IArchi/Maslow_4/CAD/Anchors/AnchorDesignsReadme.md

Add notes for the anchor cad files loaded in this file.
