IArchi/Maslow_4/docs/index.md

---
layout: default
title: Home
---

# Maslow 4 Documentation

Welcome to the official documentation for Maslow 4 CNC machine. This site contains assembly instructions, user guides, reference materials, and interactive tools.

## Quick Start

- [Quick Start Guide](QuickStart.md) - Get your Maslow up and running quickly after assembly

## Assembly Guides

Step-by-step instructions for building your Maslow 4:

- [Assembly Background](assembly-background-4-1/) - Overview of the assembly process
- [Assembling the Arms](assembling-the-arms-4-1/) - Build the arm assemblies
- [Assembling the Router](assembling-the-router-4-1/) - Set up the router mount
- [Assembling the Sled](assembling-the-sled-4-1/) - Build the sled platform
- [Putting It All Together](putting-it-all-together-4-1/) - Final assembly steps

## User Guide

- [User Guide](user-guide/) - Complete guide to using your Maslow 4

## Reference Materials

- [Maslow CNC Wisdom Manual](MaslowCNC_Wisdom_Manual.md) - Comprehensive manual with tips and best practices
- [Bit Library](BitLibrary.md) - Information about router bits and tooling
- [Frame Library](FrameLibrary.md) - Frame designs and specifications
- [Materials Library](MaterialsLibrary.md) - Material cutting recommendations
- [Router and Spindle Library](RouterAndSpindleLibrary.md) - Router and spindle options
- [Software Guide](software-guide/) - CAM and CAD software options for use with Maslow
- [Software Library](SoftwareLibrary.md) - Software tools and resources

## Interactive Tools

- [Calibration Simulator](calibration-simulation/) - Interactive calibration simulation tool
  - [Quick Start Guide](calibration-simulation/QUICKSTART.md)
  - [Full Documentation](calibration-simulation/README.md)
- [Calibration Data Parser](calibration-simulation/data-parser.html) - Analyze real calibration data with the machine's exact solver, and visualize which measurements are causing errors
  - [Data Parser Documentation](calibration-simulation/DATA-PARSER.md)
- [Manual Anchor Locator](manual-anchor-locator/) - Compute anchor coordinates and estimate measurement error from four side lengths and two diagonals
- [Layout Simulator](layout-simulator/) - Try an anchor spacing and see how much of the area inside it Maslow can cut well
  - [Layout Simulator Documentation](layout-simulator/README.md)

## Contributing

- [How To Edit This Wiki](HowToEditThisWiki.md) - Guide for contributing to the documentation

## External Resources

- [Maslow CNC Website](https://www.maslowcnc.com/) - Official website
- [GitHub Repository](https://github.com/MaslowCNC/Maslow_4) - Source code and issues
- [Community Forums](https://forums.maslowcnc.com/) - Get help and share projects
- [FluidNC Wiki](http://wiki.fluidnc.com/) - Firmware documentation

---

*This documentation is open source and contributions are welcome. See [How To Edit This Wiki](HowToEditThisWiki.md) for details.*
