IArchi/Maslow_4/docs/IMPLEMENTATION_SUMMARY.md

# GitHub Pages Implementation Summary

## What Was Implemented

This implementation creates a complete GitHub Pages website from the `docs/` folder that includes:

### 1. Automated Deployment Pipeline
- **GitHub Actions Workflow** (`.github/workflows/deploy-docs.yml`)
  - Automatically deploys on push to `Maslow-Main` branch
  - Can be manually triggered from Actions tab
  - Uses official GitHub Pages actions for reliability
  - Builds with Jekyll for beautiful rendering

### 2. Documentation Website
- **Landing Page** (`docs/index.md`)
  - Clean, organized navigation
  - Sections for assembly guides, user guide, reference materials
  - Links to interactive tools
  - External resource links

### 3. All Markdown Files Rendered
Every markdown file in the docs folder will be rendered as a web page:
- BitLibrary.md
- FrameLibrary.md
- MaterialsLibrary.md
- RouterAndSpindleLibrary.md
- SoftwareLibrary.md
- MaslowCNC_Wisdom_Manual.md
- HowToEditThisWiki.md
- All README.md files in subdirectories

### 4. Interactive Calibration Simulator
The existing calibration-simulation with its HTML/JS files will work perfectly:
- `docs/calibration-simulation/index.html` - Main simulator interface
- All JavaScript files (machine-simulator.js, computation-simulator.js, etc.)
- Enhanced documentation with prominent links to run the simulator

### 5. Images and Assets
All images remain in their original locations and will be accessible:
- Assembly guide images (assembling-the-arms-4-1/images/, etc.)
- User guide screenshots (user-guide/images/)
- All other image assets

## Site Structure

When deployed, the site will have this structure:

```
https://maslowcnc.github.io/Maslow_4/
├── (Landing page with organized navigation)
│
├── Assembly Guides
│   ├── assembly-background-4-1/
│   ├── assembling-the-arms-4-1/
│   ├── assembling-the-router-4-1/
│   ├── assembling-the-sled-4-1/
│   └── putting-it-all-together-4-1/
│
├── User Guide
│   └── user-guide/
│
├── Reference Materials
│   ├── BitLibrary.md
│   ├── FrameLibrary.md
│   ├── MaterialsLibrary.md
│   ├── RouterAndSpindleLibrary.md
│   ├── SoftwareLibrary.md
│   └── MaslowCNC_Wisdom_Manual.md
│
├── Interactive Tools
│   └── calibration-simulation/
│       ├── index.html (Interactive Simulator)
│       ├── README.md
│       └── QUICKSTART.md
│
└── Contributing
    └── HowToEditThisWiki.md
```

## Visual Design

The site uses the **Cayman theme**, which provides:
- Clean, professional appearance
- Responsive design (works on mobile, tablet, desktop)
- Easy-to-read typography
- GitHub-style markdown rendering
- Syntax highlighting for code blocks
- Automatic table of contents generation

## How It Works

### Automatic Deployment
1. Developer pushes changes to `Maslow-Main` branch
2. GitHub Actions detects changes in `docs/` folder
3. Workflow runs Jekyll build process
4. Site is automatically deployed to GitHub Pages
5. Changes appear live within 1-2 minutes

### Manual Deployment
1. Go to repository Actions tab
2. Select "Deploy Documentation to GitHub Pages"
3. Click "Run workflow"
4. Choose `Maslow-Main` branch
5. Site deploys in 1-2 minutes

## Configuration Files

### Jekyll Configuration (`docs/_config.yml`)
- Sets site title and description
- Configures Cayman theme
- Enables helpful plugins:
  - `jekyll-relative-links` - Makes relative links work correctly
  - `jekyll-optional-front-matter` - Markdown files don't need YAML front matter
  - `jekyll-readme-index` - README.md files become index pages
  - `jekyll-titles-from-headings` - Page titles extracted from # headings
  - `jekyll-github-metadata` - GitHub repo metadata available

### GitHub Actions Workflow
- Triggers on:
  - Push to `Maslow-Main` with changes in `docs/**`
  - Manual trigger from Actions tab
- Permissions:
  - Read repository contents
  - Write to GitHub Pages
  - Issue ID tokens for secure deployment
- Two jobs:
  1. **Build**: Checks out code, builds Jekyll site, uploads artifact
  2. **Deploy**: Deploys artifact to GitHub Pages environment

## Setup Required

The repository owner needs to:

1. **Enable GitHub Pages**
   - Go to repository Settings
   - Click "Pages" in sidebar
   - Under "Build and deployment"
   - Set Source to "GitHub Actions"
   - Click Save

2. **First Deployment**
   - Either push a change to `docs/` on `Maslow-Main`
   - Or manually trigger workflow from Actions tab

3. **Access the Site**
   - Site will be live at: https://maslowcnc.github.io/Maslow_4/
   - Usually takes 1-2 minutes for first deployment

## Benefits

1. **Professional Documentation**: Clean, organized, easy to navigate
2. **No Maintenance**: Automatic deployment on every change
3. **Interactive Content**: Simulator works directly in browser
4. **Mobile-Friendly**: Responsive design works on all devices
5. **Search Friendly**: Proper SEO with metadata
6. **Version Control**: Documentation versioned with code
7. **Free Hosting**: GitHub Pages is free for public repositories

## Future Enhancements

Possible future improvements:
- Search functionality (can add with Algolia or lunr.js)
- Multi-version documentation (branches for different versions)
- Dark mode toggle
- Custom domain (e.g., docs.maslowcnc.com)
- Download PDF options
- Changelog/release notes page
- Video tutorials embedded
- Interactive troubleshooting guides

## Support

For help with the documentation site:
- Setup Guide: See `docs/GITHUB_PAGES_SETUP.md`
- GitHub Issues: https://github.com/MaslowCNC/Maslow_4/issues
- Forums: https://forums.maslowcnc.com/
