IArchi/Maslow_4/CAD/Frames/FramesReadme.md

Write notes about frame designs in this file here.
