IArchi/Maslow_4/CAD/Maslow3DPrintVariations/Maslow3DPrintVariationsReadme.md

Write notes about the 3D printable maslow variation parts here.
