IArchi/Maslow_4/docs/MaterialsLibrary.md

# Materials Library

Maslow was designed to cut 4x8 ft Sheets of flat material and up to 2 to 3 inches or 60mm deep.  It's flexible design means that we can cut a lot more stuff in interesting ways. This is a library to record tips and cutting setings for both standard materials and non standard materials. Please add tips or materials from your experience. 

# Material LIBRARY 
## To add a Material start a new entry with a title started by three ### hash symbols then add pictures, materials and description and links.  Still working on what is a useful format here, use your judgment. If we use the heading system built into markdown it will automatically create a table of contents in the top right corner of the reading pane. 

For each material add your experience with it. Cutting, engraving, .. What settings and speeds worked and what didn't

### Example Material entry heading text

PICTURE
- Material
- Links:
- Cuting bits include feed rates and plunge rates and anything else useful. 
- Add to the list if you have cut with different bits or settings. 
- Details:
- Notes:
- More Pictures:
- Credits:

## PLYWOODS

## ORIENTED STRAND BOARDS

## PARTICLE BOARDS

## PLASTICS

## REAL WOOD

## FOAMS AND INSULATION

## OTHER STUFF
