IArchi/Maslow_4/CAD/Maslow3DPrintVariations/RandomDave/Clamps/TurtleClamps/Variants/TurtleClamp1_1-Base-HexReinforcedClamp.stl

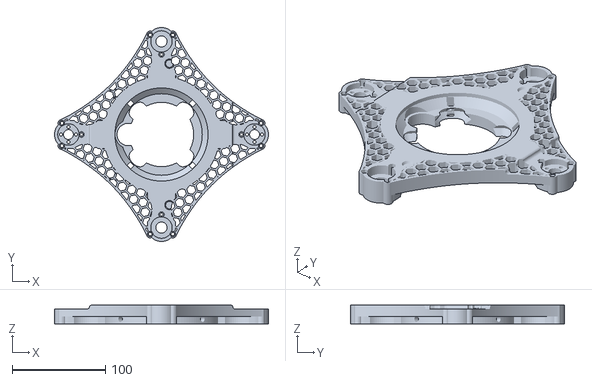
[picture p39: CAD file, 2026-01-29]
CAD/Maslow3DPrintVariations/RandomDave/Clamps/TurtleClamps/Variants/TurtleClamp1_1-Base-HexReinforcedClamp.stl
230.0 x 230.0 x 20.0
