IArchi/Maslow_4/CAD/Maslow3DPrintVariations/RandomDave/MaslowVariants/MonolithMaslowBuild/MonolithMaslow-2040CrossbraceBracket-1_0.stl

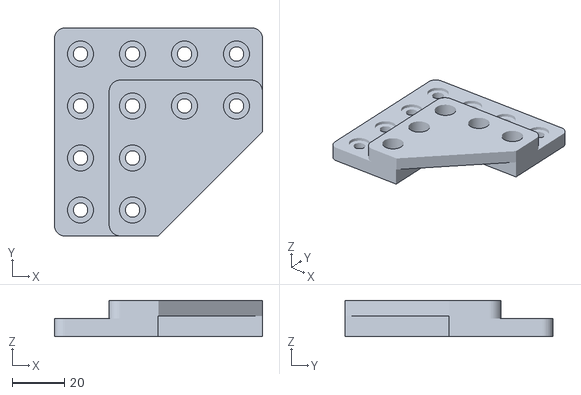
[picture p40: CAD file, 2026-02-16]
CAD/Maslow3DPrintVariations/RandomDave/MaslowVariants/MonolithMaslowBuild/MonolithMaslow-2040CrossbraceBracket-1_0.stl
80.0 x 80.0 x 14.0
