IArchi/Maslow_4/CAD/Maslow3DPrintVariations/RandomDave/MaslowVariants/MonolithMaslowBuild/MonolithMaslow-TowerBracket-Right-1_0.stl

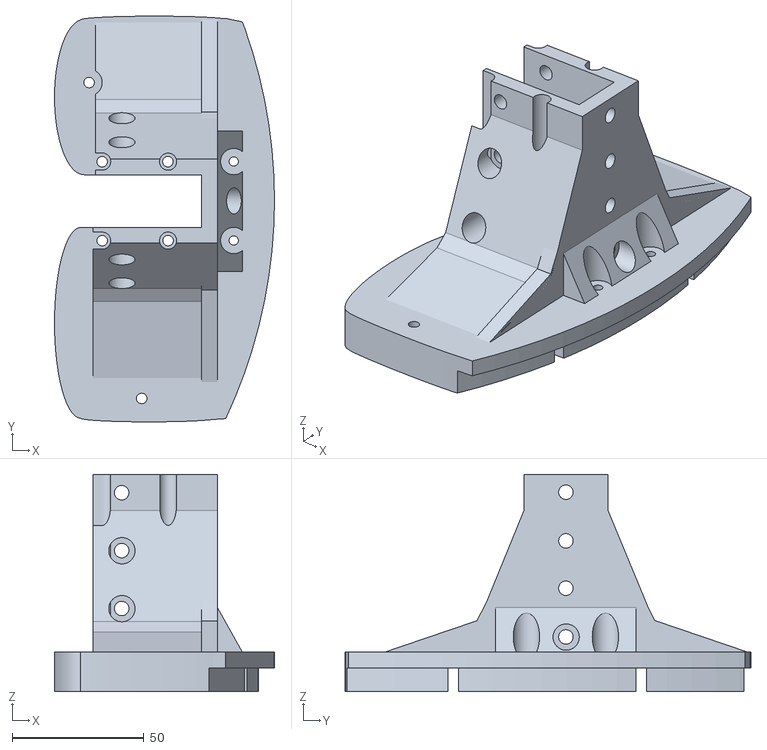
[picture p42: CAD file, 2026-02-16]
CAD/Maslow3DPrintVariations/RandomDave/MaslowVariants/MonolithMaslowBuild/MonolithMaslow-TowerBracket-Right-1_0.stl
83.6 x 154.2 x 82.5
