IArchi/Maslow_4/CAD/Maslow3DPrintVariations/RandomDave/MaslowVariants/MonolithMaslowBuild/MonolithMaslow-RodHolder-ProfileClamp-1_0.stl

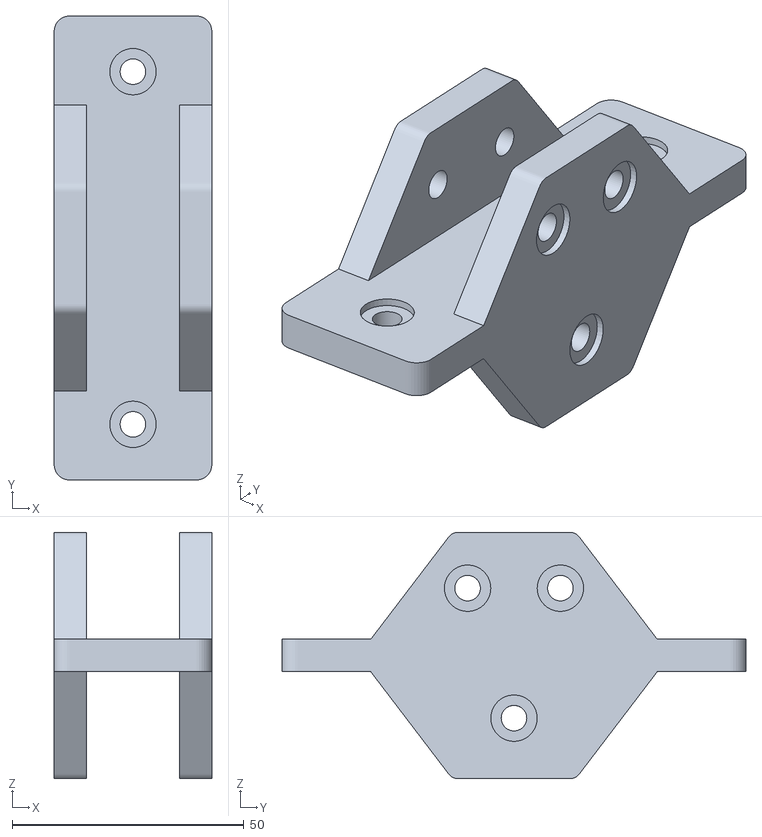
[picture p44: CAD file, 2026-02-16]
CAD/Maslow3DPrintVariations/RandomDave/MaslowVariants/MonolithMaslowBuild/MonolithMaslow-RodHolder-ProfileClamp-1_0.stl
34.0 x 100.0 x 53.0
