IArchi/Maslow_4/CAD/Maslow3DPrintVariations/RandomDave/MaslowVariants/MonolithMaslowBuild/MonolithMaslow-RodHolder-RodClamp10.10mm-1_0.stl

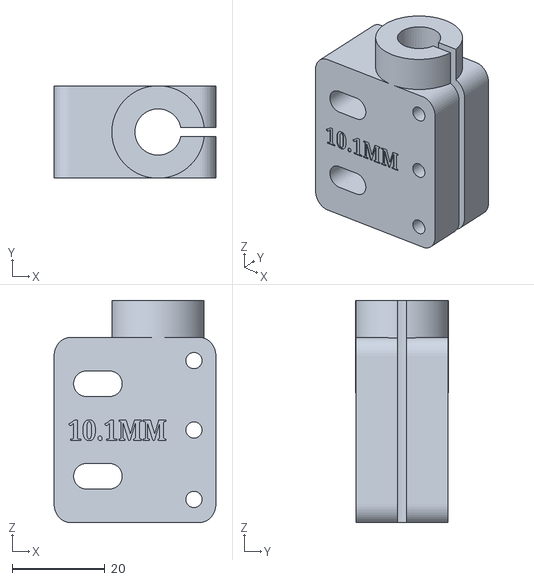
[picture p46: CAD file, 2026-02-16]
CAD/Maslow3DPrintVariations/RandomDave/MaslowVariants/MonolithMaslowBuild/MonolithMaslow-RodHolder-RodClamp10.10mm-1_0.stl
35.0 x 20.0 x 48.0
