IArchi/Maslow_4/CAD/Maslow3DPrintVariations/RandomDave/MaslowVariants/MonolithMaslowBuild/TurtleClamp1_1-ClampInserts.stl

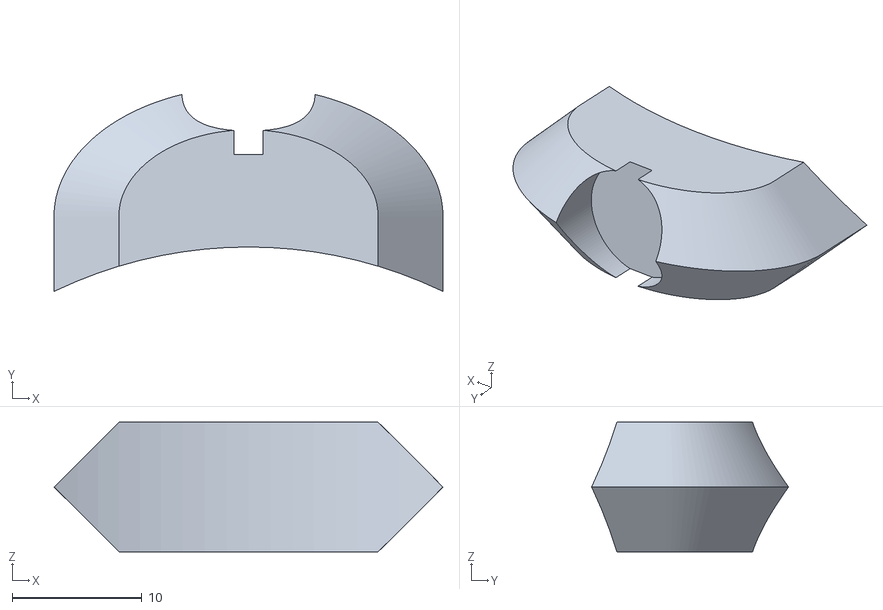
[picture p47: CAD file, 2026-01-12]
CAD/Maslow3DPrintVariations/RandomDave/MaslowVariants/MonolithMaslowBuild/TurtleClamp1_1-ClampInserts.stl
30.0 x 15.2 x 10.0
