IArchi/Maslow_4/(list of files, cad)

Other CAD files:
CAD/Maslow3DPrintVariations/RandomDave/MaslowVariants/MonolithMaslowBuild/MonolithMaslow-TowerBracket-Left-1_0.stl
CAD/Maslow3DPrintVariations/RandomDave/MaslowVariants/MonolithMaslowBuild/MonolithMaslow-RodHolder-RodClamp10.50mm-1_0.stl
CAD/Maslow3DPrintVariations/RandomDave/MaslowVariants/MonolithMaslowBuild/MonolithMaslow-RodHolder-RodClamp10.25mm-1_0.stl
CAD/Maslow3DPrintVariations/RandomDave/MaslowVariants/MonolithMaslowBuild/TurtleClamp1_1-StandardClamp.stl
