IArchi/Maslow_4/docs/assembling-the-arms-4-1/README.md

# Assembling The Arms

A video walkthrough of this process is available here: [Maslow 4.1 Arms Assembly Video](https://www.youtube.com/watch?v=9soKe6nXHms)

Maslow4 has a few parts that need to be glued so we will start there so that the glue can begin drying. In all of the cases where we use glue, the glue is not structural, it is just meant to hold parts in place that might move due to vibration. Use just a small amount of glue.

Assembling the arms is the most complex and difficult part of the Maslow4 build process so we're going to jump right in and start there.

Find any of these steps confusing or get stuck? Don't forget, you aren't alone! Maslow is a community driven open source project. Ask in the [forums](https://forums.maslowcnc.com/) and we'll figure it out together!

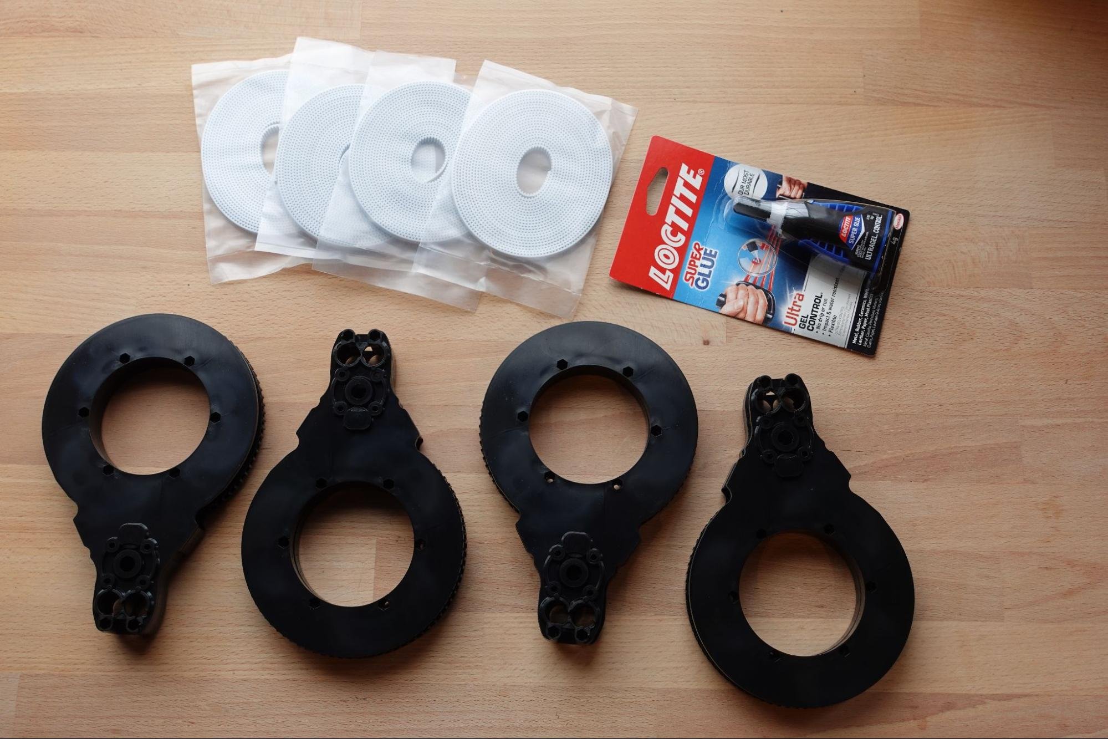
[picture p48: docs/assembling-the-arms-4-1/images/arms-01.jpg]
Gathering the belts, arms, and super glue


First we will gather the four belts, the four arms, and the super glue which we will need for this step. The top and bottom halves of the arms are identical.

> **Note:** Due to issues shipping glue (a liquid) by air we have started gluing the glued parts at the factory. If your kit has these parts already glued you can skip ahead.

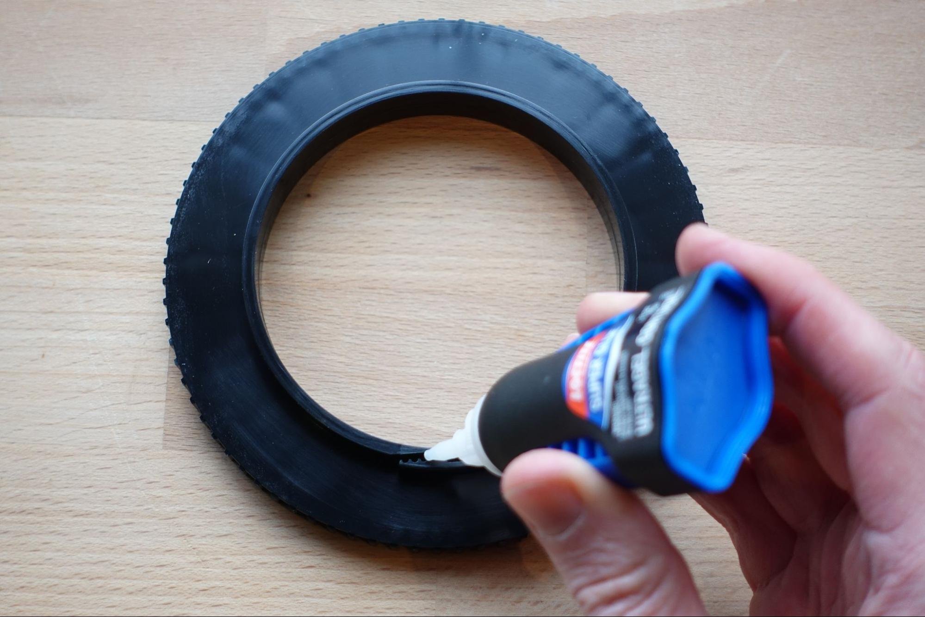
[picture p49: docs/assembling-the-arms-4-1/images/arms-02.jpg]
Placing a drop of super glue in the spool slot


Removing the spool from each arm, place a small drop of super glue in the slot where the belt will attach like this. A couple notes on this section. The super glue is opened by twisting the top. One end of each belt might fit into the spool more easily than the other so it's worth checking both ends before starting with the glue.

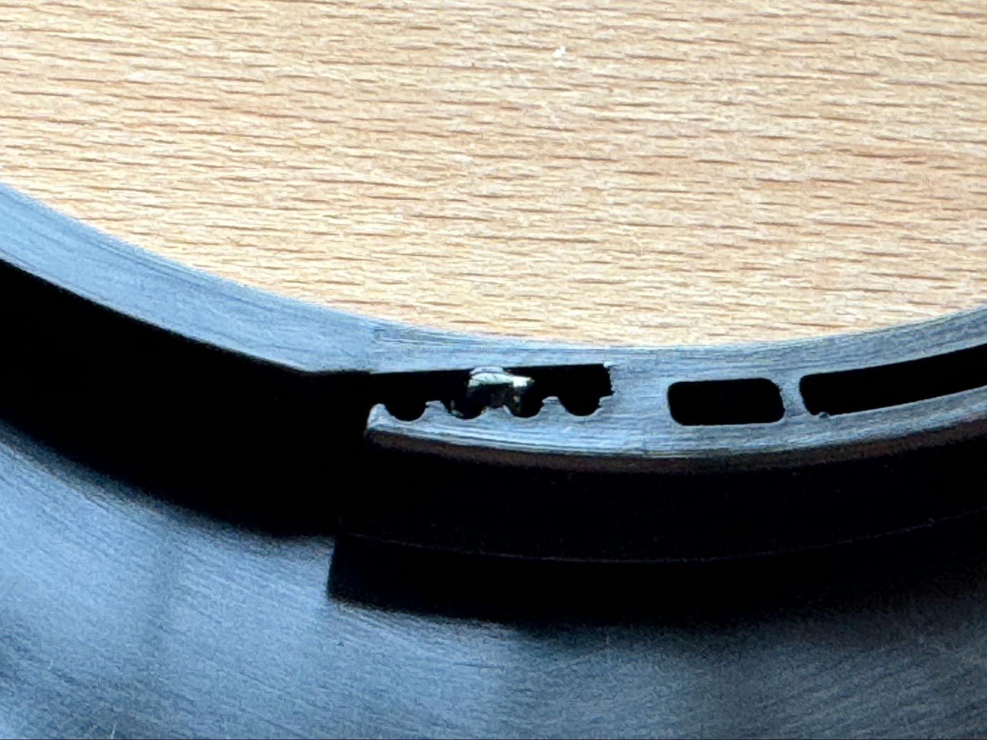
[picture p50: docs/assembling-the-arms-4-1/images/arms-03.jpg]
A small drop of glue is enough


You do not need to use much glue. A very small drop is fine.

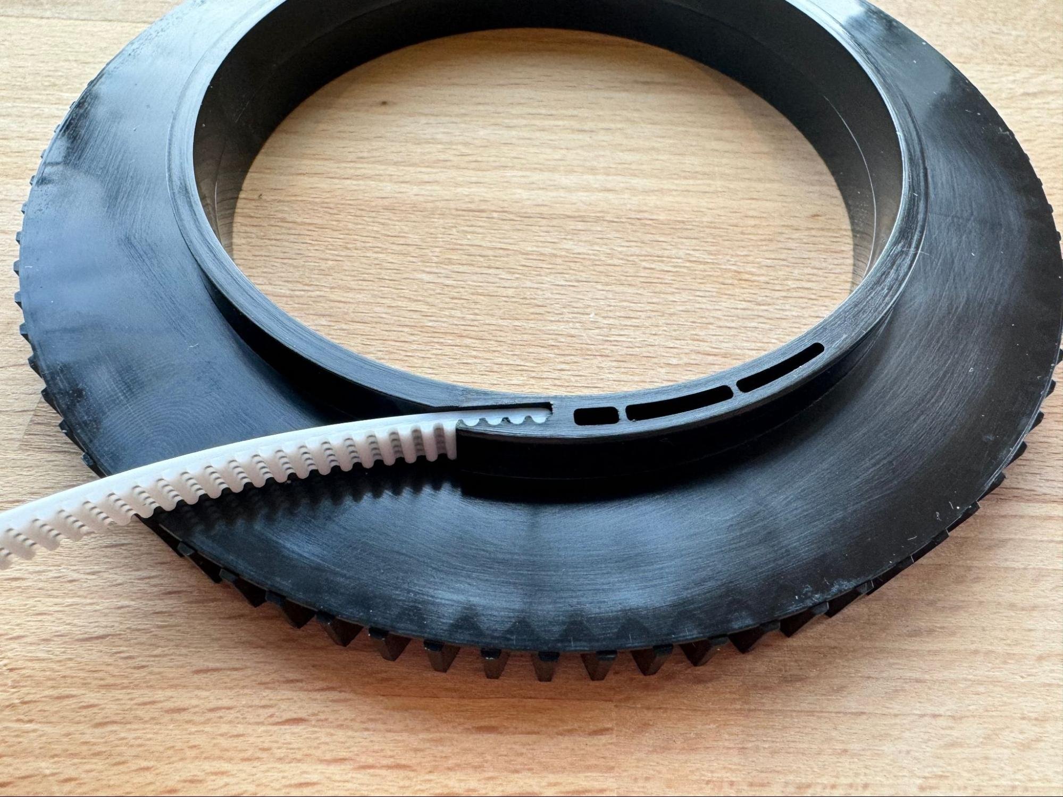
[picture p51: docs/assembling-the-arms-4-1/images/arms-04.jpg]
Pressing the belt fully into the slot


Then press the belt fully into the slot. It should not stick above the top of the slot.

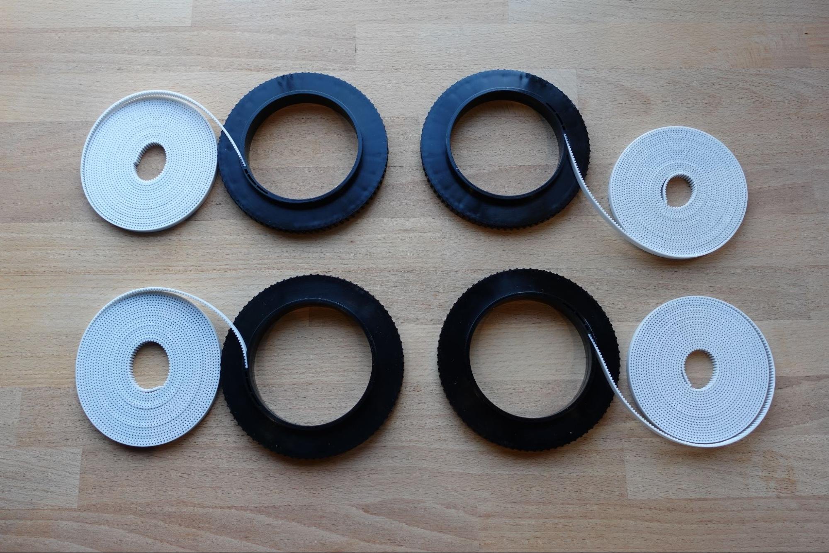
[picture p52: docs/assembling-the-arms-4-1/images/arms-05.jpg]
Repeat for all four spools


Repeat this step for all four spools.

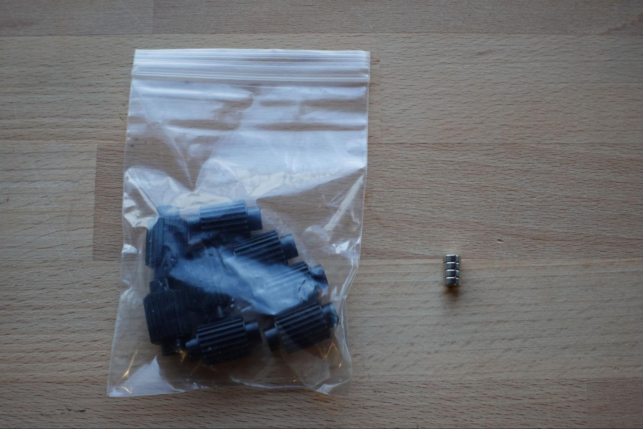
[picture p53: docs/assembling-the-arms-4-1/images/arms-06.jpg]
Gathering the rollers and magnets


Next we will glue the encoder magnets into the rollers. For this step we will need to gather the eight rollers and the four magnets. The four magnets will be stuck to the gears or to the Torx screwdriver.

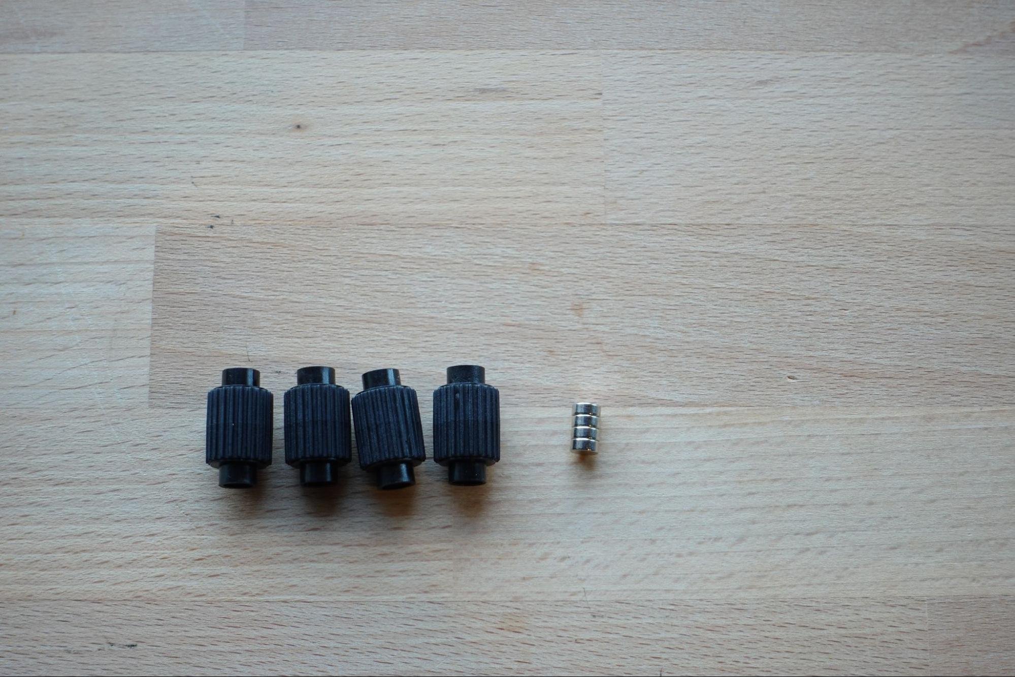
[picture p54: docs/assembling-the-arms-4-1/images/arms-07.jpg]
We only need four rollers for this step


We will just need four of them for this step:

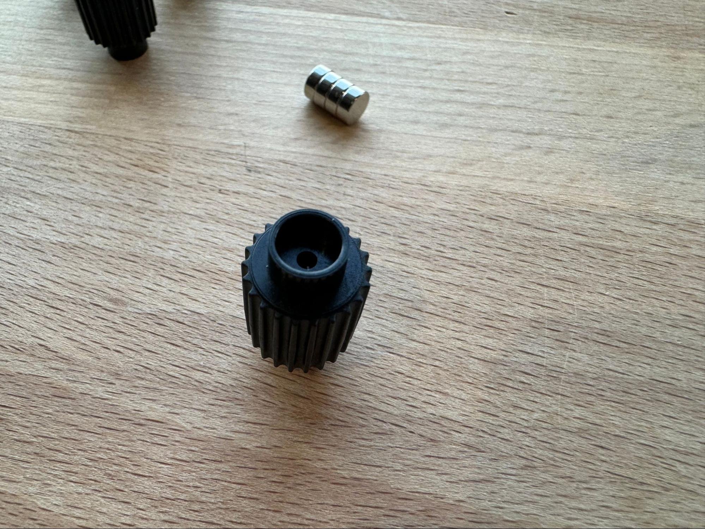
[picture p55: docs/assembling-the-arms-4-1/images/arms-08.jpg]
The roller end with the shallow recess


Note that each roller has two ends. One end has a shallow recess to hold the magnet. That is the side we want to use.

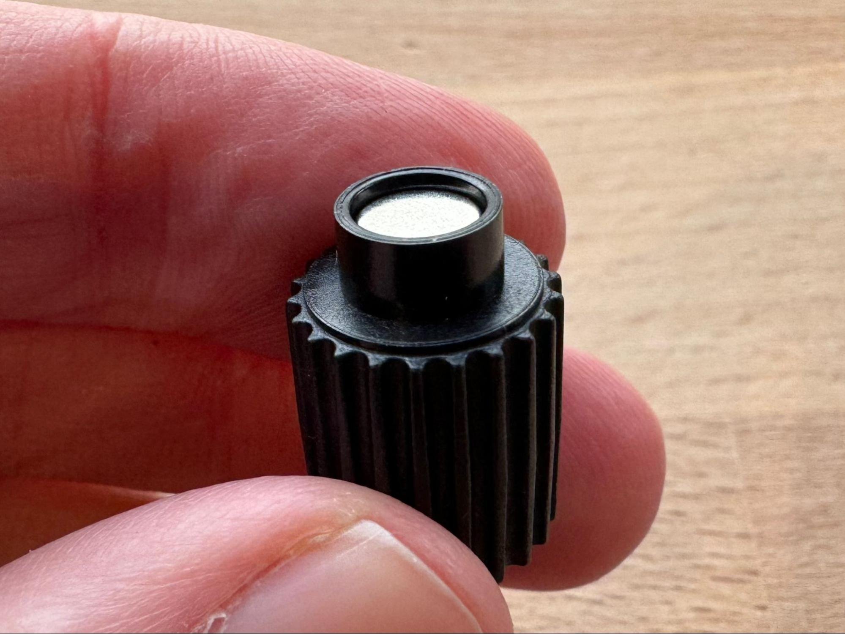
[picture p56: docs/assembling-the-arms-4-1/images/arms-09.jpg]
Gluing a magnet into each roller


Again using a drop of glue place a magnet in the end of each of the four rollers. Note that the magnet will be slightly recessed below the top of the roller.

Be careful, the magnets will try to stick to things while the glue is drying.

The magnet is symmetrical so it can be placed in either orientation.

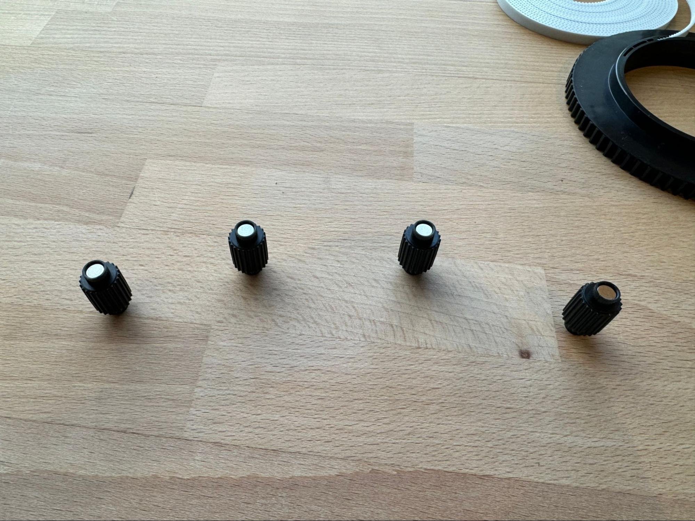
[picture p57: docs/assembling-the-arms-4-1/images/arms-10.jpg]
Setting the rollers aside to dry


Now set those aside to dry. Be careful not to put them too close together while drying because the magnets will attract and stick together. You have to place them further apart than you might expect.

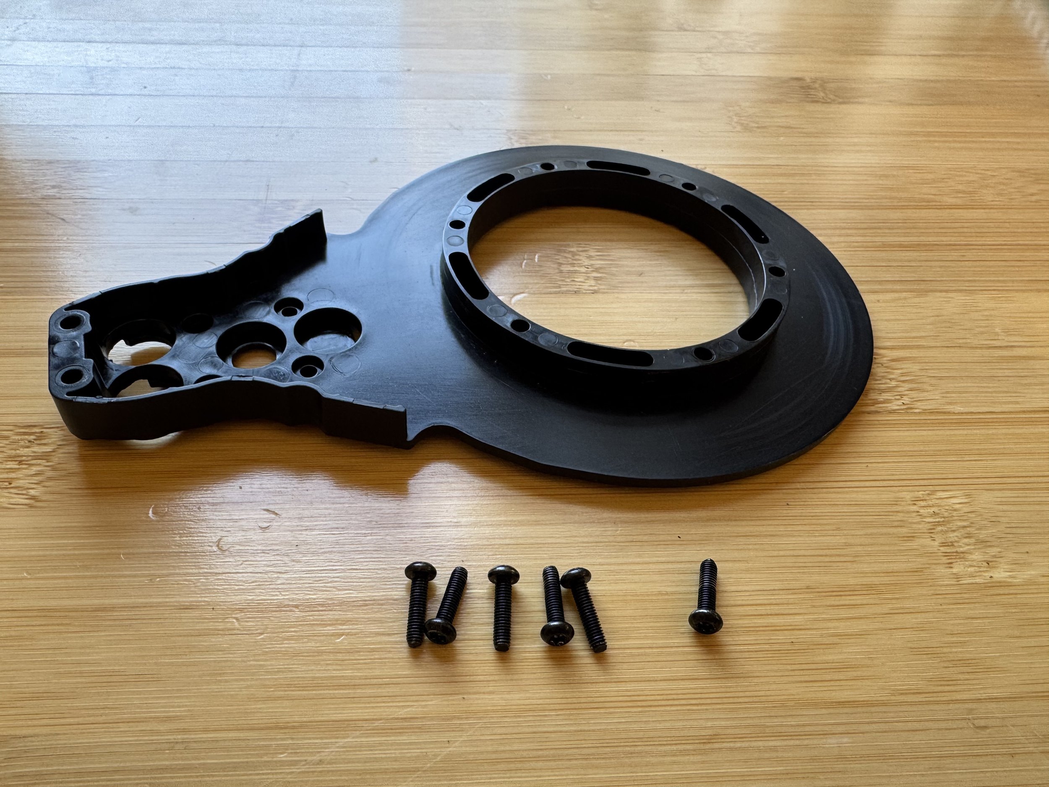
[picture p58: docs/assembling-the-arms-4-1/images/arms-11.jpg]
Installing six bolts into one arm half


Next, we want to install six bolts into one arm half. Be sure to use the bolts without the blue thread locker applied for this step.

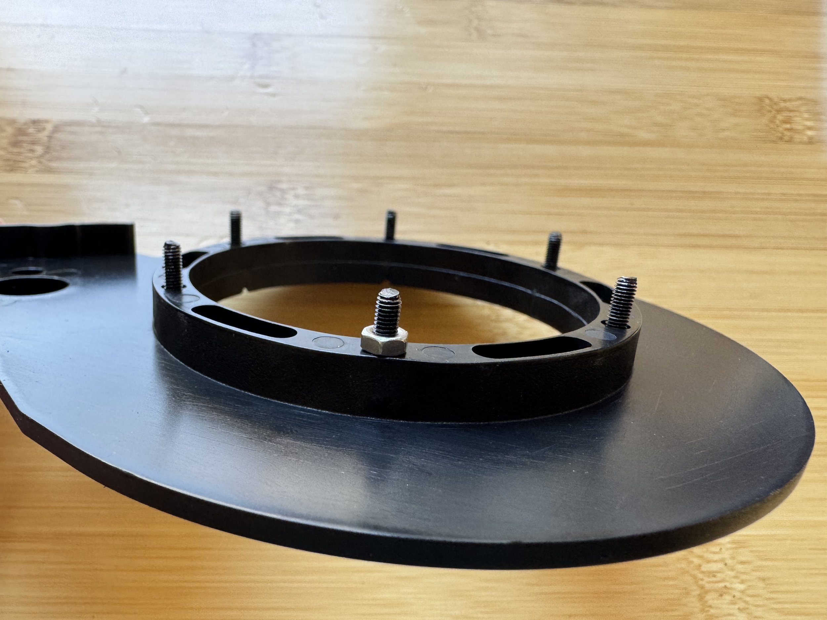
[picture p59: docs/assembling-the-arms-4-1/images/arms-12.jpg]
Using a non-lock nut to pull the bolts into place


The bolts will fit into the arm half like this. Use a non-lock nut to help pull them into place.

Remove the nut once each bolt is in place.

A small socket or nut driver can help here to prevent the nut from spinning.

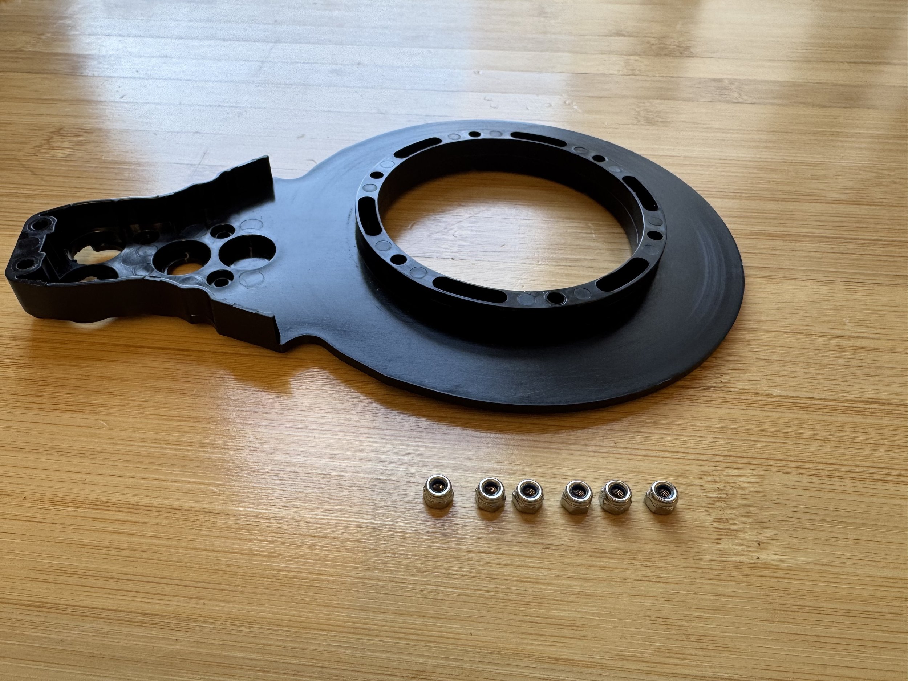
[picture p60: docs/assembling-the-arms-4-1/images/arms-13.jpg]
Installing six locking nuts in a new arm half


Next, install six locking nuts in a new arm half.

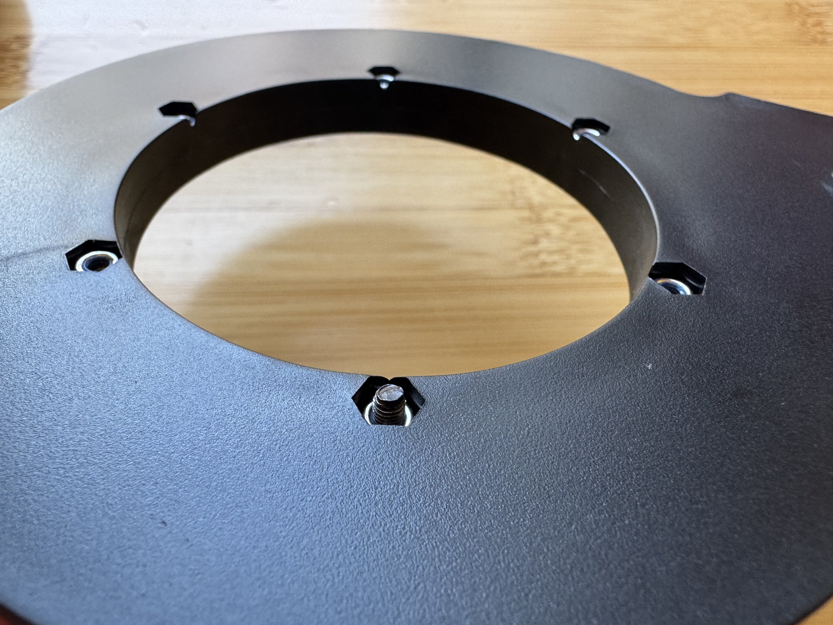
[picture p61: docs/assembling-the-arms-4-1/images/arms-14.jpg]
Pulling the nuts into place with a bolt


The process to install the nuts is the reverse of the bolts. Place a nut in each opening and then use a bolt from the other side to pull the nut into place.

Remove the bolt once each nut is in place.

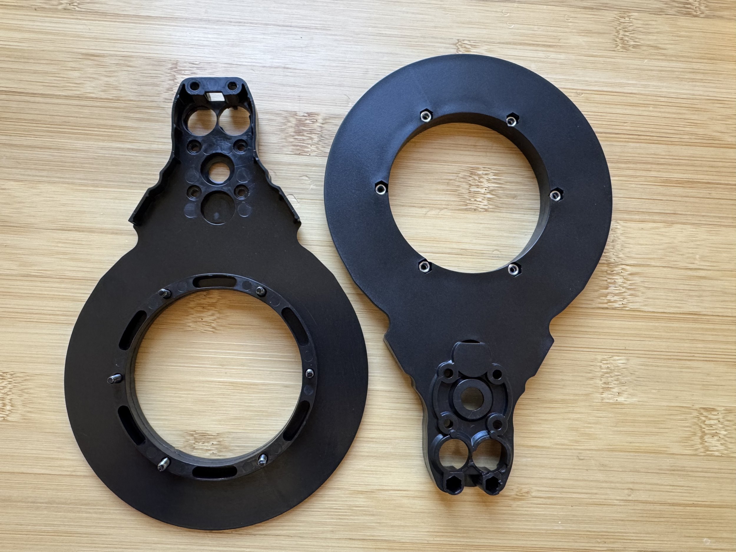
[picture p62: docs/assembling-the-arms-4-1/images/arms-15.jpg]
One half has only nuts, the other only bolts


When we are done with both halves one half should have only nuts and the other half should have only bolts.

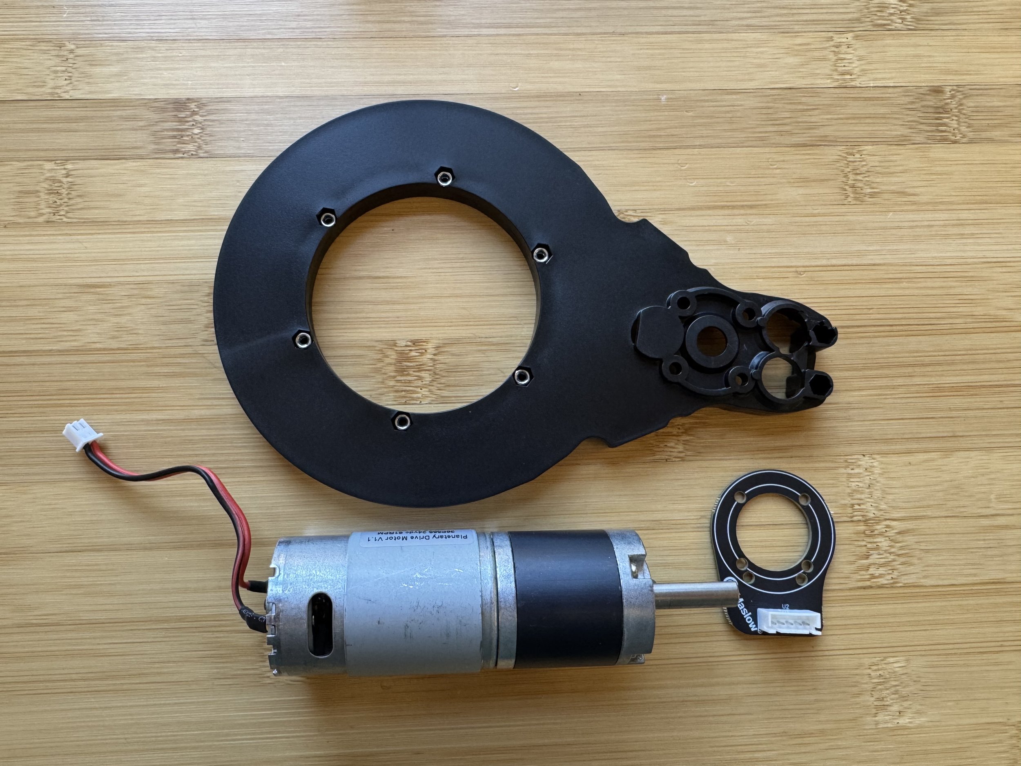
[picture p63: docs/assembling-the-arms-4-1/images/arms-16.jpg]
Collecting an arm half, motor, and encoder board


Next, we can start working on assembling the rest of the arm. To do that we're going to need to collect an arm half, a DC drive motor, and an encoder board.

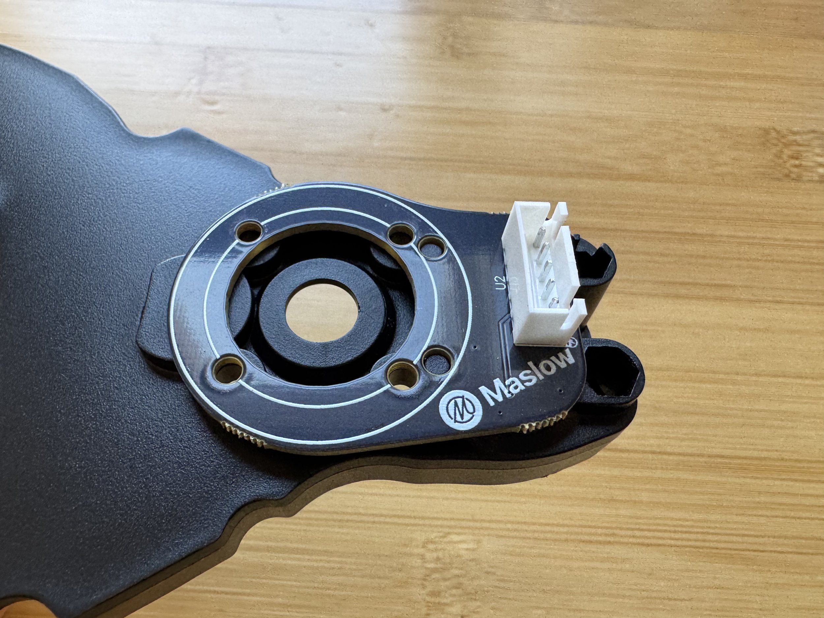
[picture p64: docs/assembling-the-arms-4-1/images/arms-17.jpg]
Placing the encoder board over the guide pegs


Next place the encoder board over them. There are two guide pegs which will hold it in just the right place.

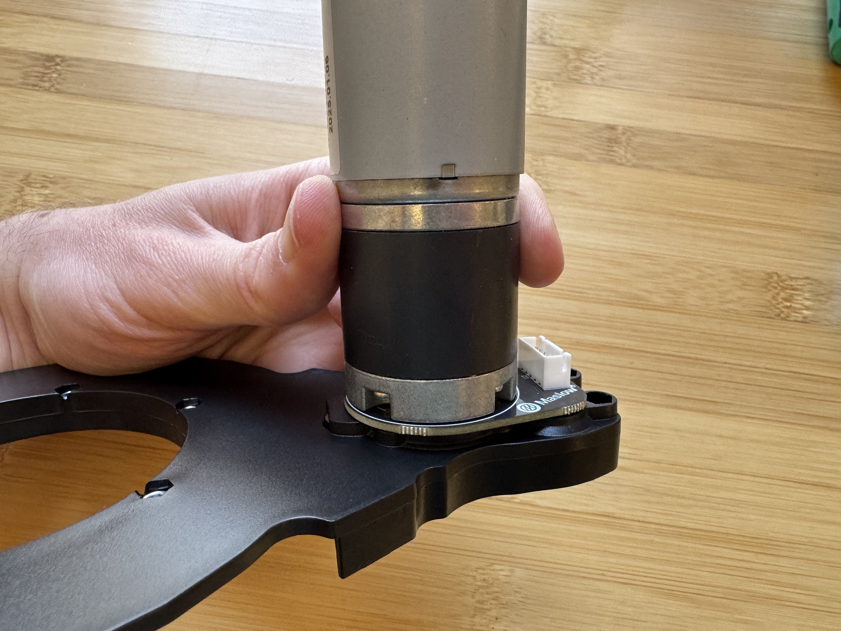
[picture p65: docs/assembling-the-arms-4-1/images/arms-18.jpg]
Placing the motor over the encoder board


Then place the motor over that. The orientation of the motor does not matter.

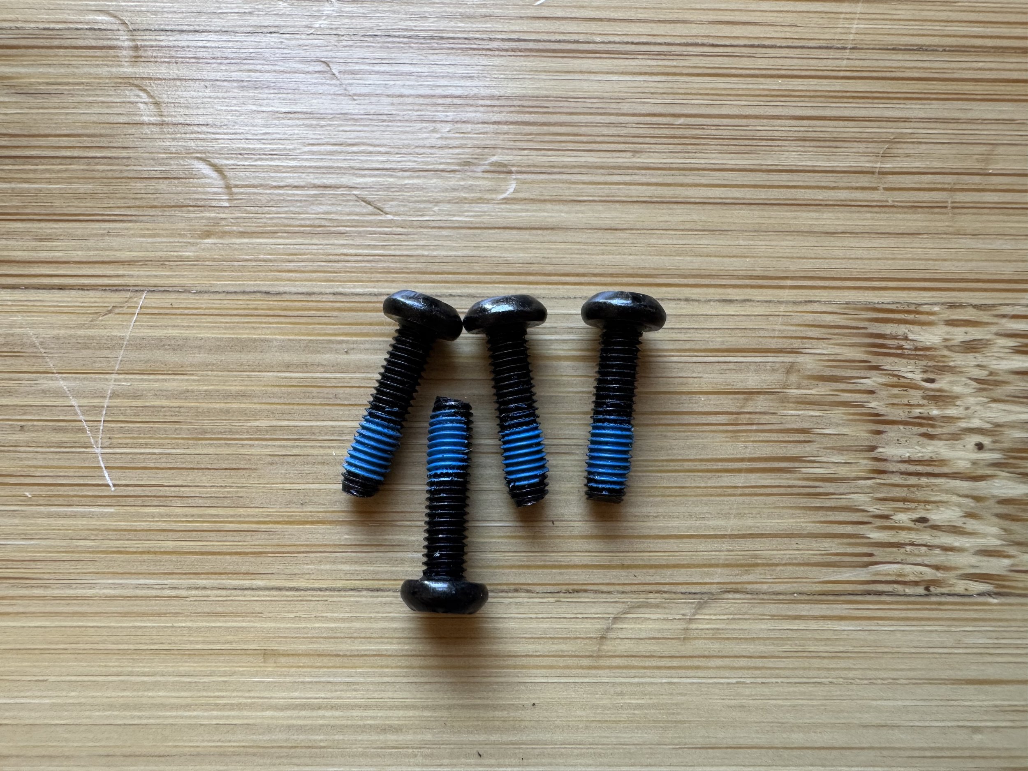
[picture p66: docs/assembling-the-arms-4-1/images/arms-19.jpg]
Bolts with blue thread locker for the motor


The bolts which connect the motor to the arm can wiggle themselves loose over time so we've included bolts with blue removable thread locker applied to them in your kit.

Collect four of these bolts.

The bolts with blue thread locker will only be used to attach the motors.

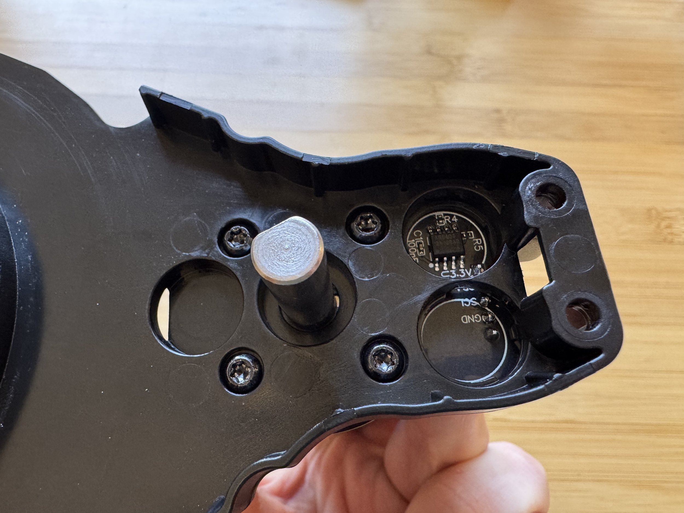
[picture p67: docs/assembling-the-arms-4-1/images/arms-20.jpg]
Bolting the drive motor into place


And then bolt the drive motor into place.

> **Community Note:** There is some play in how these bolts attach the motor and having the motor further forward (to the right in the picture) is better than further back. If you find that the gears are too tight in later steps you can loosen them up by moving the motor forwards.

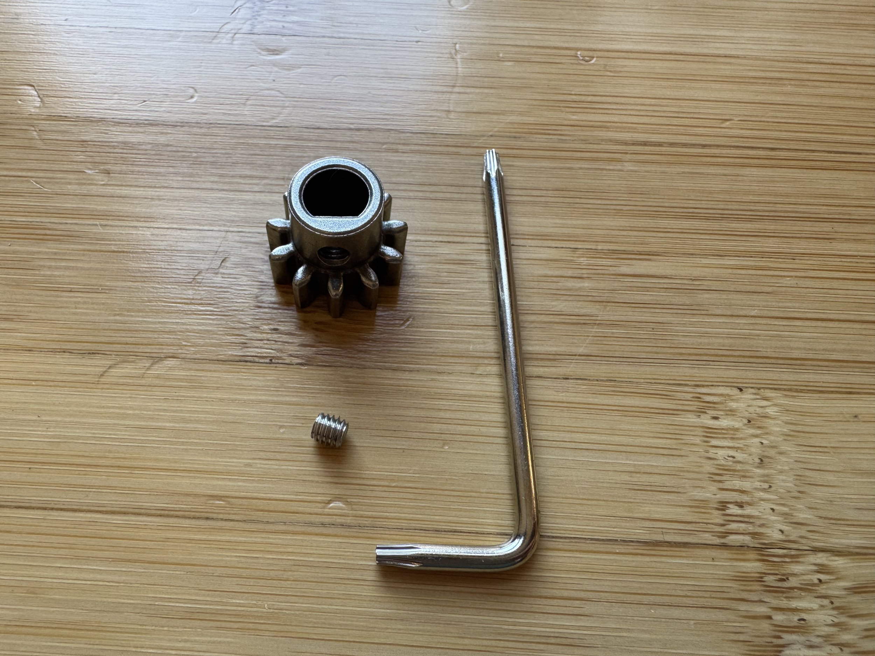
[picture p68: docs/assembling-the-arms-4-1/images/arms-21.jpg]
Collecting the drive gear, set screw, and T8 torx wrench


Next we need to collect our drive gear (which has a D shaped opening in the center), a set screw, and the T8 torx wrench:

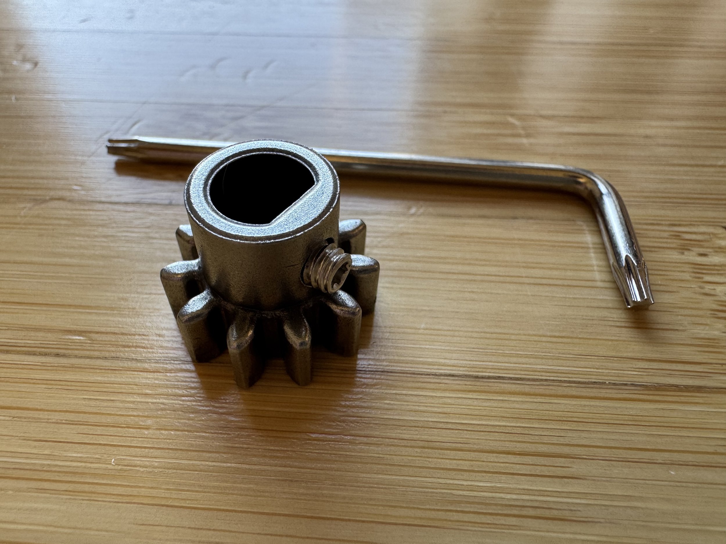
[picture p69: docs/assembling-the-arms-4-1/images/arms-22.jpg]
Threading the set screw into the drive gear


Thread the set screw part way into the drive gear:

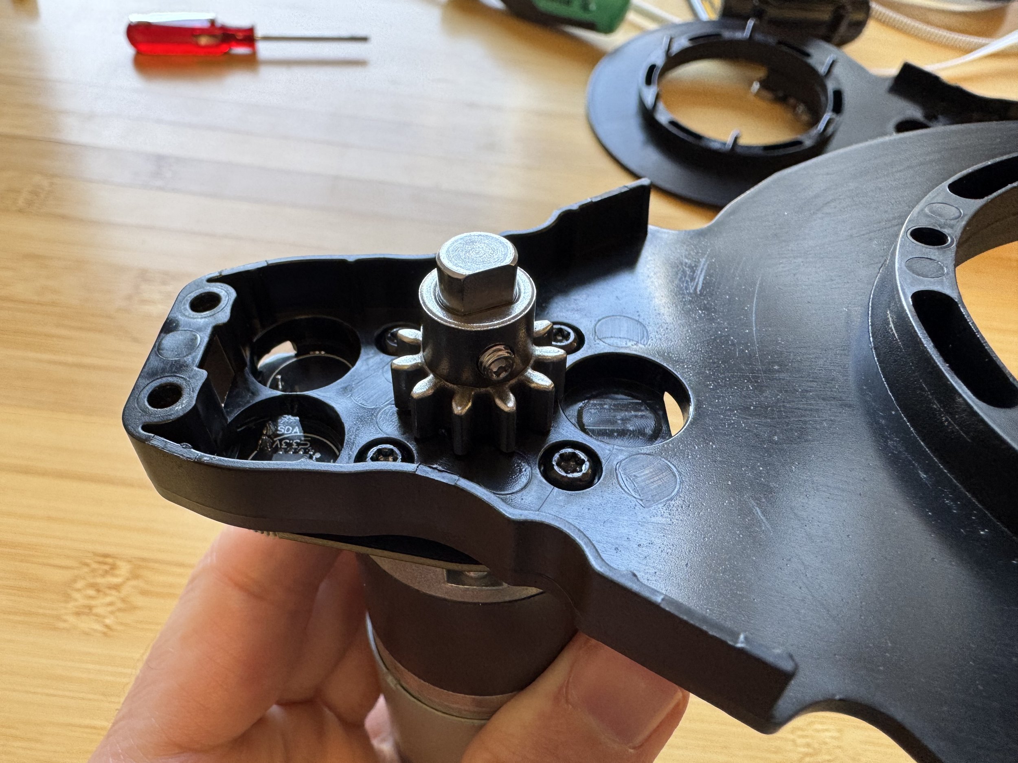
[picture p70: docs/assembling-the-arms-4-1/images/arms-23.jpg]
Attaching the drive gear to the motor shaft


Then attach it to the motor shaft. The gear should be almost but not quite touching the plastic or lifted up about the width of an index card or three pieces of paper. Tighten the set screw to lock it in place.

Note that there is no bearing under the drive gear.

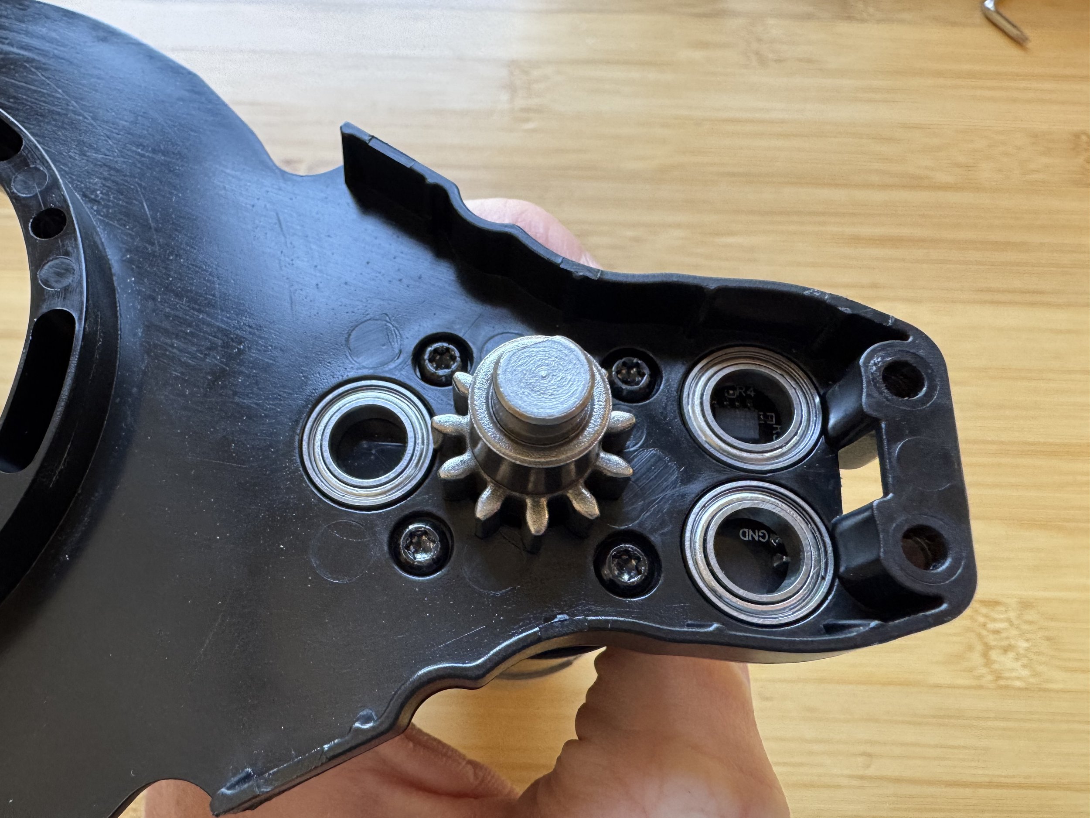
[picture p71: docs/assembling-the-arms-4-1/images/arms-24.jpg]
Pressing three bearings into the arm plastic


Next press three bearings into the three openings in the arm plastic as shown here.

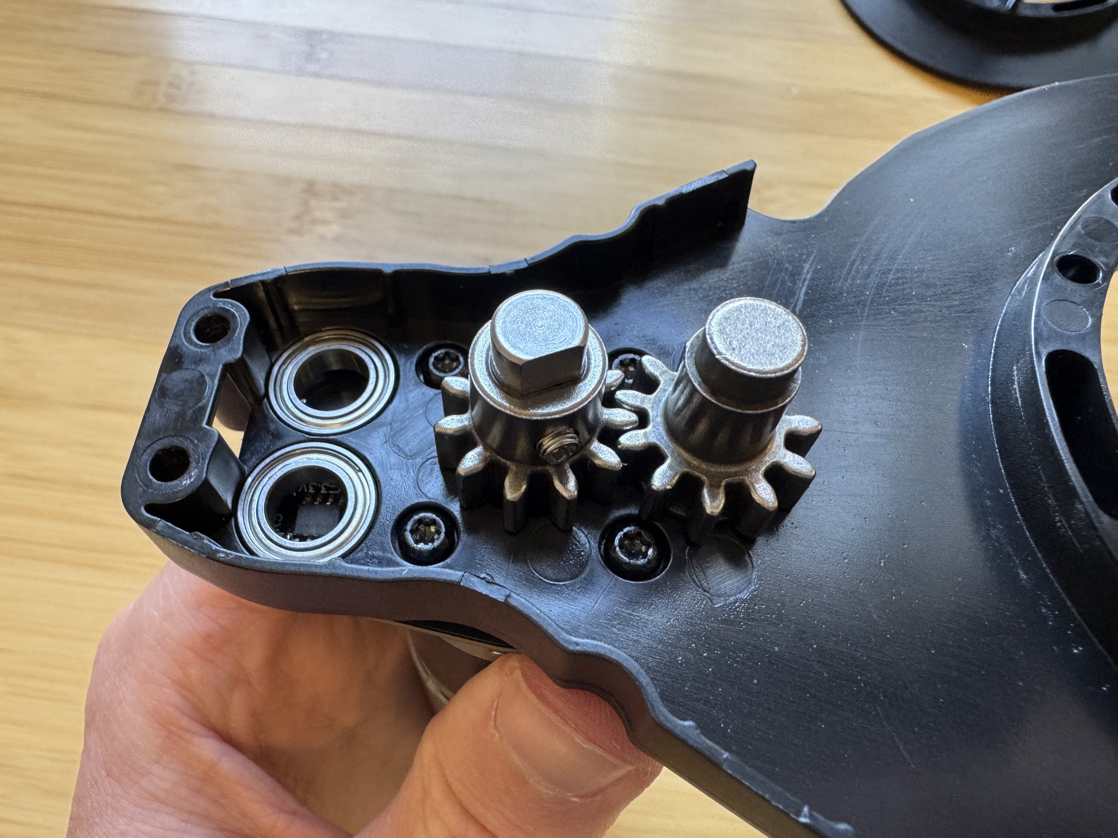
[picture p72: docs/assembling-the-arms-4-1/images/arms-25.jpg]
Inserting the idler gear


Insert the idler gear (the gear with the shaft built in) into the bearing next to the drive gear.

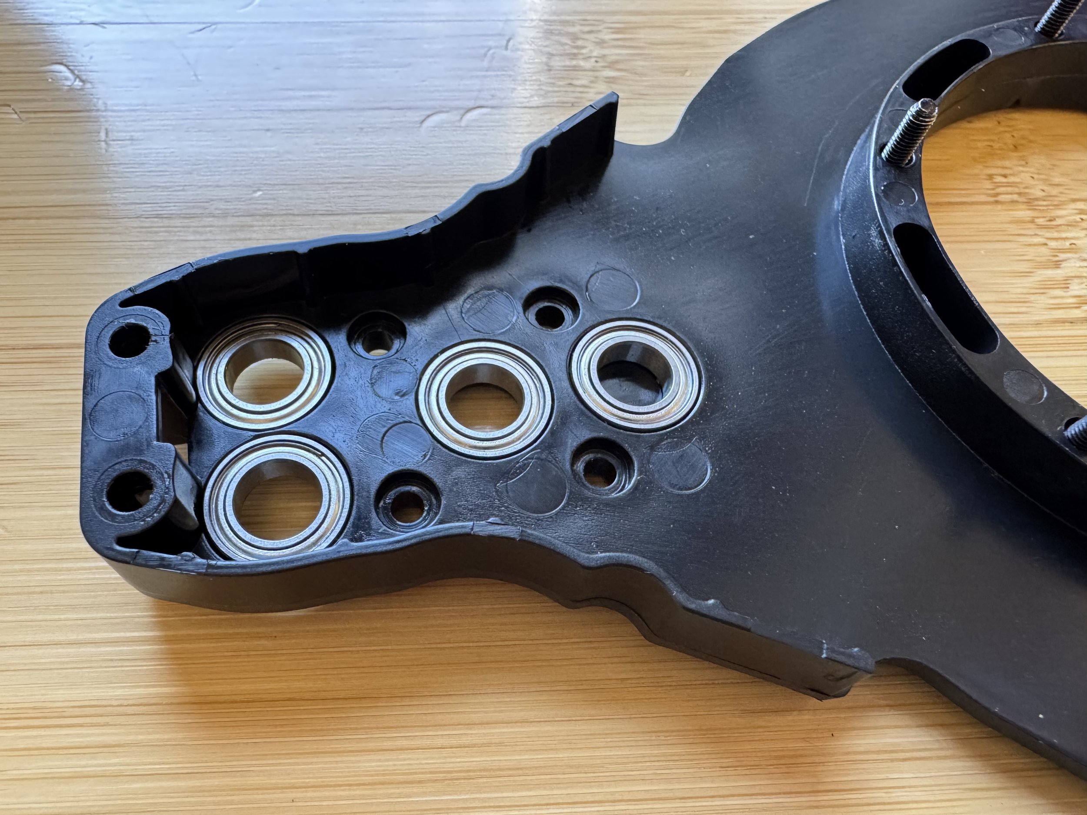
[picture p73: docs/assembling-the-arms-4-1/images/arms-26.jpg]
Pressing four bearings into the other half


Next set the half of the arm with the gears aside and we will work on the other half. First we will need to press four bearings into place like this.

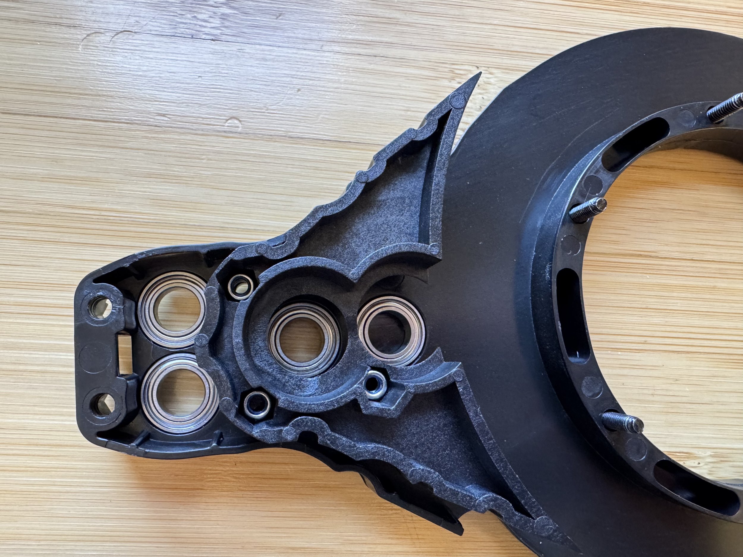
[picture p74: docs/assembling-the-arms-4-1/images/arms-27.jpg]
Inserting three nuts into the belt guard


Next we will attach the belt guard. Insert three nuts into the holes in the top of the belt guard with the open end of the nuts down.

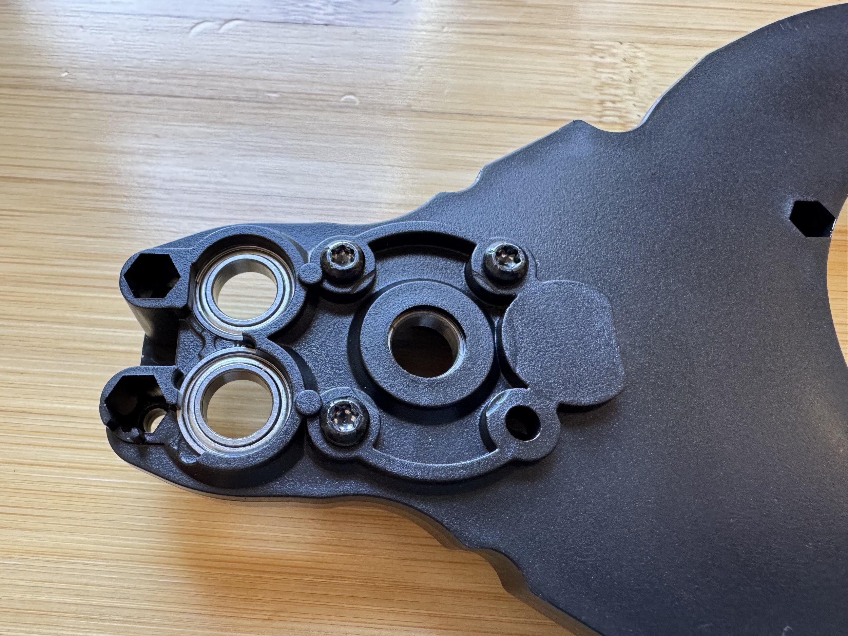
[picture p75: docs/assembling-the-arms-4-1/images/arms-28.jpg]
Adding three bolts to hold the belt guard


Then add three bolts from the other side to hold it in place. Note that the bolts are too short to fully engage the locknuts here.

If you have issues with your belt guard rubbing against your drive gear, loosening these three bolts slightly will allow you to adjust its position.

Next we need to wait for the glue to finish drying on our other parts before we can proceed. Feel free to repeat the steps up to this point for all four arms. If you feel like continuing to work on other parts of the machine while the glue is drying you can start on the Assembling the Sled section.

This next part where everything comes together sort of happens all at once and can be a little tricky. Don't feel frustrated if it takes a couple of tries to get it right. With practice it can be pretty smooth, but the only way to get the hang of it is to try.

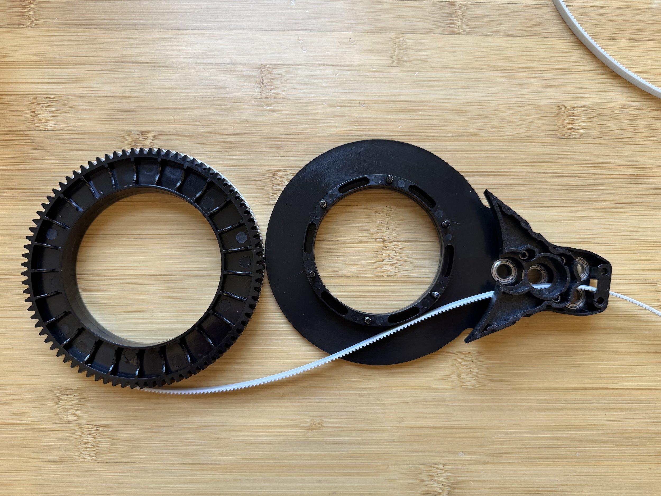
[picture p76: docs/assembling-the-arms-4-1/images/arms-29.jpg]
Feeding the belt through the belt guard


Feed the free end of the belt from the spool (belt side down, gear side up) through the belt guard.

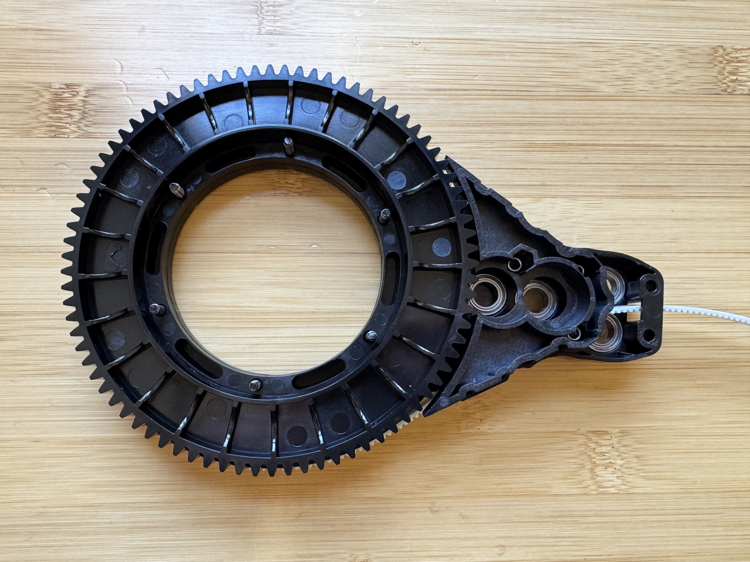
[picture p77: docs/assembling-the-arms-4-1/images/arms-30.jpg]
Placing the spool onto the arm


Place the spool onto the arm.

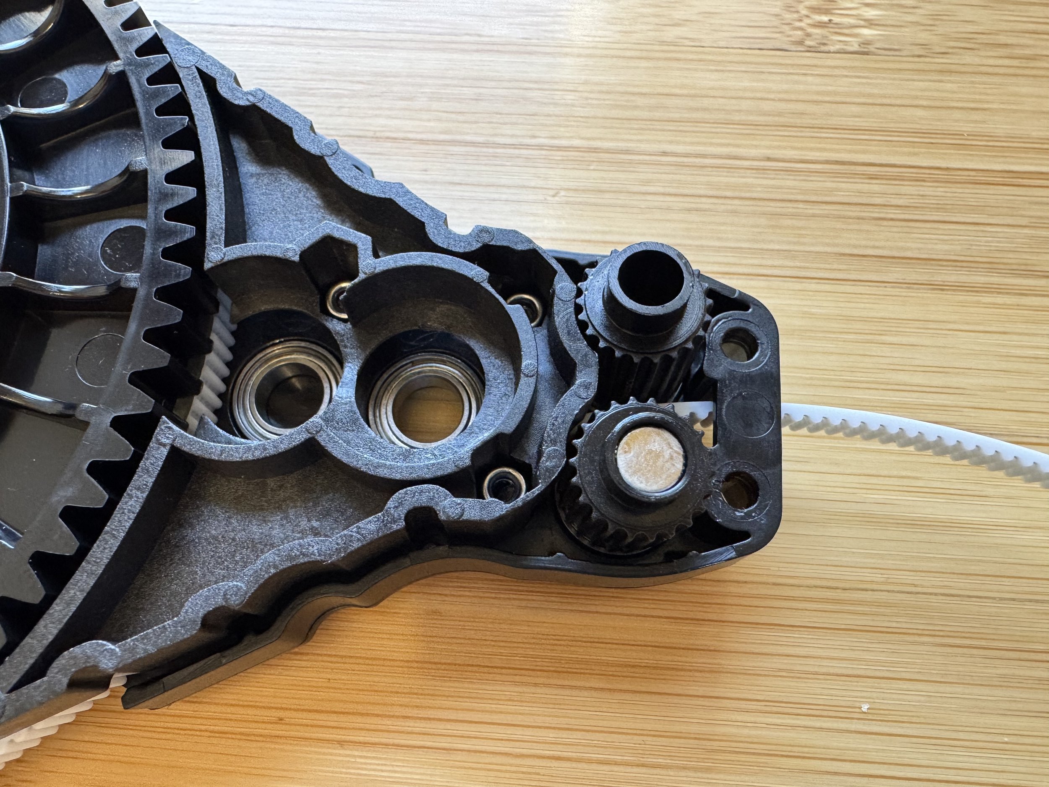
[picture p78: docs/assembling-the-arms-4-1/images/arms-31.jpg]
Inserting the two rollers


Insert the two rollers.

Note that one roller has a magnet and the other does not. The placement of the magnet is very important. It must line up with the sensor (in green on the right) on the other half of the arm when the two halves come together.

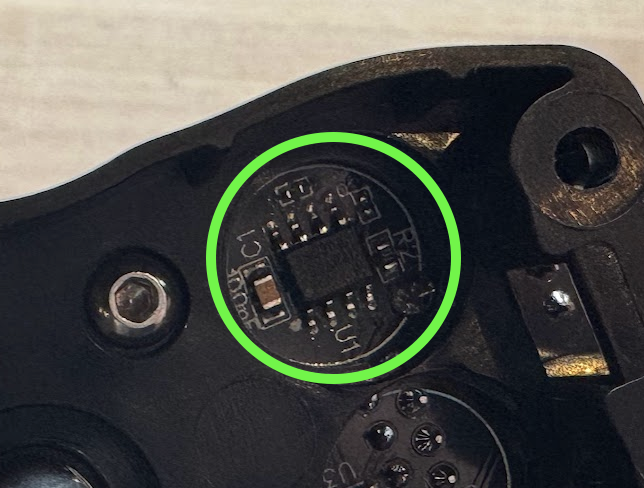
[picture p79: docs/assembling-the-arms-4-1/images/arms-32.png]
Magnet and sensor alignment


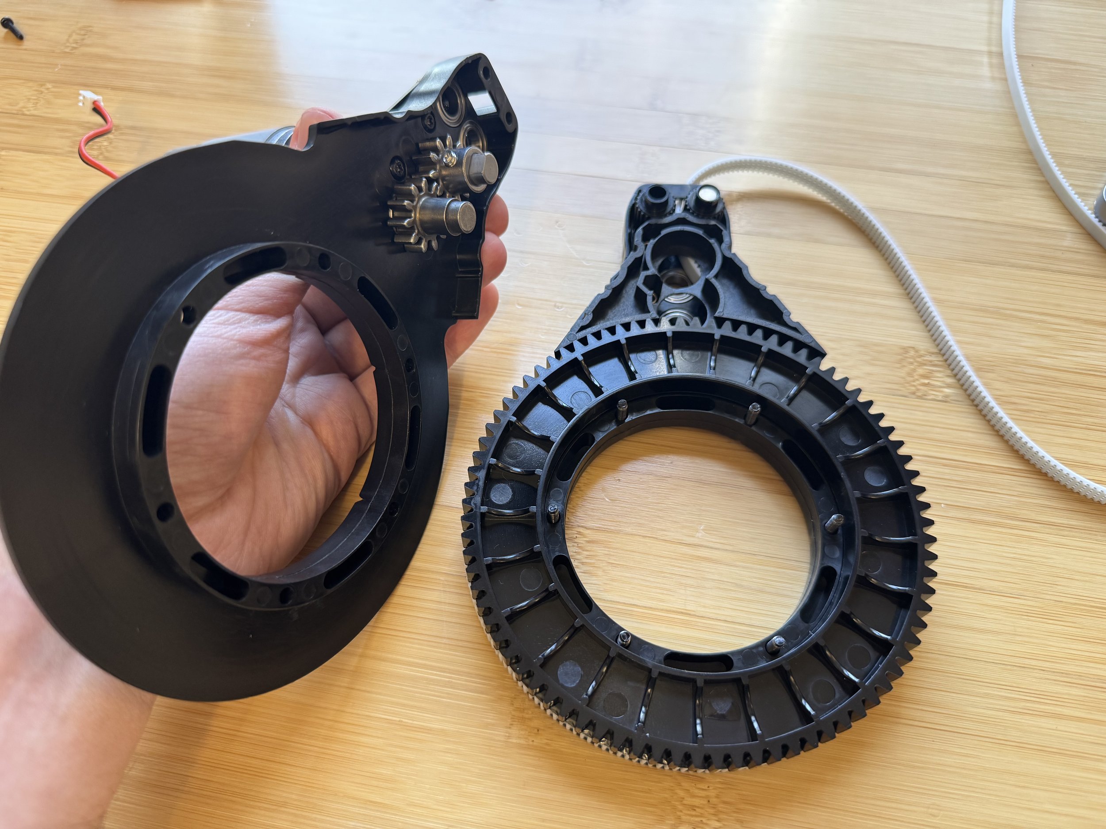
[picture p80: docs/assembling-the-arms-4-1/images/arms-33.jpg]
Lining up the two arm halves


Line up the two arm halves and then press the two halves together. This is much easier said than done and this is the trickiest step of the build process.

Generally I start from the back of the arm (the side that doesn't have the belt coming out of it) and work my way forward.

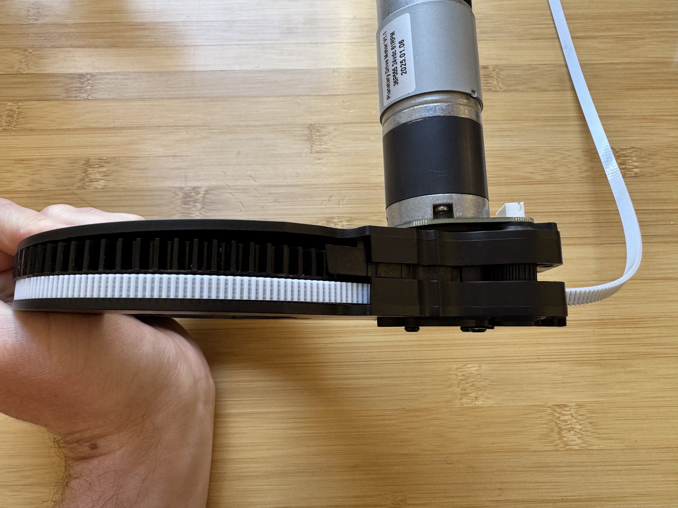
[picture p81: docs/assembling-the-arms-4-1/images/arms-34.jpg]
The three alignment points


There are three things which will need to go into place. First the idler shaft needs to align with the hole on the opposite side. Then the drive shaft needs to align with the opening in the bearing on the bottom, then the rollers will need to line up with bearings on the other half.

I find that by checking each one of these locations in turn and getting them lined up the two halves will come together. It can be helpful to use the allen wrench to jostle the rollers around to make them line up.

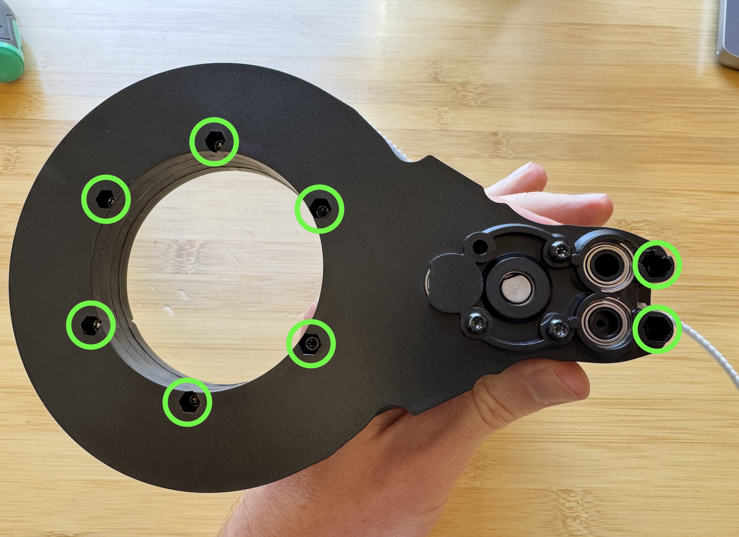
[picture p82: docs/assembling-the-arms-4-1/images/arms-35.png]
Joining the two halves with eight bolts


Then we join the two halves together with eight bolts.

Six of the bolts are the bolts we placed early on in the assembly process. The remaining two bolts are close to the front.

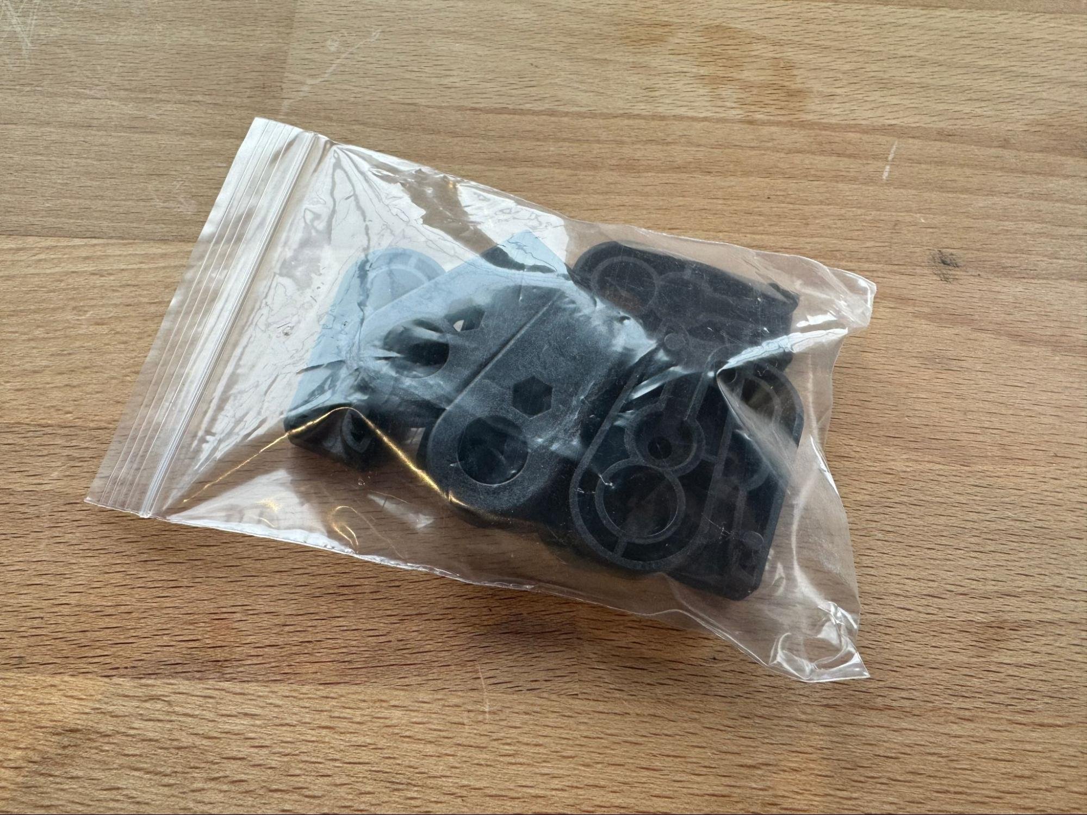
[picture p83: docs/assembling-the-arms-4-1/images/arms-36.jpg]
Gathering the eight belt end parts


Finally we need to attach the belt end to the end of our arms. Gather the eight belt end parts:

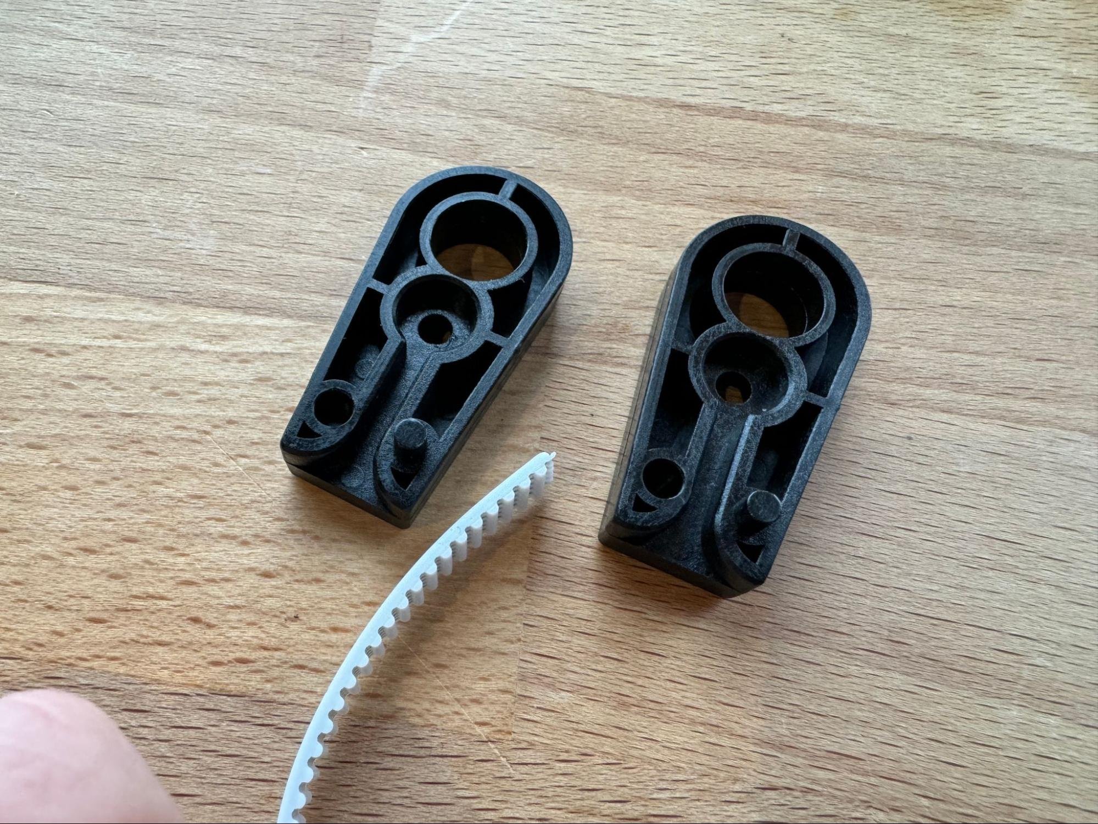
[picture p84: docs/assembling-the-arms-4-1/images/arms-37.jpg]
Taking two belt ends and the end of a belt


Then take two of the belt ends and the end of one of the belts extending from our arms:

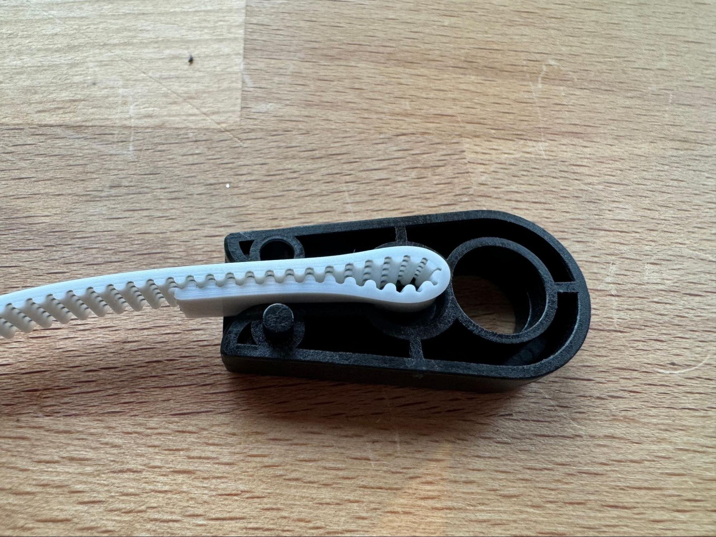
[picture p85: docs/assembling-the-arms-4-1/images/arms-38.jpg]
Folding the belt into the belt end slot


Fold the belt over and press it into the slot in the belt end so that the end protrudes only slightly. This can be tricky to do because the fit is tight (it needs to be tight to handle the force). I find that starting with the loop in the belt at the open end of the slot and pushing it forward works well. You can use the torx wrench to lever it into place. Watching the video at the top of this page can help.

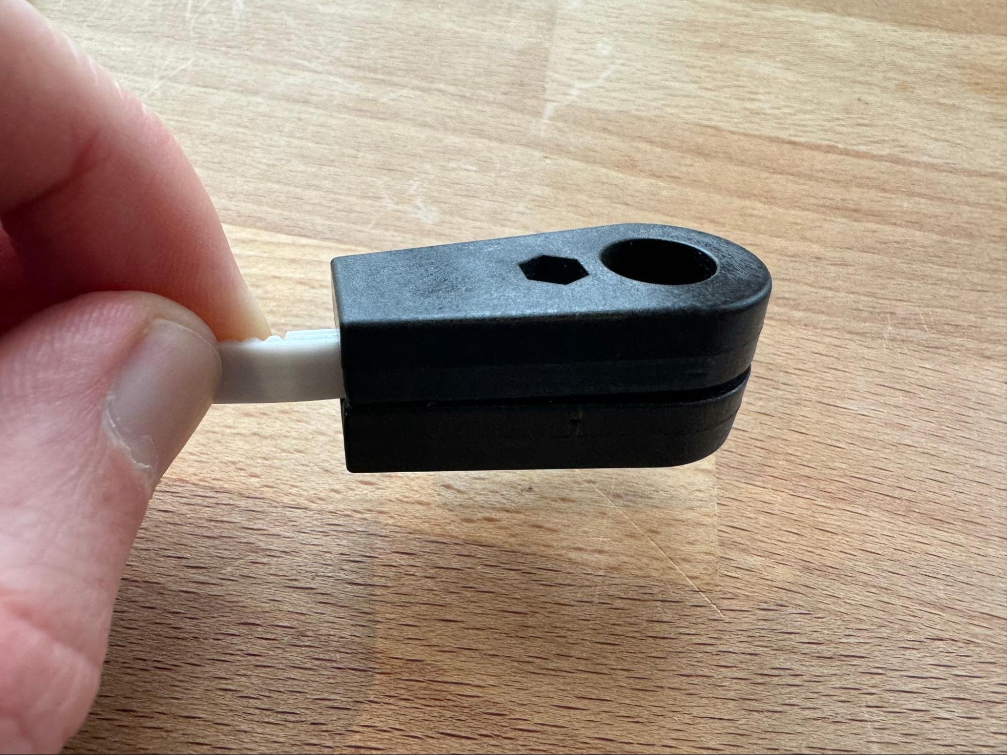
[picture p86: docs/assembling-the-arms-4-1/images/arms-39.jpg]
Pressing on the other half of the belt end


Then press on the other half of the belt end.

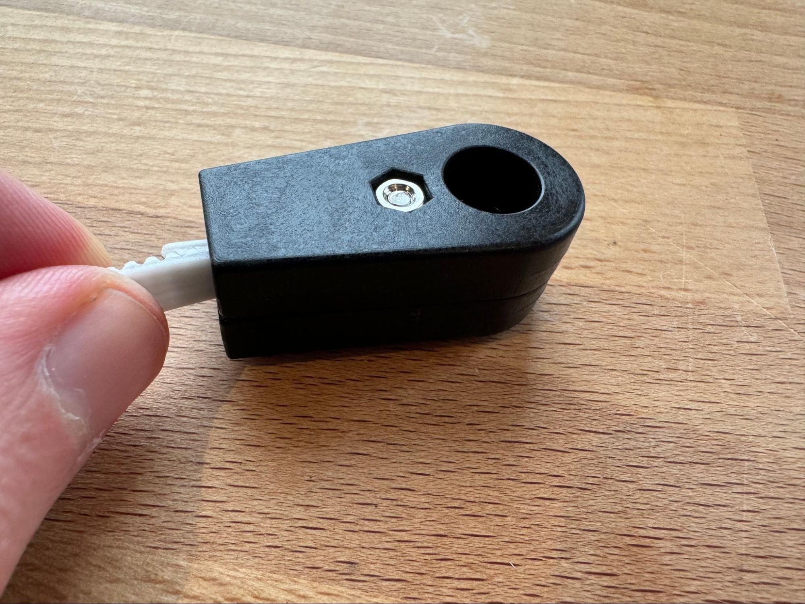
[picture p87: docs/assembling-the-arms-4-1/images/arms-40.jpg]
Securing with a bolt and non-lock nut


And secure it with a bolt and non-lock nut.

## Congratulations! You are done with the most difficult and longest part of the assembly process!

Next lets [assemble the sled](../assembling-the-sled-4-1/README.md).

## Resources

- [Maslow 4.1 Arms Assembly Video](https://www.youtube.com/watch?v=9soKe6nXHms)
- [Maslow CNC Forums](https://forums.maslowcnc.com/)
