IArchi/Maslow_4/docs/assembling-the-router-4-1/README.md

# Assembling The Router

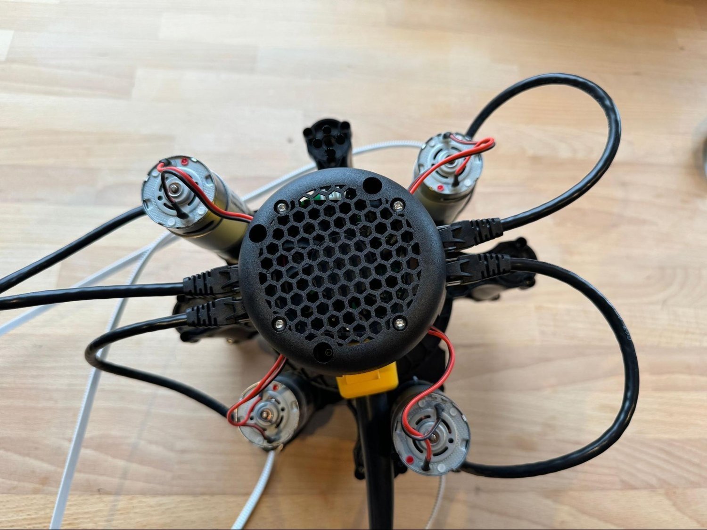
[picture p88: docs/assembling-the-router-4-1/images/router-01.jpg]
The assembled Maslow4 router


The Dewalt 611 router is the heart of Maslow4. In this step we're going to attach everything to the router.

A video walkthrough of this process is available here: [Maslow 4.1 Router Assembly Video](https://www.youtube.com/watch?v=SX6Un_KJFtk)

Find any of these steps confusing or get stuck? Don't forget, you aren't alone! Maslow is a community driven open source project. Ask in the [forums](https://forums.maslowcnc.com/) and we'll figure it out together!

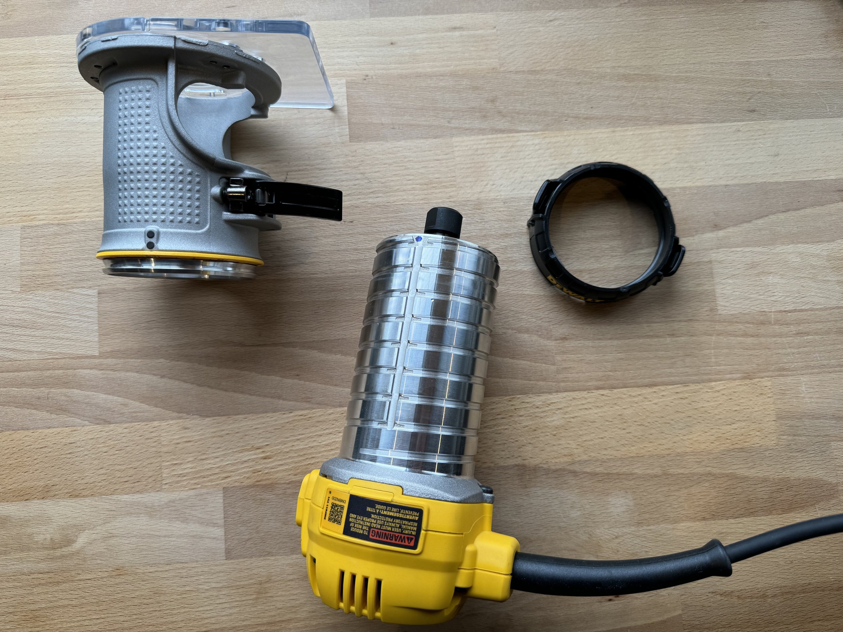
[picture p89: docs/assembling-the-router-4-1/images/router-02.jpg]
Removing the router body from the base


Remove the router body from the router base. Set the base aside, we won't need it.

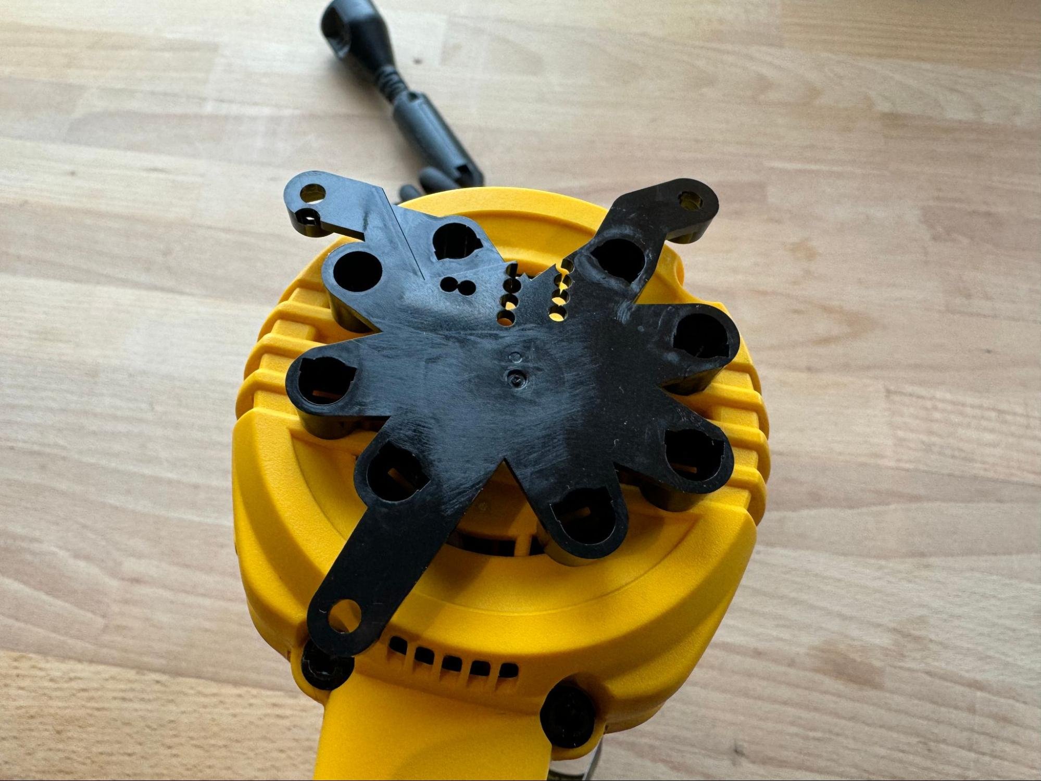
[picture p90: docs/assembling-the-router-4-1/images/router-03.jpg]
Attaching the PCB mounting plate


Attach the PCB mounting plate to the top of the router. The orientation of this part is important so be sure that it's not rotated 180 degrees. The power cord is down in this photo. Use a firm slap or a tap on the table to press it in place.

> **Note:** This part has been reported to fit not quite right on the 240 volt version of the router. See a potential modification to this part [here](https://forums.maslowcnc.com/t/which-router-to-order-for-240-volt-countries/19550/31?u=bar).

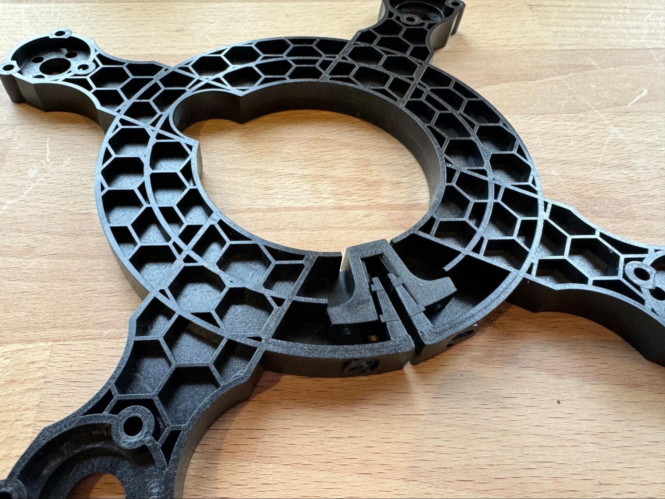
[picture p91: docs/assembling-the-router-4-1/images/router-04.jpg]
The first router clamp


Next find the first router clamp. Note that this is actually two parts together.

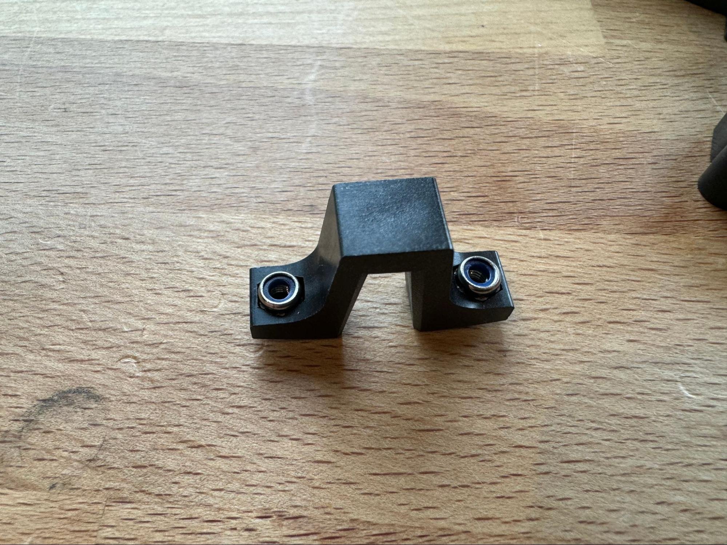
[picture p92: docs/assembling-the-router-4-1/images/router-05.jpg]
Separating the wedge and inserting lock nuts


Separate the clamping wedge and insert two lock nuts..

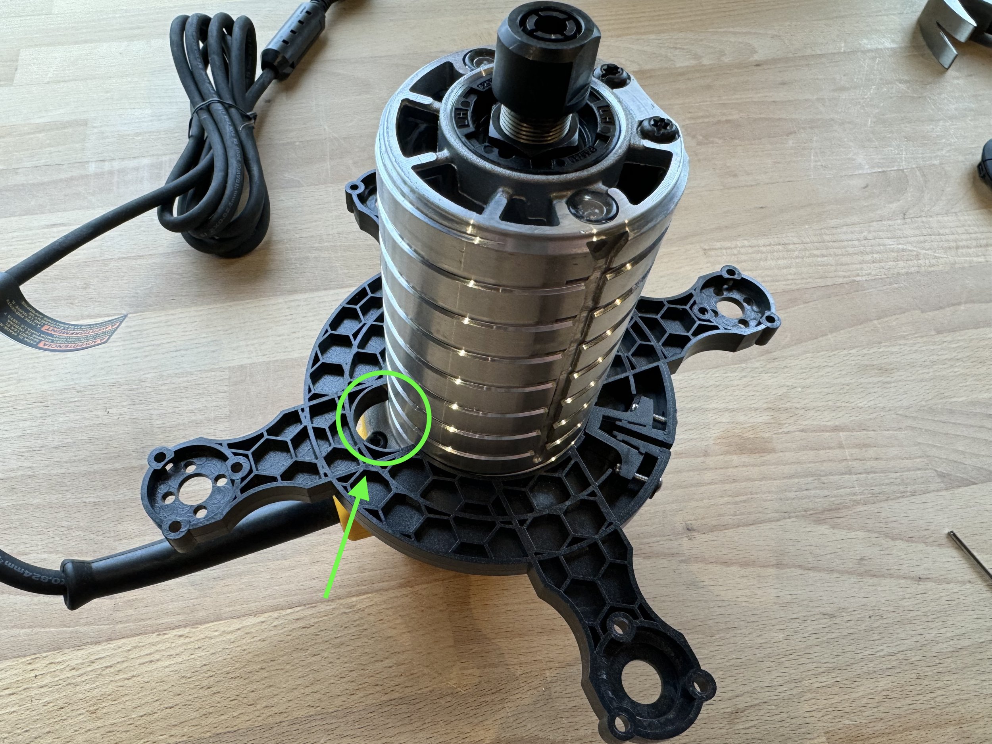
[picture p93: docs/assembling-the-router-4-1/images/router-06.jpg]
Sliding the clamp down the router


Put the wedge back on the clamp and add two bolts so that they just barely start to engage the threads on the bolt. Then slide the clamp down the router. Note that the notch in the clamp should be towards the power cord.

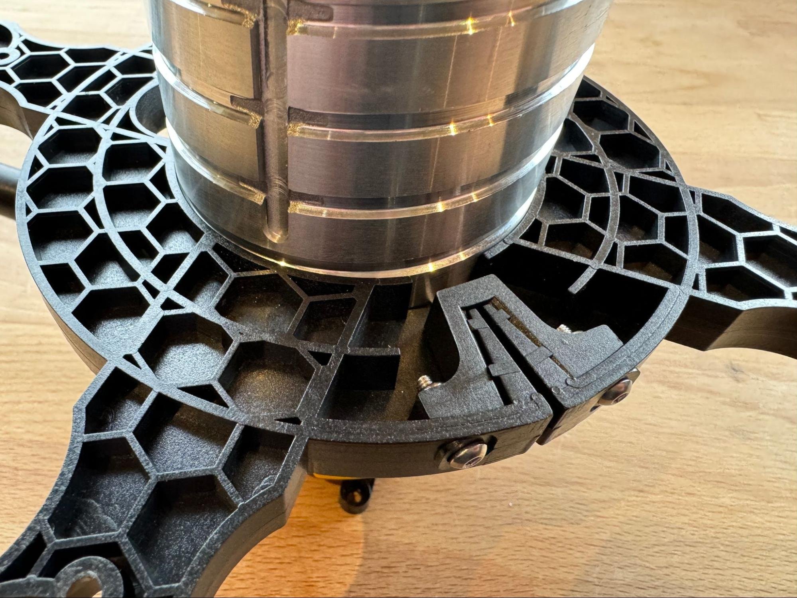
[picture p94: docs/assembling-the-router-4-1/images/router-07.jpg]


Next, tighten the two bolts to lock the clamp in place.

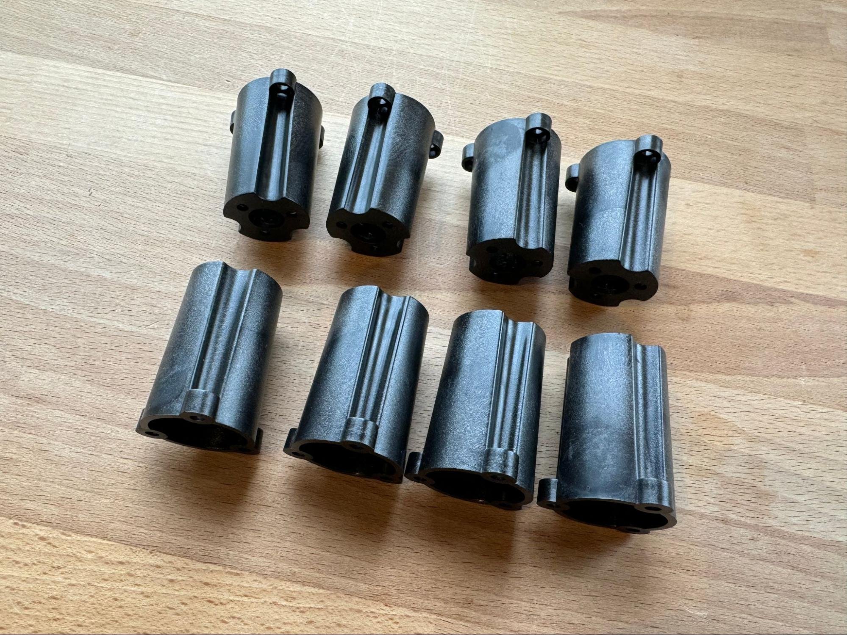
[picture p95: docs/assembling-the-router-4-1/images/router-08.jpg]
The eight upright pieces


Next, collect the eight pieces which make up the Maslow4 uprights.

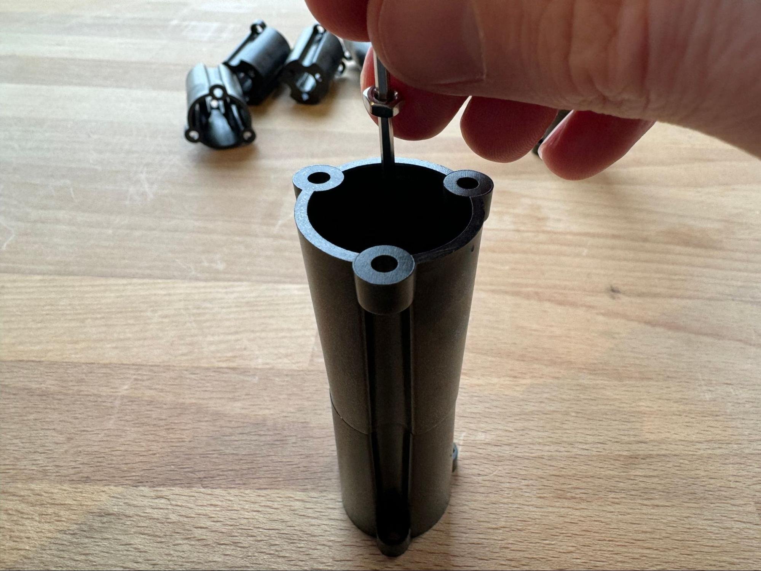
[picture p96: docs/assembling-the-router-4-1/images/router-09.jpg]
Guiding nuts into the upright recesses


Stack two on top of each-other and then use the Allen wrench to guide a nuts into place in the three recesses at the bottom. I used the regular nuts instead of the lock nuts here because I find it easier.

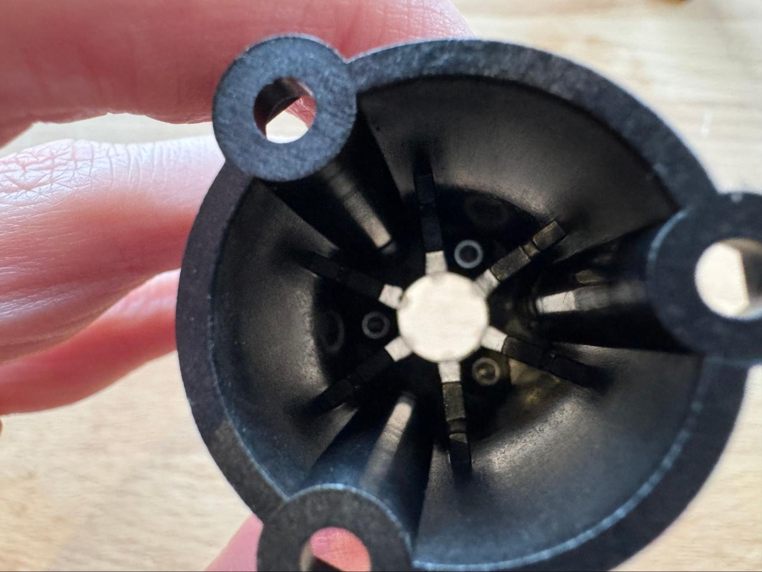
[picture p97: docs/assembling-the-router-4-1/images/router-10.jpg]
Adding a bolt from the other side


Then add a bolt from the other side. I like to thread the bolts in from the bottom while letting gravity hold the nuts in place.

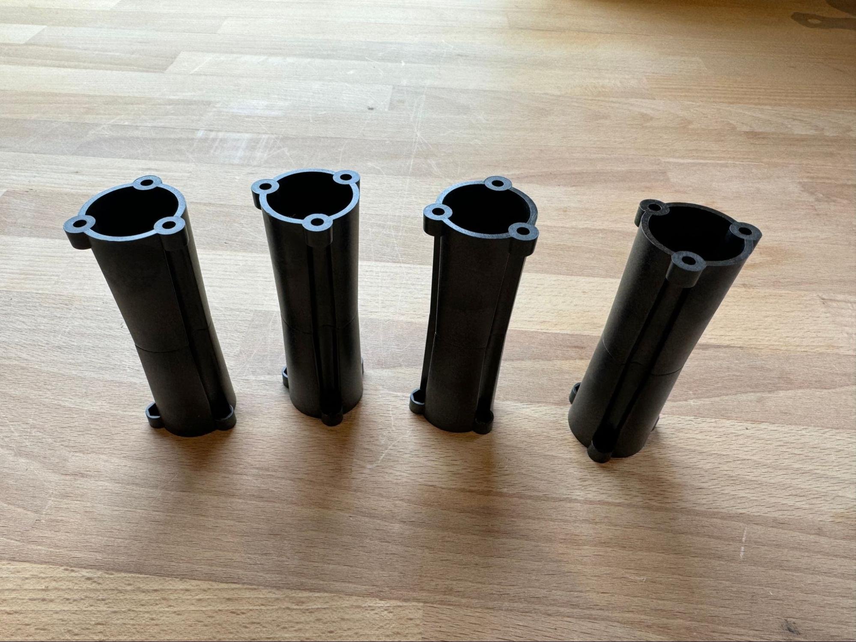
[picture p98: docs/assembling-the-router-4-1/images/router-11.jpg]
Repeat for all four uprights


Repeat this step for all four uprights.

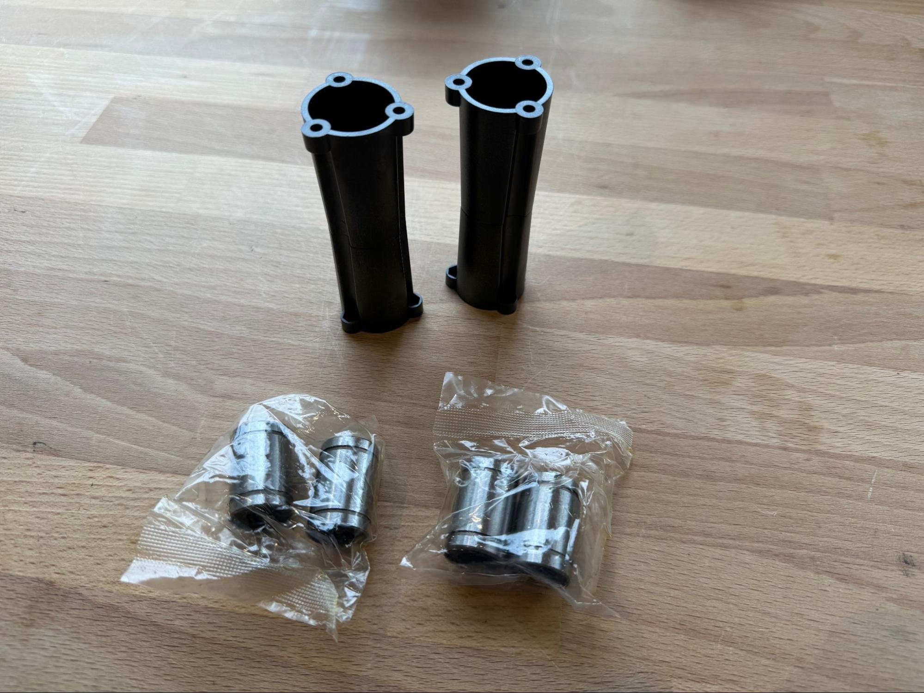
[picture p99: docs/assembling-the-router-4-1/images/router-12.jpg]
The linear bearings and two uprights


Next collect the linear bearings and two of the uprights.

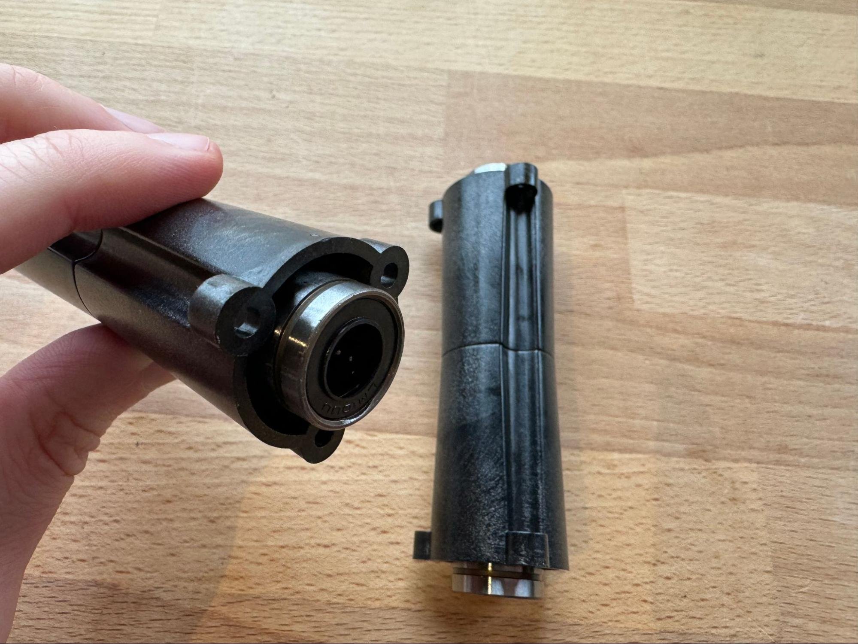
[picture p100: docs/assembling-the-router-4-1/images/router-13.jpg]
Pressing a linear bearing into each end


Press a linear bearing into each end of those two uprights.

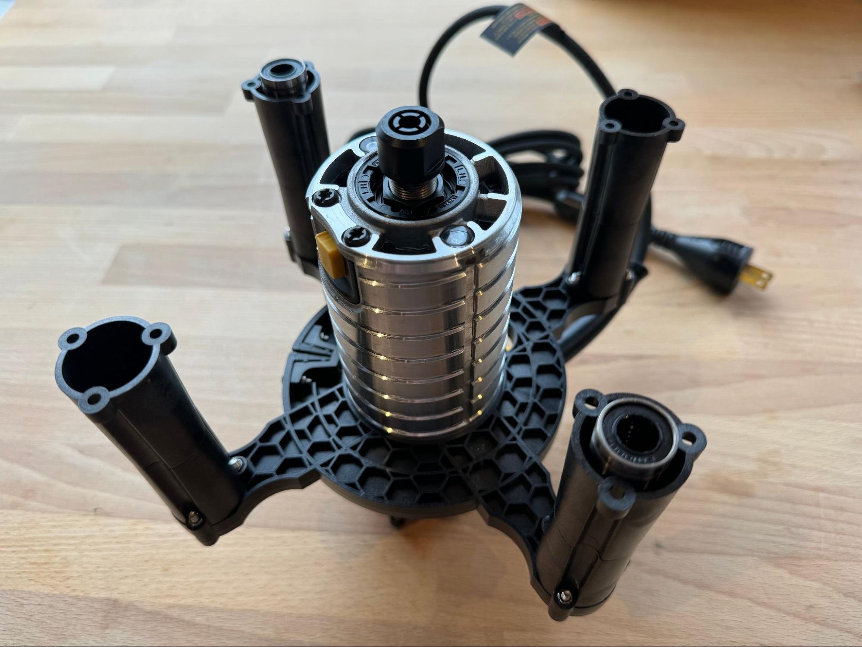
[picture p101: docs/assembling-the-router-4-1/images/router-14.jpg]
Bolting the uprights to the clamp


Next, we will bolt the uprights to the clamp. The uprights with the linear bearings will fit into recesses on two of the arms (shown on the right).

Note that the two uprights with the linear bearings go to the left and right of the power cord, while the two without linear bearings go close to the power cord and across from it.

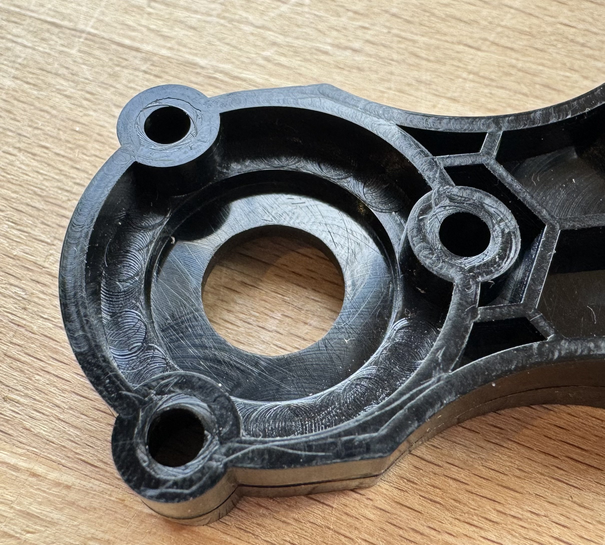
[picture p102: docs/assembling-the-router-4-1/images/router-15.jpg]
Upright orientation


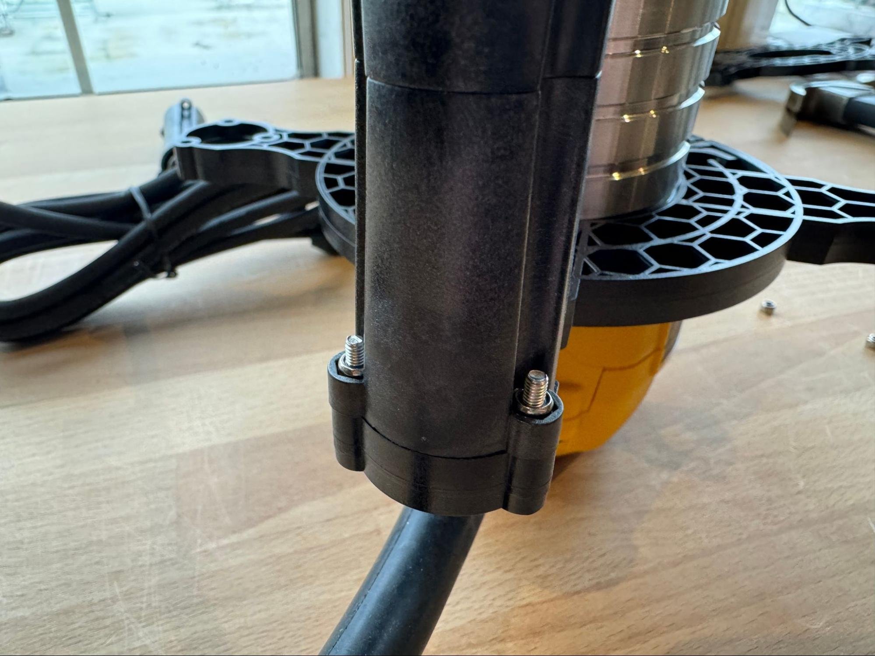
[picture p103: docs/assembling-the-router-4-1/images/router-16.jpg]
Each upright held with three bolts


Each upright is held in place with three bolts.

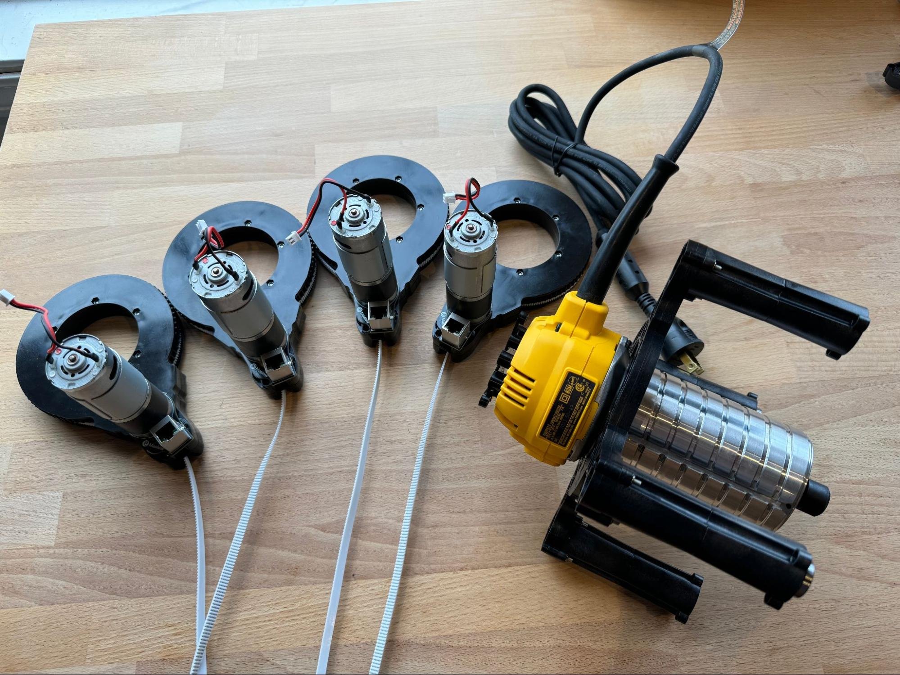
[picture p104: docs/assembling-the-router-4-1/images/router-17.jpg]
Gathering the four arms


Gather the four arms that we built previously.

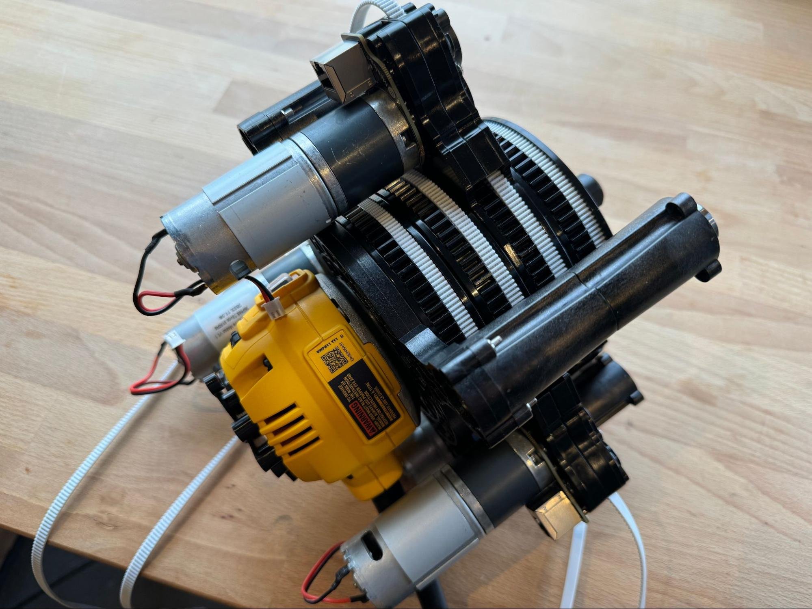
[picture p105: docs/assembling-the-router-4-1/images/router-18.jpg]
Sliding the arms onto the router


And slide them onto the router. Note that the order that they go on is important. See the illustration below for the correct order.

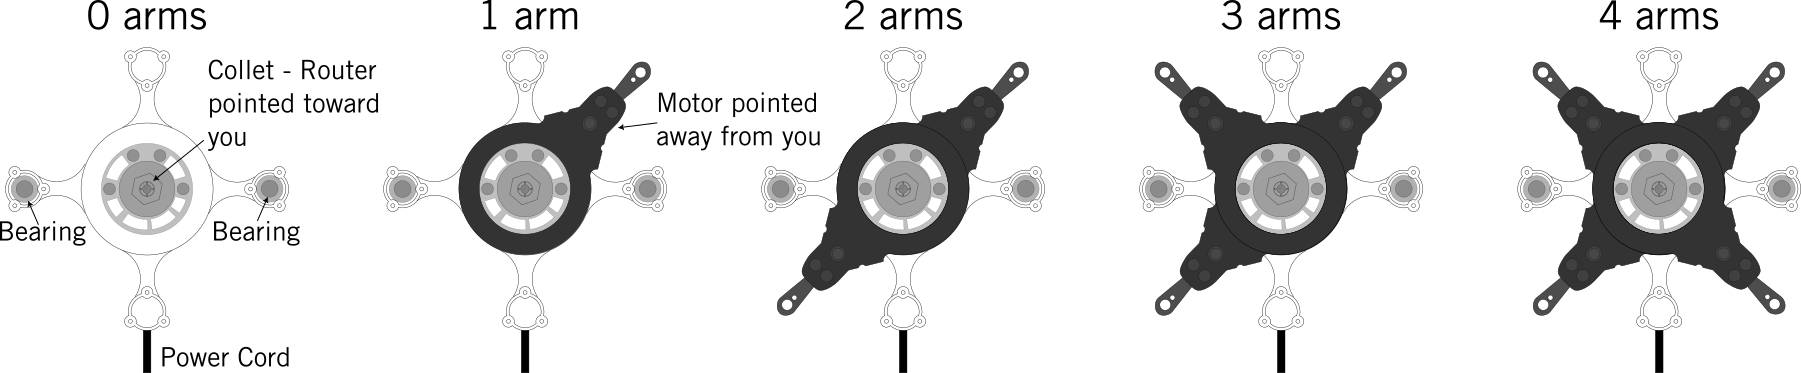
[picture p106: docs/assembling-the-router-4-1/images/router-19.png]
Correct arm assembly order


Credit to jwolter for creating this helpful image

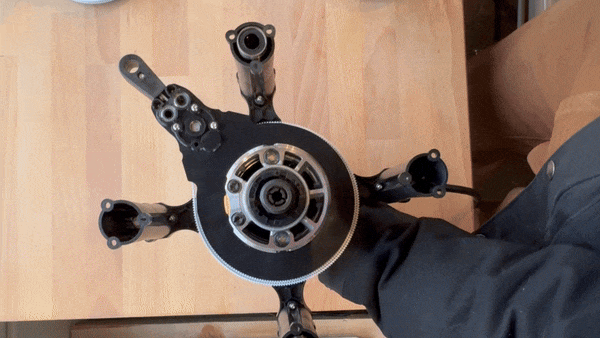
[picture p107: docs/assembling-the-router-4-1/images/router-20.gif]
Assembly process animation


Here is a gif showing the assembly process. Note that the power cord is to the right in this clip.

And here is a video: [Arm Installation Video](https://www.youtube.com/watch?v=J3MzsTrPA-Q)

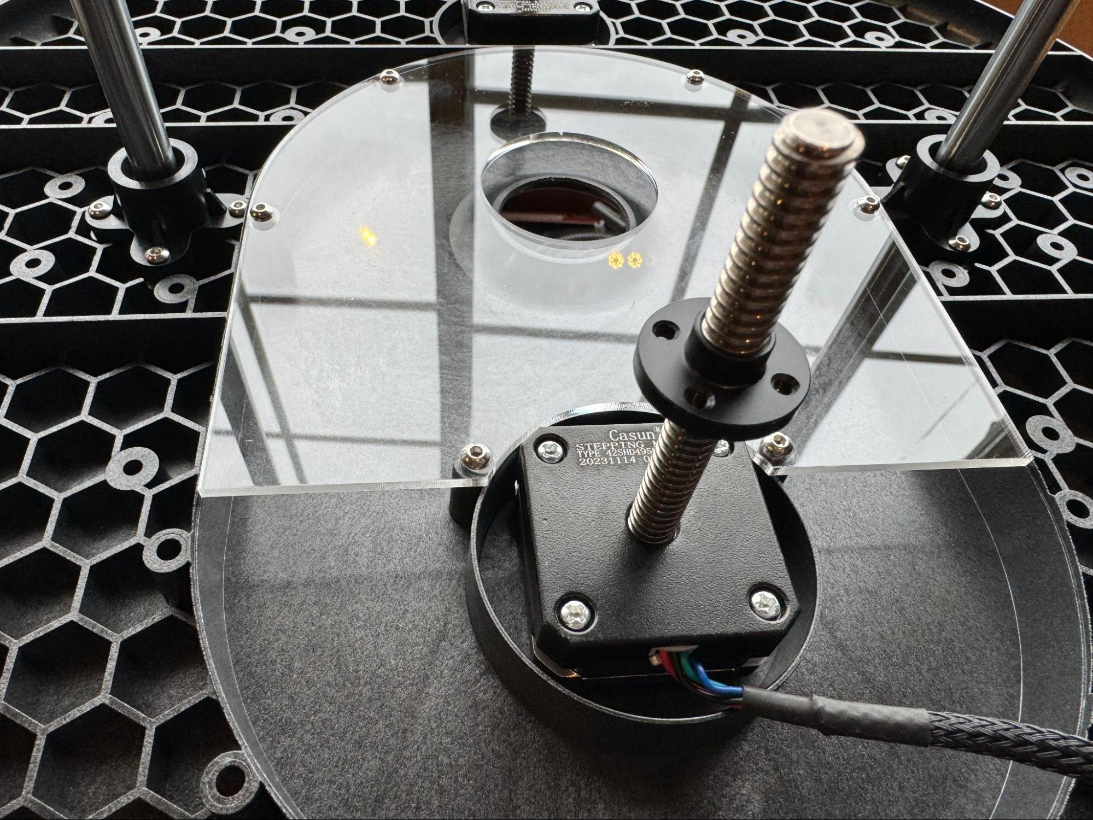
[picture p108: docs/assembling-the-router-4-1/images/router-21.jpg]
Removing the leadscrew nuts


Next remove the two leadscrew nuts from the z-axis stepper motors attached to the sled.

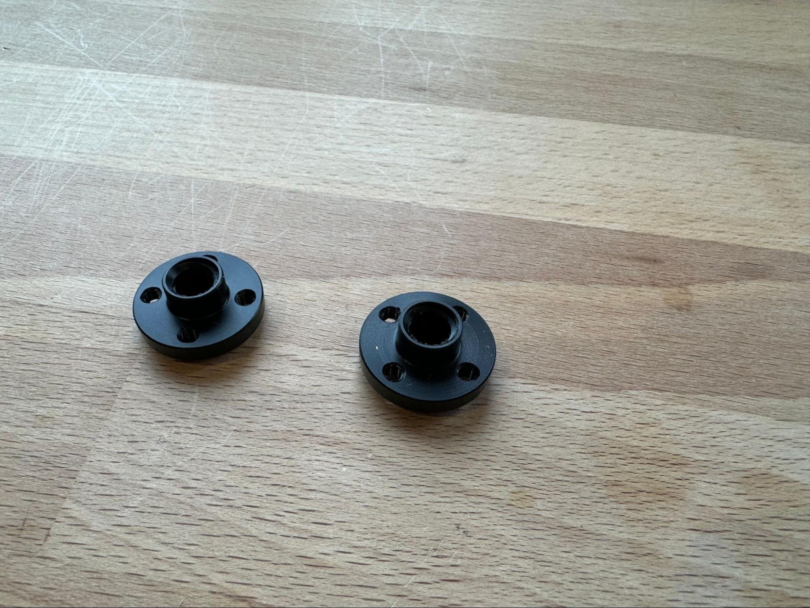
[picture p109: docs/assembling-the-router-4-1/images/router-22.jpg]
The leadscrew nuts


They will look like this.

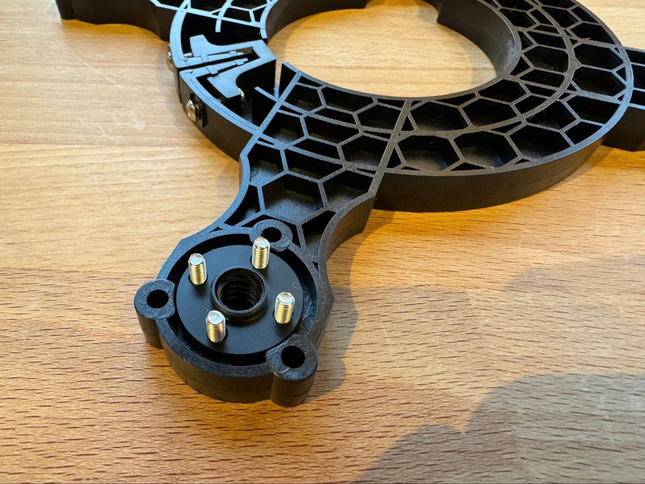
[picture p110: docs/assembling-the-router-4-1/images/router-23.jpg]
Bolting the leadscrew nuts into the second clamp


The two lead screw nuts will bolt into the second router clamp like this. The nut has a longer side and a shorter side. The direction is not critical, but I put the longer side down as shown in the picture.

Repeat the process of adding nuts and bolts to the clamping wedge on the lower clamp the same as on the upper router clamp.

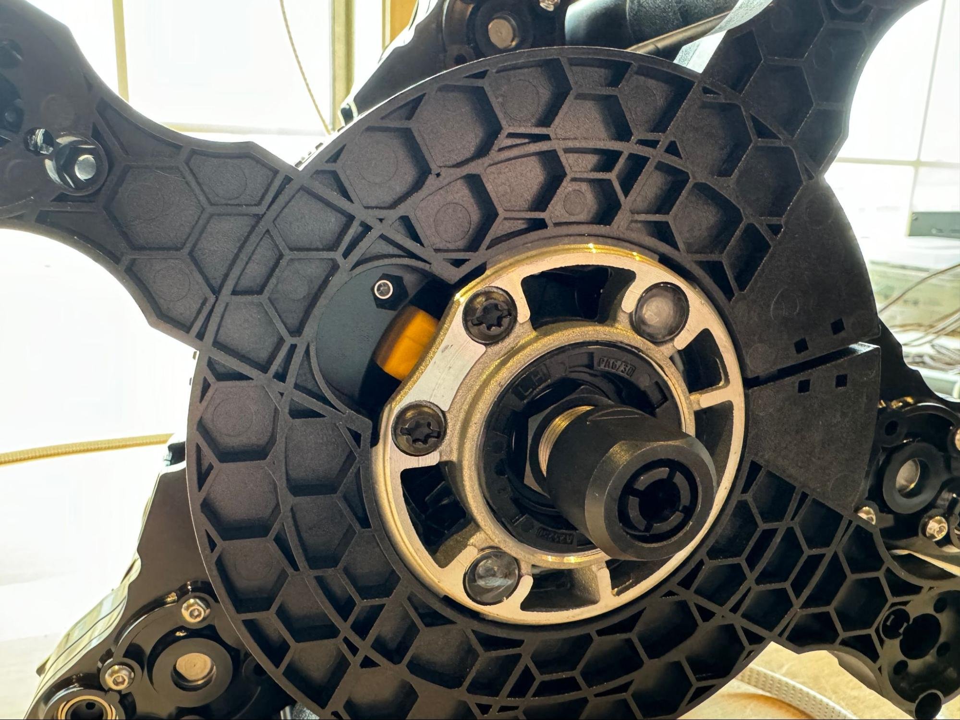
[picture p111: docs/assembling-the-router-4-1/images/router-24.jpg]
Flipping the router clamp into place


Flip the router clamp into place on the router so that the notch in the clamp aligns with the yellow button on the router.

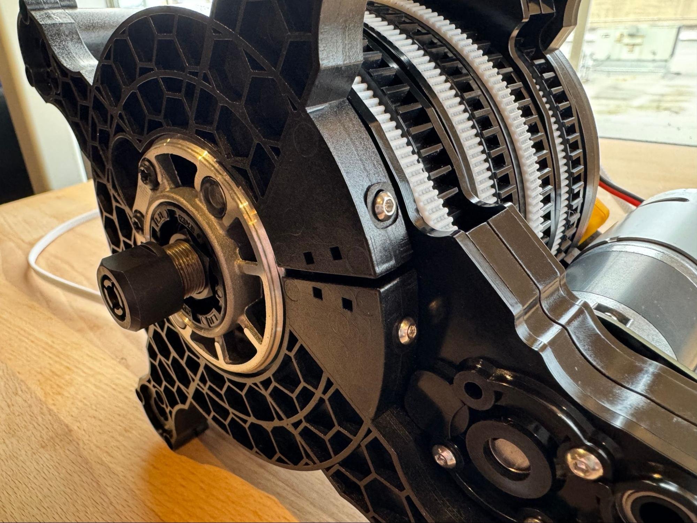
[picture p112: docs/assembling-the-router-4-1/images/router-25.jpg]


Tighten the bolts to lock the clamp in place

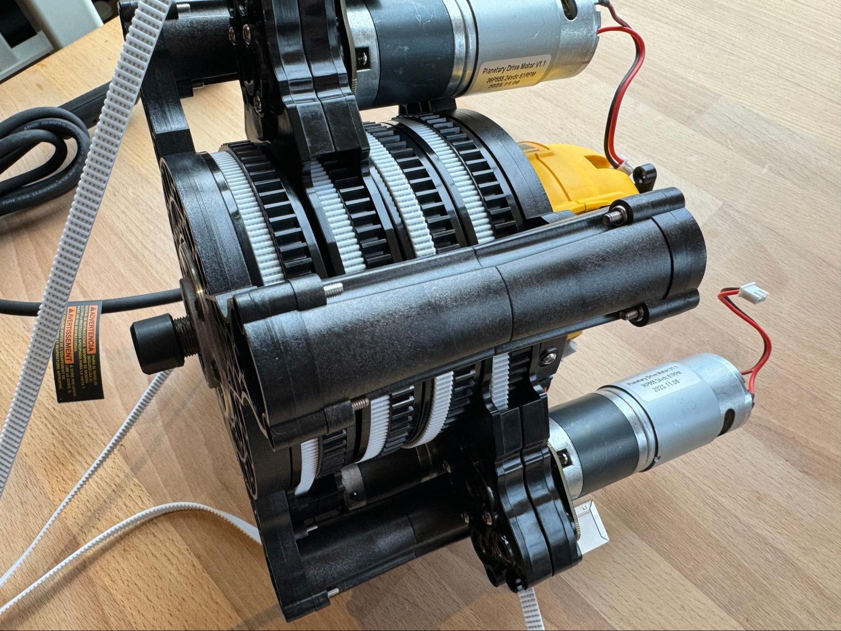
[picture p113: docs/assembling-the-router-4-1/images/router-26.jpg]
Bolting the clamp to the uprights


Then bolt it to the uprights like before.

> **Note:** We recommend not using lock nuts in this step. If you need to take the machine apart you will remove this clamp and the lock nuts can be difficult to remove.

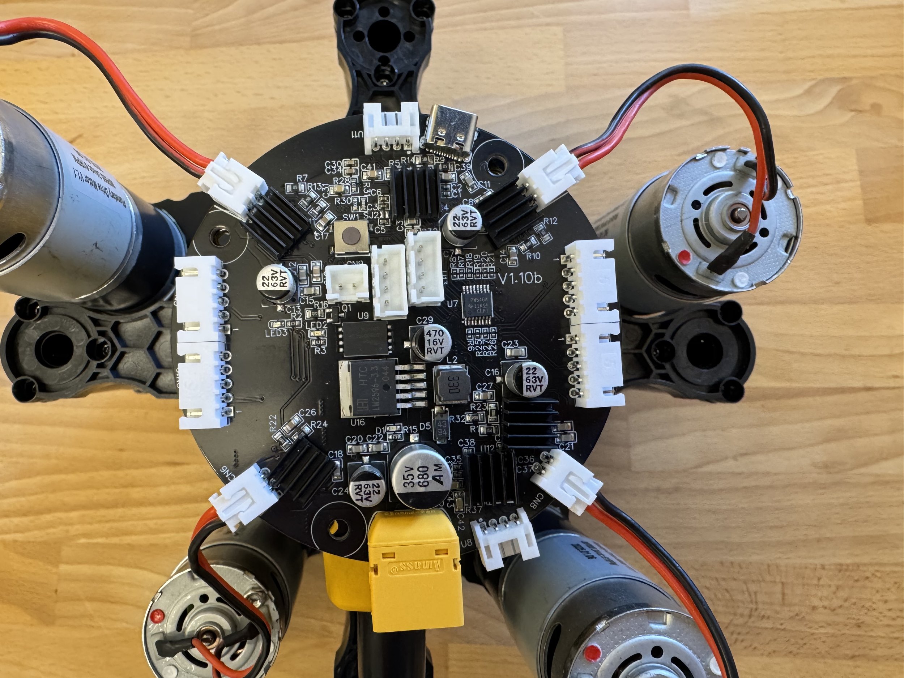
[picture p114: docs/assembling-the-router-4-1/images/router-27.jpg]
Placing the main controller board


Place the main controller board on top of the router and plug in the four motors.

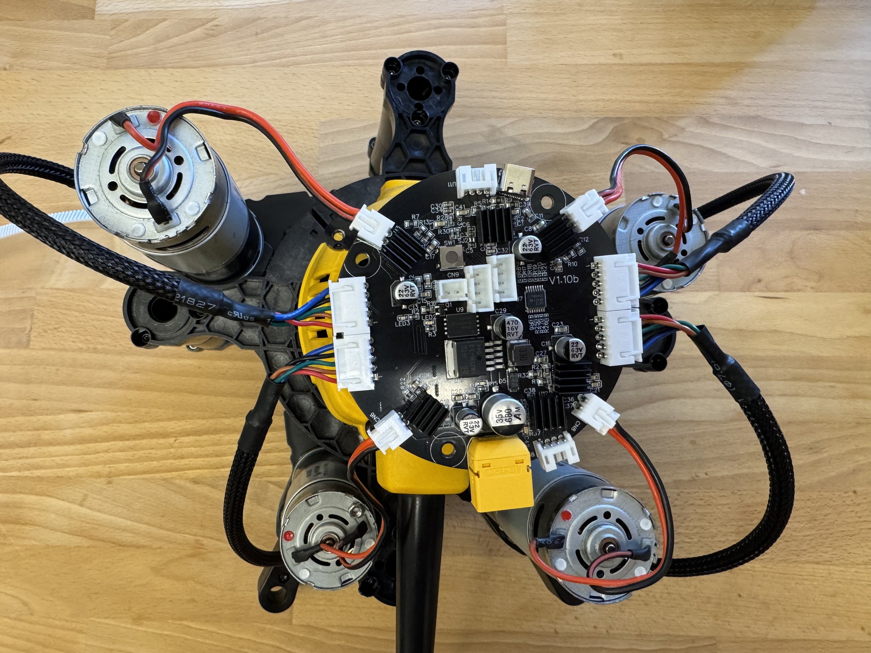
[picture p115: docs/assembling-the-router-4-1/images/router-28.jpg]
Connecting the encoder cables


Use the four JST-XH cables to connect the encoders to the controller board.

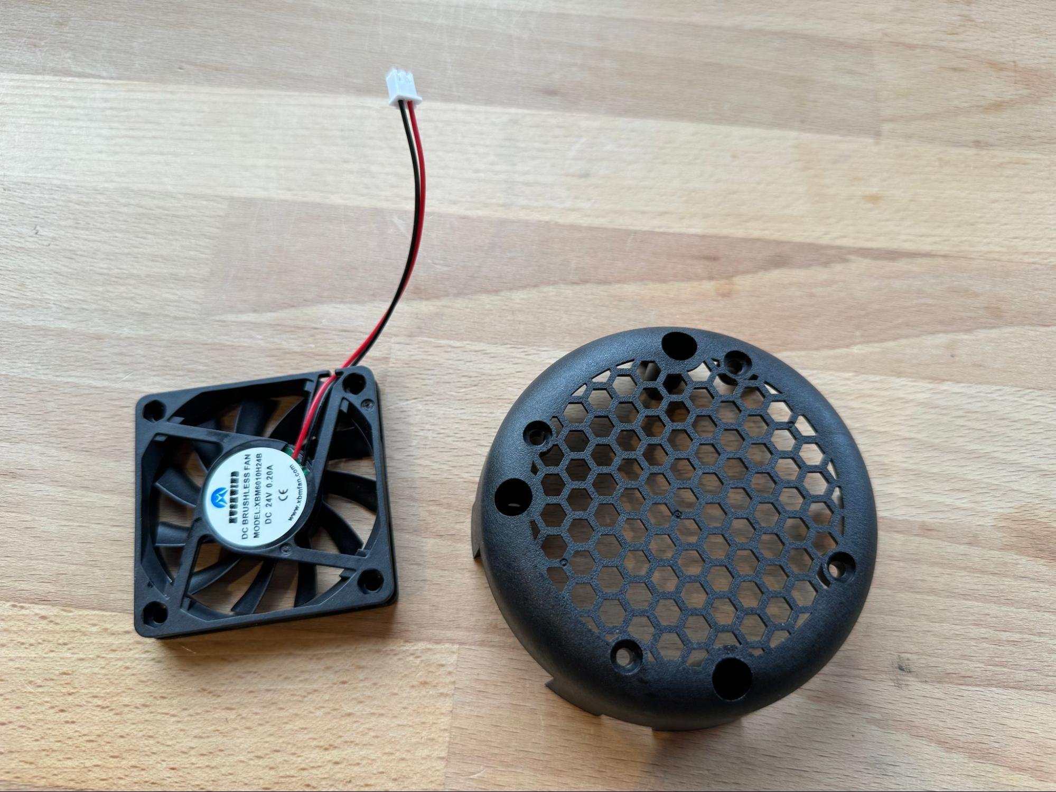
[picture p116: docs/assembling-the-router-4-1/images/router-29.jpg]
The cooling fan and PCB cover


Next collect the cooling fan and the PCB cover

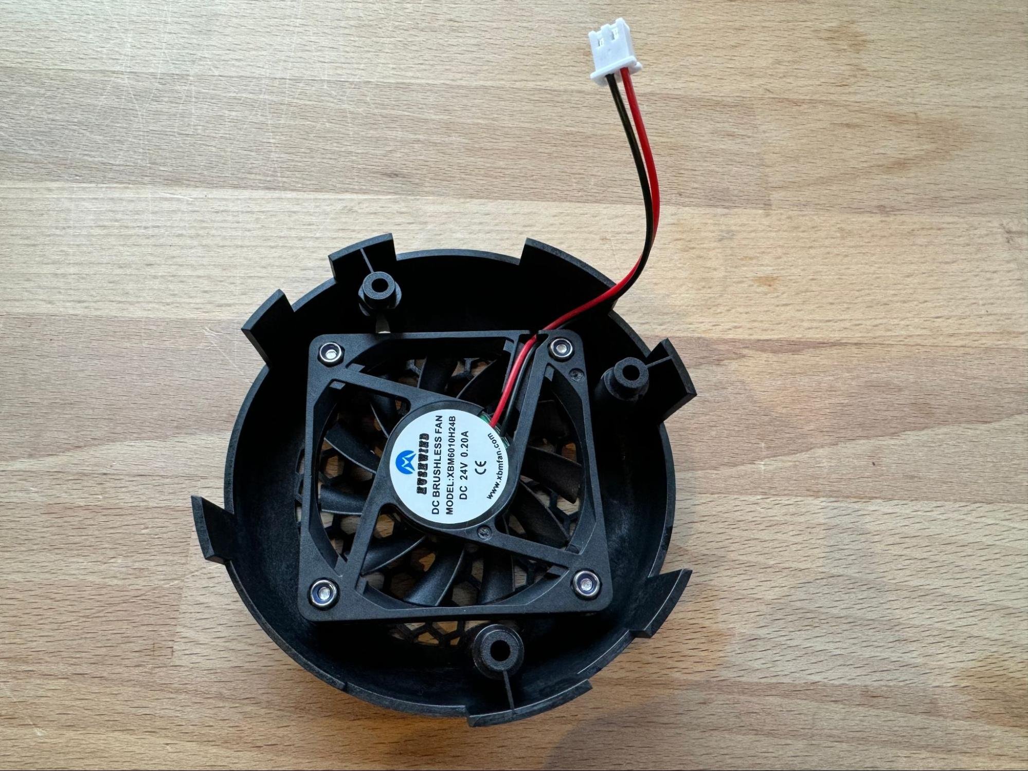
[picture p117: docs/assembling-the-router-4-1/images/router-30.jpg]
Bolting the cooling fan into the cover


Bolt the cooling fan into the controller cover using four bolts.

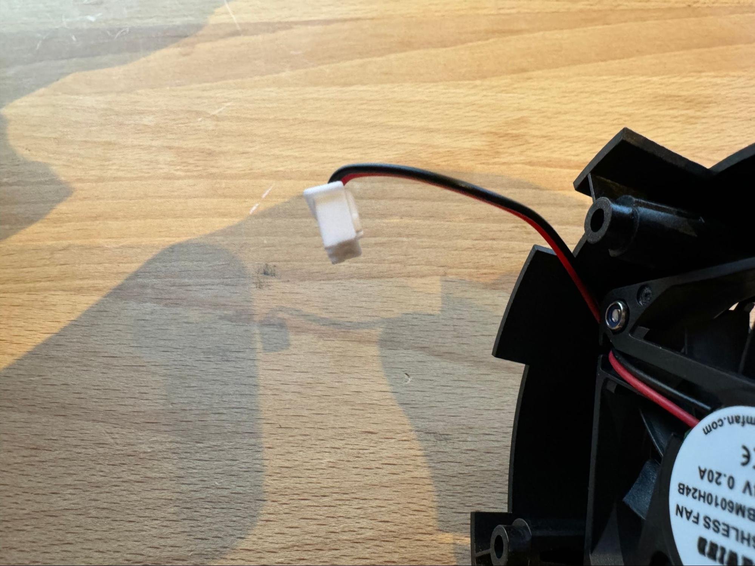
[picture p118: docs/assembling-the-router-4-1/images/router-31.jpg]
Bending the fan wire


Add a slight bend to the fan wire close to the connector. This will help keep the wire directed so that it won't go into the fan blades once everything is assembled.

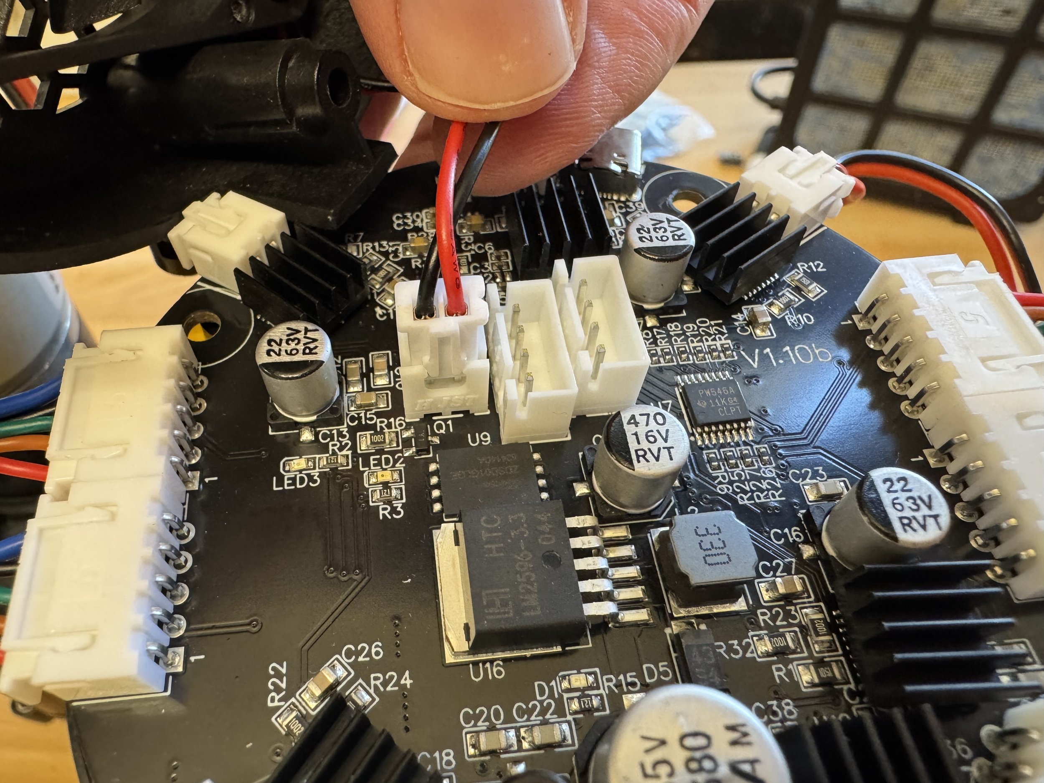
[picture p119: docs/assembling-the-router-4-1/images/router-32.jpg]
Plugging in the cooling fan


Plug the cooling fan into the controller board.

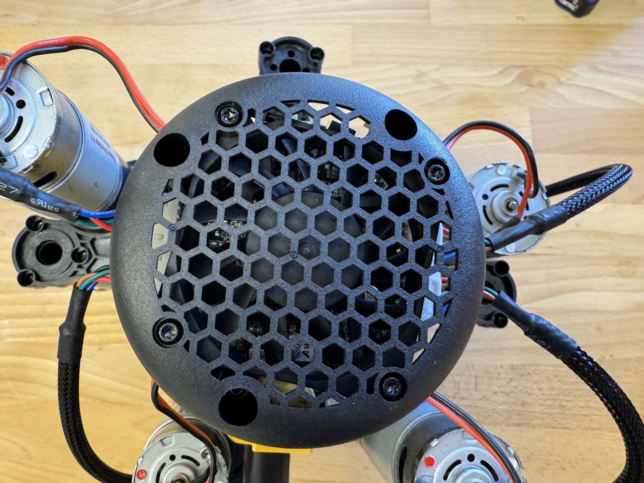
[picture p120: docs/assembling-the-router-4-1/images/router-33.jpg]
Bolting the PCB cover, board, and router together


Finally bolt the PCB cover, the controller board and the router together using three bolts and three nuts placed underneath.

## Congratulations! The heart of your machine is complete.

Next let's [put it all together](../putting-it-all-together-4-1/README.md).
