IArchi/Maslow_4/docs/MaslowCNC_Wisdom_Manual.md

## Quicklinks:
Website where you can buy a kit and current assembly instrucitons: 
[https://www.maslowcnc.com/](url)

Assembly instructions in wiki:
[https://github.com/MaslowCNC/Maslow_4/tree/Maslow-Main/docs/assembling-the-arms-4-1](url) 

Repository and wiki:
[https://github.com/MaslowCNC/Maslow_4/wiki](url)

Forums:
[https://forums.maslowcnc.com/](url)

This is a rough draft. For more info got to [www.maslow.cnc](url)
Maslowrender

LogoWithR

# INTRO
# Maslow-CNC-wisdom-manual for machines version 4 and 4.1 Current through 2025
Rough draft space for writing down instructions and useful tips for getting started on Maslow CNC currently for machine 4 and 4.1 This is intended as a comprehensive guide. A quick start manual could be made by linking to relevant sections.  If you are editing here is a guide to markdown typing commands https://www.markdownguide.org/cheat-sheet/ The general plan is that the topics are ordered by when you would need them in the process of getting started. To make sure we stayed consistent and throrough there will be parts that are duplicated from the build and setup instructions elsewhere in the manual.  It seems important to keep the basic build instructions and getting started info together and then have the sections later that expand and collect wisdom and specifics.    



# What is it? 
Maslow is a DIY 3 axis (x,y,z) computer numberical control (CNC) robot that controls a router to cut wood, plastic or other flat material.  It has been designed to work well on a 4x8 foot sheet of material or smaller and it is able to sculpt and cut vertically about 30 cm or 2.5 inches deep.  Maslow is designed around a small sled that carries the router and is anchored to an external frame by long belts that it uses to pull itself around.  This means that the core robot is very portable. It does require a stiff frame or anchors external to the robot.  It rides on top of the work being cut so it works well on cutting and sculpting shallow shapes but not giant bathtub sized hollows. Maslow is focused on accessiblility. 

Maslow's control software is a local website hosted inside the machine that you can access through USBC cable, Wifi direct to the machine, or through your local wifi network. It can be used with a phone or a computer. It recieves standard Gcode machine instruction files (.nc)  You will need cnc design software that can generate Gcode. There are many free or fancy options. 

The control software is built on top of FluidNC an open source cnc control software for ESP32 computers. Maslow4's pcb is an esp32 computer. The FluidNC project wiki is here: 
http://wiki.fluidnc.com/
Github:https://github.com/bdring/FluidNC
Donate to FluidNC:


 It is different from a gantry designed CNC router which are designed around a table that fits the material inside and then the robot moves forward and back on rails. It is much much less expensive than a gantry machine. It is in general less accurate than a good gantry machine. Gantry machines can also be 4 or 5 axis machines in which they can rotate the material in order to cut it at different angles. 

Maslow is a project developed by Barbour Smith and a community of vollunteers and forum members as an open source project that is still under development.  It is portable, exciting, inexpensive and perhaps frustrating and still requires some troubleshooting and figuring out to get started.  Barbour has been working on iterations of this for more than a decade and many people have been successful at making many exciting projects including saunas, tables, signs, and a 30 foot catamaran! (link to project gallery) but it is not at the moment a perfect plug and play tool.  **If making your own portable blade weilding robot in an enthusiastic online community sounds fun, then you are probably in the right place.** 



## How does Maslow4 work?

Maslow4 uses four independently controlled steel reinforced belts to control its position while cutting. Each belt is controlled by a DC servo motor. The belt spools up around a central drum and passes between a pair of toothed rollers as it extends out. The roller which engages the belt’s teeth contains a high precision magnetic encoder which precisely measures the length of the belt allowing us to control the belt’s length to within 1/100th of a mm. Each spool has enough space to fully retract the belt for storage, and enough belt to cover a greater than 4’x'8’ work area when extended.

Each of Maslow’s 4 independent servo axes is driven by a powerful 24 volt motor coupled to a durable planetary gearbox which gives it the power that it needs to operate in either a vertical or horizontal orientation at speeds up to 2,500mm/min. Each servo axis has current feedback allowing the controller to detect when the belts are taut which is used during the automatic homing and calibration process.

The depth of the cut is controlled by two stepper motors with lead-screws which raise and lower the router as it moves. Maslow4 has 50mm or 1.9 inches of z-axis travel.

Maslow4 attaches to any flat rigid surface from horizontal surfaces like floors up to nearly vertical surfaces. It needs at least 15-20 degrees of angle off vertical to work correctly.

## How do I control Maslow4?

You can connect to Maslow4 from any Mac, Windows, Linux, i-OS, or Android device via WiFi, USB C, or Bluetooth. To connect via WiFi just connect to the “Maslow” WiFi network that the device creates when powered up and open any web browser (Firefox, Chrome, Safari, Edge…etc). You do not need to install any software. No internet connection is required, but if you have WiFi in your shop you can connect Maslow4 directly to your shop WiFi to control it from any computer on your shop network. Maslow4 uses industry standard g-code files so you can use it with any CAD/CAM software that you prefer (SolidWorks, OnShape, Fusion360, Autocad, FreeCAD, Ilustrator…etc). Maslow4 has enough internal memory to store hundreds of files, so if your computer goes to sleep, you close the window, or for some reason the connection is lost, Maslow4 will not be interrupted. 

If you live in a country with electrical outlets different from the ones in the US, you will need to find a cord which looks like this. The included power supply will work with 110-240 volts.
Maslow4 Technical spec:

Speed: 2,500mm/min (100ipm) x/y, 300mm/min (11ipm) z

Precision: +-0.5mm (1/64in)*

Work Area: 1.2x2.4 meters (4x8 feet) x/y, 65mm (2.6 inches) z** 

File type: GRBL standard G-code (.gcode, .nc) files

*Note that for Maslow type machines there are really two forms of precision that we care about. The first is repeatability…ie if run the same file twice how closely will the machine follow its past motions. The second is accuracy…because Maslow relies on a precision understanding of its anchor point’s positions if it is calibrated badly shapes can come out distorted. The automatic calibration process exists to address that issue. With both of these taken into account, we expect shapes cut with Maslow4 to be within +-.5mm of how they were drawn on the computer.

**Note that this is sort of an arbitrary statement. Maslow4 works within the bounds of its anchor points, and depending on the positioning of the anchor points a lot of different work areas are possible. For example 5’x5’ is also possible if you want a bigger square work area, or if Maslow4 is connected to the corners of a work bench then a smaller work area is possible. Generally the limiting factors are that the machine needs to be at least 1 foot from the anchor points to cut, and it can’t go so far from any anchor point that it runs out of belt.

### Maslow4 electrical requirements:

Electrical: 120-240 volts, 50-60Hz, <1 Amp*

*See note above for international plug compatibility
### Maslow4 space requirements:

Maslow4 can attach to any flat rigid surface so there isn’t a defined amount of space that it needs. When packed up for storage Maslow4 is 350mm (14in) across and 280mm (11in) tall. If you connect Maslow4 to an existing shop floor or work bench it won’t take up any additional space. If you would like to build the frame shown in the video, that frame is 12' feet, by 2’ by 7’ tall.

# History (I don't know a lot here) 
 In ???? (Barbour Smith and ?people?) designed the first Maslow as a wall mounted CNC routing robot that hung from two chains and pulled itself back and forth across a space. The robot at that point was designed around an ?arduino? microcontroller and was an open source design. Barbour set up the forums and github groups and sold ??? machines. 

 It is still possible to make a Maslow Version 1, 2, or 3 and many people have been happy with them as useful tools. Makermade was a company that sold version ?2? under the open source license that is not affiliated directly with Maslow's developers. 

 The current version Maslow 4 was prototyped as 3D printed parts with standard hardware. It has four machine belts instead of two chains. The parts are not interchangable with earlier versions. It uses a custom printed circuit board PCB built around an ESP microcontroller. The board also incorporates motor controllers. 

 It is still possible to 3D print your own parts and replacement parts. It is still possible to design and program your own generic ESP microcontroller and use off the shelf motor controlers.  In ?2023? Barbour and ?? ran a succcesful Kickstarter campaign with which they used the proceeds to design and have injection molds made for injection molded parts and better compact custom PCBs. Injection molded parts are much stronger than most 3d printed parts.  This is what you are buying when you buy a Maslow kit. The custom PCB, the custom wires, the motors and custom made hardware, nuts and bolts,  and the injection molded plastics with fiberglass inclusions. 4.1 was the result of a second kickstarter campaign that upgraded the PCB, the nuts and bolts and other metal hardware as well as a better spool design. 

# Community members who have made significant contributions:
bar founder and primary developer

dlang ?Programming?

Ian_ab?Programming? 

# How to get involved

Maslow is a truly open source project. The forums are active with helpers and anybody can add to the discussions there or add to the project here in the github repo.  You can't mess things up here as final commits have to be checked. The creative community needs to share fun projects, fun adapatations of the robot and support frames, hacks and troubleshooting tips, programming fixes, and documentation.

/Firmware is edited and developed by volunteers, you can try too, the Github Maslow AI can be asked to change the programming. 

Three D Printing files and parts lists will soon be in the repo for downloading and editing or adapting

/docs holds documentation and instructions.  If you have a good idea to make things more clear or help other people understand the machine you could add something there

To edit a file here navigate to the file you want to edit, click on the little pencil in the top corner and it will open an editing window as a branch of the main repo. The pages are written in markdown language a kind of simple word processor. Markdown instructions are in a link at the bottom of the editing window.  Once you have edited the document you can commit changes and then make a pull request asking for it to be written back to the main branch.  

# Future of the project

Currently the focus is on making the Maslow4 run quickly and easily mostly through firmware development. Community members are playing with different 3d printed adaptations of the main parts as well as both larger and smaller frames. The goal would be to keep developing the software now and then have an updated hardware kit in several years. A sister project to Maslow is Abundance, which is working towards being an open source web browser based parametric cad system that could feed directly to Maslow.[ https://abundance.maslowcnc.com/](url) (written 2025) 

---
# MANUAL

# TABLE OF CONTENTS (you can alway jump to a section by clicking the OUTLINE button in the top right corner of the reading pane three dots and three lines) 
1. Things you will need to get started
2. Optional but good things to have
3. Safety and hazards
4. Forums and github
5. Build instructions
6. Tips for building 4, 4.1
7. Flowchart of user actions 
8. Details of optional upgrades
9. Routers lists and library
10. Router bits lists and library
11. CNC, CAD and CAM software lists and library
12. Material to cut lists and library
13. Frames and frame library
14. Connecting to the machine
15. Updating the Firmware
16. The Control panel and software
17. Other things you can control in the software.
18. Ancohors and calibration
19. Moving the robot around by jogging
20. G-code
21. Feed rates library
22. Test Cut designs and grids
23. Making a 2D design as a vector drawing .svg
24. Changing a 2D design into G-code .nc for cutting
25. Uploading G-code .nc to the machine
26. Fixing the work to the wasteboard
27. Inserting a cutting bit
28. Inserting a drawing pencil or pen (no idea how to do this)
29. Drawing with the machine
30. Preflight check
31. Cutting a 2D design
32. Designing a layered 2D design with mulitple depths
33. Preparing a layered 2D design as G-code
34. Cutting a layered 2D design with multiple depths
35. Switching cutting heads between operations
36. Designing a 3D sculpted surface design
37. Preparing a 3D sculpted surface design as g-code
38. Cutting a 3D sculpted surface design
39. Designing a 3D piece of furniture from multiple 2D panels
40. Abundance software
41. Paramaterized design for 3D
42. G-code for furniture
43. Cutting furniture.
44. 3D design as stacked layers
45. Cutting 3D as stacked layers
46. G-code for stacked layers of 3D designs
47. Other design methods
48. Including bushings and hardware in designs
49. Design library (perhaps one for parts of designs and one for full projects? )
50. Accuracy and precision
51. TROUBLESHOOTINg
52. Fun stuff

---

# Things you will need to get started
1.  **Maslow 4 or 4.1 kit** (link to store) Sometimes people also sell used ones on the forum.  As an open source project you could also print plastic and buy parts yourself. 
2.  **Router** The kit is built around the cylinder of the Dewalt dwp611 (or Dewalt D26200 in 240 volt) with its base removed.  It provides both the cutting power and the structural framework of the robot. It is possible to use other routers or spindles but you would need a shell to build it out to the dimensions of the dwp611.
3.  **Frame or anchors on a floor** to attach the belts to. A basic frame is roughly the size of a car parking spot or a bit bigger. Frames can be horizontal or up to 15 degrees from vertical so that the robot's weight pulls into the material. The current limit is anything less than 5 meters by 5 meters. It needs to be stable and not twist or warp  or lift when the Maslow pulls on the belts.  The frame also needs a replaceable waste board of material to support the projects as they are cut.  (link to frame design library)
4. **Cnc router bits** at minimum a 1/4 in Upcut spiral https://forums.maslowcnc.com/t/must-have-router-bits-for-maslow/19574/4
5. **CNC editing program**  There are many free or paid options.  Online there is Krabzcam, A free download is FreeCAD (check this), Any professional CAD/CAM software should work.  2D designs can be made in any vector drawing program such as Inkscape or Adobe Illustrator and then saved as an .svg.  3D designs can be made in Blender or a CAD program. The design then needs to be translated into instructions for the robot as a .nc G-code file.  Krabzcam or the other cad software can do this.  Cutting files are based on the type of material, the rpm of the router, the type and depth of cut needed, and the shape and size of the cnc router bit. Abundance is a parameterized CAD/CAM program in development that is part of the Maslow experiment that runs with a Github account. 
6. **Flat material** to cut. The machine was desgined for 4x8 foot sheets of plywood. It can work bigger or smaller. People have had success with plywood, oriented strand board OSB, particle board, plastics, and styrofoam, from 1mm to 30 mm thick (check)
7. **Wifi network or USBC cord.**  The machine is designed to connect to a local or home wifi network that you then also connect a computer or phone to open a local web page that controls the robot. It can be directly controlled with a USBC cord, or directly connected to your computer as its own wifi source. Updates are done by downloading the file to your computer from the Github repository and then uploaded to the Maslow locally.
8. **Torx 20?  Screwdriver**  One is generally included in the kit but more is good.

---

# Optional but good things to have
Many of these are available in the not shop on the Maslow website. 
1. 3D printed **button pushing insert** to make it much much easier to insert and remove router bits
2. **Dust control** vacuum system. Starting with a 3D printed nozzle adapter for the machine and then a hose (antistatic is good) and dust collection vacuum system.
3. **More CNC router bits** 1/8 in straight flute, Pointed engraving tip, rounded hollowing bit, things that make sense for your projects.
4. **Collet adapter** for 1/8 in shaft router bits
5. **Cord**, wire, and vacuum hose **control system** so that the connections don't pull on the machine too much.
6. **A way to hold the material in place while cutting**. Rug no slip fabric or double sided tape or brass screws or wood chocks or a vacuum system or....   Depends a lot on your material and setup. Don't use steel screws anywhere near your cutting area or the blades will colide with them.
7. **Metric meausring tape**
8. **Emergency Stop Button**  Extension cord with a clearly marked button for turning off power to the router and robot. 
9. **Handle** for moving the machine (?Best practice?
10. **Router Speed Controller** Extension cord that varies the voltage to the router. Check power rating and suitablility for your router. The Dewalt already has a speed control dial at the top of the router. 

---

# Forums and GitHub
  Maslow is an open source project mainly guided by a few dedicated people but as an open source project it is also a community of enthusiasts who help each other, build new funcitons and could even fork the project to go in a new direction or a paralell development. 

  **When you make a Maslow you are not alone**, the **forums** are the places to look for wisdom, ask questions and ask for help, get and share project ideas propose and develop new functionality and celebrate successes. As a community it is imporant to be polite, to be gentle with criticism and mostly just help if you can. 

You can read forums without an account but to comment or ask questions you will need an account. 

Click on the M logo on the top left to get to the overall list of topics. It is good to search first for a thread to add to in case your question or comment is already under discussion.  If you don't see something relevant then you can make a new topic.  Try to tag the topic with categories to help others find it and understand what you are discussing. 

    (link to forum) 
    (list of main topics) 

Click on your circle and name in the top right to see what activity has been connected with you and your discussions.  You can have a public topic, like and boost converstions with hearts, and send private messages with the mail funciton.  As you become more involved the automatic forum robot will send you messages giving you more priveleges, helpful training, and badges for forum actions as you figure them out. 

 **Github** is the technical knowledge repository where Maslow is stored and new versions and functions are developed. It is also where as a new user you will download the firmware files.  It is also where Abundance, Maslow's sister project of paramaterized CAD/CAM is being deveoped.  You can download the firmware files and manual there without an account but to participate or use Abundance you will need to create a github account. Github was designed for computer programming projects but can hold other things. Github has a resident AI called copilot primarily designed for computer coding which can help you to make contributions. 
    (links and instructions to find Maslow's stuff in Github) 

# Safety and hazards
Power tools are inherently powerful and can be dangerous.  This is an open source project created and maintained by amatuer enthusiasts with designs that have not been tested or evaluated for safety. Follow any instructions here at your own risk and using your own judgement.  The authors of this project make no claims about the saftey or suitability of the designs, ideas, or instructions. Any safety advice is provided in good faith. Use and modify the information in this project at your own risk. 

Below is a list of common sense hazards for you to consider

## Hazards may include:
- **Electrical shock or fire** if used in a damp or wet area or if electrical insulation or protective covering is damaged or removed. Always check your wires, connections and PCB cover for damage. Make sure airflow to the machine is not blocked or restricted. Different routers and spindles will require different airflow. Do not leave the machine unattended while it is in use. Have a plan to cut power to the machine in an emergency. 
- **Dust inhalation and dust fire**. Routers create dust and heat as blades cut through material.  Evaluate the material you are cutting and take dust mitigation measures including working in the open air, using dust vacuum systems, dust masks and appropriate respirators.
- **Friction fire hazard.** Blades create heat through friction, this can cause material being cut or other nearby items to ignite, smoke, or smolder. This is especialy dangerous when a power tool gets stuck in one place or bound up in the material being cut. While the machine is running do not leave it unattended and test and evaluate the material being cut and the feed rate, moving speed, and rotational speed for suitablility for each job. Materials may produce fumes while being cut. 
- **Laceration, burns, pinching, and crushing**. Never touch the blade of a router without saftey measures. Router bits are very sharp and will be hot after use. The motors and belts can entangle hair or loose clothing and fingers or other body parts could be pinched or torn while the machine is moving. Care has been taken in the design to minimize these risks.  Keep clear of the the machine while motors are engaged. Make sure both the router and the control board are unplugged and off before changing bits or touching the machine.
- **Eye, skin, or equipment damage from backlash or flying debris**.  Spinning power tool blades can throw pieces of themselves or cut material at great speed. Robotic motors put belts and parts under strain which can result in breakage and pieces being thrown with speed. Wear eye protection at all times when the machine is running and only use the machine in a controlled environment where bystanders are protected from flying debris. Do not leave the machine unattended.
- **Hearing Damage**. Routers and robots can easily exceed safe noise thresholds while running. Wear appropriate hearing proection while the machine is in use.

## Overall saftey meaures
- Regularly check your machine  for evidence of wear or damage.
- Only use in a safe and controlled space. 
- Do not leave the machine running unattended.
- Use personal protective equipment including masks, respirators, gloves, hearing protection,  and eye protection. 
- Do not touch the machine while it is moving or turned on.
- Have a fire suppression plan and equipment.
- Consider how you will cut power to the machine in an emergency.
- Check for loose parts, tools, keys, and if the blades are in an appropriate place before providing power to the machine. 
- Train yourself and anyone who will come in contact with the machine on your saftely plan. 

CNC routers are nice in that they may be operated at a greater distance than a handheld router.  Many of the vibration, inhalation, and flying debris dangers are less with a robotic controler.  CNC machines are dangerous when people leave them unattended and beacause there are more motors, more electrical connections, and more moving parts. 

  ---
    
# Building instructions for 4, 4.1
Find any of these steps confusing or get stuck? Don’t forget, you aren’t alone! Maslow is a community driven open source project. Ask in the [forums](https://forums.maslowcnc.com/) and we’ll figure it out together!

The Maslow4 interface is still evolving rapidly and will continue to change. This guide will be updated regularly, but you still might notice some small differences between the guide and what you see. 

Maslow4 is an open source project. Pull requests to change or improve the firmware are very very very much welcome and appreciated. If you don’t feel comfortable editing the software yourself you can still make a hugely meaningful contribution by telling us how it could be better in the [forums](https://forums.maslowcnc.com/). Sometimes the hardest part of making something better is figuring out what to change. If you can find a way to make the software simpler to use and better share it!

**This section is a Quick Start Software Guide followed by the build instrucitons**

## Quick start Software guide
This is to get you set up for the first time, there is more detailed information on each of these topics elsewhere in the manual. 

 ## This part of the guide will contain the following sections: 
 
1. How to connect to your Maslow4
2. How to update your firmware
3. How to connect Maslow4 to your home WiFi network (optional)
4. How to run the calibration process
5. How to move the machine around
6. How to define the machine's home position
7. How to run a g-code file
    
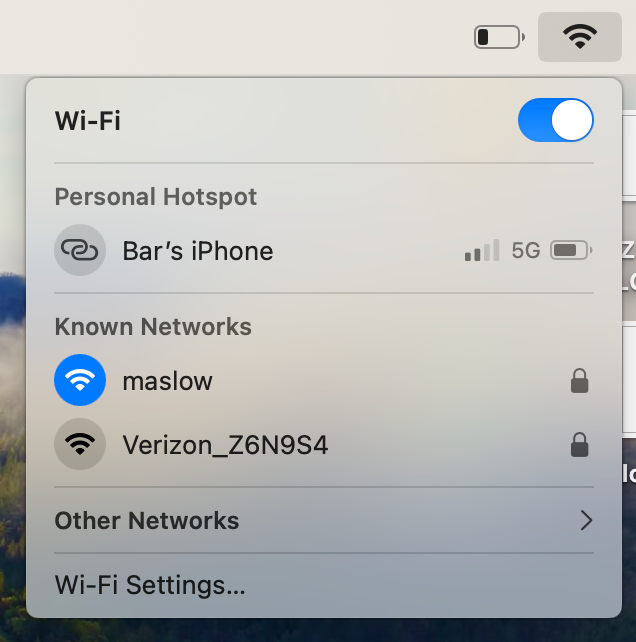
[picture p150: assets/MaslowCNC_Wisdom_Manual-assets/image_bc8b8ef8.png]


## How to connect to your Maslow4

Maslow4 is controlled using a built-in interface accessible from your web browser. You can connect to Maslow4 from any Windows, Mac, or Linux computer or iOS or Android tablet or phone. You do not need to install any software. 

Maslow4 will create a wifi network called **“maslow”** which you can connect to. The default password for this network will be **“12345678”**.

Connecting to the network will automatically open the user interface on most devices. If it does not you can type **192.168.0.1** into your web browser to open the interface. You may need to look up the exact numerical address for your machine in your home router admin settings.  

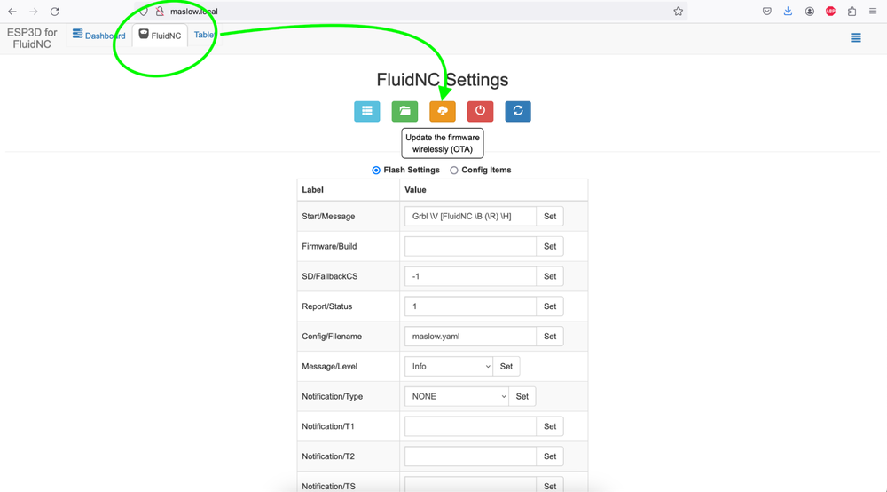
[picture p151: assets/MaslowCNC_Wisdom_Manual-assets/image_54a3429f.png]


## How to update your firmware:

Maslow4’s firmware is improving regularly.

Luckily updating the Maslow4 firmware is easy. 

To update Maslow4’s firmware click on the FluidNC tab at the top of the screen, then click on the Update the Firmware button, and select your new firmware file.

You can always find the latest firmware version at 

https://github.com/BarbourSmith/FluidNC/releases

There will be 3 files that you need to download, firmware.bin, index.html.gz, and maslow.yaml. When you download the files, make sure your computer does not change their name. You must change the name back if this happens.

Note: When you first connect to Maslow it will create a popup to control the machine. On some devices you cannot upload files from within that popup (the window won’t open). The solution is to connect to Maslow from a regular browser window.

**Note that to update from a firmware version before 1.0 to a version after 1.0 you will need to use a USB cable. There is a video walkthrough for that process here.** https://youtu.be/od7DpdLel6A?si=xv1Zp3AIZFgRoeZ_

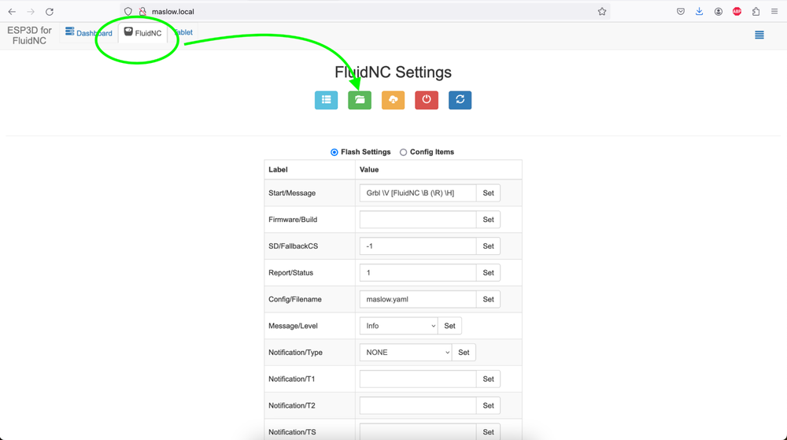
[picture p152: assets/MaslowCNC_Wisdom_Manual-assets/image_62cc4555.png]


There are two other files which you will need to update periodically. These can be found by clicking on the FluidNC tab and then clicking on the files button.

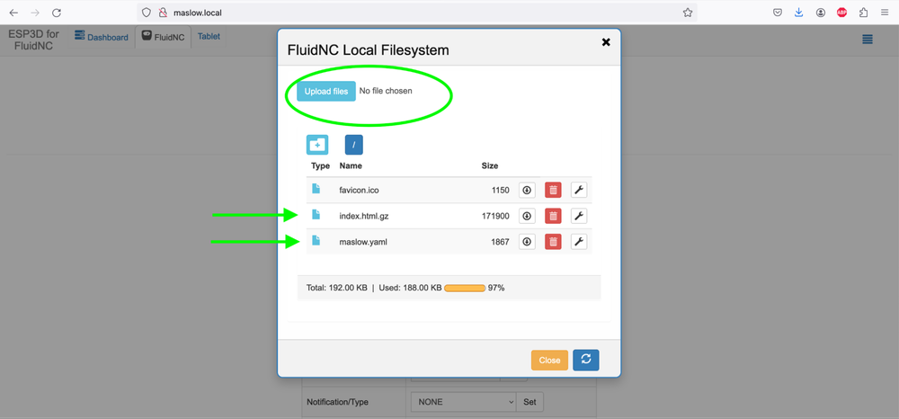
[picture p153: assets/MaslowCNC_Wisdom_Manual-assets/image_19b16055.png]


This will show you your system files.

To upload a new file click the **Upload files** button at the top of the screen. If a file with the same name already exists it will be replaced.

**index.html.gz** controls how the machine interface looks. If you wanted for example a dark mode, replacing this file would give the interface a new look. I expect that there will be a number of community created UI options created quite quickly.

**maslow.yaml** contains the configuration settings for your machine. Your calibration values are stored here. You may not need to update the yaml each time you update the index and the firmware.

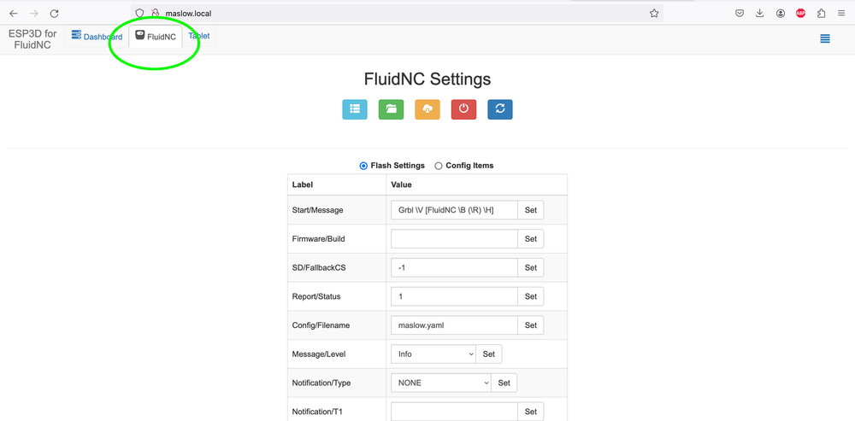
[picture p154: assets/MaslowCNC_Wisdom_Manual-assets/image_c3eca3b6.png]


## How to connect Maslow4 to your home WiFi network

If you have an internet connection in your work space, it might be nice to connect Maslow4 to your existing WiFi network so your computer can stay connected to the internet and Maslow at the same time.

To connect your Maslow4 to the internet click on the **FluidNC** tab

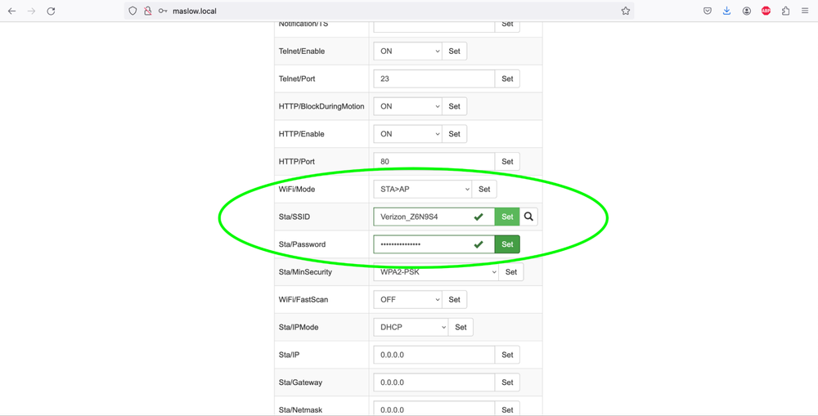
[picture p155: assets/MaslowCNC_Wisdom_Manual-assets/image_0707784f.png]


Then scroll down to enter your WiFi network name in the **Sta/SSID** field and your network password in the **Sta/Password field**, then press set next to each field. You will need to restart your machine for the changes to take effect. 

When your Maslow4 turns on it will attempt to connect to your WiFi network. If it is not able to find your network it will create a wifi network called “maslow” for you to connect to.

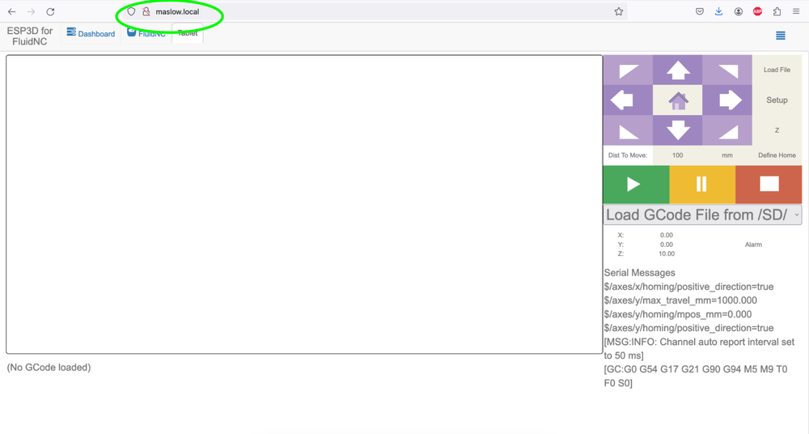
[picture p156: assets/MaslowCNC_Wisdom_Manual-assets/image_0e4c67d3.png]


Once Maslow4 is connected to your wifi network you will need to find its address to connect to it. We were concerned about this working reliably on everyone’s networks so we have created three ways to do this so there is redundancy. 

The easiest way to connect to your Maslow4 on most modern wifi routers is to copy and enter the address **maslow.local** in your internet browser. 

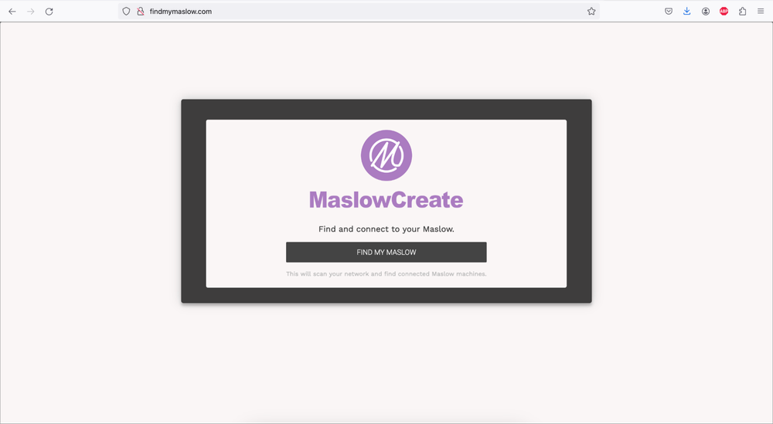
[picture p157: assets/MaslowCNC_Wisdom_Manual-assets/image_504a3129.png]


If that doesn't work, you can use the website findmymaslow.com to find the IP address of your machine. Unfortunately due to some (frankly prudent) security updates to Chrome this will only work in Firefox.

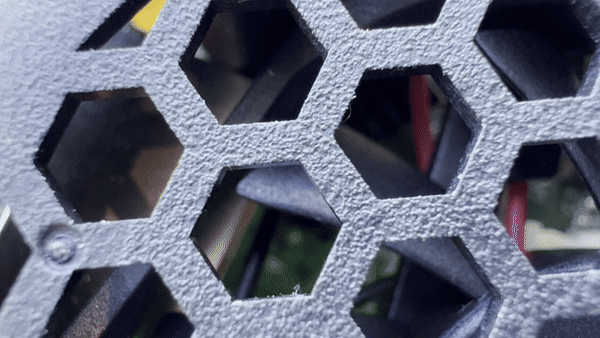
[picture p158: assets/MaslowCNC_Wisdom_Manual-assets/image_e963c899.png]


Finally if all else fails, the blue LED on your Maslow4 will blink out the IP address so with a pen and paper you can count the flashes and write the number down. It’s not plan A, but it’s low tech and reliable. 

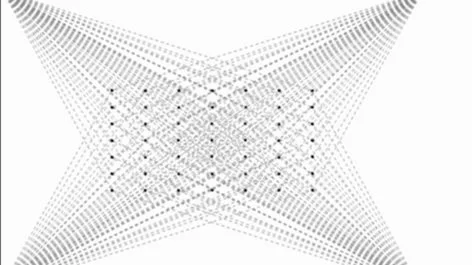
[picture p159: assets/MaslowCNC_Wisdom_Manual-assets/image_086357d4.png]


## How to run calibration:

You only need to run the calibration process once when setting up a new frame. 

Before beginning the calibration process we recommend starting with the machine off and turning it on. This will ensure that we all start from the same place.

<iframe width="533" height="300" src="https://www.youtube.com/embed/mQwz0omOKJc" title="Maslow Calibration Walkthrough 1.05" frameborder="0" allow="accelerometer; autoplay; clipboard-write; encrypted-media; gyroscope; picture-in-picture; web-share" referrerpolicy="strict-origin-when-cross-origin" allowfullscreen></iframe>

These instructions can be somewhat confusing to follow so we made a video walk through of the current calibration process which you can also follow.

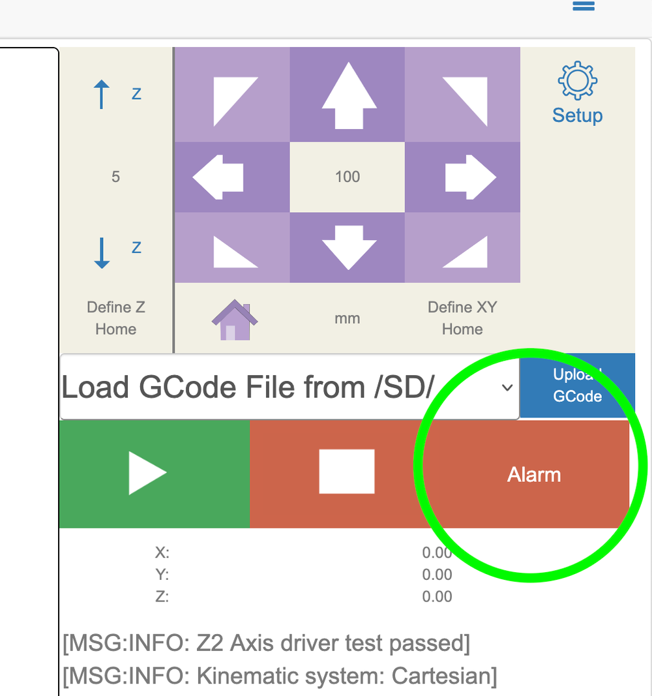
[picture p160: assets/MaslowCNC_Wisdom_Manual-assets/image_df7e3813.png]


First click on Alarm to unlock your machine

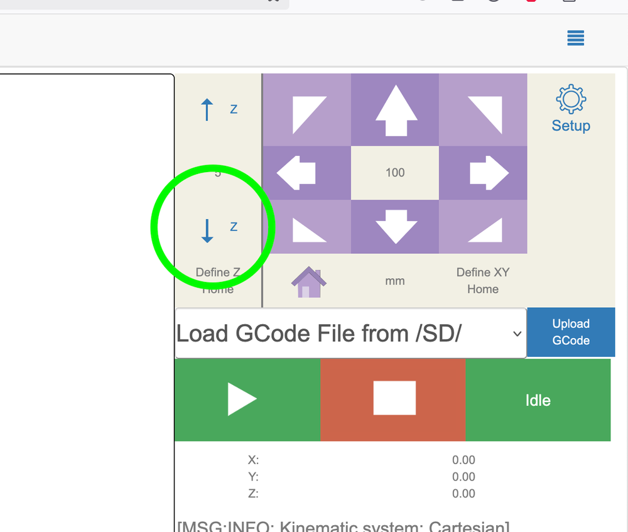
[picture p161: assets/MaslowCNC_Wisdom_Manual-assets/image_0235efce.png]


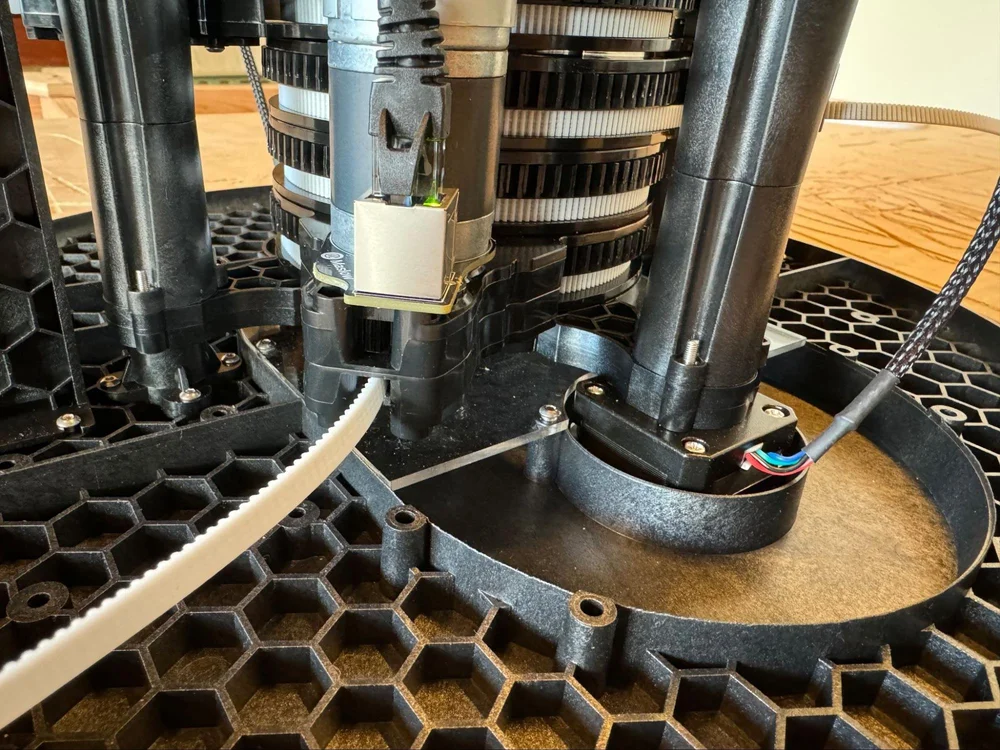
[picture p162: assets/MaslowCNC_Wisdom_Manual-assets/image_3a47a416.png]


Next, using the z-axis controls lower your z-axis all the way down until you hear it stop. Note that you want to remove any router bit before doing this.

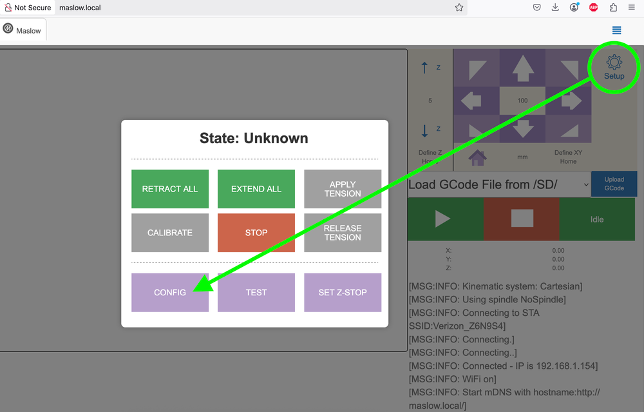
[picture p163: assets/MaslowCNC_Wisdom_Manual-assets/image_0d56b548.png]


Click Setup and then config

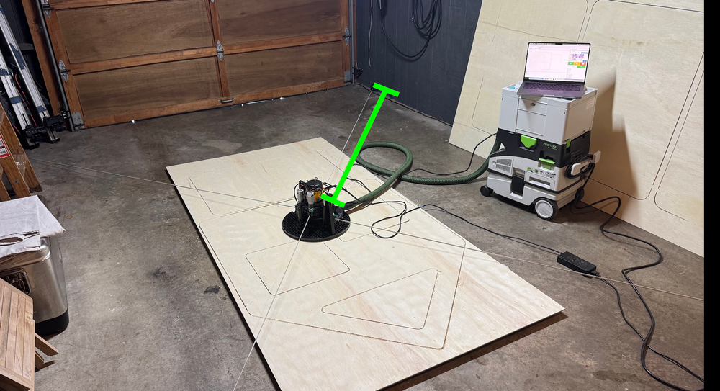
[picture p164: assets/MaslowCNC_Wisdom_Manual-assets/image_73fb48a5.png]


Make a rough measurement or guess at how far it is from your anchor points to the center of your frame in millimeters.

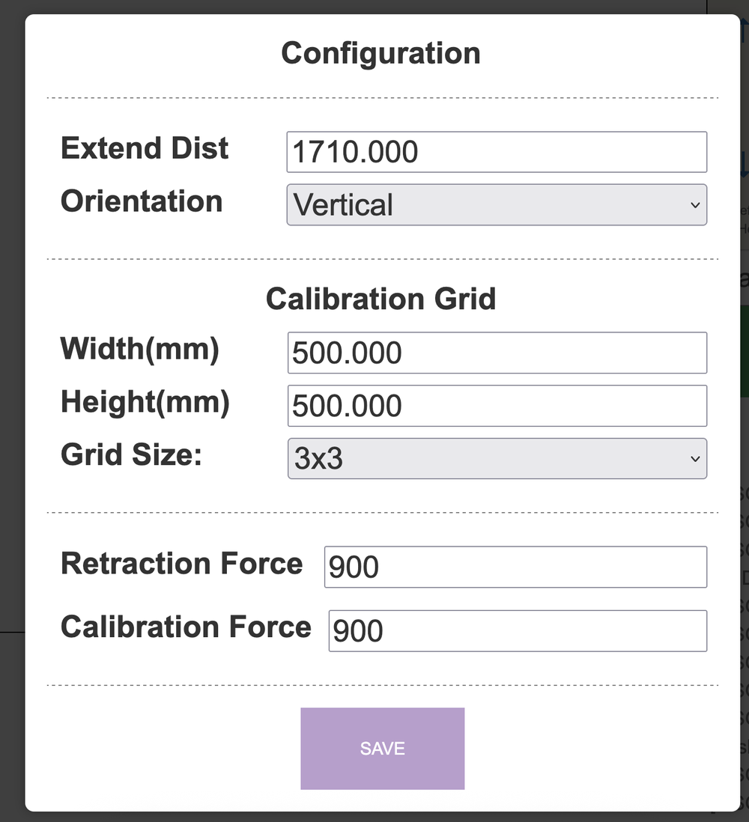
[picture p165: assets/MaslowCNC_Wisdom_Manual-assets/image_29610fc9.png]


Enter the distance you came up with into the “Extend Dist” field

Here you can also select your other calibration settings.

**Orientation**: Horizontal orientation is flat on the floor, vertical orientation is upright against the wall

**Calibration Grid Width / Height**: These parameters set the size of the calibration grid. The sled will move to these points during the calibration process so they should fit entirely inside the area that the sled can safely move within. Smaller grids are faster and easier, but larger is potentially more precise.

**Grid Size**: This is how many measurement points the machine will use to compute the calibration. More is slower but also potentially more accurate. 

**Retraction Force**: This is how hard the machine will pull when retracting the belts for storage and when taking each measurement during calibration. Increase this number if you are having trouble getting all of your belts to retract reliably or if calibration measurements are inconsistent. This indirectly sets the tension in the machine's belts while cutting. It seems like lower values might lead to more precise results, but it can't be so low that the process doesn't take accurate measurements or that the belts fail to retract fully. Turning it up too high can be hard on the machine.

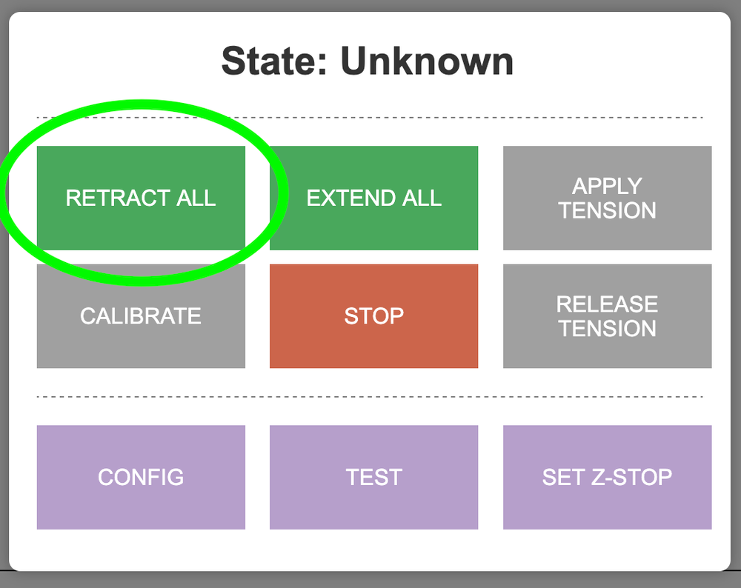
[picture p166: assets/MaslowCNC_Wisdom_Manual-assets/image_1a664a68.png]


Next click on Setup and then on Retract All. 

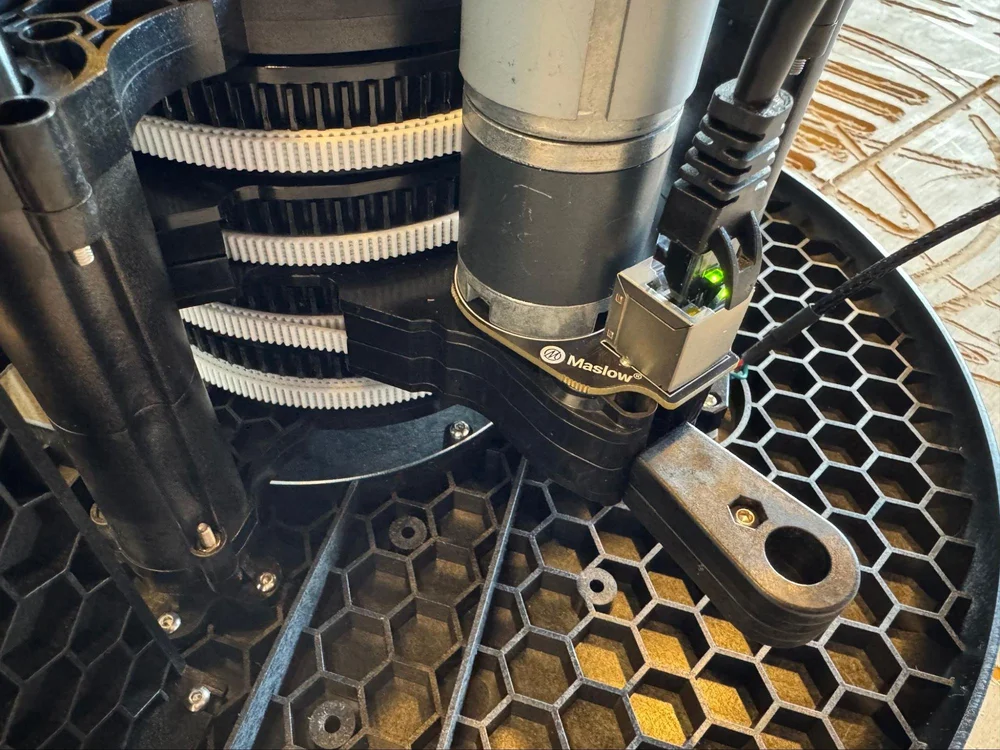
[picture p167: assets/MaslowCNC_Wisdom_Manual-assets/image_6f73e5e9.png]


This will fully retract all four belts.

Note that if some of your belts don’t fully retract you can retract and extend them a few times to help loosen them up, or you can increase the amount of power used during retraction in the configuration settings.

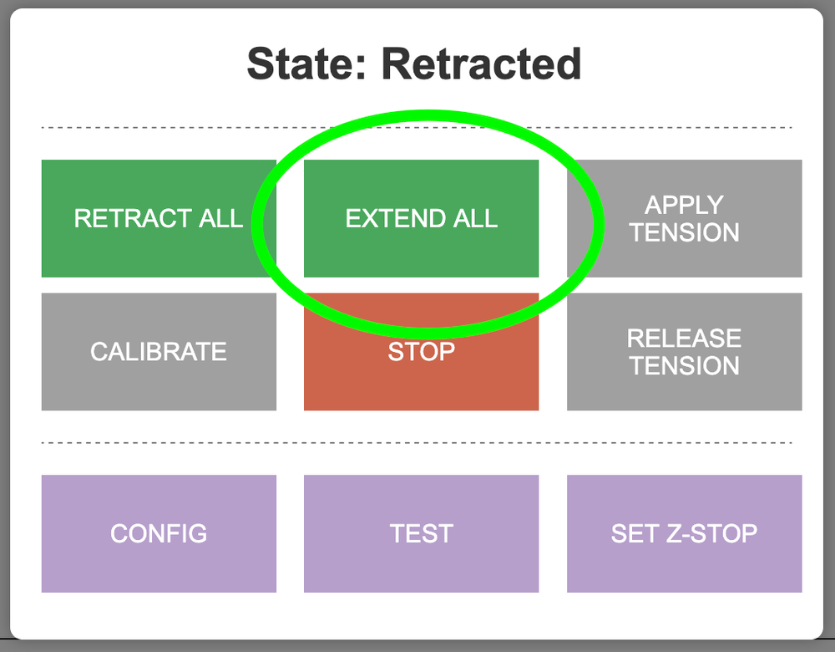
[picture p168: assets/MaslowCNC_Wisdom_Manual-assets/image_6b4a295f.png]


Next press **Extend All** to begin extending the belts. You will hear the cooling fan turn on.

You want to keep extending all four belts until they stop. The machine will stop extending more belt once they have reached the target length.

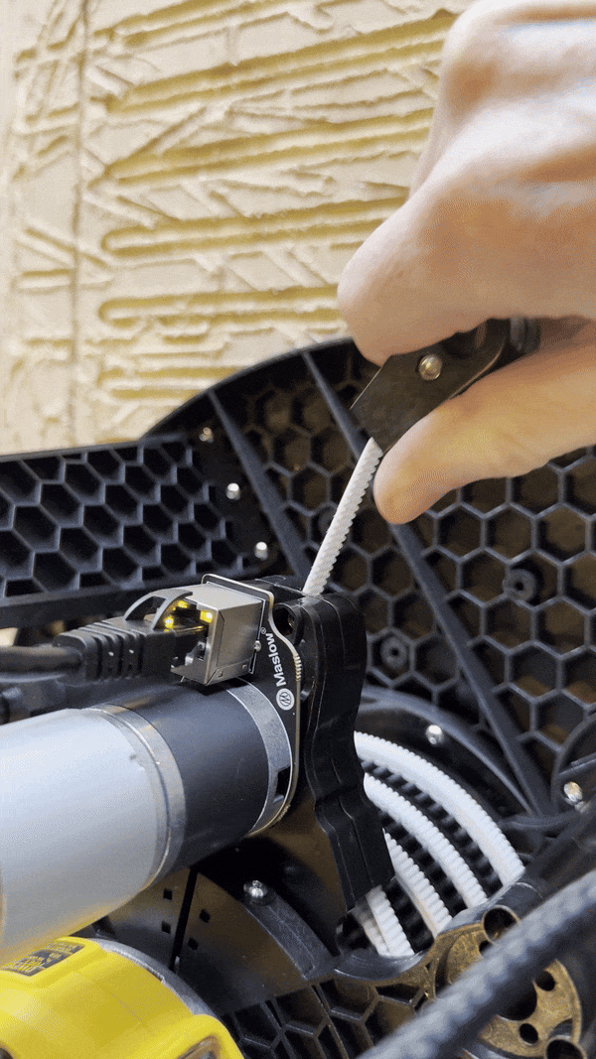
[picture p169: assets/MaslowCNC_Wisdom_Manual-assets/image_3c156185.png]


To extend the belts you will need to pull them out. A rocking motion will help get them started extending. You might need to be a little aggressive. After they will extend out to the correct length as long as you pull with a gentle but constant force. 

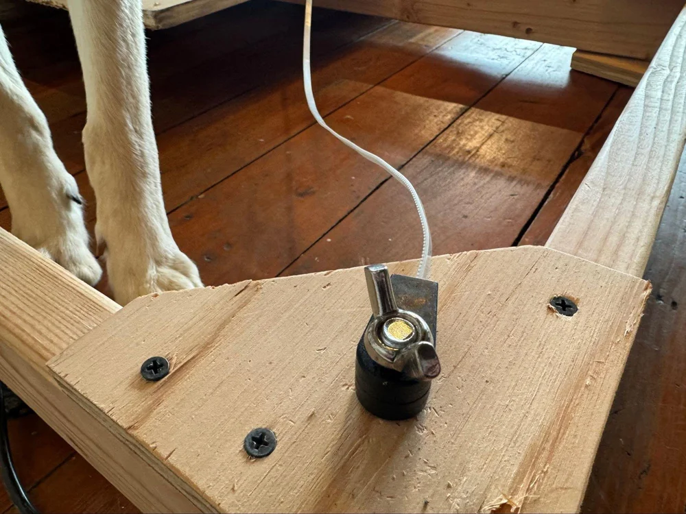
[picture p170: assets/MaslowCNC_Wisdom_Manual-assets/image_2a5be063.png]


Attach all four belts to the frame. This might look different depending on your frame design.

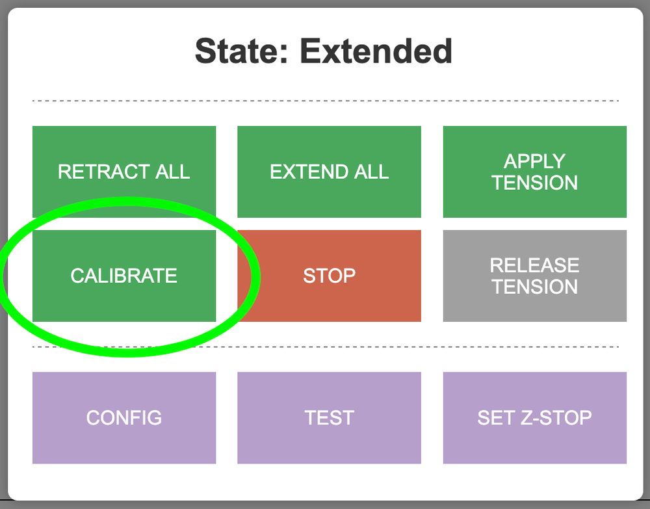
[picture p171: assets/MaslowCNC_Wisdom_Manual-assets/image_099e4067.png]


Press the calibrate button to begin the calibration process. The machine will move to each point in your grid taking a measurement at each one.

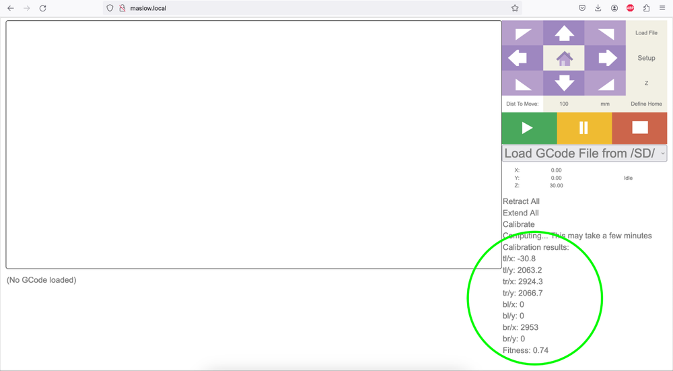
[picture p172: assets/MaslowCNC_Wisdom_Manual-assets/image_12d294f4.png]


Multiple times during this process the machine will stop and recompute it’s anchor points. Be sure to keep your computer awake and connected during this process. The walk-through video above can give you a more clear understanding of what the machine is doing at each step.

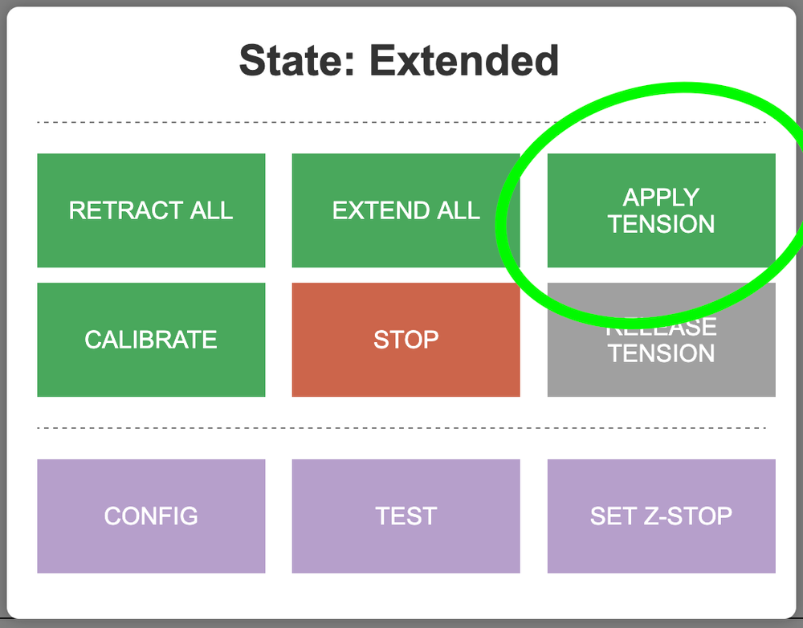
[picture p173: assets/MaslowCNC_Wisdom_Manual-assets/image_6f7deeb4.png]


That’s it, you are finished with the calibration process. From now on you do not need to do it again unless you change your frame’s dimensions. From now on if you disconnect your Maslow from the frame and want to re-attach it you can press **Retract All -> Extend All**, extend the belts and use the **Apply Tension** button to take up the extra slack.

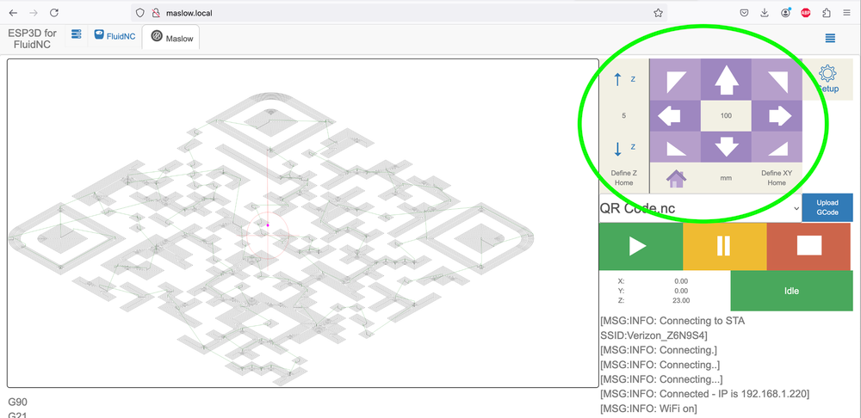
[picture p174: assets/MaslowCNC_Wisdom_Manual-assets/image_7e66623f.png]


## How to move the machine around

You can move your Maslow around using the arrow buttons on the right side of the screen.

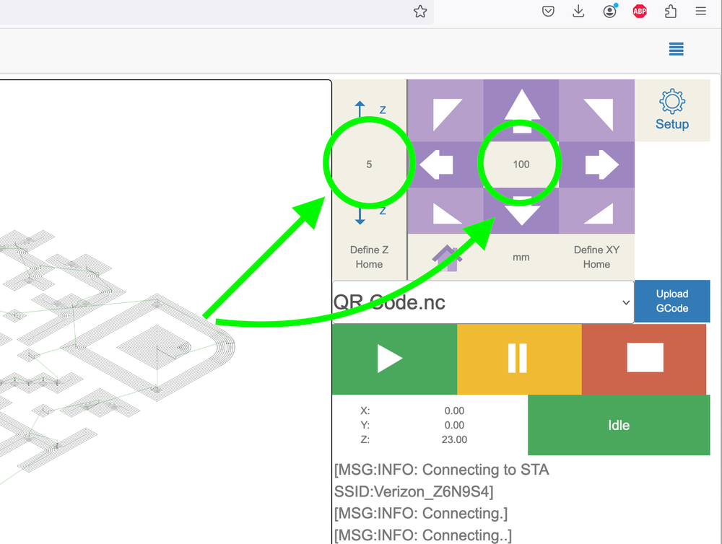
[picture p175: assets/MaslowCNC_Wisdom_Manual-assets/image_f30cbb3b.png]


The distance that it will move can be set by clicking on a distance number.

There are separate distances for XY movements and for Z axis movements.

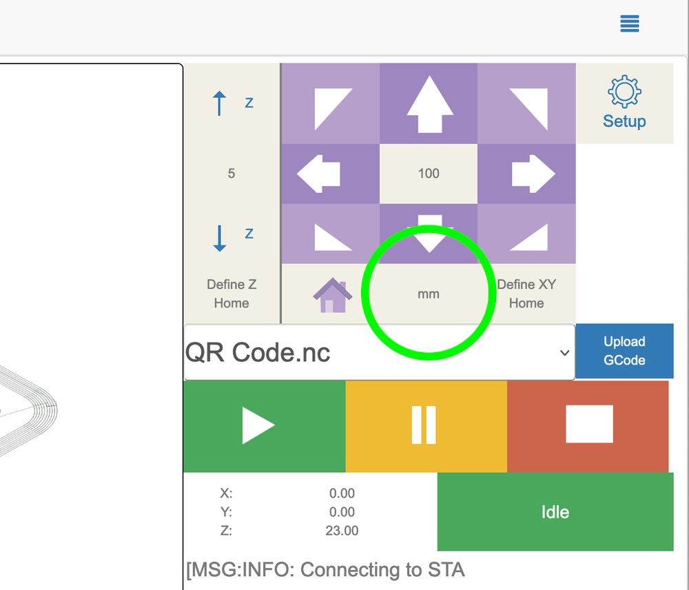
[picture p176: assets/MaslowCNC_Wisdom_Manual-assets/image_c3a41655.png]


You can switch between mm and inches by clicking on the units.

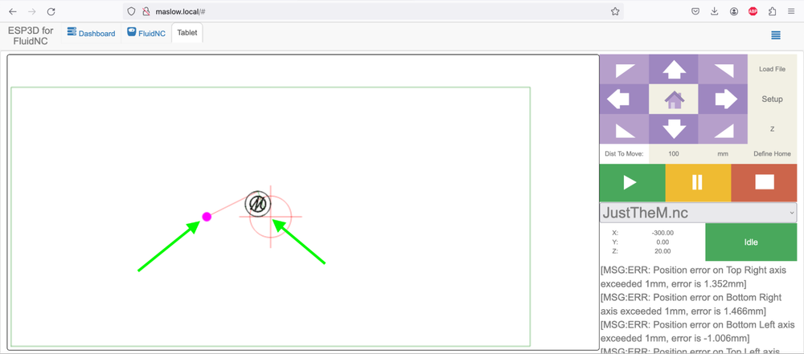
[picture p177: assets/MaslowCNC_Wisdom_Manual-assets/image_b708d8dc.png]


## How to define the machine’s home position

When you create a gcode file it will have a “home” position. Here you can see the home position shown with a cross in a circle. In this case when we created our gcode file we set it up so our shape would be cut above and to the left of the home position. The current position of the machine is shown with a purple dot.

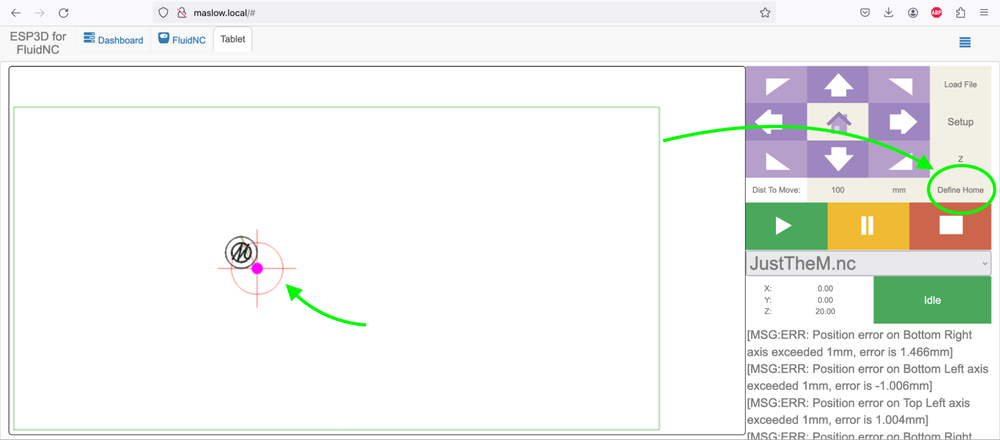
[picture p178: assets/MaslowCNC_Wisdom_Manual-assets/image_5f463bd4.png]


If we want to move where the file will be cut on the sheet of plywood we can press the “**Define Home**” button which will move the file’s home position to the machine’s current position letting us move the shape we want to cut anywhere on the sheet.

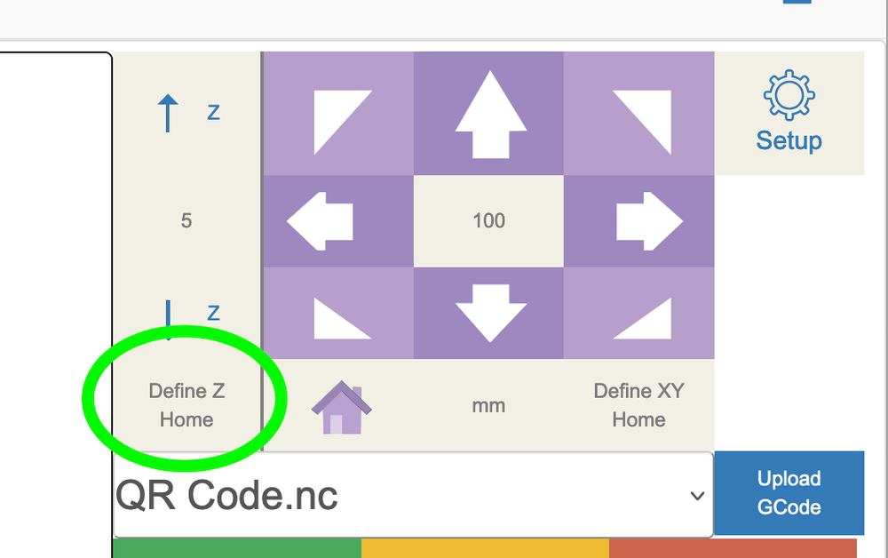
[picture p179: assets/MaslowCNC_Wisdom_Manual-assets/image_f1cf57bf.png]


Similarly we can set where the home position is for the z-axis. This will set where the router will start cutting which is typically on the top surface of the plywood. To set the home position for the z-axis click move the z-axis up or down with the **Up** and **Down** buttons. Then press **Define Home** to set the z-axis home position.

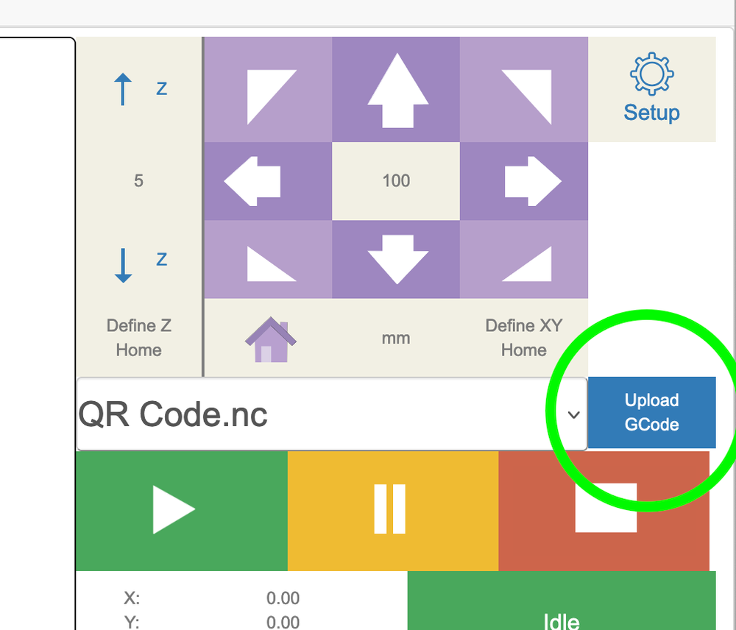
[picture p180: assets/MaslowCNC_Wisdom_Manual-assets/image_d0058dc9.png]


## How to run a gcode file

Load your gcode file onto the machine by pressing the **Load File** button

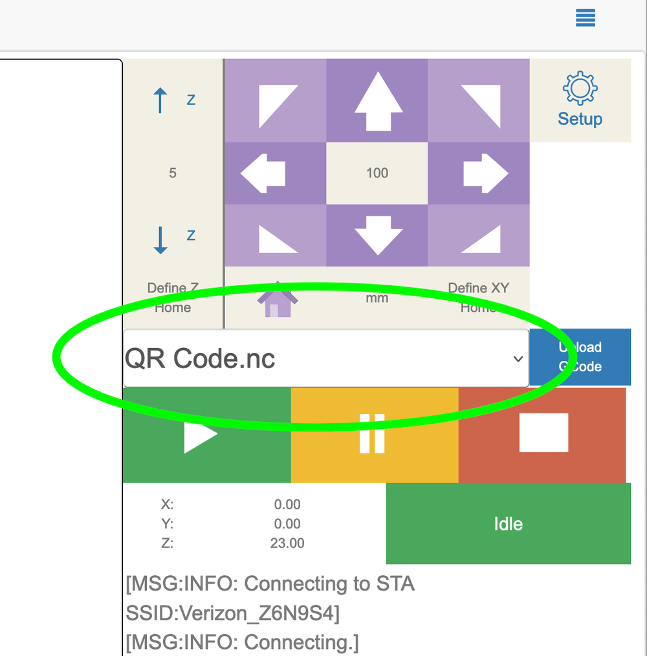
[picture p181: assets/MaslowCNC_Wisdom_Manual-assets/image_ba4e14ad.png]


Select your file from the drop down

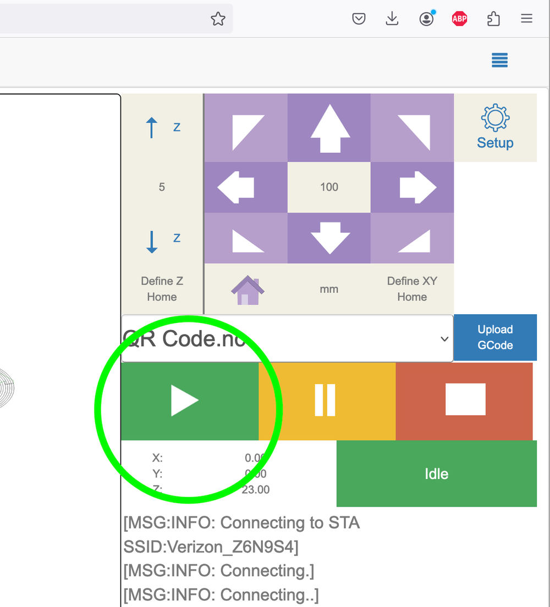
[picture p182: assets/MaslowCNC_Wisdom_Manual-assets/image_d58d5134.png]


Run the file by pressing the green play button.

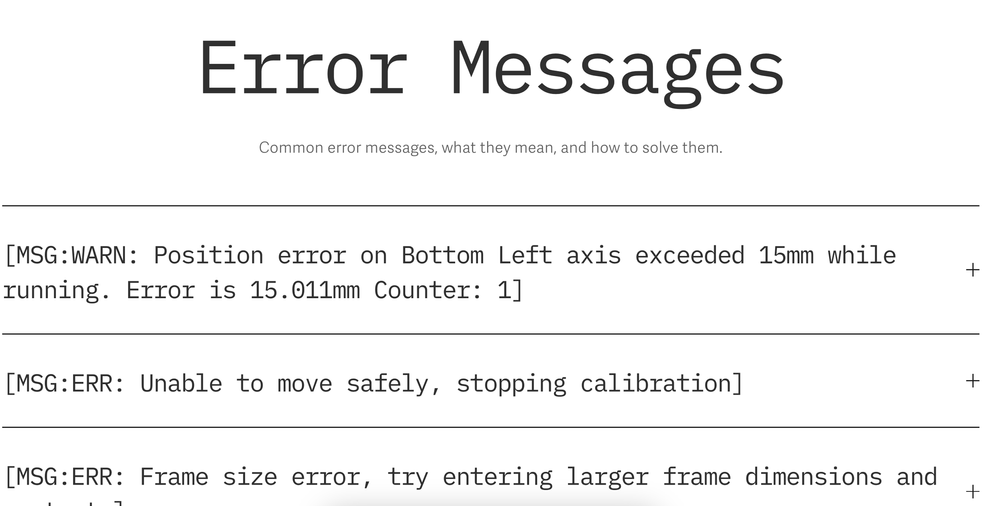
[picture p183: assets/MaslowCNC_Wisdom_Manual-assets/image_29649372.png]


## Troubleshooting

Any time you build a robot, there’s going to be some debugging involved. If you get any error messages you can find a full list of what they mean and what to do about them here.
https://www.maslowcnc.com/error-messages

We are also available to help in the forums!
https://forums.maslowcnc.com/

# End of the fast start software guide. 

---

# Maslow 4 parts then Maslow 4.1 parts

## What’s in the Maslow4 Kit?!

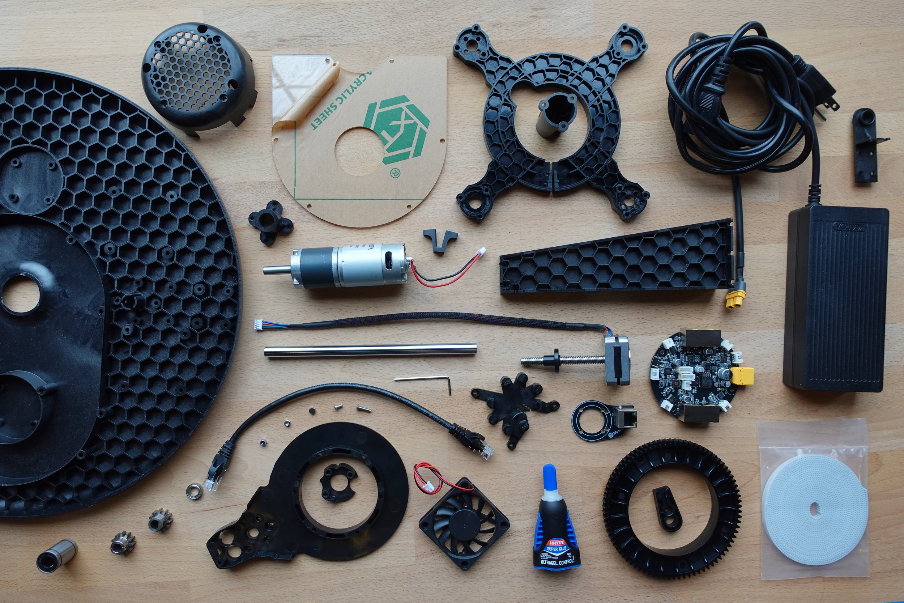
[picture p184: assets/MaslowCNC_Wisdom_Manual-assets/image_0522ec66.png]


Click links below to Download Printable pages. Thanks to our backer Craig for making these files.

https://www.maslowcnc.com/s/Whats-in-the-Kit_-Page-1.pdf
https://www.maslowcnc.com/s/Whats-in-the-Kit_-Page-2.pdf
https://www.maslowcnc.com/s/Whats-in-the-Kit_-Page-3.pdf
https://www.maslowcnc.com/s/Whats-in-the-Kit_-Page-4.pdf
https://www.maslowcnc.com/s/Whats-in-the-Kit_-Page-5.pdf

Five Axis Control Board. Quantity 1. Properties: Four servo axis, one stepper axis (dual drive), four ethernet encoder ports, two AUX ports, one fan control port. Wifi, bluetooth, USB C.
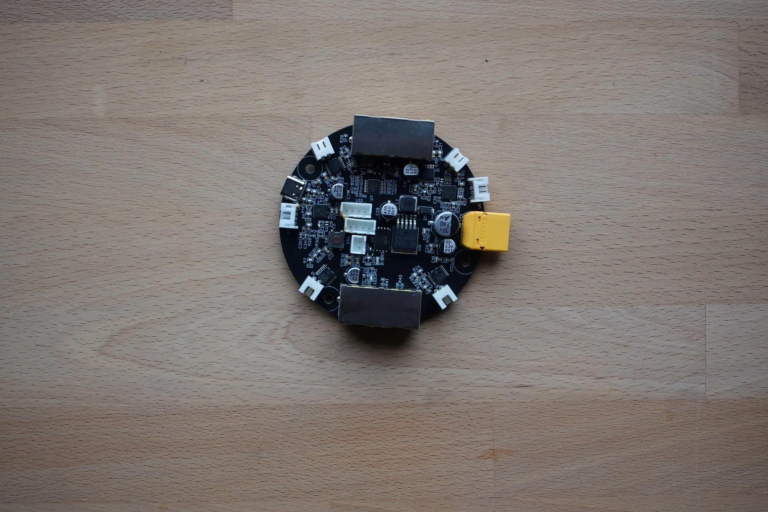
[picture p185: assets/MaslowCNC_Wisdom_Manual-assets/DSC00166_002.webp]


Magnetic Encoder Board. Quantity 4 Properties: AS5600 magnetic encoder with ethernet interface.
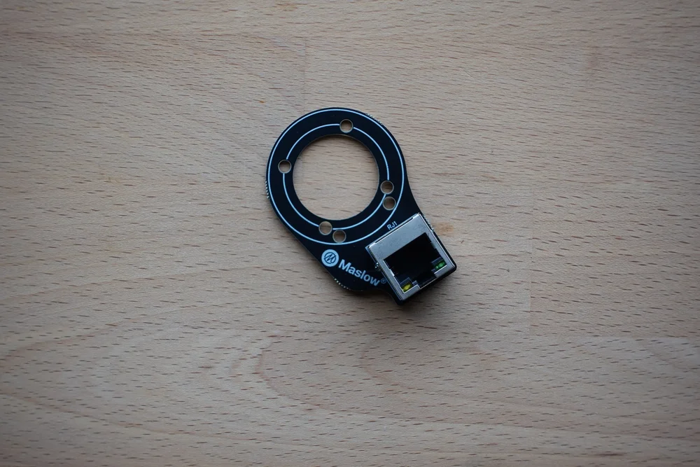
[picture p186: assets/MaslowCNC_Wisdom_Manual-assets/DSC00168.webp]


Cooling Fan. Quantity 1. Properties: 60mm, brushless.
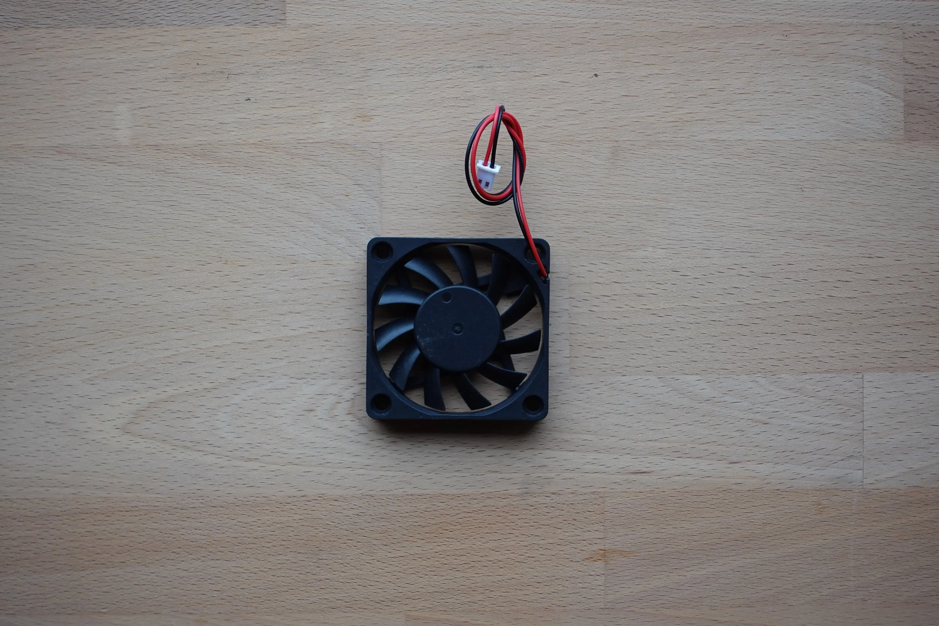
[picture p187: assets/MaslowCNC_Wisdom_Manual-assets/DSC00157_008.webp]


Power Supply. Quantity 1. Properties: UL listed, 120-240 volts, 
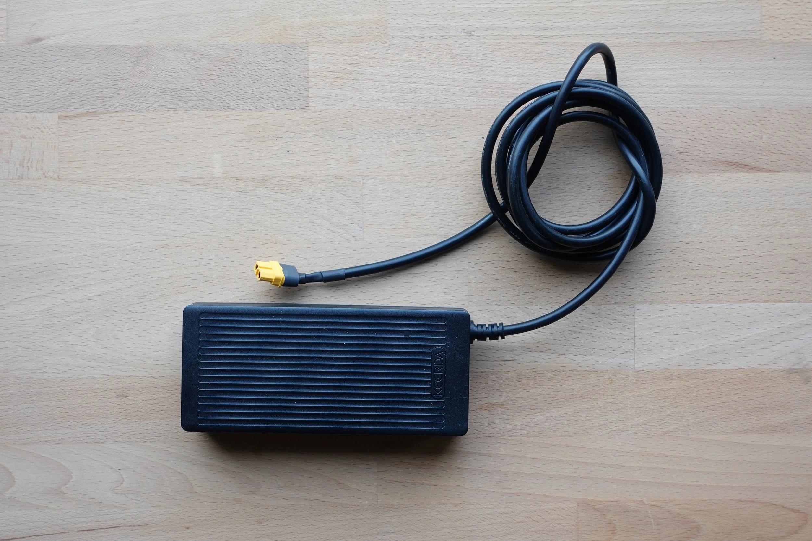
[picture p188: assets/MaslowCNC_Wisdom_Manual-assets/DSC00141_002.webp]


Standard NEMA computer cord plug, US plug cord provided.
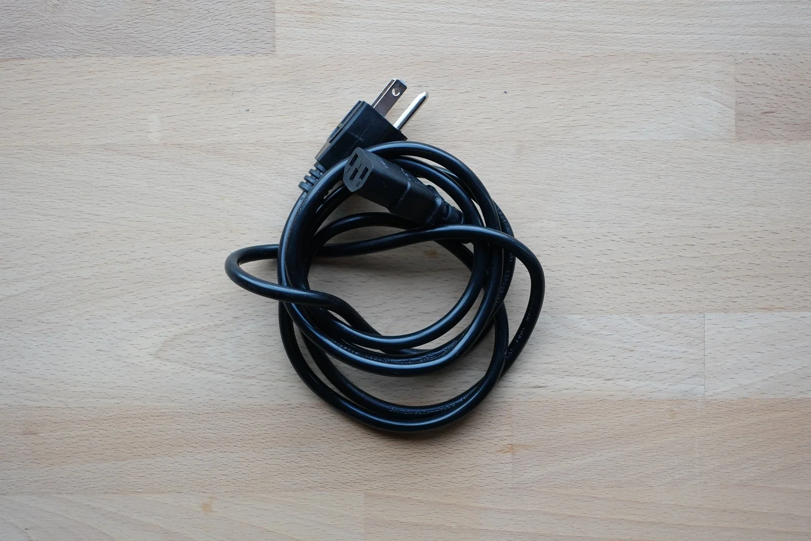
[picture p189: assets/MaslowCNC_Wisdom_Manual-assets/DSC00138_002.webp]


Ethernet Cable. Quantity 4. CAT5e, 310mm long.
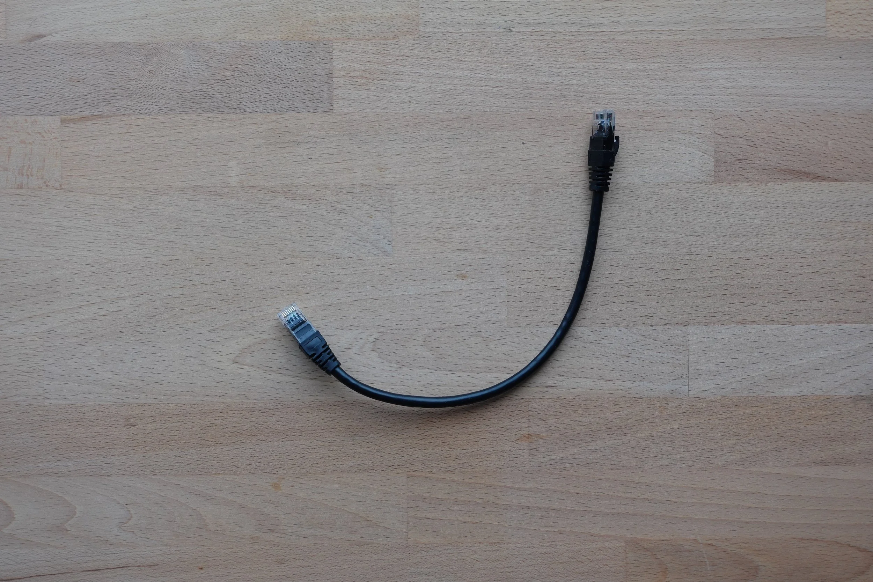
[picture p190: assets/MaslowCNC_Wisdom_Manual-assets/DSC00163_008.webp]


PCB Enclosure Top. Quantity 1. Properties: Glass fiber reinforced polycarbonate.
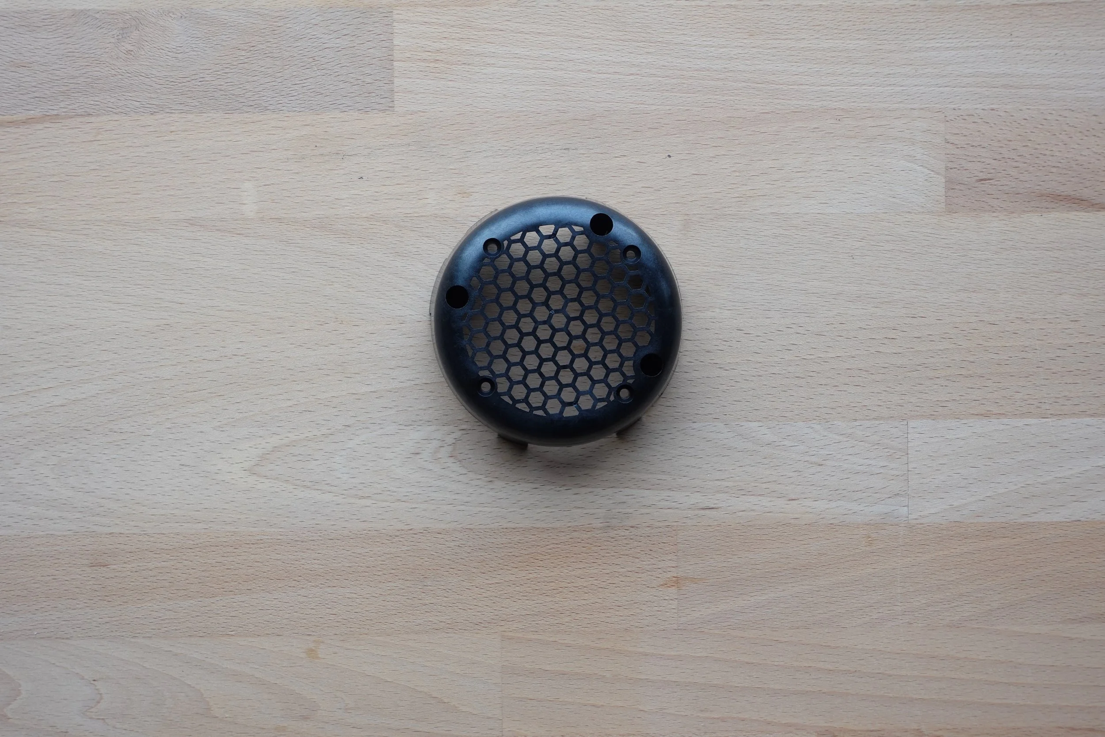
[picture p191: assets/MaslowCNC_Wisdom_Manual-assets/DSC00156_008.webp]


PCB Enclosure Bottom. Quantity 1. Properties: Polycarbonate.
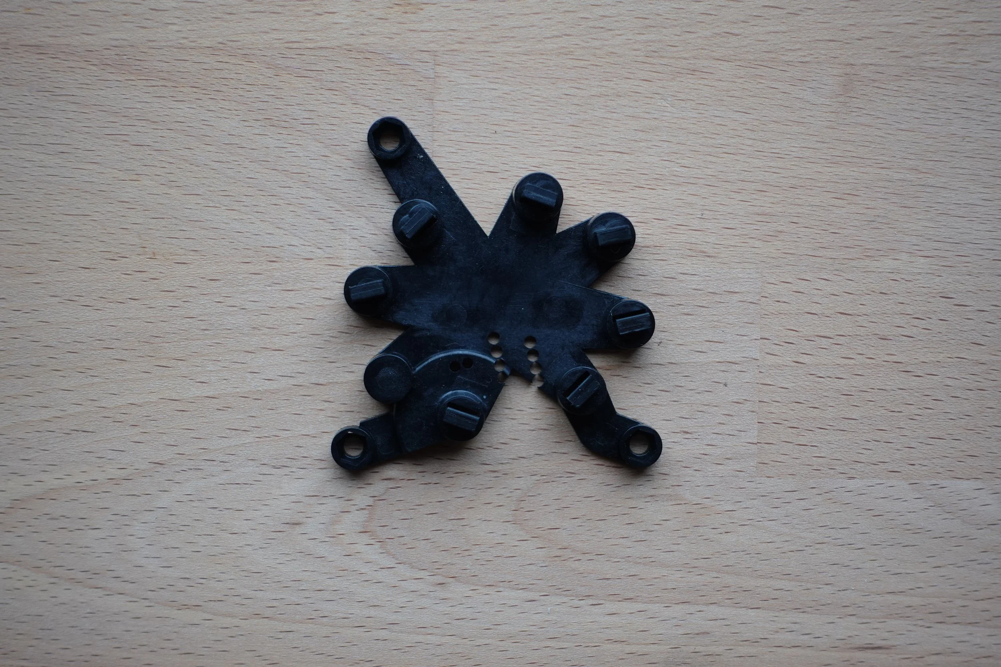
[picture p192: assets/MaslowCNC_Wisdom_Manual-assets/DSC00171_008.webp]


Stepper Motor. Quantity 2. Properties: 5mmx2mm pitch lead screw with POM nut.
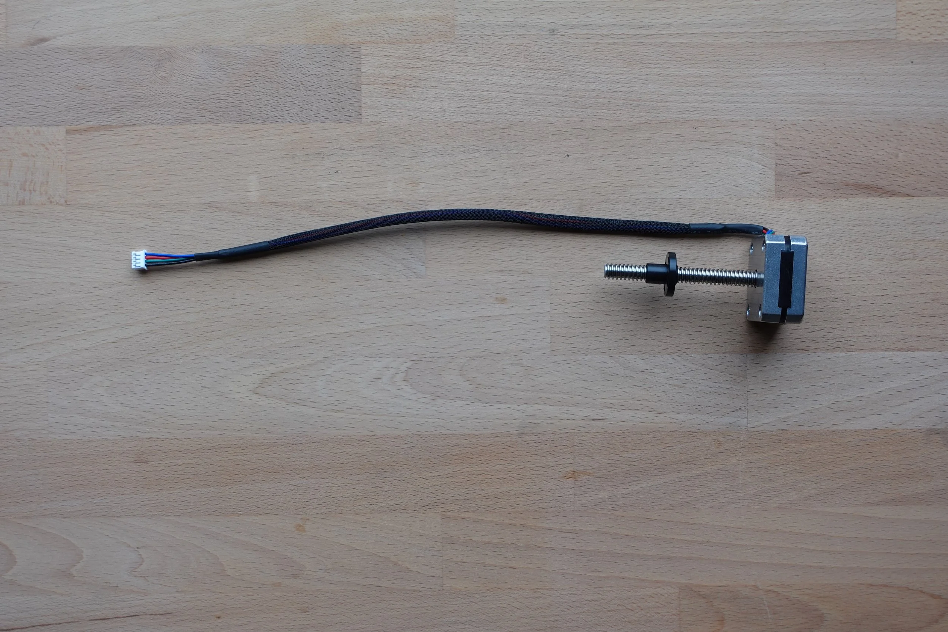
[picture p193: assets/MaslowCNC_Wisdom_Manual-assets/DSC00162_008.webp]


DC Motor. Quantity 4. Properties: Planetary reduction gearbox.
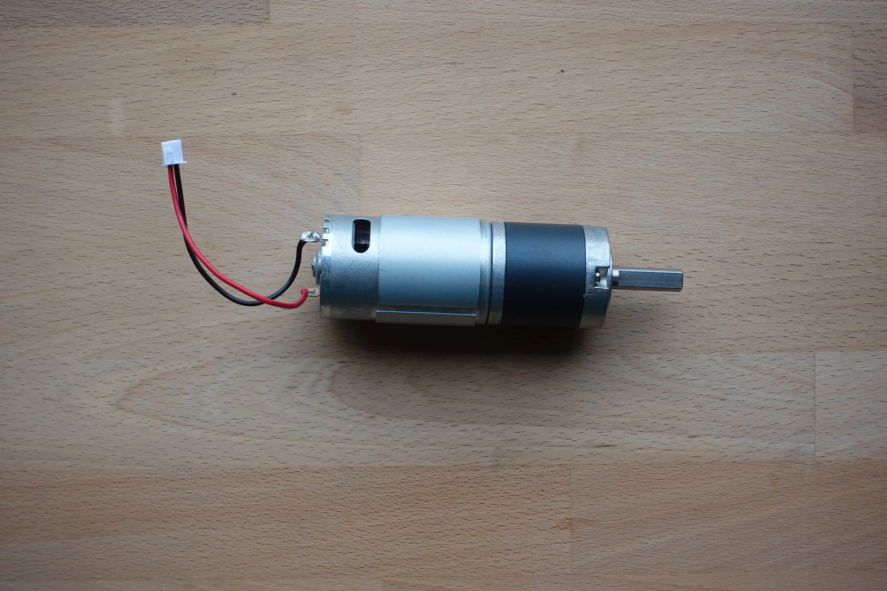
[picture p194: assets/MaslowCNC_Wisdom_Manual-assets/DSC00160_008.webp]


Drive Gear. Quantity 4. Properties: Steel, Fits D-shaped 8mm shaft with set screw.
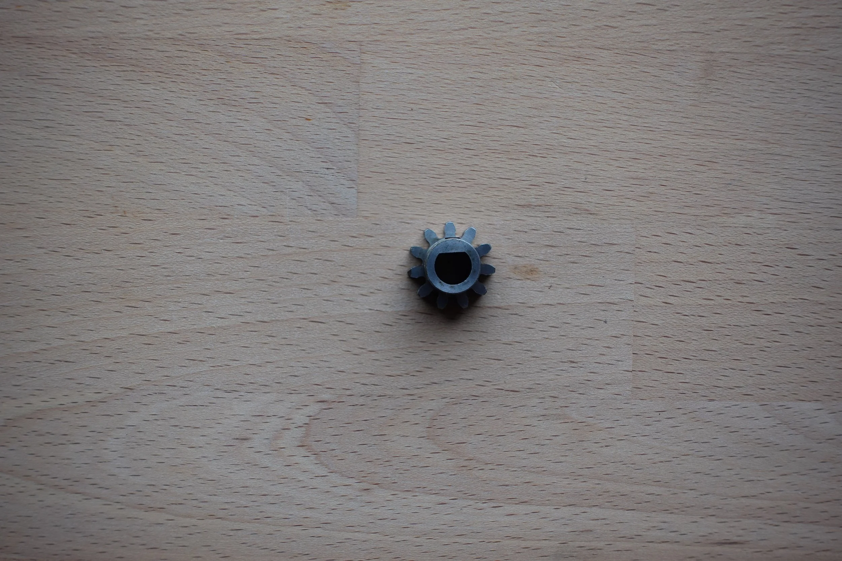
[picture p195: assets/MaslowCNC_Wisdom_Manual-assets/DSC00187_008.webp]


Idler Gear. Quantity 4. Properties: Steel, Fits round 8mm shaft.
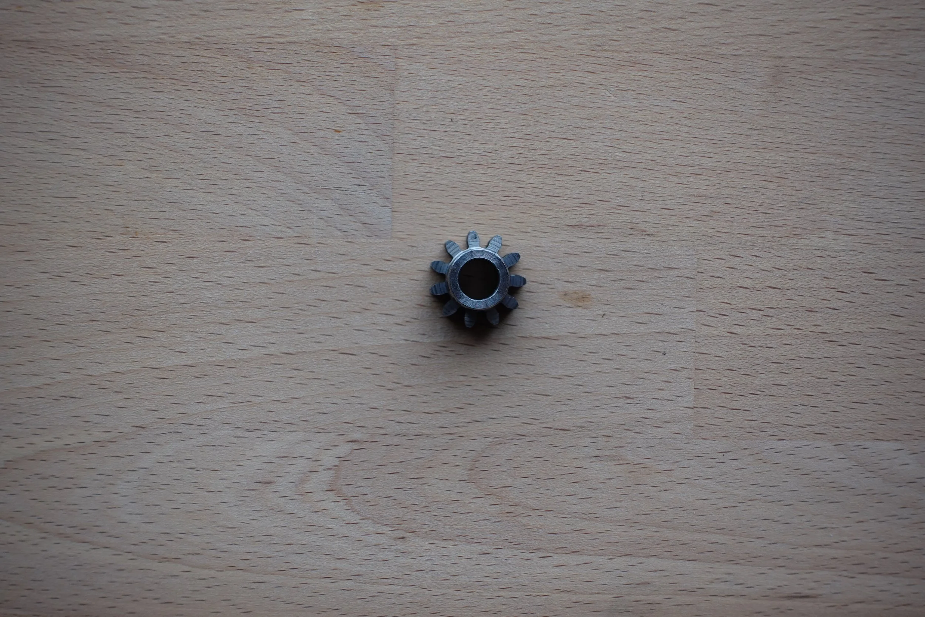
[picture p196: assets/MaslowCNC_Wisdom_Manual-assets/DSC00185_008.webp]


Roller. Quantity 8. Properties: Glass fiber reinforced polycarbonate.
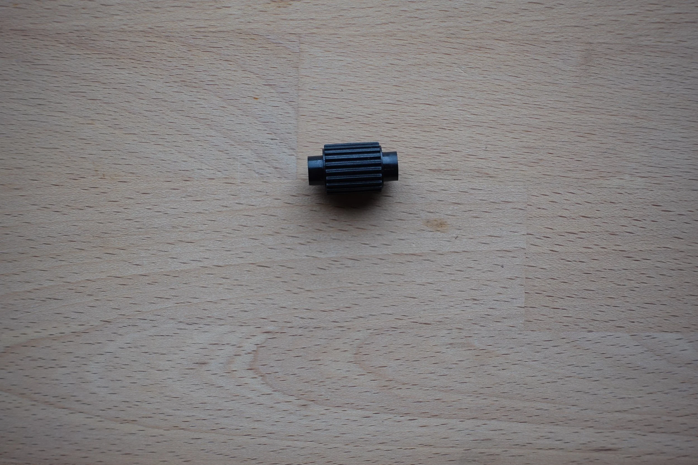
[picture p197: assets/MaslowCNC_Wisdom_Manual-assets/DSC00195_008.webp]


Belt End Half. Quantity 8. Properties: Glass fiber reinforced polycarbonate.
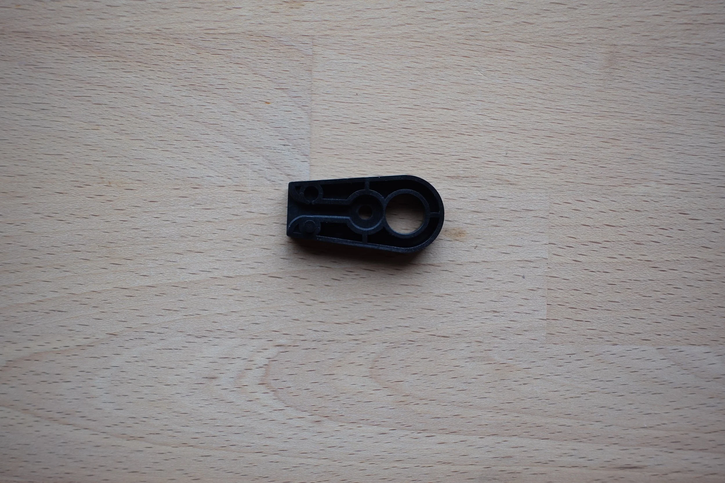
[picture p198: assets/MaslowCNC_Wisdom_Manual-assets/DSC00181_008.webp]


Belt Guard. Quantity 4. Properties: Polycarbonate.
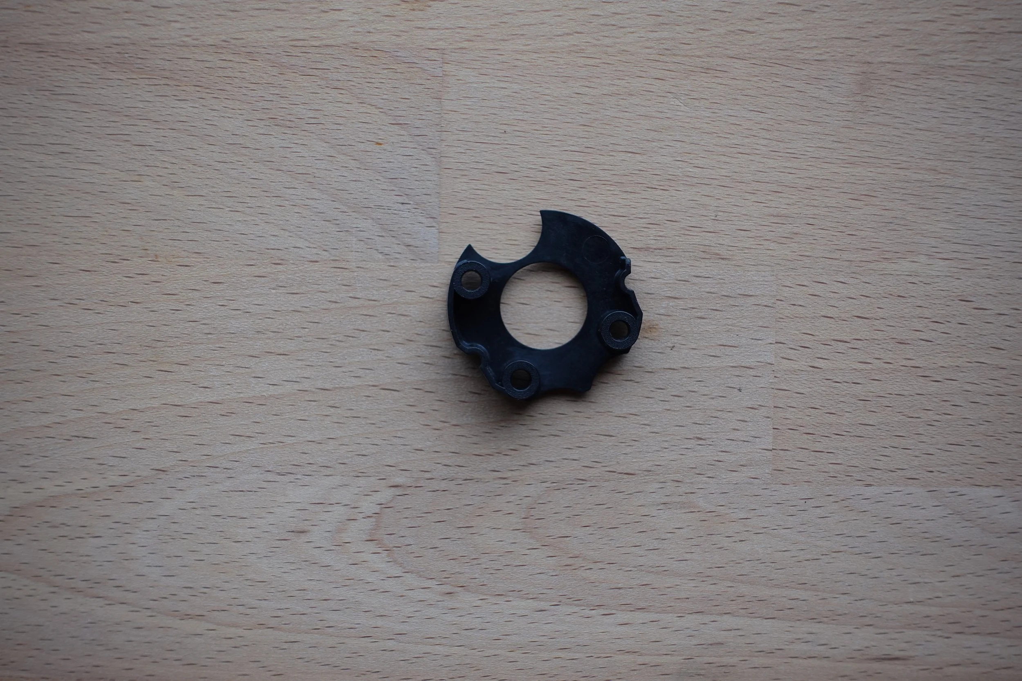
[picture p199: assets/MaslowCNC_Wisdom_Manual-assets/DSC00179_008.webp]


Inner Post. Quantity 8. Properties: Glass fiber reinforced polycarbonate. 
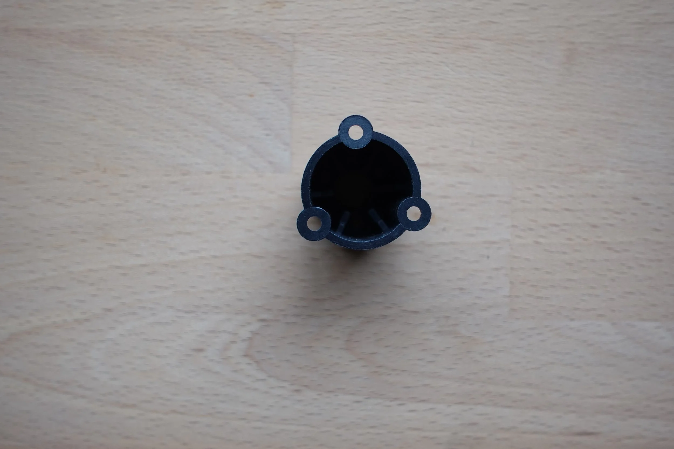
[picture p200: assets/MaslowCNC_Wisdom_Manual-assets/DSC00173_008.webp]

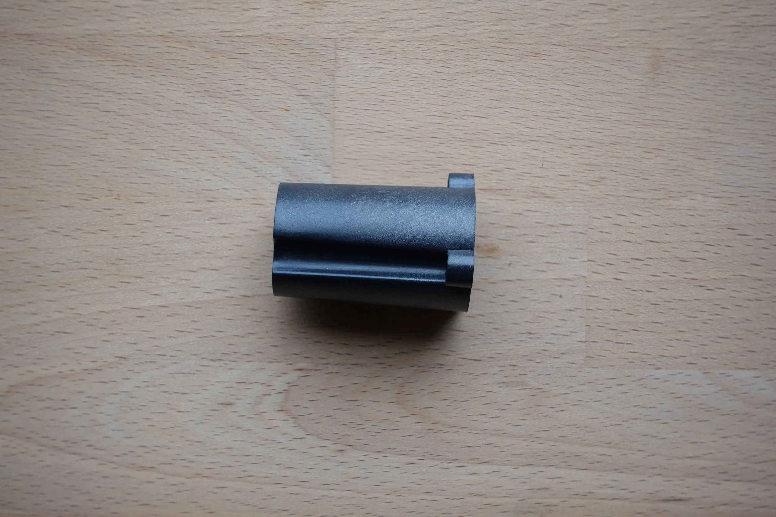
[picture p201: assets/MaslowCNC_Wisdom_Manual-assets/DSC00174_008.webp]


Linear Rod Clamp. Quantity 2. Properties: Glass fiber reinforced polycarbonate. Note: These will come preinstalled on the sled.
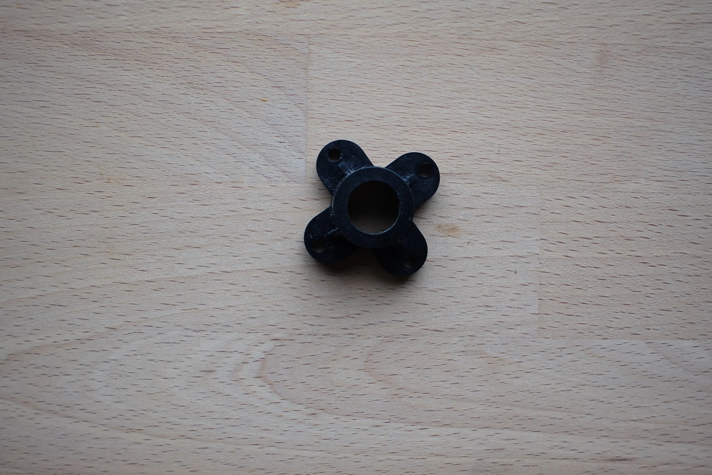
[picture p202: assets/MaslowCNC_Wisdom_Manual-assets/DSC00178_008.webp]


Support Riser. Quantity 2. Properties: Glass fiber reinforced polycarbonate. 
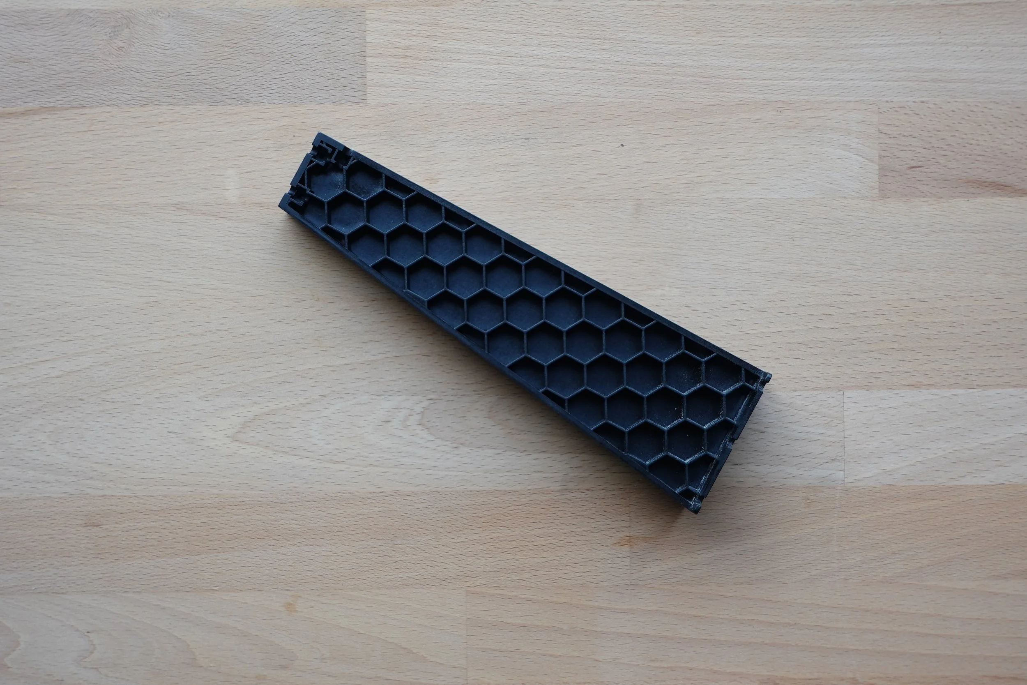
[picture p203: assets/MaslowCNC_Wisdom_Manual-assets/DSC00148_002.webp]


Support Riser Top. Quantity 2. Properties: Glass fiber reinforced polycarbonate.
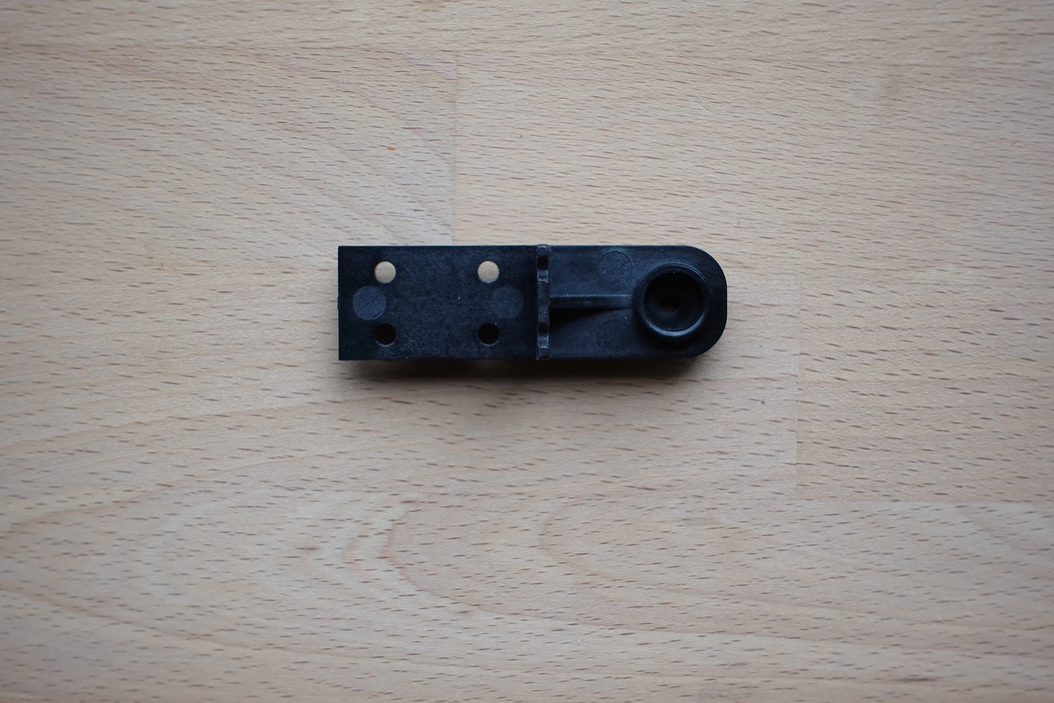
[picture p204: assets/MaslowCNC_Wisdom_Manual-assets/DSC00176_008.webp]


Idler Shaft. Quantity 4. Properties: Hardened steel.
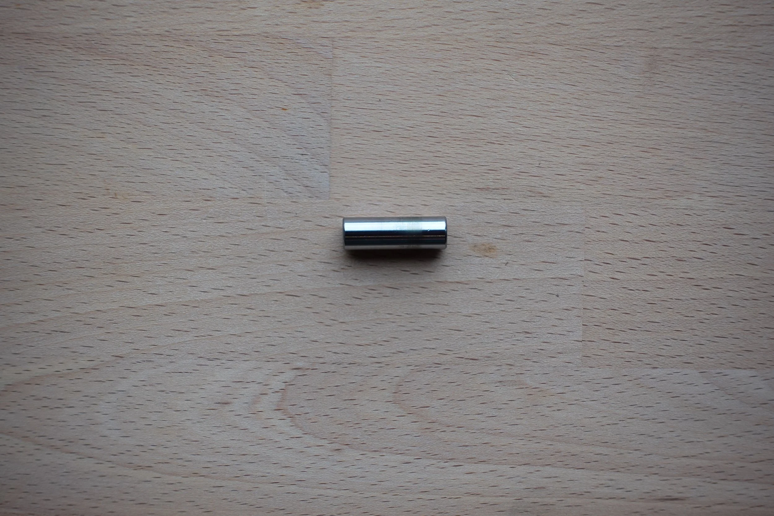
[picture p205: assets/MaslowCNC_Wisdom_Manual-assets/DSC00196_008.webp]


Linear Shaft. Quantity 2. Properties: Hardened steel.
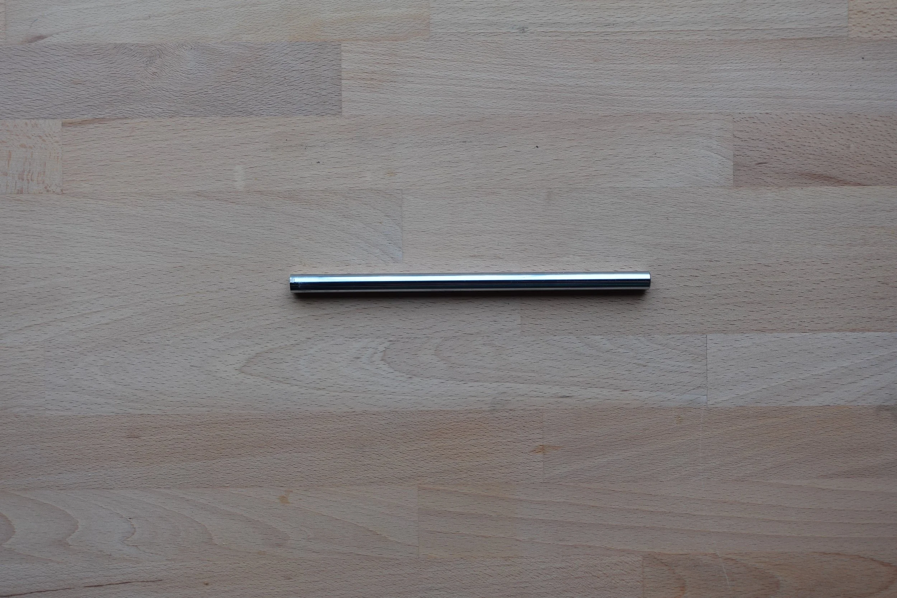
[picture p206: assets/MaslowCNC_Wisdom_Manual-assets/DSC00164_008.webp]


Bearing. Quantity 20. Properties: Fits 8mm shaft.
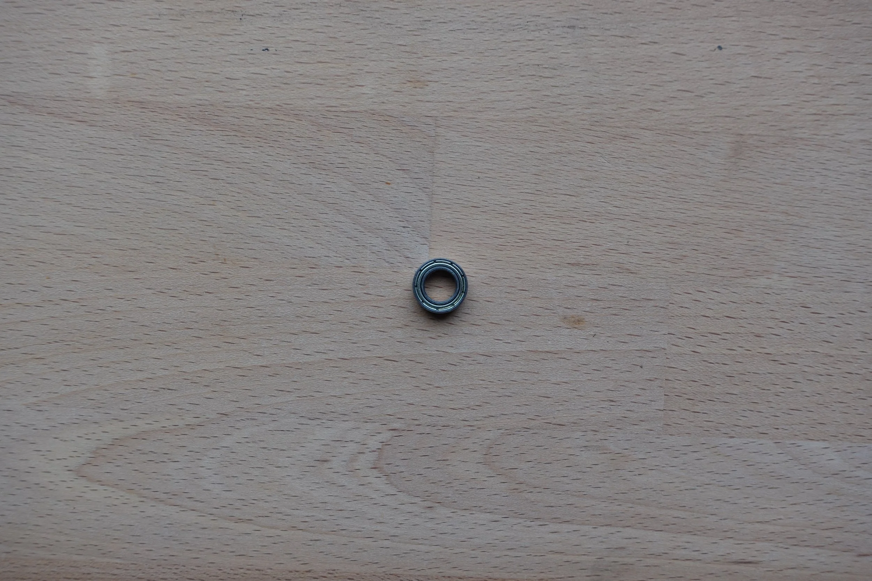
[picture p207: assets/MaslowCNC_Wisdom_Manual-assets/DSC00200_008.webp]


Linear Bearings. Quantity 4. Properties: Fits 10mm linear shaft.
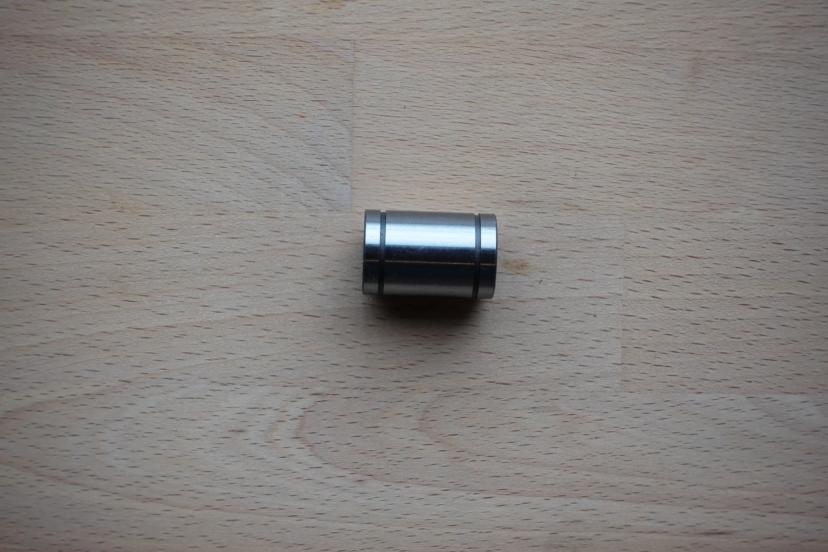
[picture p208: assets/MaslowCNC_Wisdom_Manual-assets/DSC00189_008.webp]


Belt Spool. Quantity 4. Properties: Polycarbonate.
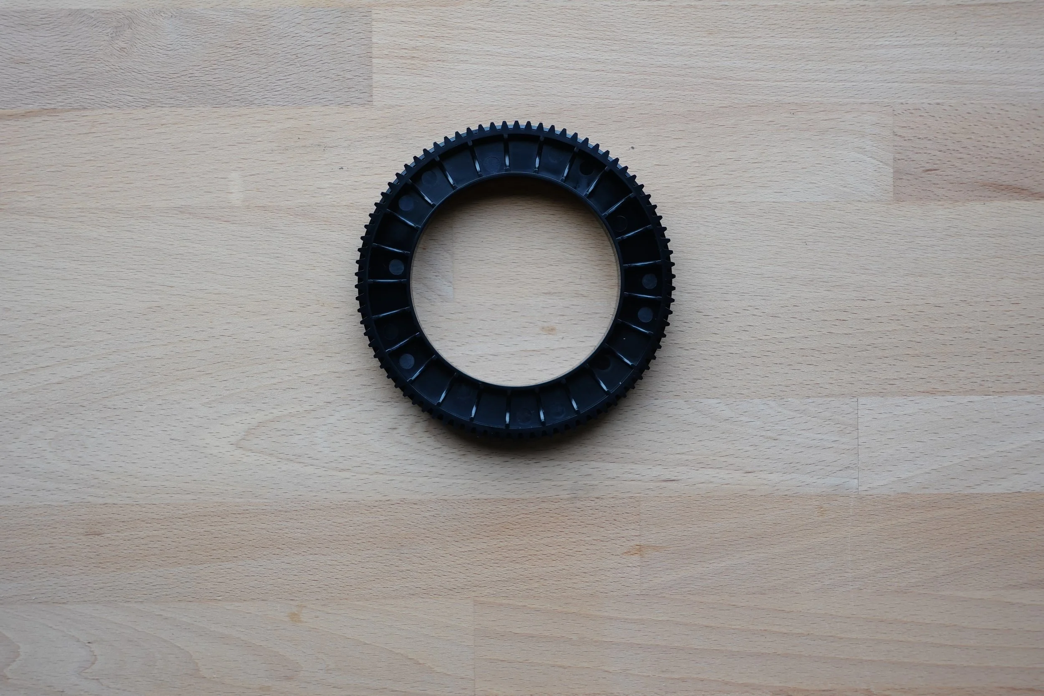
[picture p209: assets/MaslowCNC_Wisdom_Manual-assets/DSC00154_008.webp]


Belt. Quantity 4. Properties: Steel reinforced TPU, 14.5 feet long.
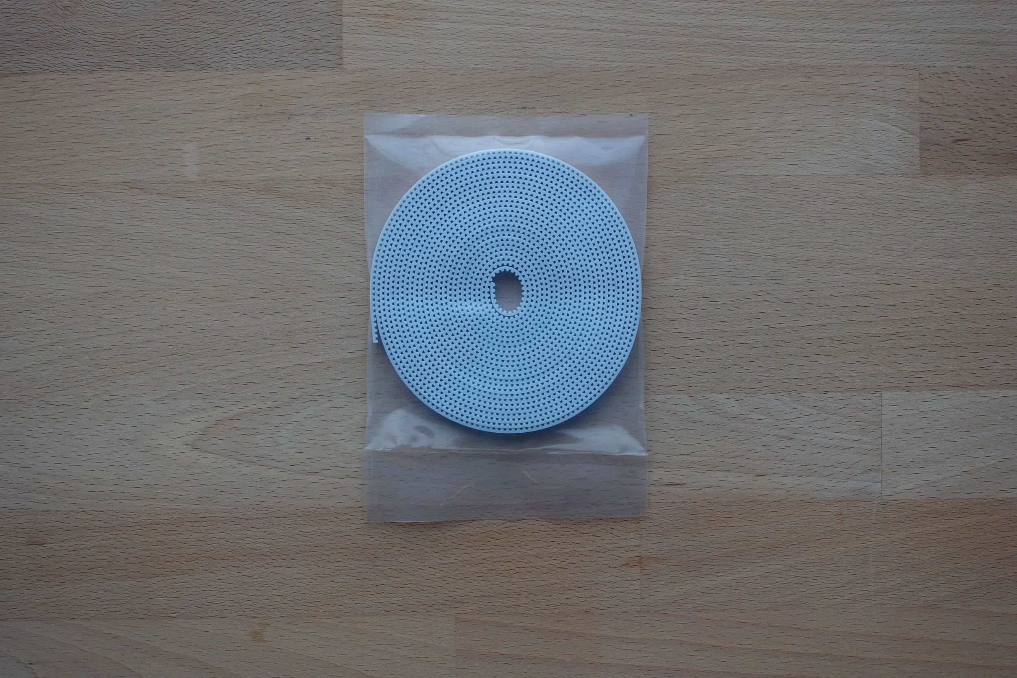
[picture p210: assets/MaslowCNC_Wisdom_Manual-assets/DSC00143_003.webp]


Arm Frame. Quantity 8. Properties: POM.
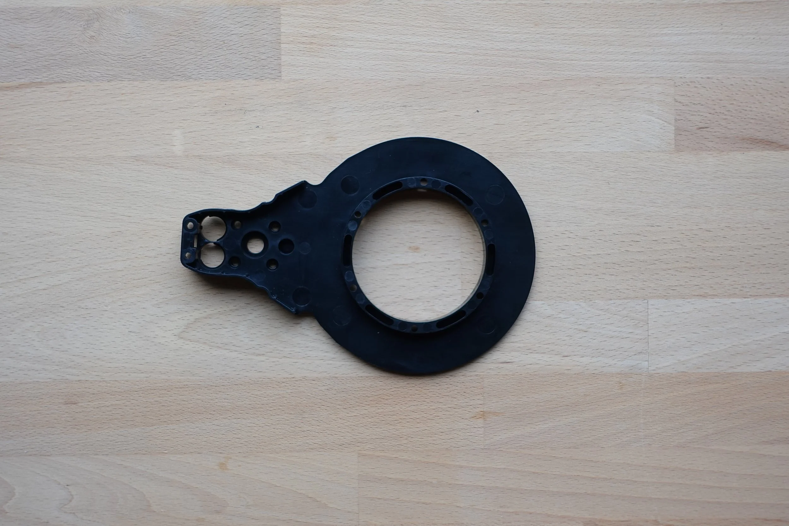
[picture p211: assets/MaslowCNC_Wisdom_Manual-assets/DSC00152_008.webp]


Z-axis Clamp Wedge. Quantity 2. Properties: Glass fiber reinforced polycarbonate. Note that these will come preinstalled on the router clamp and really blend in.
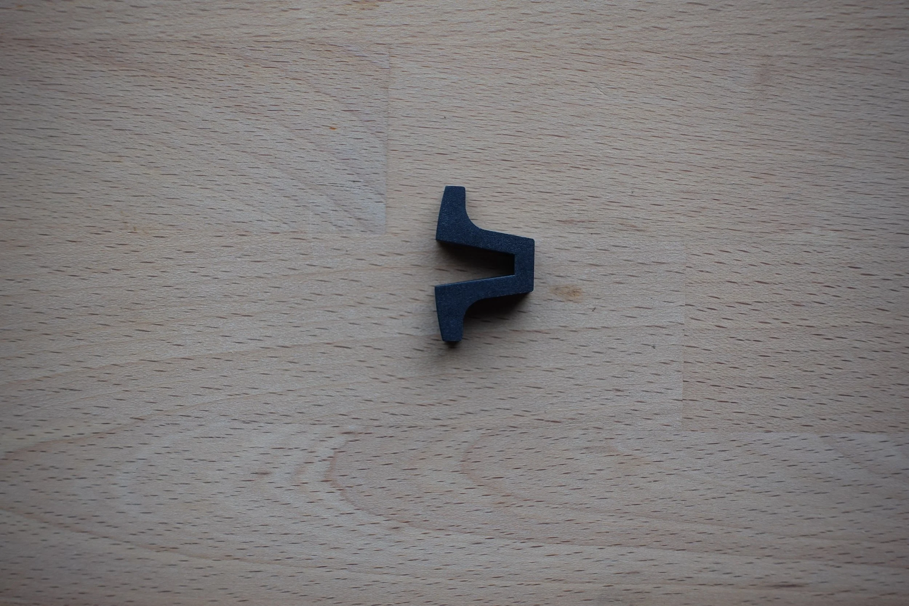
[picture p212: assets/MaslowCNC_Wisdom_Manual-assets/DSC00191_008.webp]


Router Clamp. Quantity 2. Properties: Glass fiber reinforced polycarbonate.
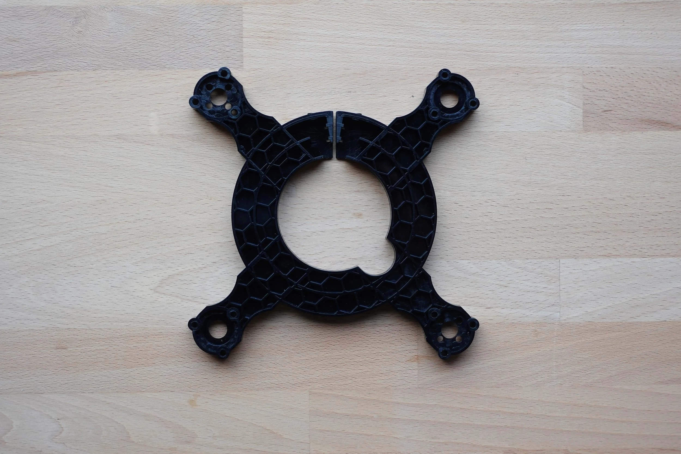
[picture p213: assets/MaslowCNC_Wisdom_Manual-assets/DSC00150_008.webp]


Sled. Quantity 1. Properties: Glass fiber reinforced polycarbonate.
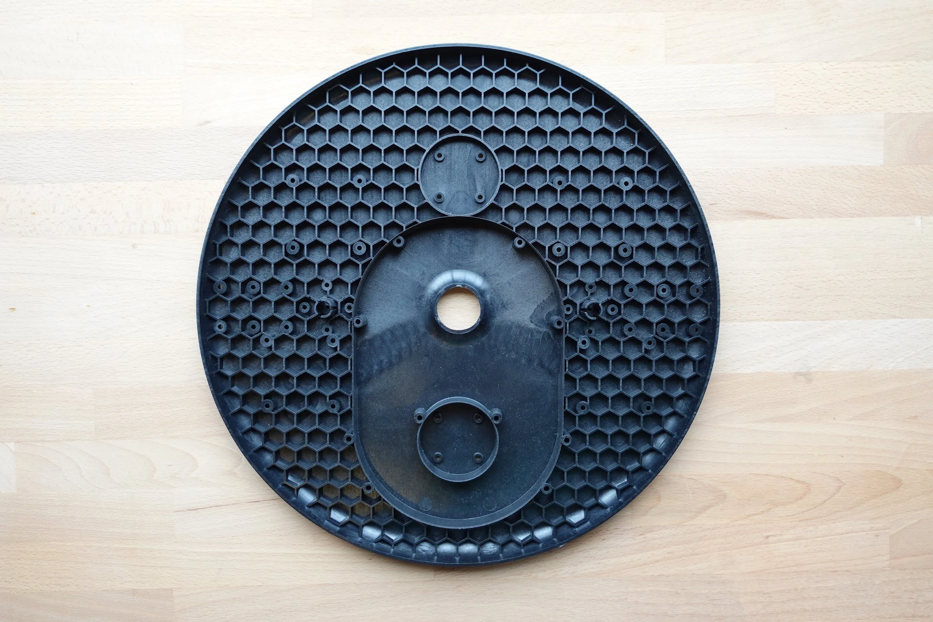
[picture p214: assets/MaslowCNC_Wisdom_Manual-assets/DSC00209_008.webp]


Dust Cover. Quantity 1. Properties: Laser cut acrylic.
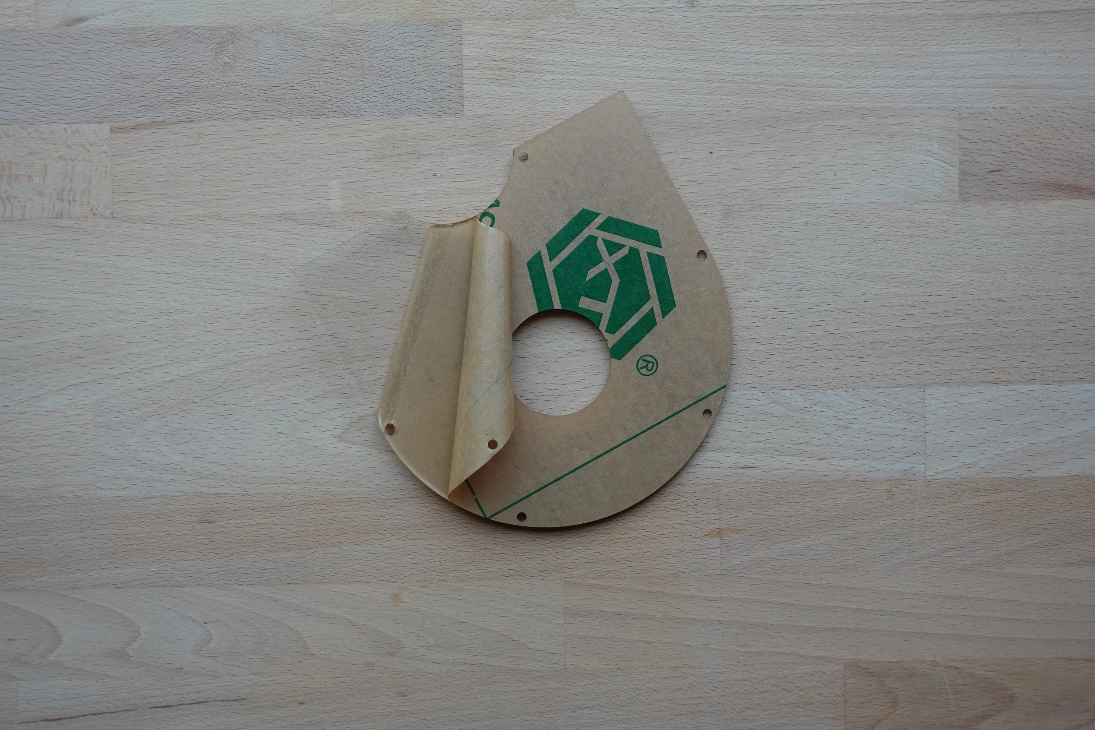
[picture p215: assets/MaslowCNC_Wisdom_Manual-assets/DSC00211_008.webp]


M3x12mm Bolt. Quantity 175. Properties: Stainless steel, 2mm allen drive button head. 
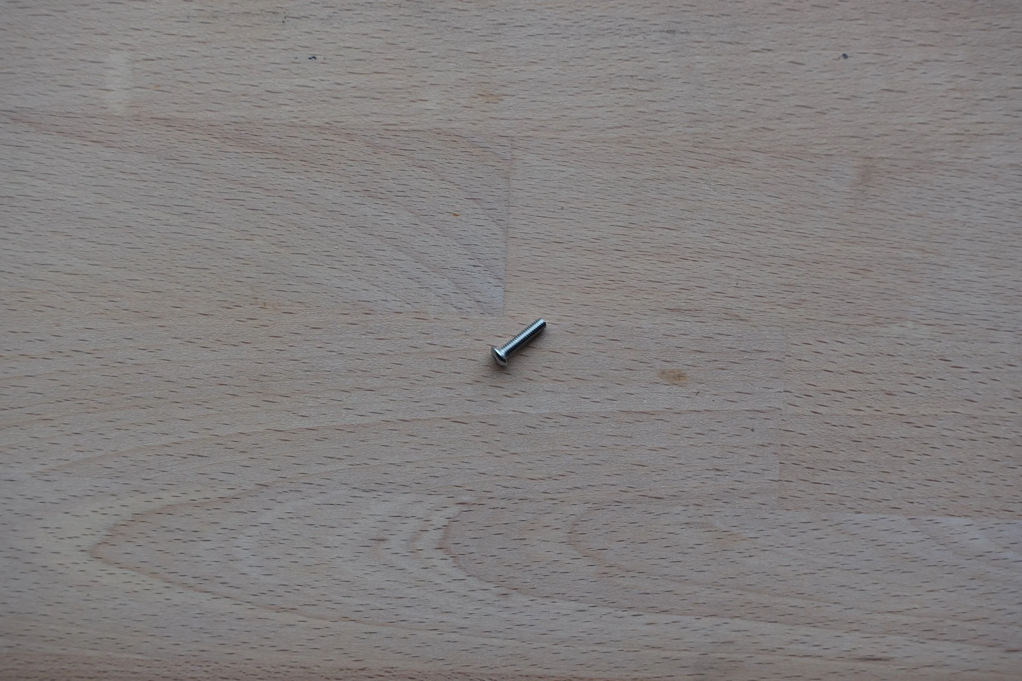
[picture p216: assets/MaslowCNC_Wisdom_Manual-assets/DSC00203_008.webp]


M3x6mm Bolt. Quantity 12. Properties: Stainless steel, 2mm allen drive button head. 
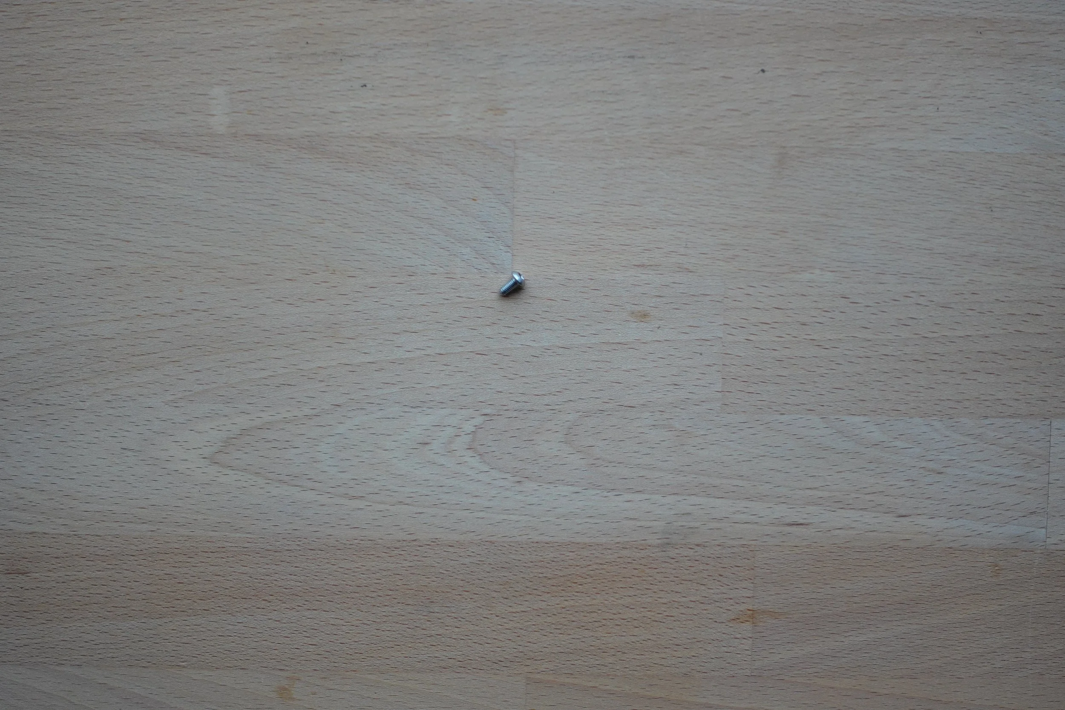
[picture p217: assets/MaslowCNC_Wisdom_Manual-assets/DSC00215_008.webp]


M3 Nut. Quantity 100. Properties: Stainless steel.
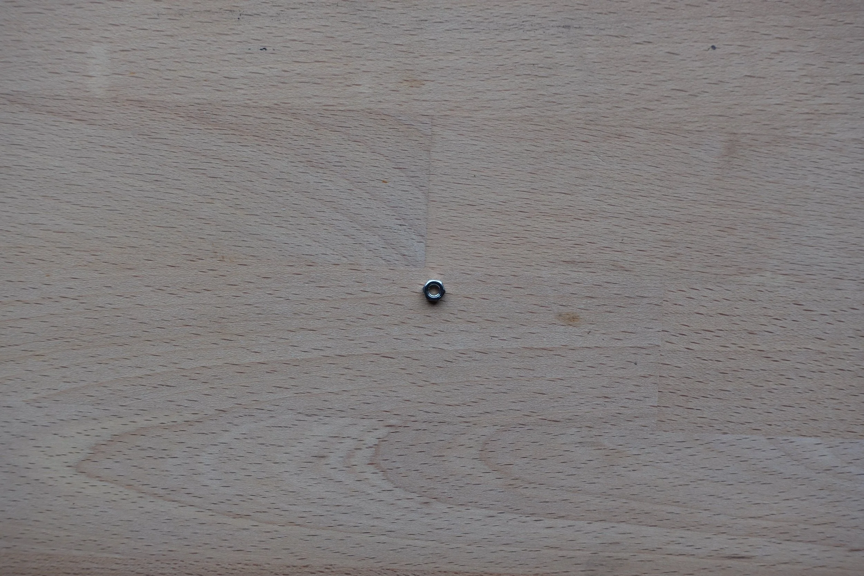
[picture p218: assets/MaslowCNC_Wisdom_Manual-assets/DSC00206_008.webp]


M3 Locknut. Quantity 160. Properties: Stainless steel.
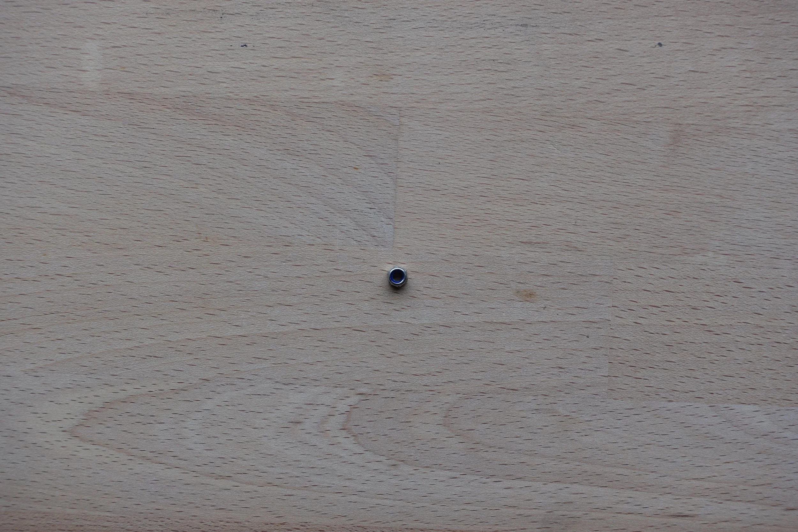
[picture p219: assets/MaslowCNC_Wisdom_Manual-assets/DSC00208.webp]


2mm Allen Wrench. Quantity 1. Properties: Stainless steel.
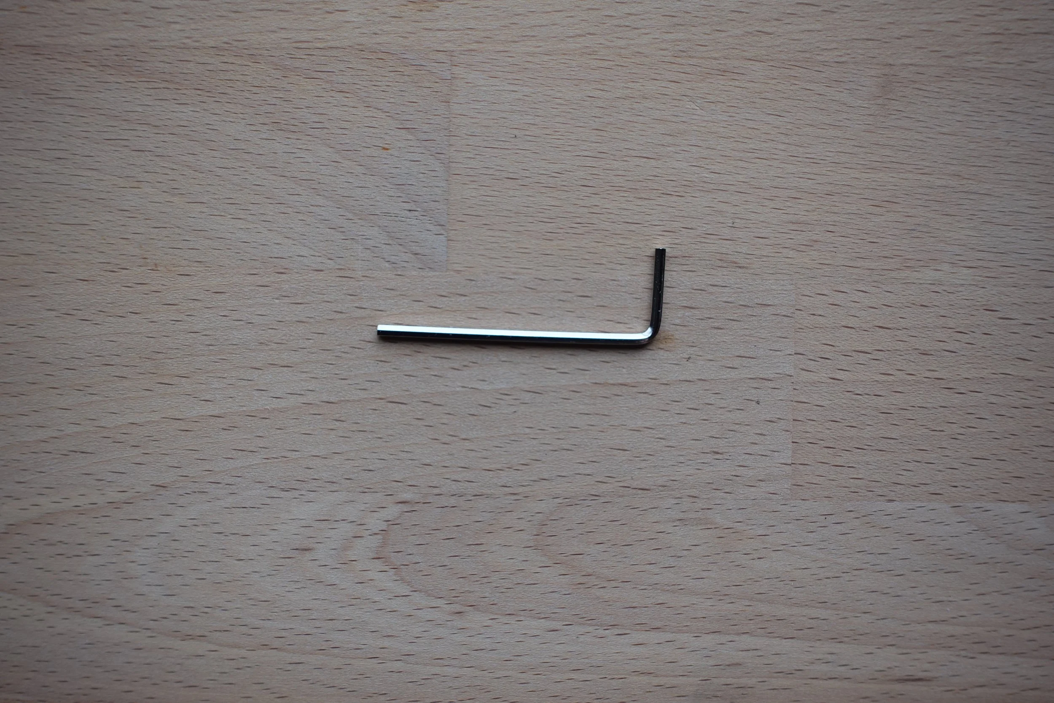
[picture p220: assets/MaslowCNC_Wisdom_Manual-assets/DSC00183_008.webp]


Encoder Magnet. Quantity 4. Properties: Magnetic.
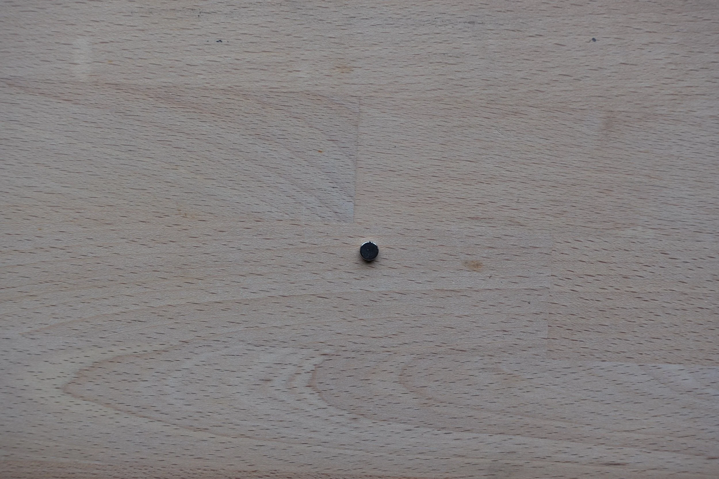
[picture p221: assets/MaslowCNC_Wisdom_Manual-assets/DSC00202_008.webp]


Super Glue. Quantity 1. Properties: Gel
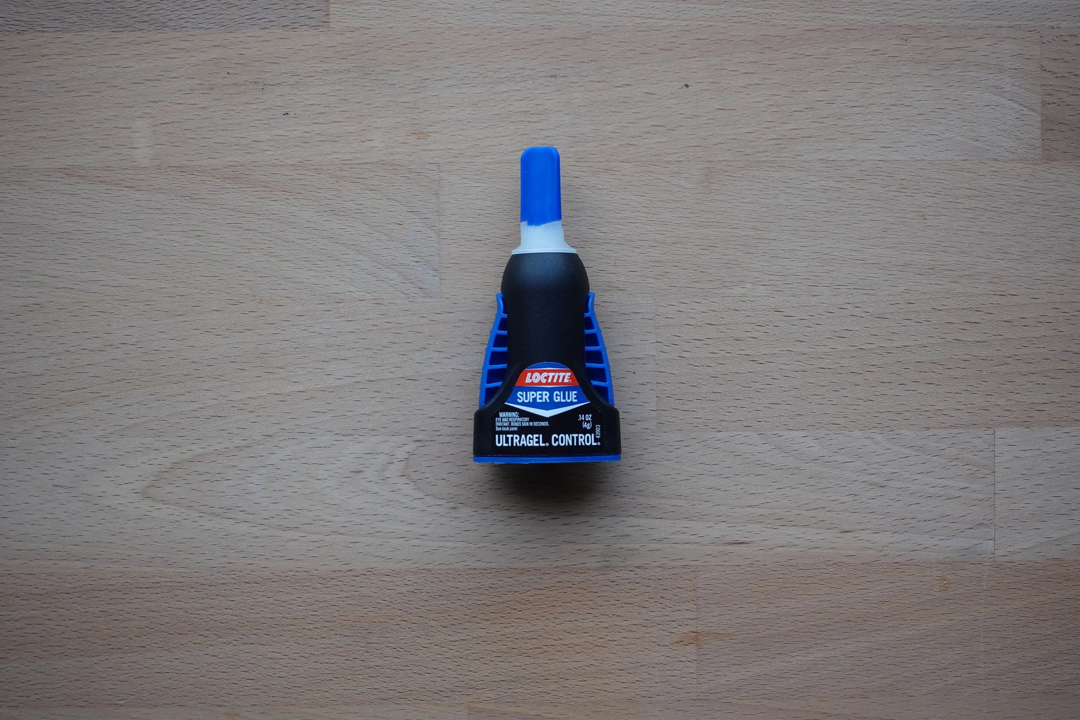
[picture p222: assets/MaslowCNC_Wisdom_Manual-assets/DSC00145_008.webp]


Thread Locker. Quantity 1. Properties: Removable thread locker. (No photo yet)

Silicone Grease. Quantity 1. Properties: Slippery. (No photo yet)

---

## What’s in the Maslow4.1 Kit?

Five Axis Control Board. Quantity 1. Properties: Four servo axis, one stepper axis (dual drive), four JST-XH encoder ports, two AUX ports, one fan control port. Wifi, bluetooth, USB C.
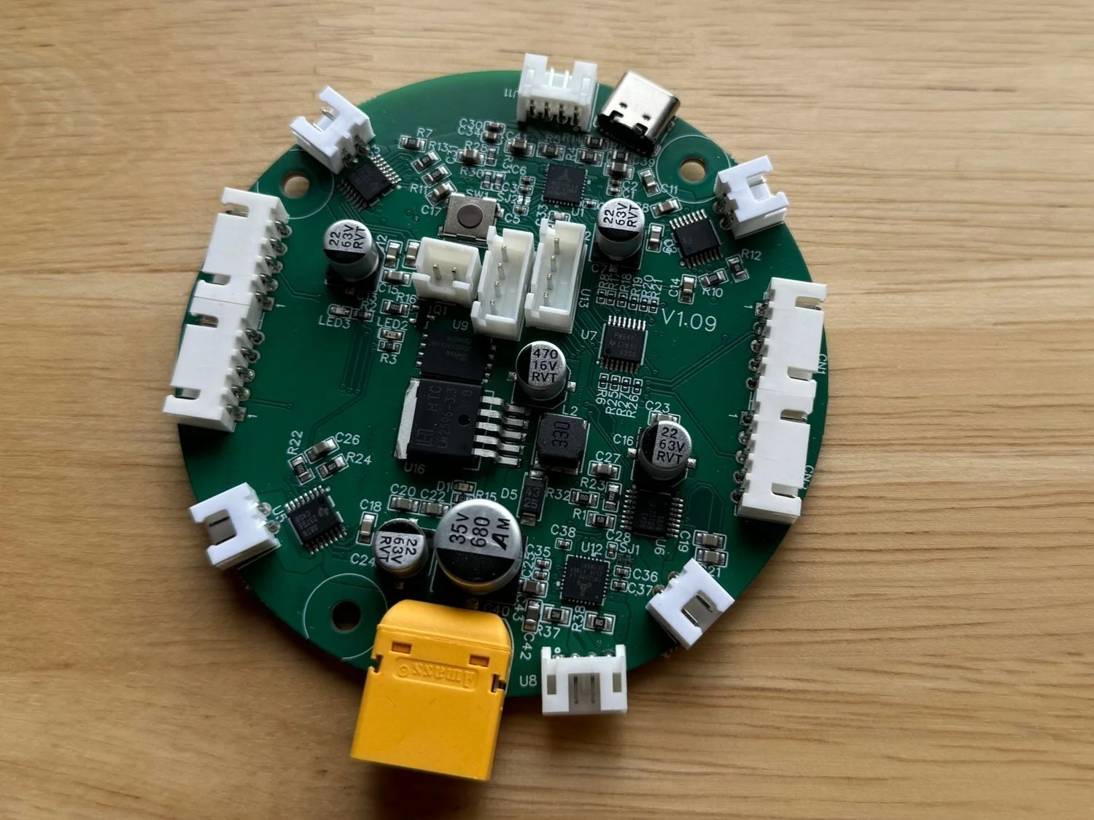
[picture p223: assets/MaslowCNC_Wisdom_Manual-assets/IMG_5654.webp]


Magnetic Encoder Board. Quantity 4 Properties: AS5600 magnetic encoder with JST-XH interface.
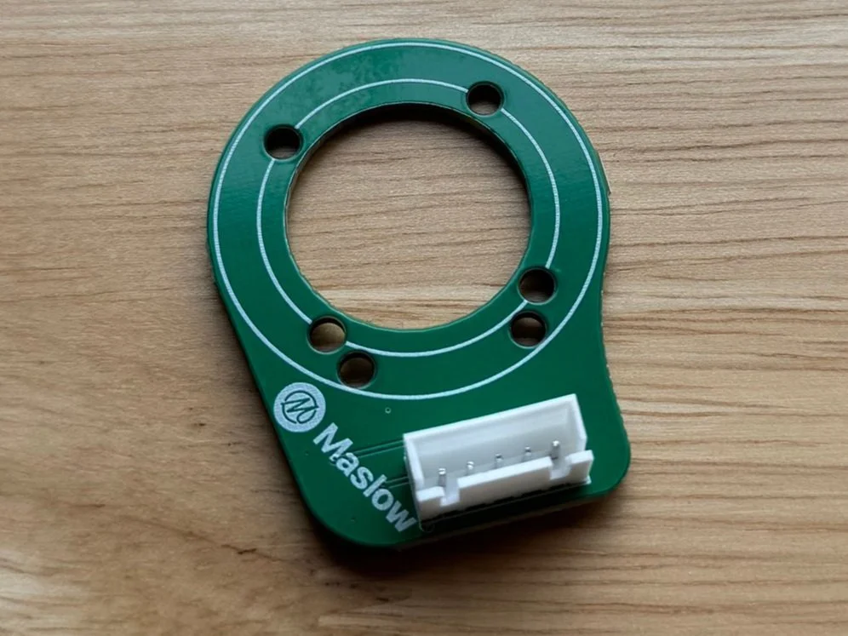
[picture p224: assets/MaslowCNC_Wisdom_Manual-assets/IMG_5656.webp]


Cooling Fan. Quantity 1. Properties: 60mm, brushless.


Power Supply. Quantity 1. Properties: UL listed, 120-240 volts, Standard NEMA computer cord plug, US plug cord provided.
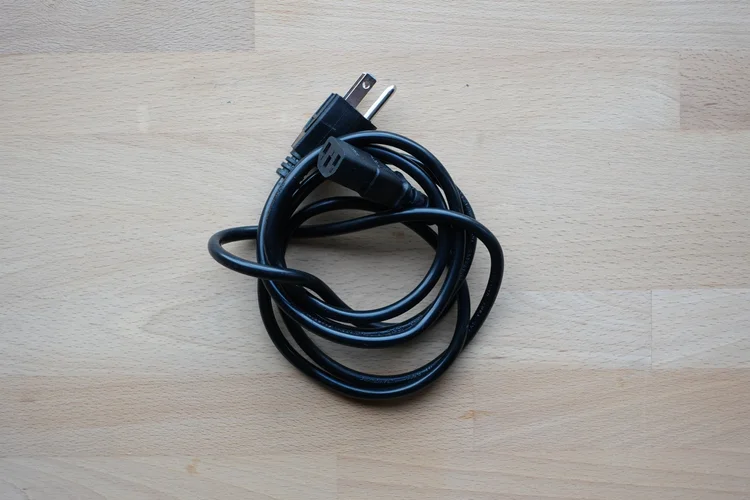
[picture p225: assets/MaslowCNC_Wisdom_Manual-assets/DSC00138.webp]



JST-XH Encoder Cable. Quantity 4. 
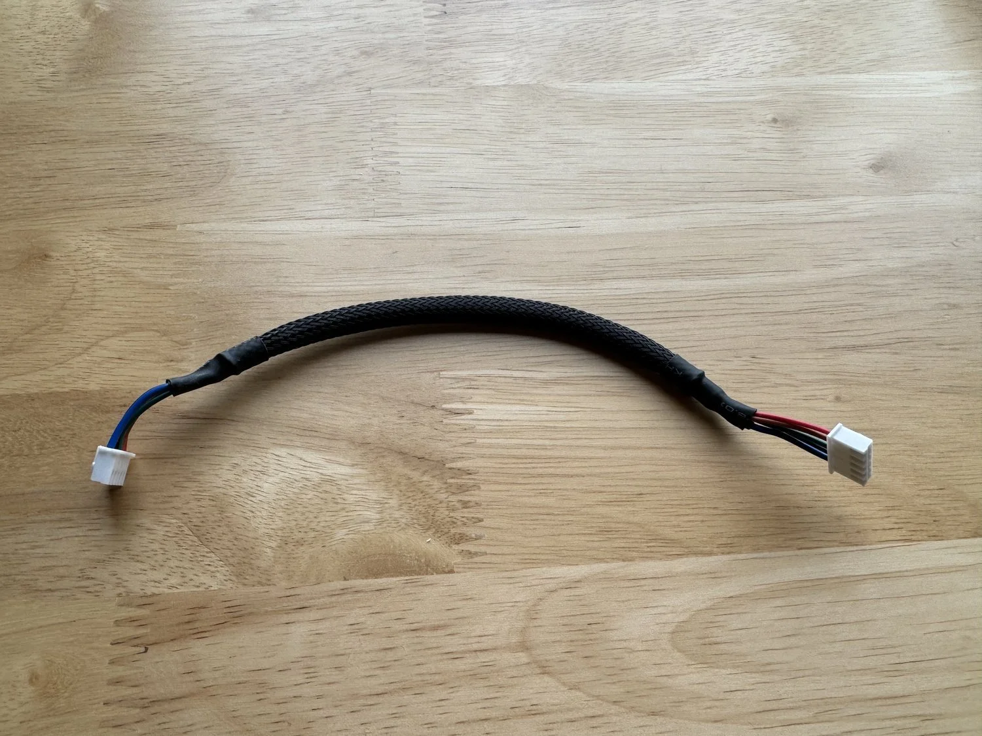
[picture p226: assets/MaslowCNC_Wisdom_Manual-assets/IMG_5651.webp]


PCB Enclosure Top. Quantity 1. Properties: Glass fiber reinforced polycarbonate.


PCB Enclosure Bottom. Quantity 1. Properties: Polycarbonate.


Stepper Motor. Quantity 2. Properties: 5mmx2mm pitch lead screw with POM nut.


DC Motor. Quantity 4. Properties: Planetary reduction gearbox.
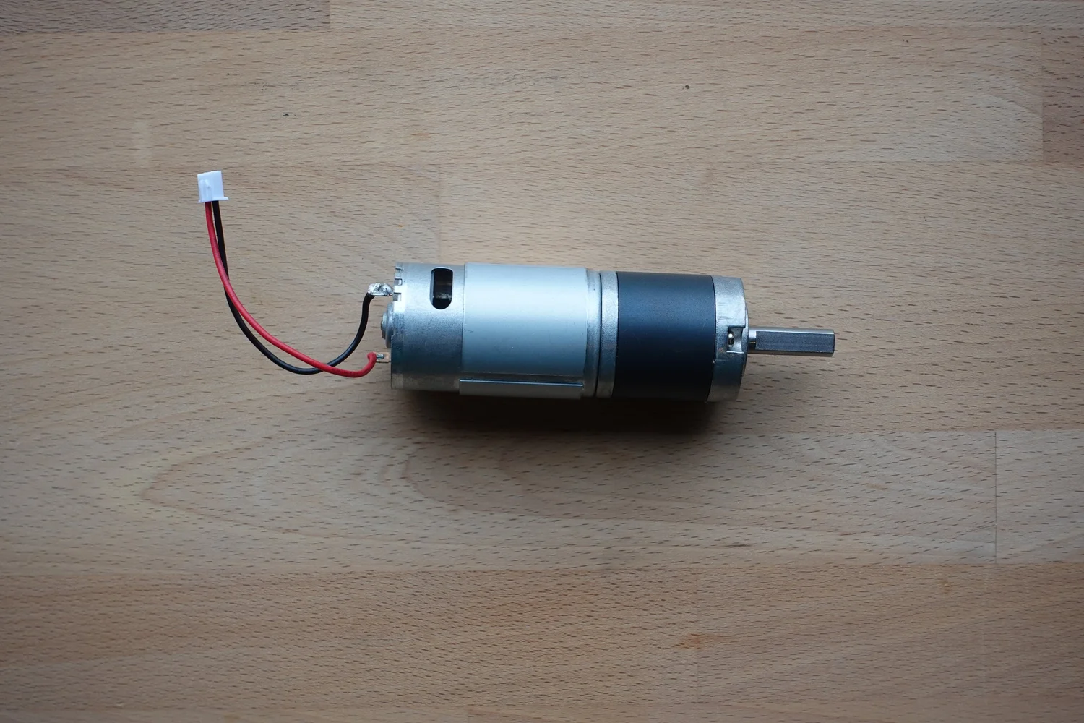
[picture p227: assets/MaslowCNC_Wisdom_Manual-assets/DSC00160.webp]


Drive Gear. Quantity 4. Properties: Steel, Fits D-shaped 8mm shaft with set screw.


Idler Gear. Quantity 4. Properties: Steel, Fits  8mm bearings.
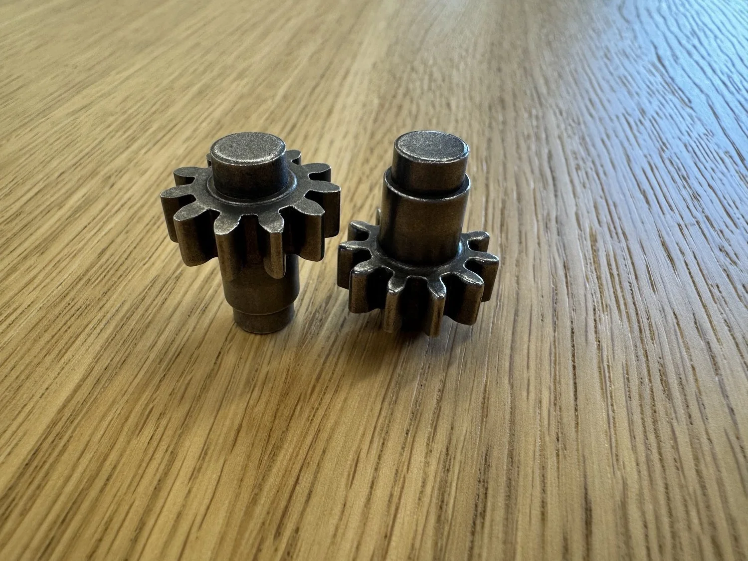
[picture p228: assets/MaslowCNC_Wisdom_Manual-assets/IMG_7371.webp]


Roller. Quantity 8. Properties: Glass fiber reinforced polycarbonate.


Belt End Half. Quantity 8. Properties: Glass fiber reinforced polycarbonate.


Belt Guard. Quantity 4. Properties: Polycarbonate.
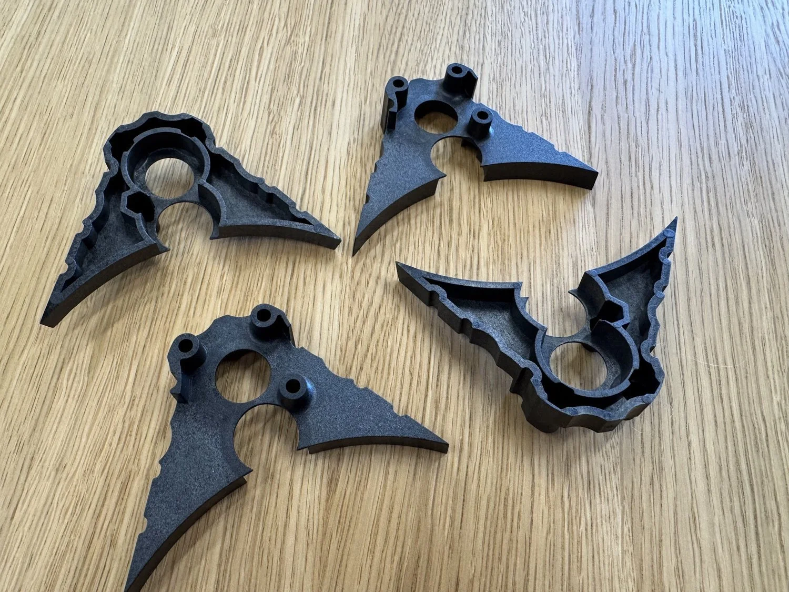
[picture p229: assets/MaslowCNC_Wisdom_Manual-assets/IMG_7358.webp]


Inner Post. Quantity 8. Properties: Glass fiber reinforced polycarbonate. 



Linear Rod Clamp. Quantity 2. Properties: Glass fiber reinforced polycarbonate. Note: These will come preinstalled on the sled and may be hard to spot.


Support Riser. Quantity 2. Properties: Glass fiber reinforced polycarbonate. 


Support Riser Top. Quantity 2. Properties: Glass fiber reinforced polycarbonate.


Linear Shaft. Quantity 2. Properties: Hardened steel.


Bearing. Quantity 30. Properties: Fits 8mm shaft, 148ZZ is the common designation. 


Linear Bearings. Quantity 4. Properties: Fits 10mm linear shaft.


Belt Spool. Quantity 4. Properties: Polycarbonate.


Belt. Quantity 4. Properties: Steel reinforced TPU, 14.5 feet long.


Arm Frame. Quantity 8. Properties: POM.
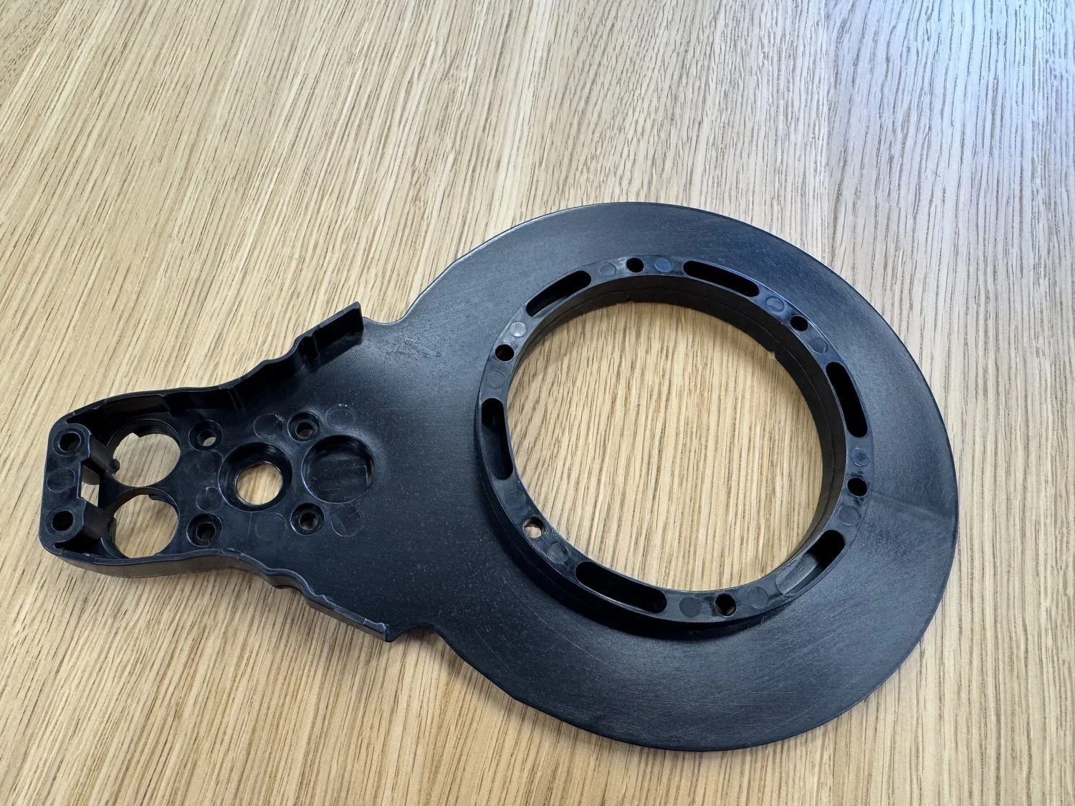
[picture p230: assets/MaslowCNC_Wisdom_Manual-assets/IMG_7363.webp]


Z-axis Clamp Wedge. Quantity 2. Properties: Glass fiber reinforced polycarbonate. Note that these will come preinstalled on the router clamp and really blend in.


Router Clamp. Quantity 2. Properties: Glass fiber reinforced polycarbonate.


Sled. Quantity 1. Properties: Glass fiber reinforced polycarbonate.


Dust Cover. Quantity 1. Properties: Laser cut acrylic.


M3x12mm Bolt. Quantity 150. Properties: Black oxide steel, 2mm torx drive button head. 
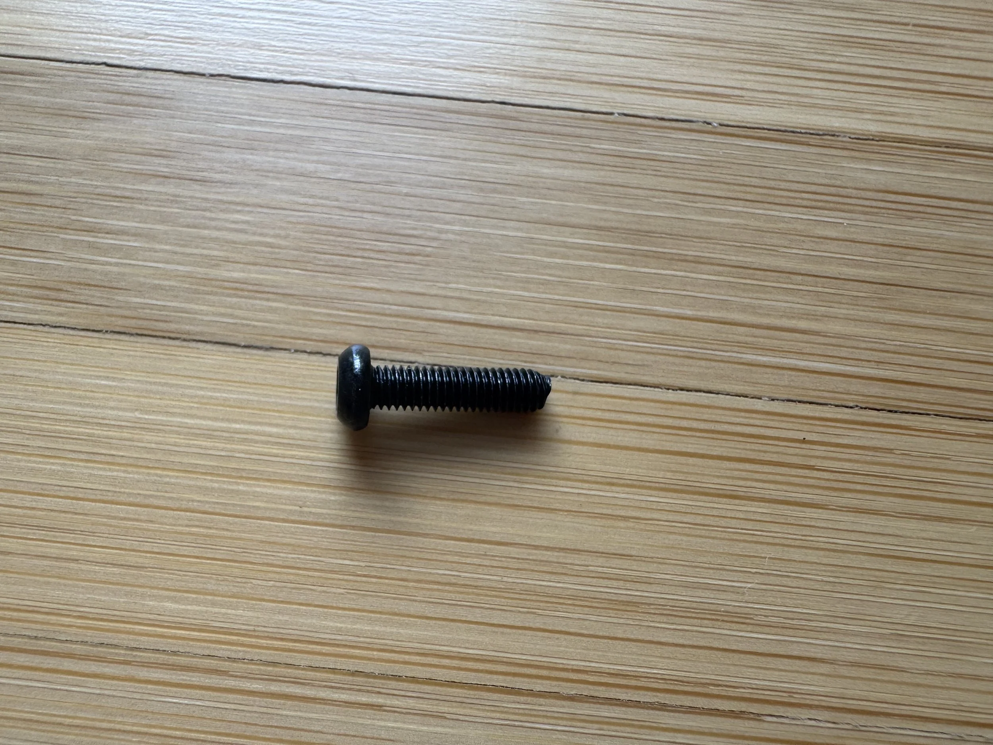
[picture p231: assets/MaslowCNC_Wisdom_Manual-assets/F5C182B1-9B6B-450B-87A6-F663FDC3C1E7.webp]
F5C182B1-9B6B-450B-87A6-F663FDC3C1E7


M3x12mm Bolt with Loctite. Quantity 20. Properties: Black oxide steel, 2mm torx drive button head.
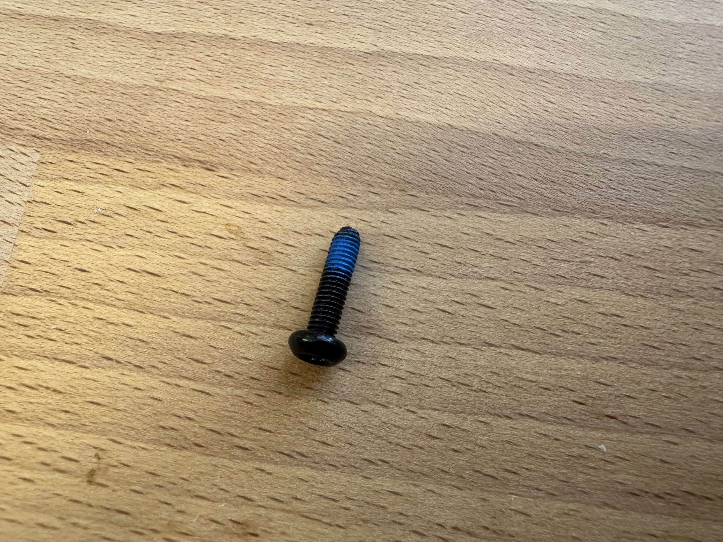
[picture p232: assets/MaslowCNC_Wisdom_Manual-assets/AEE79059-F043-4095-B7D1-8394BD85048F_008.webp]
AEE79059-F043-4095-B7D1-8394BD85048F_008


M3x6mm Bolt. Quantity 12. Properties: Black oxide steel, torx drive button head. 
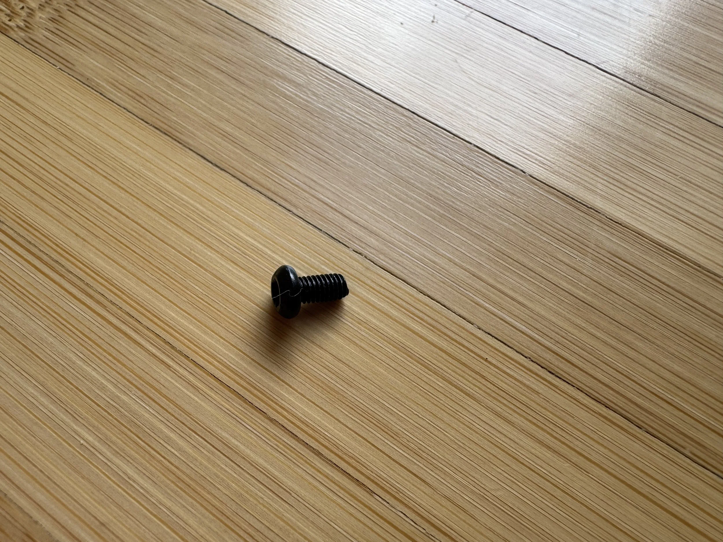
[picture p233: assets/MaslowCNC_Wisdom_Manual-assets/90E1DD68-72A5-49A2-B337-B99131CA1ECD.webp]
90E1DD68-72A5-49A2-B337-B99131CA1ECD


M3 Nut. Quantity 30. Properties: Stainless steel.


M3 Locknut. Quantity 150. Properties: Stainless steel.


T8 Torx Wrench. Quantity 1. Properties: Stainless steel.
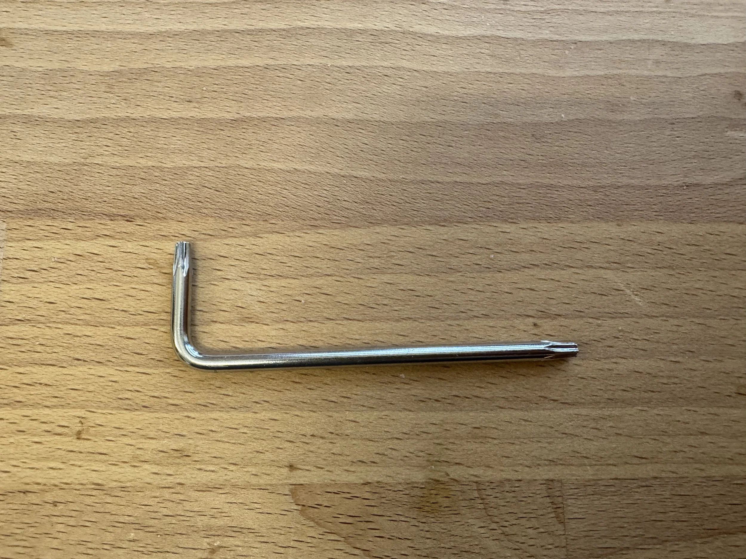
[picture p234: assets/MaslowCNC_Wisdom_Manual-assets/03CAB142-539C-4F23-9D0B-D1F9354CCF55.webp]
03CAB142-539C-4F23-9D0B-D1F9354CCF55


T10 Torx Wrench. Quantity 1. Properties: Stainless steel.
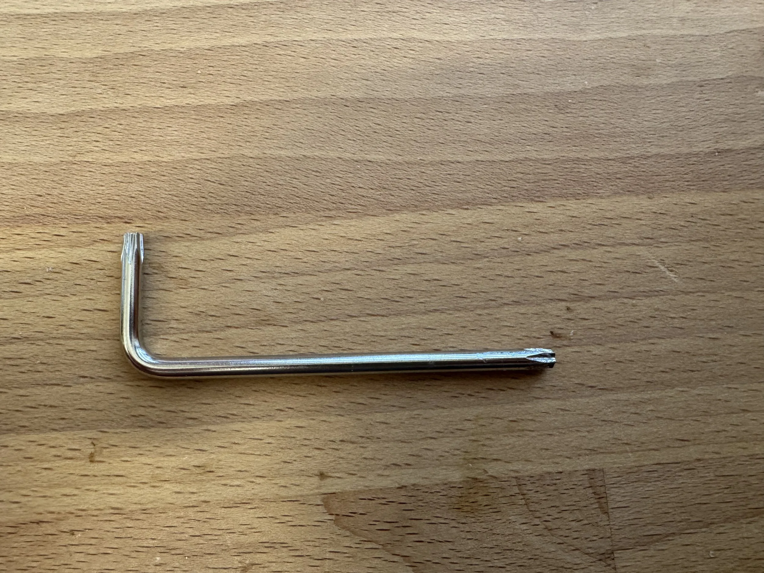
[picture p235: assets/MaslowCNC_Wisdom_Manual-assets/C381A4C3-4B7D-4DD8-892D-F8F277324CA2.webp]
C381A4C3-4B7D-4DD8-892D-F8F277324CA2


T10 Torx Driver. Quantity 1.
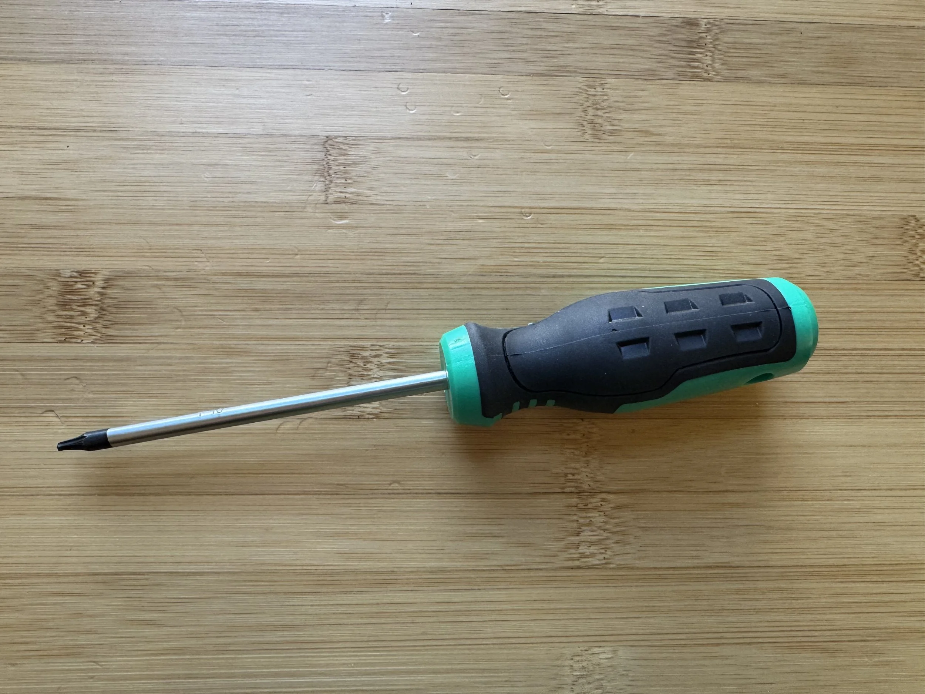
[picture p236: assets/MaslowCNC_Wisdom_Manual-assets/47811757-CD7B-4B3C-9B88-13B2481E961F_008.webp]
47811757-CD7B-4B3C-9B88-13B2481E961F_008


Encoder Magnet. Quantity 4. Properties: Magnetic.


Super Glue. Quantity 1. Properties: Gel


---

 ## Building the Maslow4 Frame

### Basic Guidelines:

Maslow4 is intentionally versatile. You can attach Maslow4 to any flat rigid surface with at least fifteen degrees of angle to it and so there is no “best” way to set your machine up. 

### Any flat rigid surface:

    Maslow4 needs four anchor points on any flat rigid surface. How flat? Reasonably flat. Maslow4 depends on the surface that it is sliding on to be flat so any bending in the surface that it is resting on will result in imperfect cuts. That being said the average garage floor or reasonably straight 2x4 is plenty flat.

How rigid? Maslow4 can pull with up to about 40lbs of force on it’s anchor points so it is important that the surface that Maslow4 is connected to not flex under that force. This is more important in the vertical configuration where the stresses due to gravity are quite different at the top of the sheet than at the bottom of the sheet. In the horizontal configuration the forces are more similar everywhere.

### Horizontal vs Vertical: 

Maslow4 will work at any angle from horizontal up to about 20 degrees from vertical. Maslow4 was originally designed for the vertical orientation and the fact that it will work horizontally was more of an afterthought, but we’ve really started to enjoy using it in the horizontal orientation too. One option is not better than the other, whichever one fits your work space better 

### How do the belts attach?

Each of Maslow4’s belts terminate with a belt end ring which can be attached to an anchor point. The hole in the end of this part is 10mm or 3/8ths inches and can attach to a 10mm or 3/8ths inch bolt. It’s preferable if the bolt is smooth, but it will still work if the bolt is threaded.

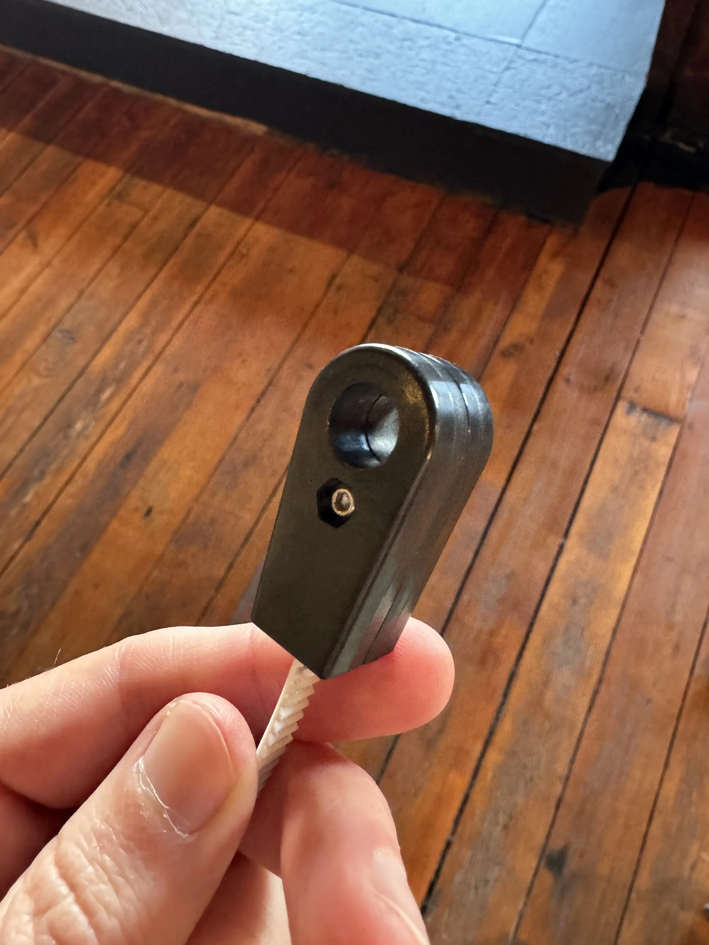
[picture p237: assets/MaslowCNC_Wisdom_Manual-assets/4700724E-439F-451D-B10E-B73C26CB7475.webp]
4700724E-439F-451D-B10E-B73C26CB7475


The end of the belt can be connected to a bolt, a shoulder bolt, or a quick release pin.
6E78B686-7B2F-4D6C-9158-38F5AF91A4A1_002

### Safety:

When attaching Maslow4 to a surface it’s important to ask “How bad would it be if I were to cut through the thing that I am cutting and hit this surface. If the answer is “Very bad” then it’s not a great surface to cut on. Generally there is a “spoil board” under the piece of wood being cut which protects the underlying surface, but mistakes can happen.

## Attaching Maslow4 Directly to the Floor

 If your work space has a concrete floor that you can attach things to, consider attaching Maslow4 directly to that surface. This is the simplest and cheapest option, while at the same time taking up the least amount of work space when the machine is not in use. 

The very simplest cheapest, and strongest, version of this is to use 3/8ths inch drop in anchors which mount directly to the concrete itself.

Then when the machine is not in use it has almost no footprint and when it is in use you have the most rigid and durable frame possible. We used these anchors, but there are many comparable options out there. https://www.grainger.com/product/DEWALT-Expansion-Anchor-3-8-16-Thread-30RZ53
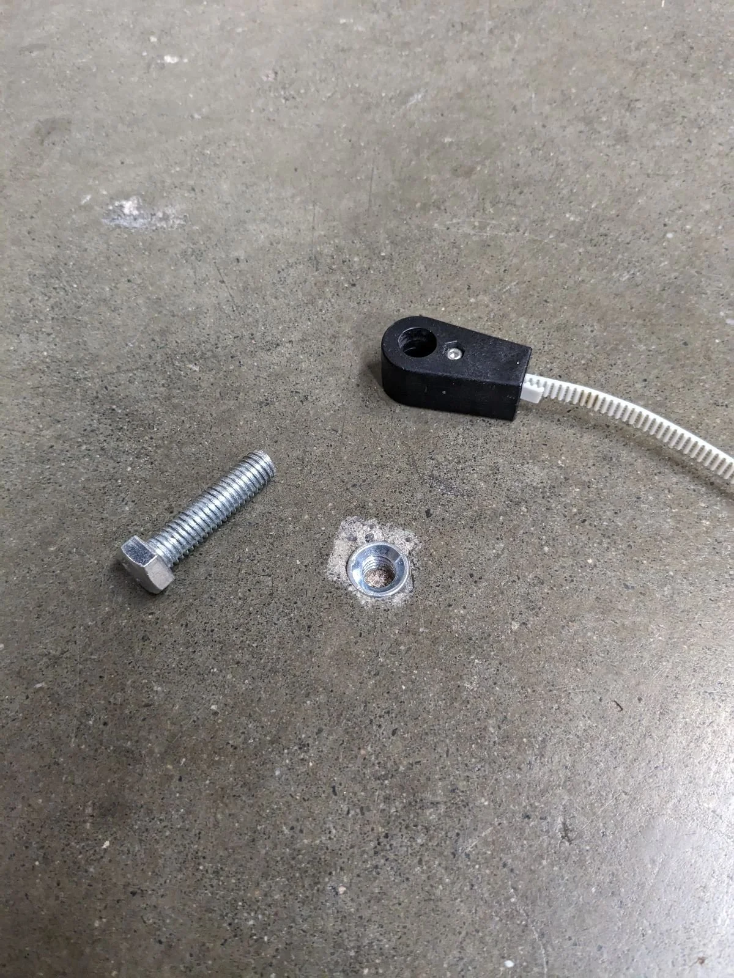
[picture p238: assets/MaslowCNC_Wisdom_Manual-assets/1000012945_008.webp]



If you cannot drill into the floor itself you can use 3D printed anchor points which can be glued to the floor. These also work well, but leave a tripping hazard when the machine is not in use.
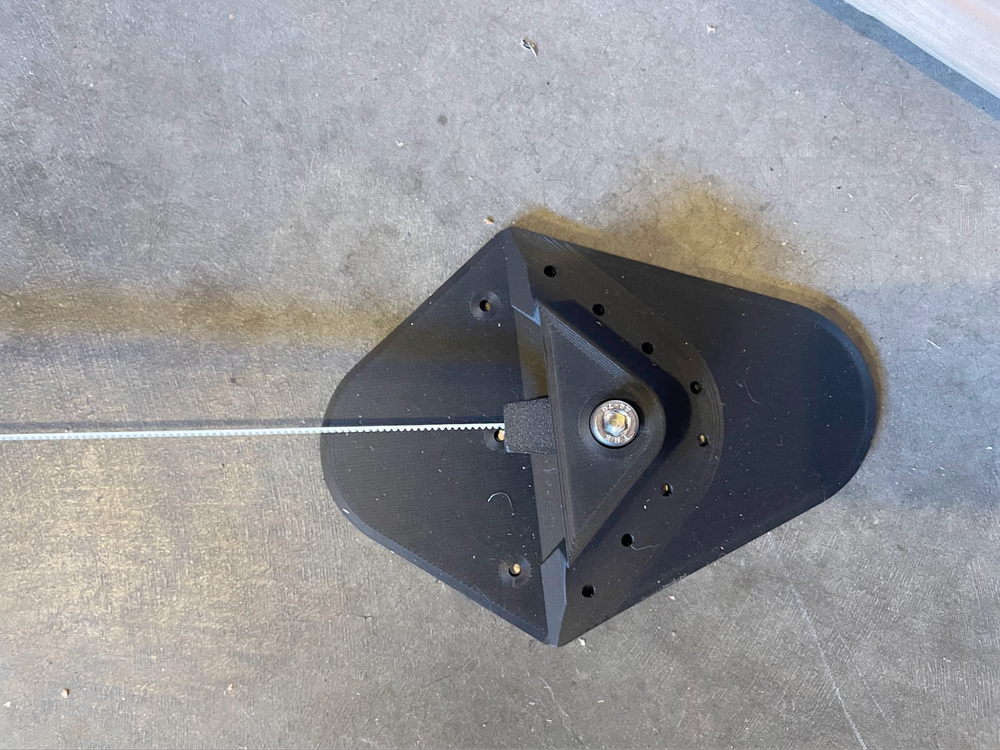
[picture p239: assets/MaslowCNC_Wisdom_Manual-assets/image1.webp]

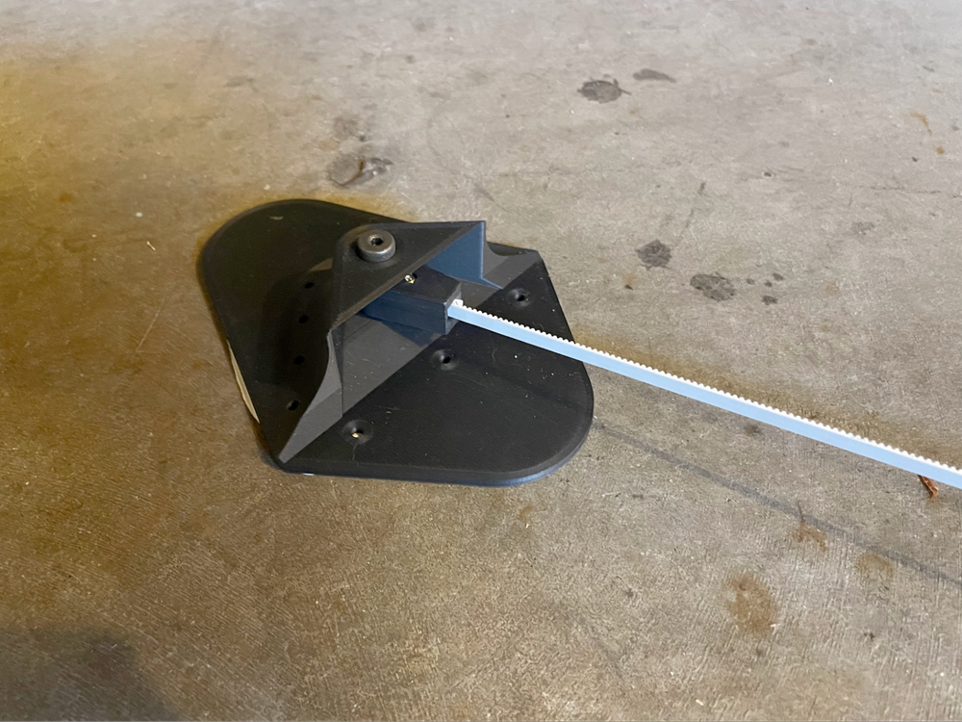
[picture p240: assets/MaslowCNC_Wisdom_Manual-assets/image2.webp]

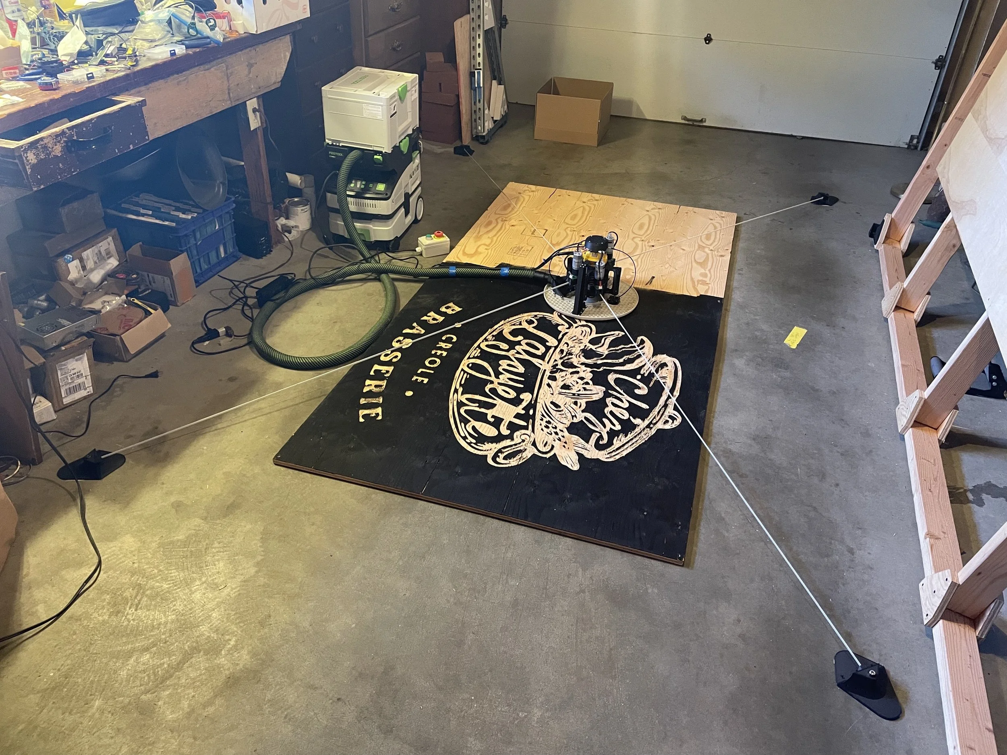
[picture p241: assets/MaslowCNC_Wisdom_Manual-assets/IMG_1728_003.webp]


In this case I put my anchor points the long way in the garage, but if I were to do it again I would put them the other way so that they would be all the way by the walls so I wouldn’t need to step over them.

You want to place the anchor points on the floor in a roughly rectangular shape 8’x12’ (2.5x3.5m). Consider running the anchors horizontally across your space so that the anchors can be tucked back against the walls or under work benches where they won’t be under foot.

This design uses these 3D printed anchor points. If you have a 3D printer you can print your own for about $2 each, or if you don’t have a 3D printer you can take the .STL files and get them printed by craftcloud3d.com for around $7.50 each. This 3D printed part is designed to use this quick release pin, but any 10mm pin will work.
https://www.maslowcnc.com/s/Floor-Mount-Quick-Release-Anchor-Point.stl
https://craftcloud3d.com/
https://www.amazon.com/gp/product/B0BWYLVNWS

We’re working on getting kits of these parts for sale in our store.

There are more options for frames depending on your situation and space.  These are listed and documented in the Frame Library Section. 

---

## Basic Wooden Frame Directions

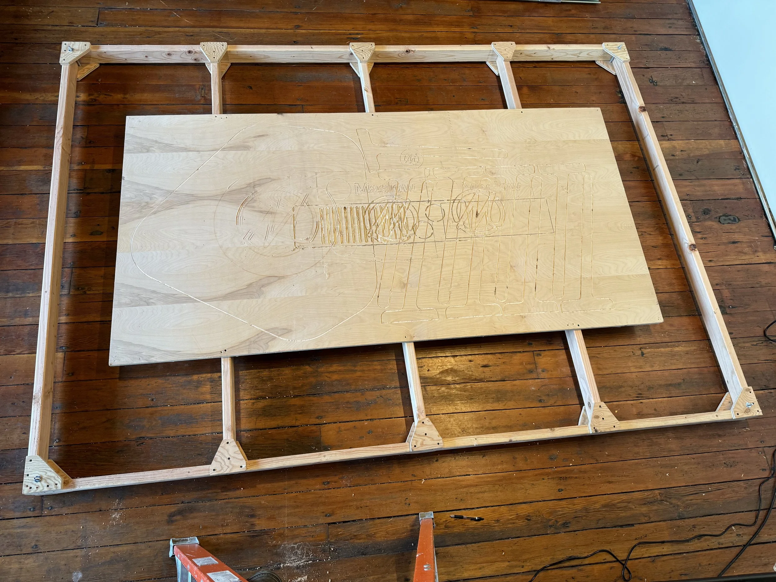
[picture p242: assets/MaslowCNC_Wisdom_Manual-assets/90797204-6F40-4B60-8F33-F2EB10633B80_008.webp]
90797204-6F40-4B60-8F33-F2EB10633B80_008


If attaching Maslow4 to your floor is not an option, here are the plans for the basic frame that we have been using which has worked well for us. This frame is made from 2x4 lumber which is pretty universally available and affordable. We’re going to show plans for the most basic version of this frame, and then a couple optional upgrades if you want. The materials are listed for US sizes, but very comparable materials exist in metric sizes (ie 18mm plywood instead of 3/4).

### Material List

    - 2 count 10 ft 2x4s ($12.68 at Home Depot - They don’t seem to have fir, but it would be fine)
    - 5 count 8 ft 2x4s ($3.28 at Home Depot)
    - 1 box of 1 and 5/8ths inch drywall screws ($7.58 at Home Depot)
    - 2 count sheets of ¾ inch plywood 
    - 4 count  3/8ths by 6” bolts ($1.43 at Home Depot)
    - 4 count 3/8ths Tee Nuts
    - 4 count 3/8ths Wing Nuts ($1.38 at Home Depot)
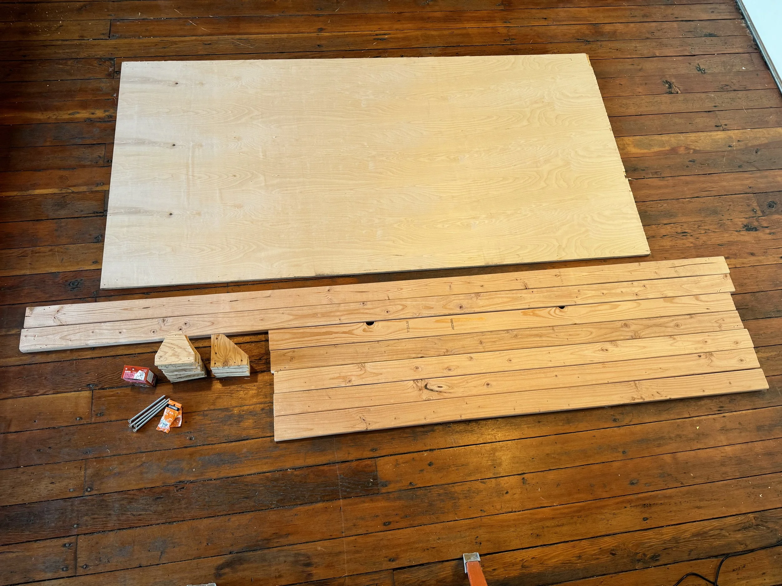
[picture p243: assets/MaslowCNC_Wisdom_Manual-assets/899F88F4-C47C-4E2C-88D3-2D28D01D6D31_003.webp]
899F88F4-C47C-4E2C-88D3-2D28D01D6D31_003

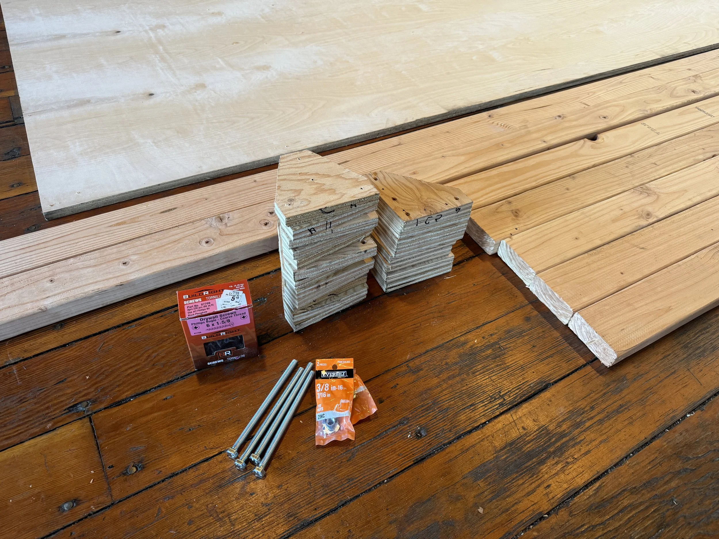
[picture p244: assets/MaslowCNC_Wisdom_Manual-assets/42F282D7-5E6A-47E4-BA33-A9E156E9D1E6_008.webp]
42F282D7-5E6A-47E4-BA33-A9E156E9D1E6_008


### Tools

    - Drill (With 3/8ths drill bit and fillips screw bit)
    - Saw (Anything that can cut plywood)
    - Carpenters Square
    - Tape Measure

### Instructions

1 - Using a saw cut 8x of the corner plates and 12x of the inside plates

Click here for printable templates for the Corner Plate (metric version)
[https://www.maslowcnc.com/s/Corner-Plate-Metric.pdf](url)
and the Inside Plate (metric version) 
[https://www.maslowcnc.com/s/Inside-Plate-to-Scale.pdf ](url). 
Print this on 8 1/2” by 11” paper or A4 Paper. The exact shape and dimensions of these parts absolutely do not matter. You can cut them by hand without measuring anything if you would like. Note that the circles on these parts are the approximate screw locations and do not need to be drilled.
42F282D7-5E6A-47E4-BA33-A9E156E9D1E6_008

2 - Stack the corner parts in groups of two and drill a 3/8ths hole in each stack two inches from each edge
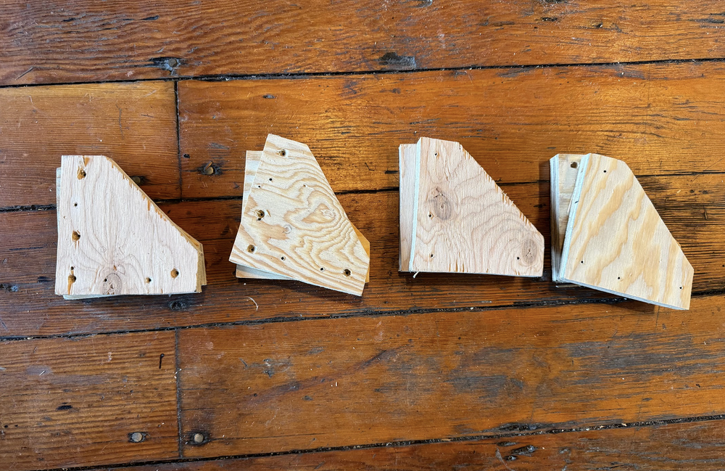
[picture p245: assets/MaslowCNC_Wisdom_Manual-assets/Screenshot_2024-01-09_at_4_15_02_PM.webp]
Screenshot+2024-01-09+at+4 15 02+PM


3 - Insert a 3-8ths inch tee nut into one of each pair of corner plates
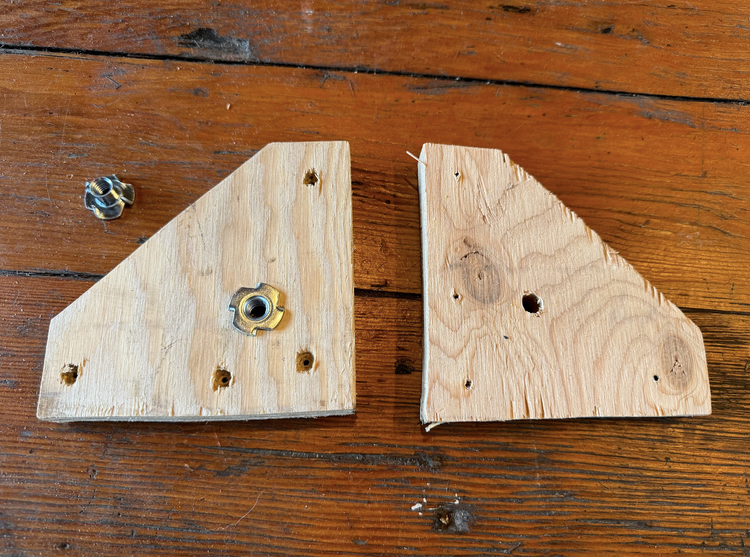
[picture p246: assets/MaslowCNC_Wisdom_Manual-assets/Screenshot_2024-01-09_at_4_20_55_PM_007.webp]
Screenshot+2024-01-09+at+4 20 55+PM_007

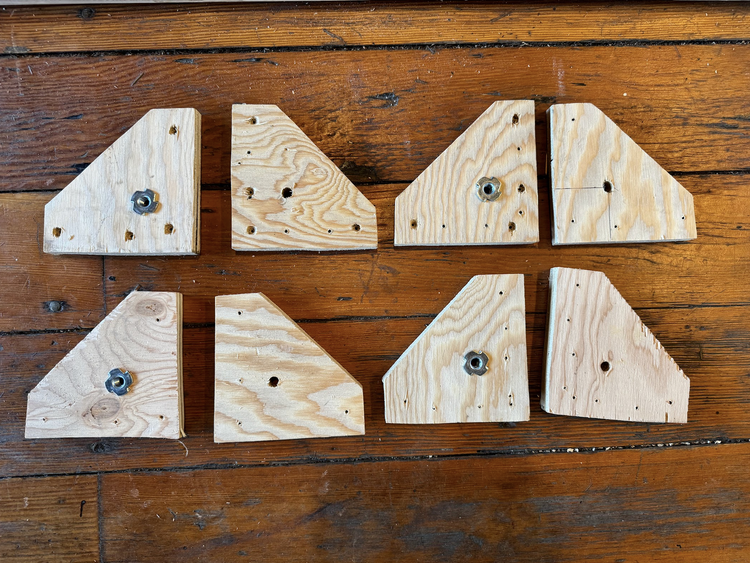
[picture p247: assets/MaslowCNC_Wisdom_Manual-assets/Screenshot_2024-01-09_at_4_21_10_PM_006.webp]
Screenshot+2024-01-09+at+4 21 10+PM_006


4 - On a flat surface, layout the two 10 ft 2x4s parallel to each other roughly 8 ft apart. The 2 inch sides should be facing up.

Place one of the corner plates with the tee nut installed under each end and then place an 8’ 2x4 between them on each side.
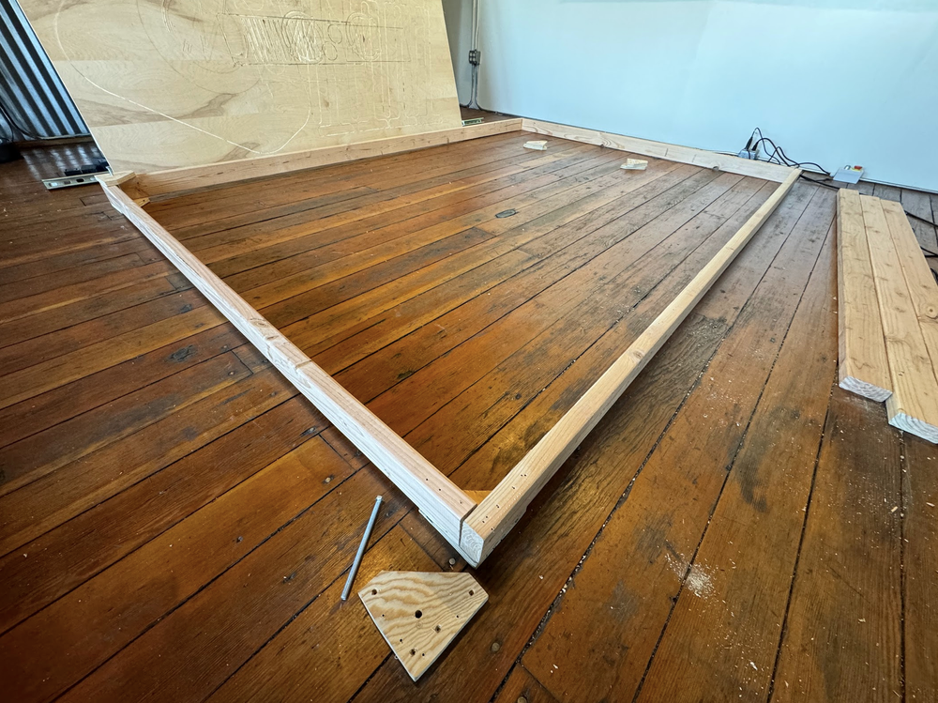
[picture p248: assets/MaslowCNC_Wisdom_Manual-assets/Screenshot_2024-01-09_at_3_56_02_PM.webp]
Screenshot+2024-01-09+at+3 56 02+PM


5 - Layout the five 8 ft 2x4s between the 10 ft pieces perpendicularly. The 2 in sides should  be facing up. There should be one at either end to create a rectangle and three evenly spaced in the middle.

The exact spacing of these braces is not critical. Here is an illustration of the recommended spacing, but if your lumber is a slightly different length do not worry. What we are going for is a roughly even spacing.
Maslow+Frame+Drawing_002

open this drawing (imperial) https://www.maslowcnc.com/s/Maslow-Frame-Drawing.png

open this drawing (metric) https://www.maslowcnc.com/s/Maslow-Frame-Metric.pdf

6 - Using a carpenter's square to make sure the corners are roughly 90 degrees, screw one Corner Plate to each corner of the frame. Use 2 screws for each 2x4 following the layout shown in Detail A. Each plate receives 4 screws
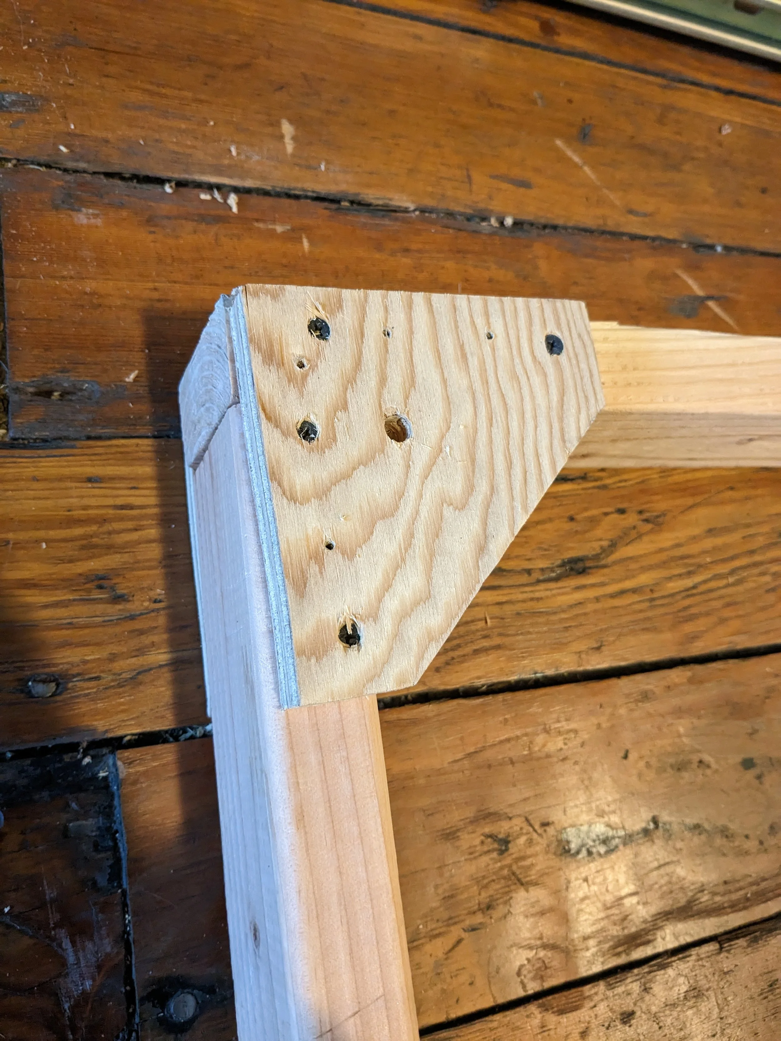
[picture p249: assets/MaslowCNC_Wisdom_Manual-assets/PXL_20231220_233225139_003.webp]


7 - Using a carpenter's square to make sure the 2x4s are roughly 90 degrees, screw one Inside Plate to each intersection of 8ft and 10ft 2x4s. Use 2 screws for each 2x4 following the layout shown in Detail A. Each plate receives 4 screws
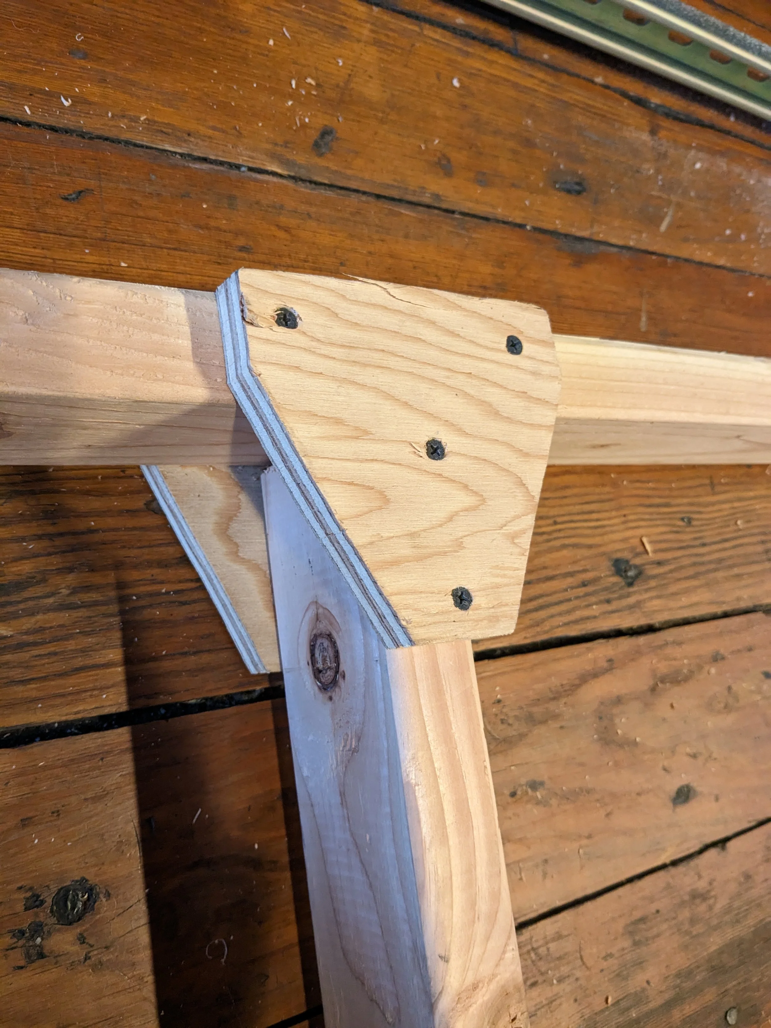
[picture p250: assets/MaslowCNC_Wisdom_Manual-assets/PXL_20231220_233231011_003.webp]


8 - Flip the frame over so that the newly attached plate are facing down

* Tip: Please ask someone to help with this part. This thing is big and awkward to move.

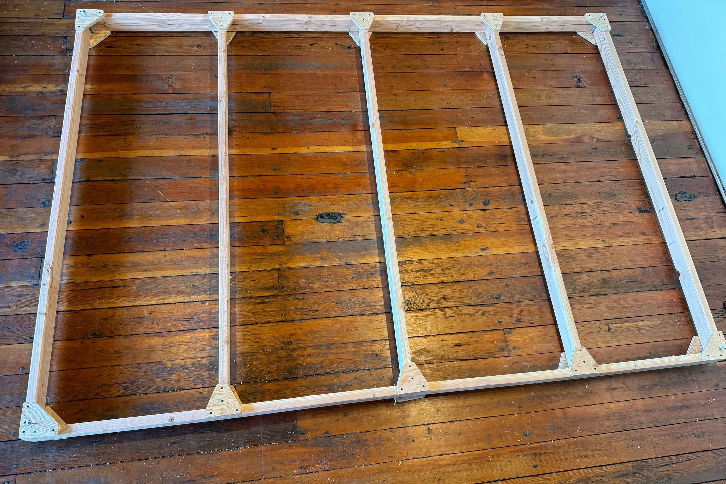
[picture p251: assets/MaslowCNC_Wisdom_Manual-assets/5E9E41D2-EF00-4EDB-9C93-863DAC9E70FD_002.webp]
5E9E41D2-EF00-4EDB-9C93-863DAC9E70FD_002


9 - Screw one Corner Plate to each corner of the frame. Use 2 screws for each 2x4 following the layout shown in Detail A. Each plate receives 4 screws

10 - Screw one Inside Plate to each intersection of 8ft and 10ft 2x4s. Use 2 screws for each 2x4 following the layout shown in Detail A. Each plate receives 4 screws

11 - Center the remaining piece of ¾” plywood in the frame to create a spoil board..
90797204-6F40-4B60-8F33-F2EB10633B80_003

12 - Screw the plywood to the 2x4s underneath using 2 screws per 2x4, one on either side of the plywood board. There will be 6 screws in the spoil board in total. 
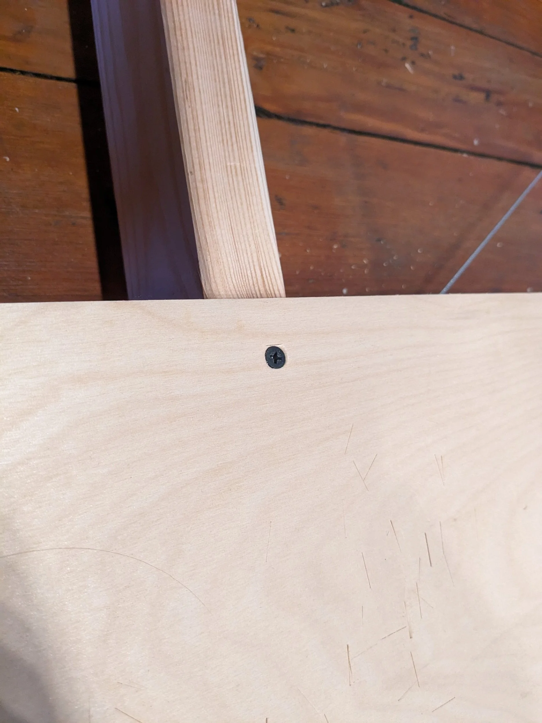
[picture p252: assets/MaslowCNC_Wisdom_Manual-assets/PXL_20231220_234115425_MP_008.webp]
PXL_20231220_234115425 MP_008


13 - Thread the 3/8ths inch bolts through the frame and into the tee nut. Then flip the frame over and thread the bolts all the way through so that they protrude.
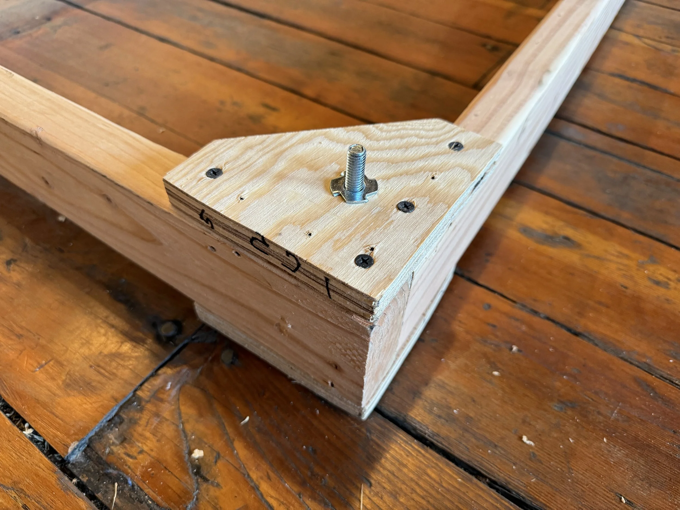
[picture p253: assets/MaslowCNC_Wisdom_Manual-assets/E080EB3F-7F0D-49AF-A43D-6353258A6639_008.webp]
E080EB3F-7F0D-49AF-A43D-6353258A6639_008


These will server as the anchor points for the machine. 


14 - Done! Modify as needed.

This is a rough guide to make a frame. If you have room you can use 12’ 2x4s to get even better performance or you can make your frame smaller if needed. Maslow4 is designed to work with any flat rigid surface so a lot of variation is possible.

**Optional Upgrades**

- A 3D printed belt end anchor for bolts or pins can be screwed to the corner plates
- You can find a 3d printable file for our quick release anchor point on the maslow website.
- Add cross bracing with a gate kit to increase frame rigidity
- Suspend the frame on hooks or pulleys for storage

---

## Maslow 4 Assembly Guide

Maslow4 is designed to be assembled in a weekend using only the provided Allen or Torx wrench. 

03CAB142-539C-4F23-9D0B-D1F9354CCF55

The assembly process is broken down into four steps. The assembly process is very similar for Maslow 4 and 4.1, but since some parts look slightly different we have created two sets of instructions. You can find step by step instructions and a video for each part here:

    1. Background and Context: 4.0 and 4.1
    2. Assembling the arms: 4.0 and 4.1
    3. Assembling the sled: 4.0 and 4.1
    4. Assembling the router: 4.0 and 4.1
    5. Putting it all together: 4.0 and 4.1

4.0 instructions will be first.  Scroll down to find all of the 4.1 instructions together. 


## 4.0 Assembly Instructons Background and context

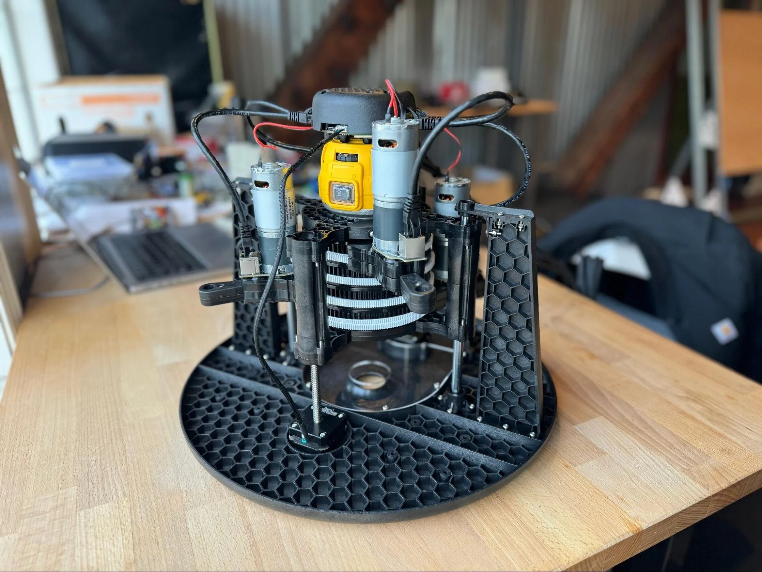
[picture p254: assets/MaslowCNC_Wisdom_Manual-assets/image5.webp]


The Maslow4 design has evolved significantly since we launched the Kickstarter. We are proud of every change and improvement that we’ve made. Maslow4 is a substantially better machine than what we initially promised as a result…but the changes have led to some chaos in the hardware bag.

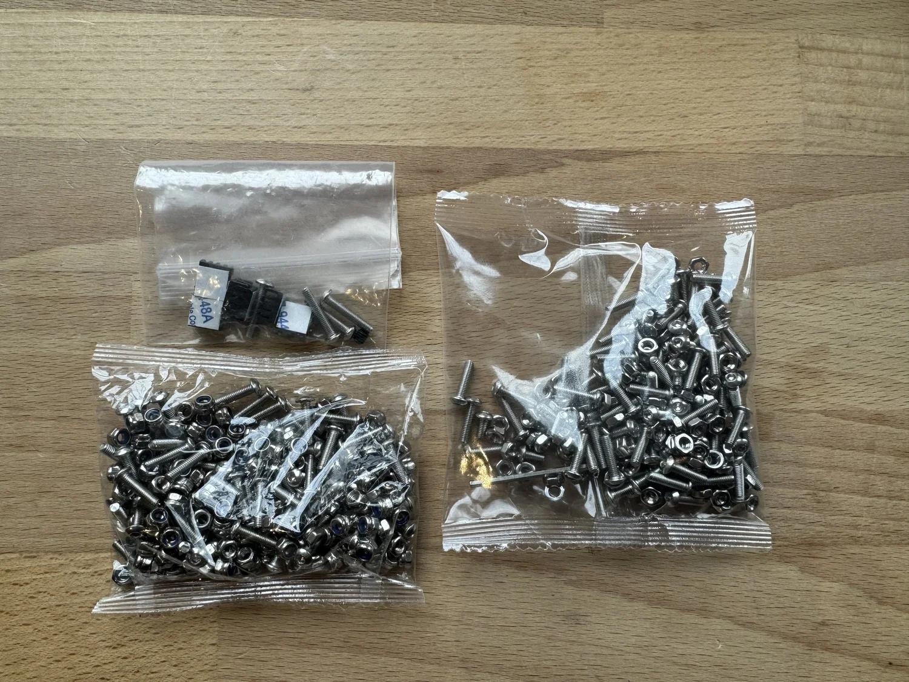
[picture p255: assets/MaslowCNC_Wisdom_Manual-assets/IMG_3266_003.webp]


Maslow4 includes three hardware bags each of which reflects the changing design needing more and different hardware. 

Initially Maslow4 used regular nuts, but we decided to offer locking nuts as well. Unless the type of nut is specified feel free to use either. 

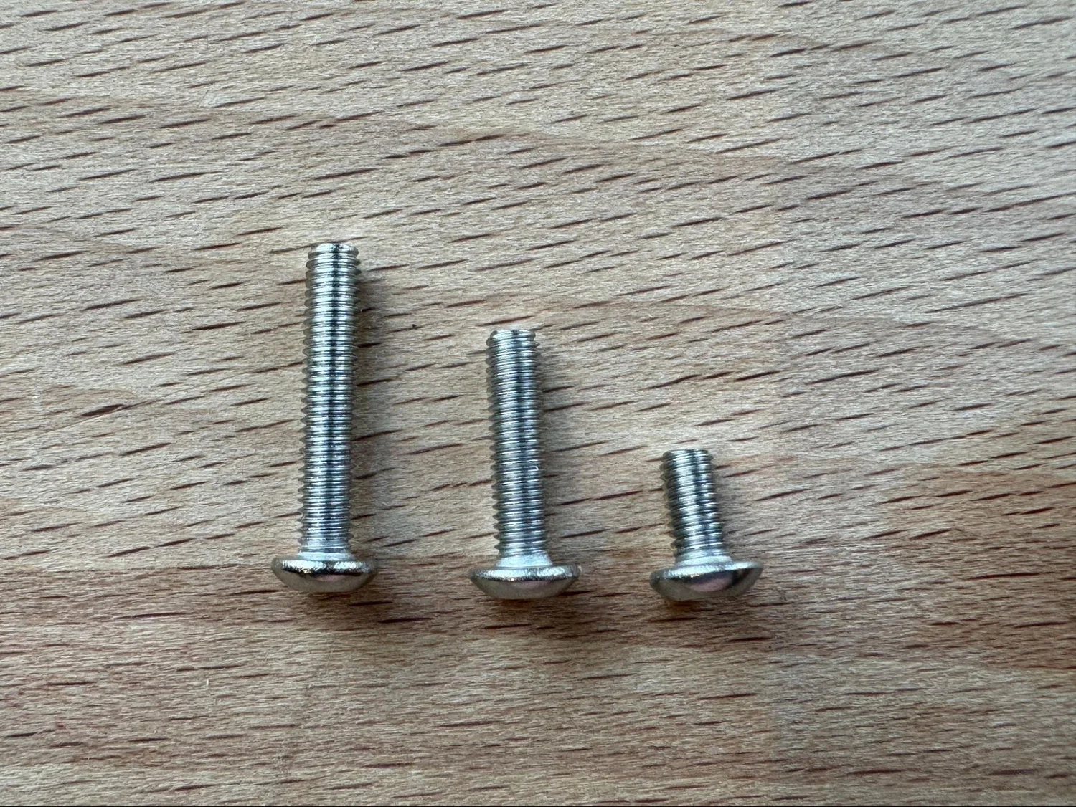
[picture p256: assets/MaslowCNC_Wisdom_Manual-assets/image2_002.webp]


Wherever possible Maslow4 is designed to be put together with a single length of bolt (the versatile M3x12mm) to make assembly and maintenance easy. For the most part we have succeeded in that, however there are two places where a different length of bolt are needed. The shorter M3x6 are used to attach the stepper motors due to space constraints, while the longer M3x16 are used to attach the cooling fan due to a miscommunication with the fan manufacturer. We’ll get that one removed down the road.

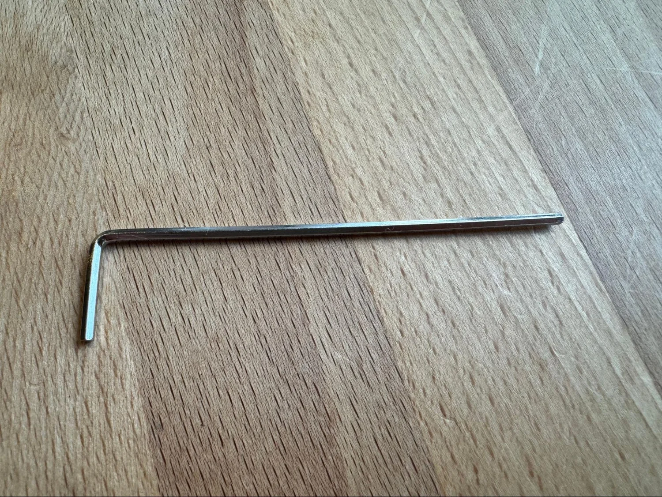
[picture p257: assets/MaslowCNC_Wisdom_Manual-assets/image3_003.webp]


We have succeeded in making it so that you only need one tool (the included 2mm allen wrench) to assemble the entire machine, although a blunt object like a hammer is helpful to GENTLY coax some of the stiffer parts into place.

Wherever possible we’ve tried to make it so that things can only go together in one clear way.

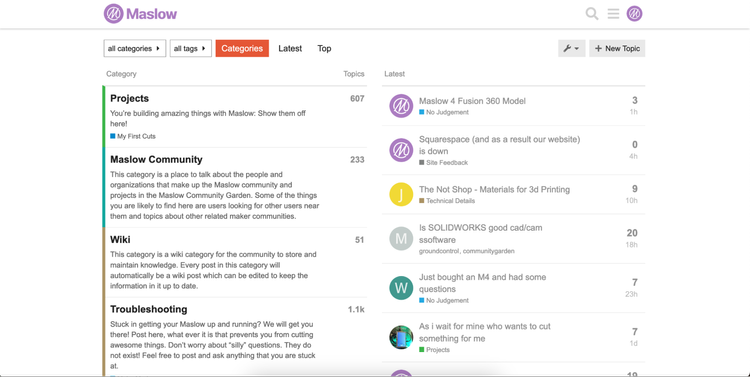
[picture p258: assets/MaslowCNC_Wisdom_Manual-assets/image4.webp]


If at any point we’ve failed to make a step in the instructions sufficiently clear let us know in the forums! If something was unclear to you it’s almost certainly unclear to other folks too. Your feedback helps to improve the assembly process for everyone.

We would be especially interested to hear how difficult your found the process and how long it took. What age of kids do you think that Maslow4 would be an appropriate project for with parent supervision?

Finally, if you get stuck on something or have a question, the forums are also the best place to get a quick answer. The sum total of the Maslow community is astounding.

## Assembling the Arms

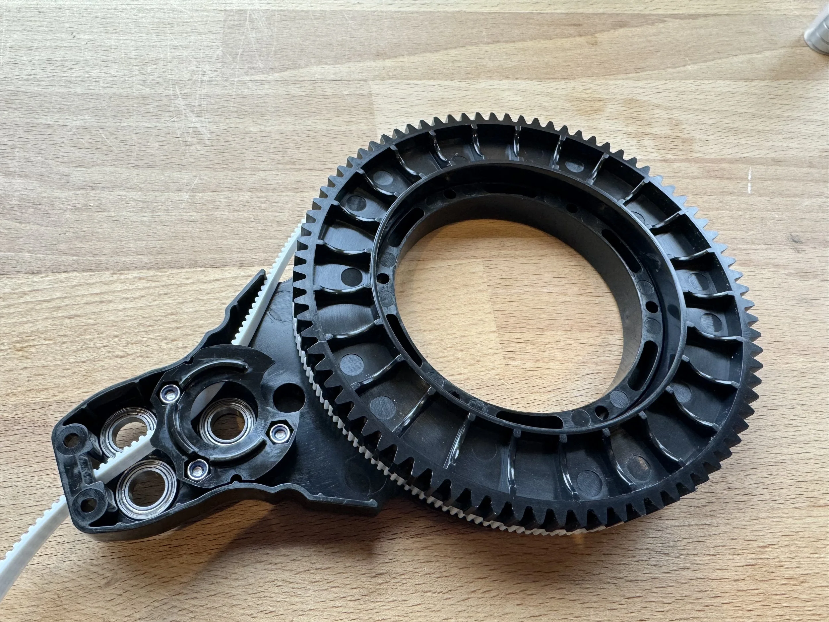
[picture p259: assets/MaslowCNC_Wisdom_Manual-assets/IMG_3168_2.webp]
IMG_3168+2


Maslow4 has a few parts that need to be glued so we will start there so that the glue can begin drying. In all of the cases where we use glue, the glue is not structural, it is just meant to hold parts in place that might move due to vibration. Use just a small amount of glue.

Assembling the arms is the most complex and difficult part of the Maslow4 build process so we’re going to jump right in and start there.

Find any of these steps confusing or get stuck? Don’t forget, you aren’t alone! Maslow is a community driven open source project. Ask in the forums and we’ll figure it out together!

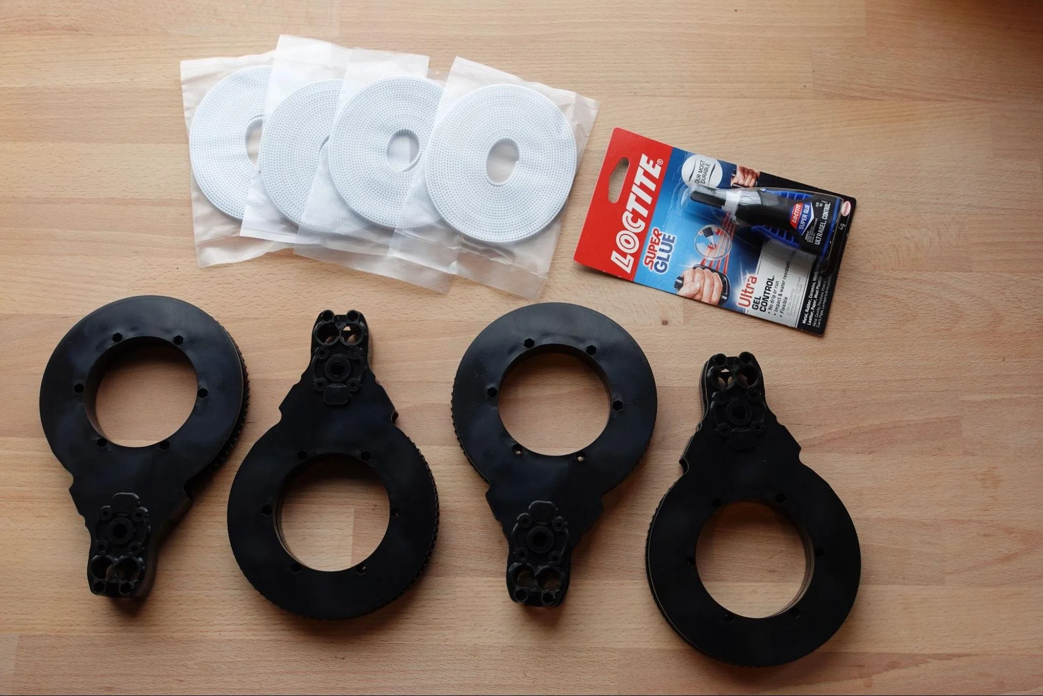
[picture p260: assets/MaslowCNC_Wisdom_Manual-assets/image23.webp]


First we will gather the four belts, the four arms, and the super glue which we will need for this step. The top and bottom halves of the arms are identical.

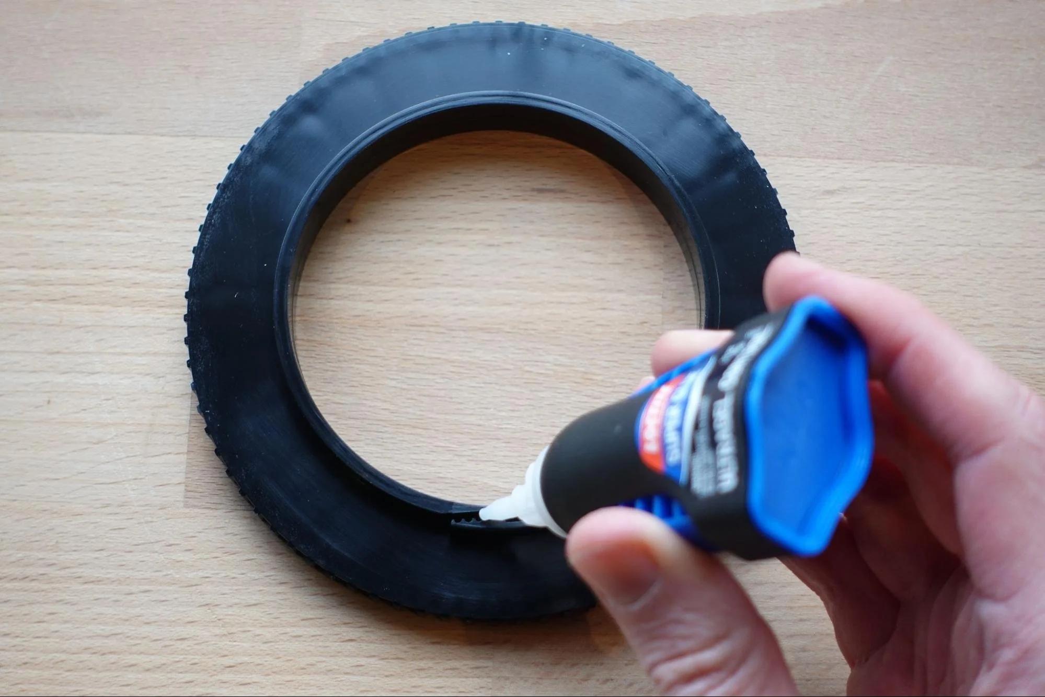
[picture p261: assets/MaslowCNC_Wisdom_Manual-assets/image31_007.webp]


Removing the spool from each arm, place a small drop of super glue in the slot where the belt will attach like this.

A couple notes on this section. The super glue is opened by twisting the top. One end of each belt might fit into the spool more easily than the other so it’s worth checking both ends before starting with the glue.

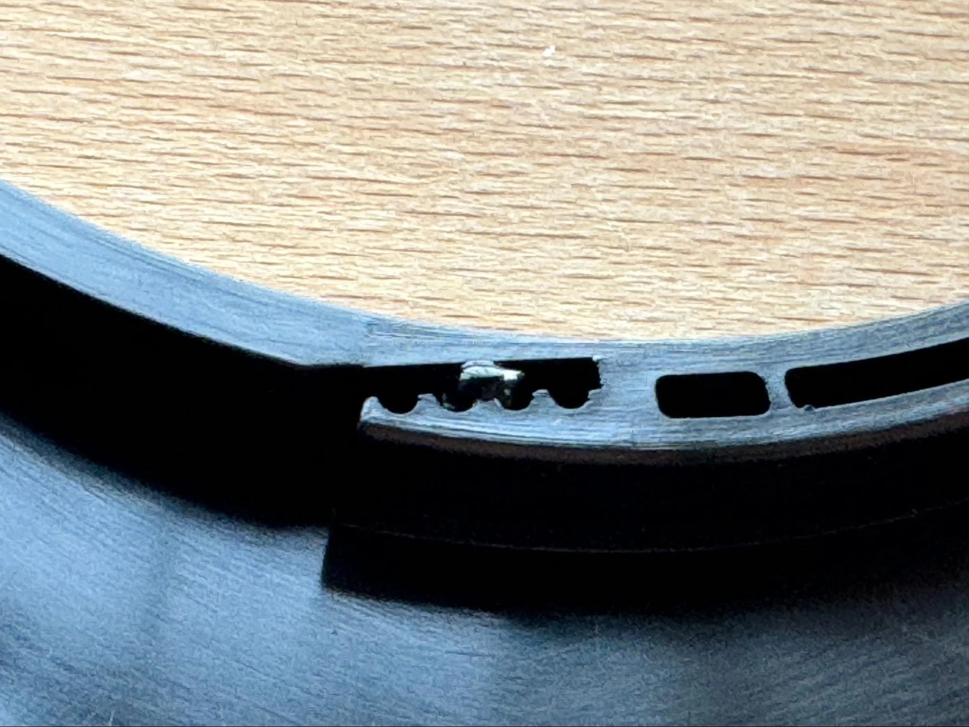
[picture p262: assets/MaslowCNC_Wisdom_Manual-assets/image6_004.webp]


You do not need to use much glue. A very small drop is fine. 

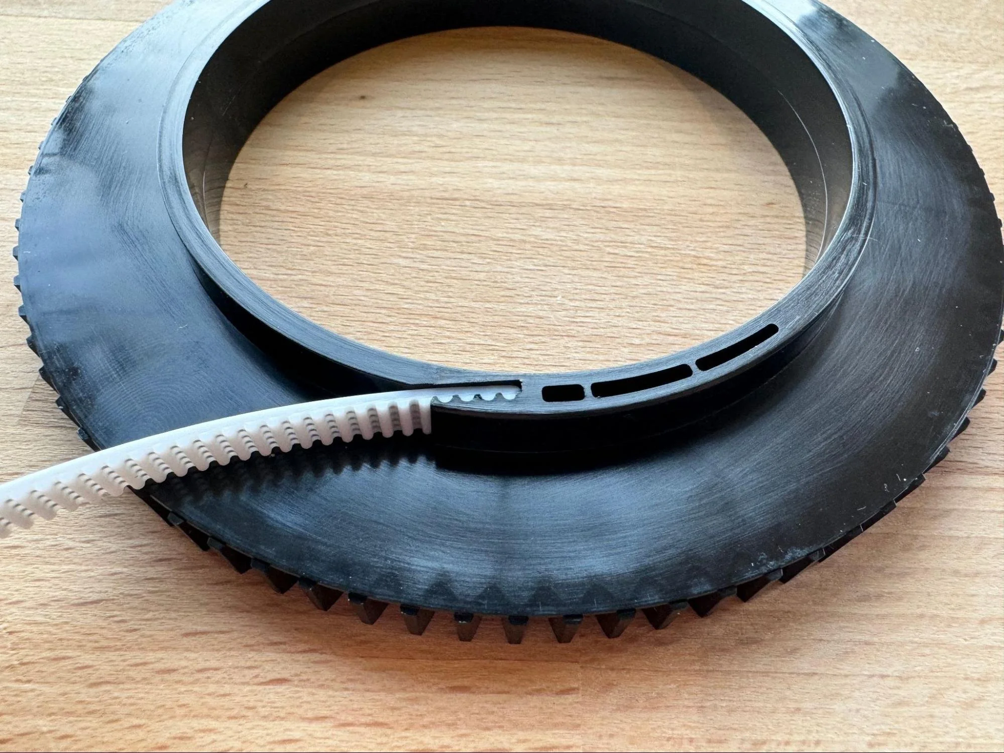
[picture p263: assets/MaslowCNC_Wisdom_Manual-assets/image17.webp]


Then press the belt fully into the slot. It should not stick above the top of the slot. 

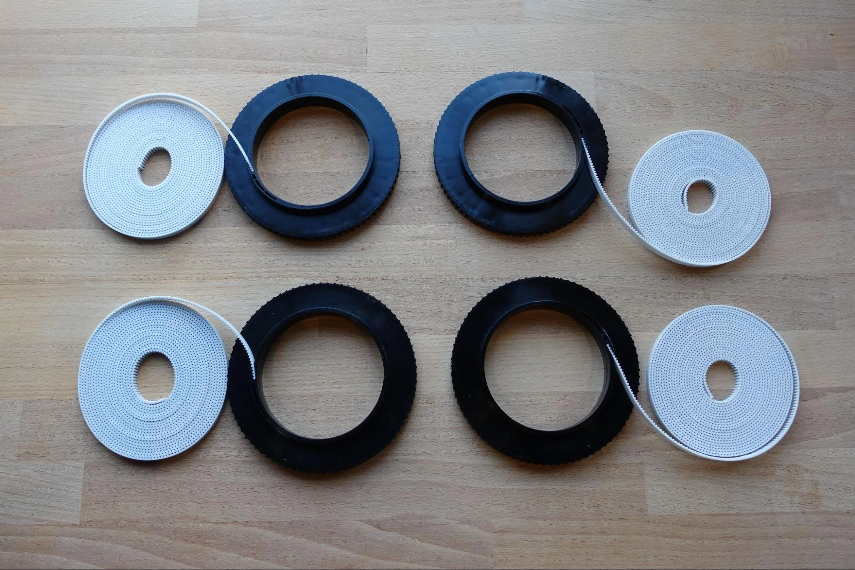
[picture p264: assets/MaslowCNC_Wisdom_Manual-assets/image2_1.webp]


Repeat this step for all four spools.

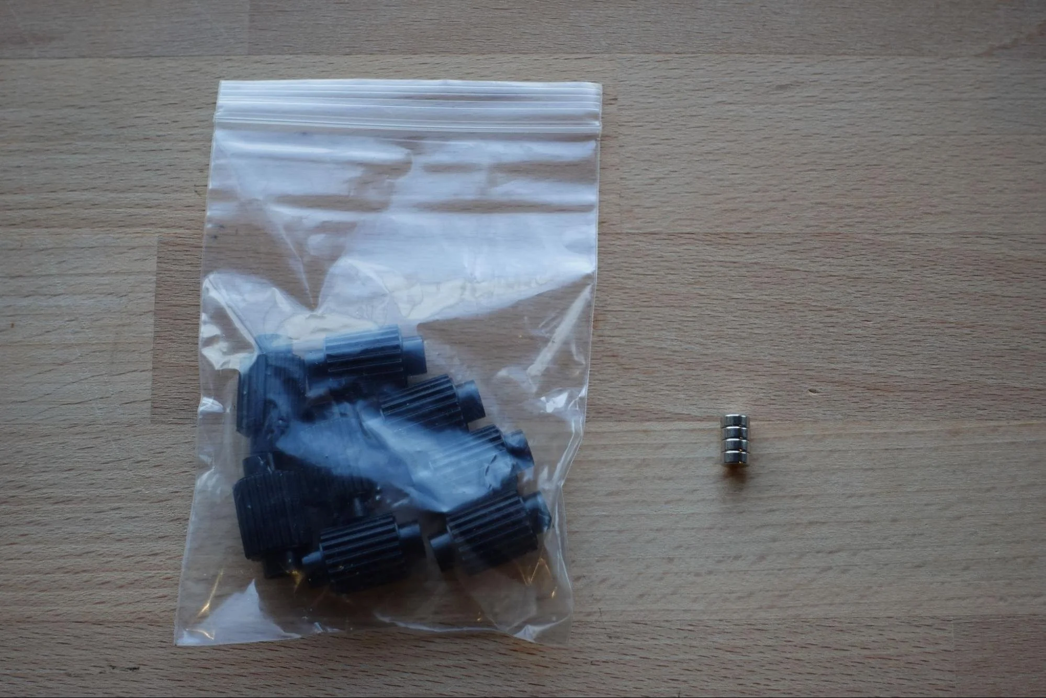
[picture p265: assets/MaslowCNC_Wisdom_Manual-assets/image14_007.webp]


Next we will glue the encoder magnets into the rollers. For this step we will need to gather the eight rollers and the four magnets.

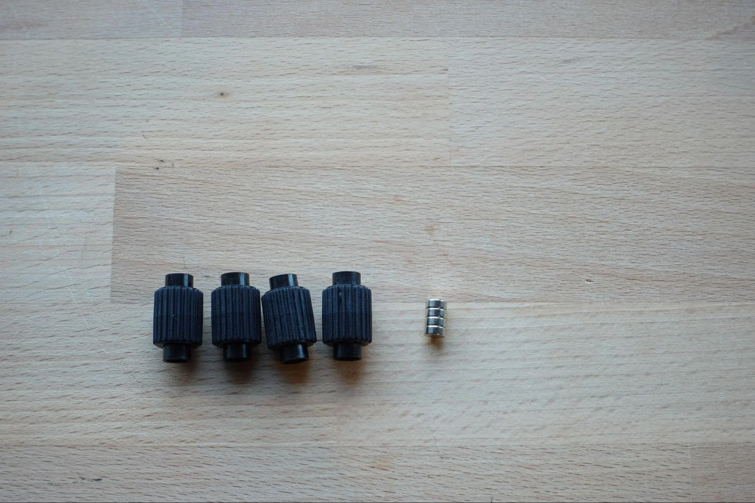
[picture p266: assets/MaslowCNC_Wisdom_Manual-assets/image12_003.webp]


We will just need four of them for this step:

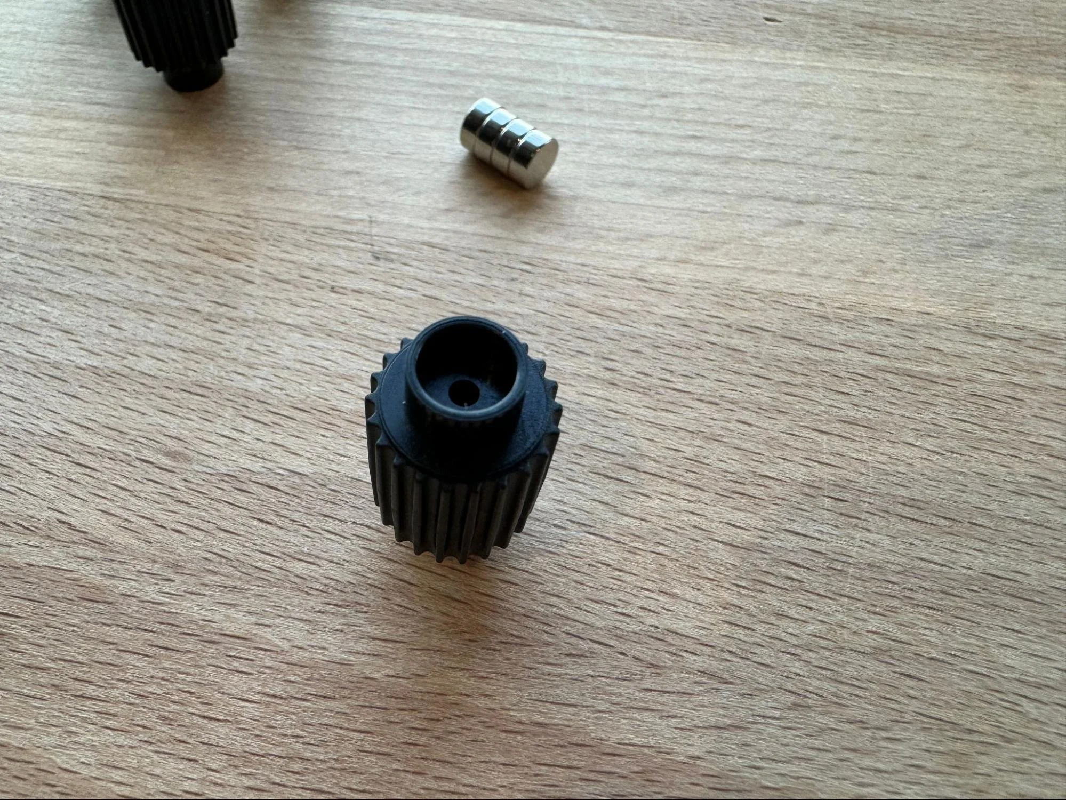
[picture p267: assets/MaslowCNC_Wisdom_Manual-assets/image30_008.webp]


Note that each roller has two ends. One end has a shallow recess to hold the magnet. That is the side we want to use.

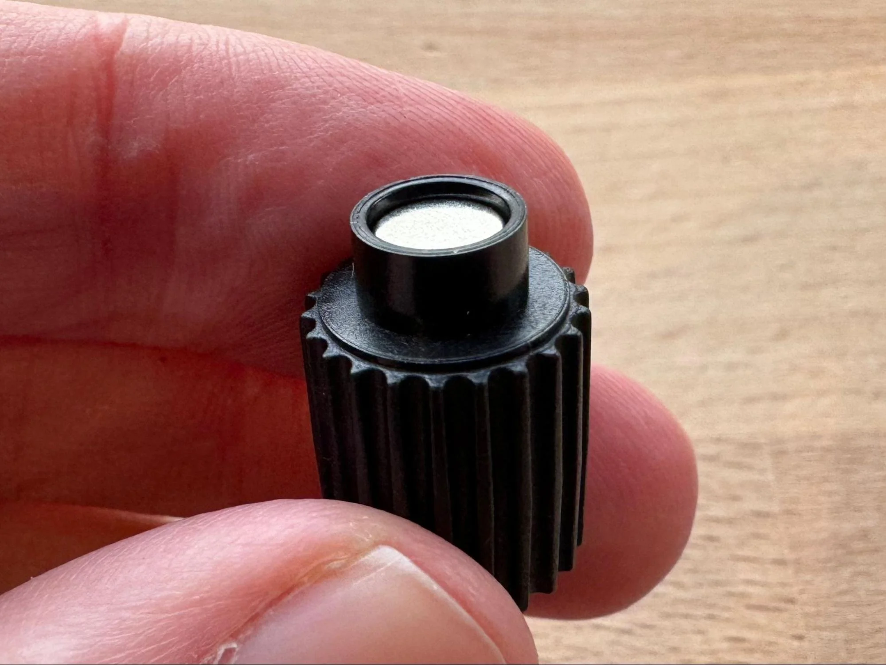
[picture p268: assets/MaslowCNC_Wisdom_Manual-assets/image11_002.webp]


Again using a drop of glue place a magnet in the end of each of the four rollers. Note that the magnet will be slightly recessed below the top of the roller. 

Be careful, the magnets will try to stick to things while the glue is drying.

The magnet is symmetrical so it can be placed in either orientation.

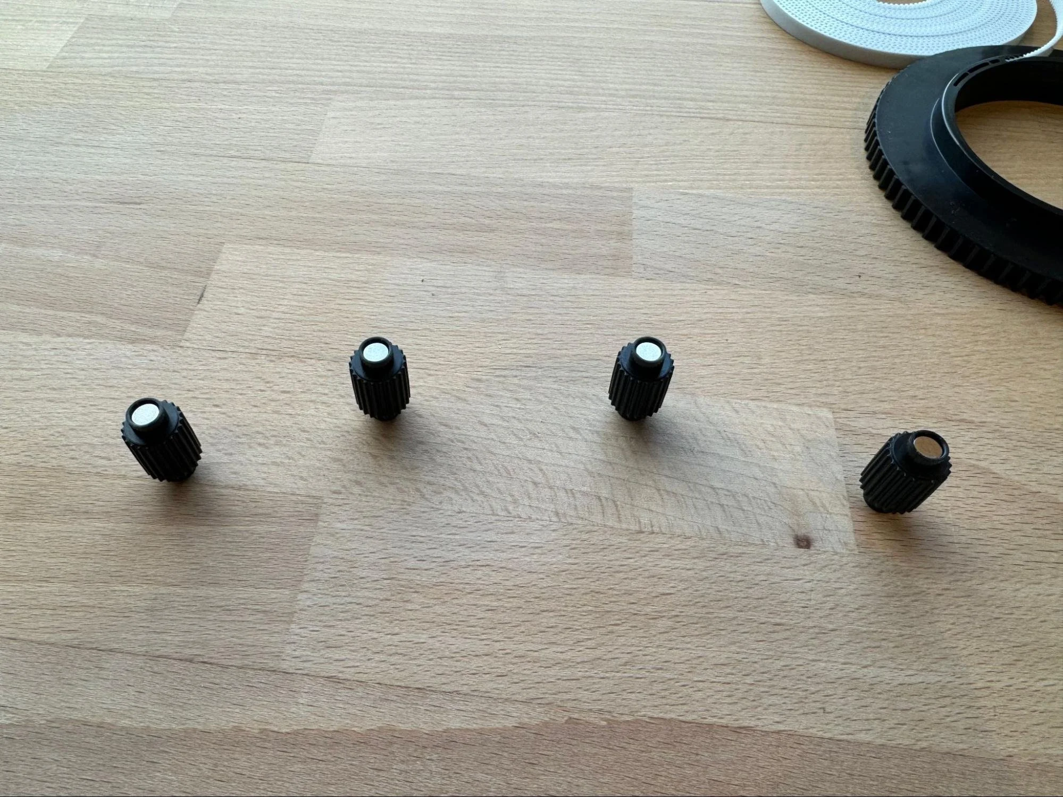
[picture p269: assets/MaslowCNC_Wisdom_Manual-assets/image22_008.webp]


Now set those aside to dry. Be careful not to put them too close together while drying because the magnets will attract and stick together. You have to place them further apart than you might expect. 

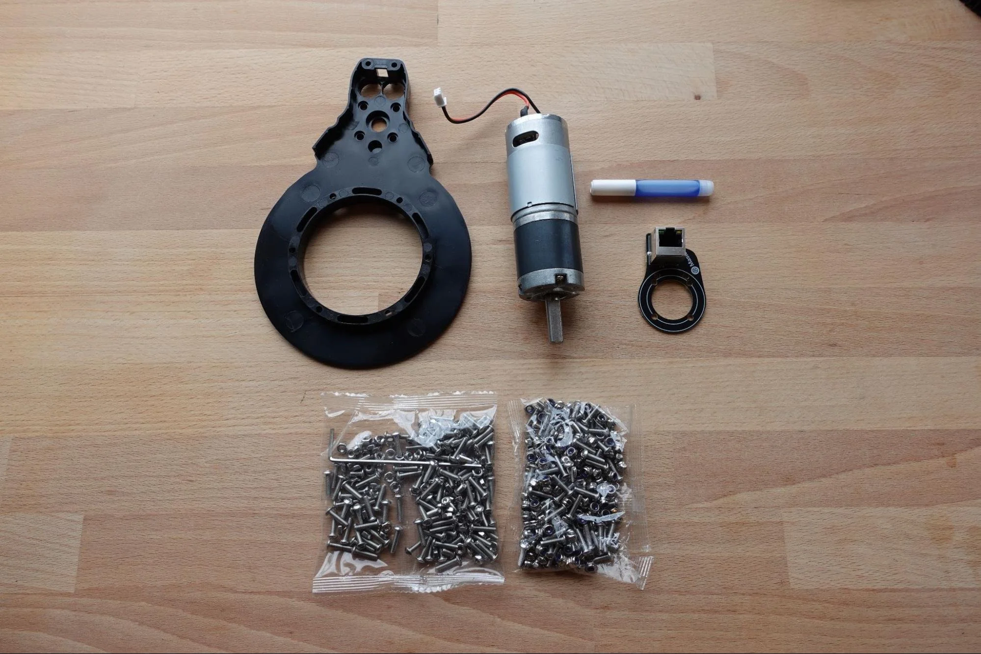
[picture p270: assets/MaslowCNC_Wisdom_Manual-assets/image34.webp]


Next, we can start working on assembling the rest of the arm. To do that we’re going to need to collect our hardware bags, our thread locker, a DC drive motor, and an encoder board.

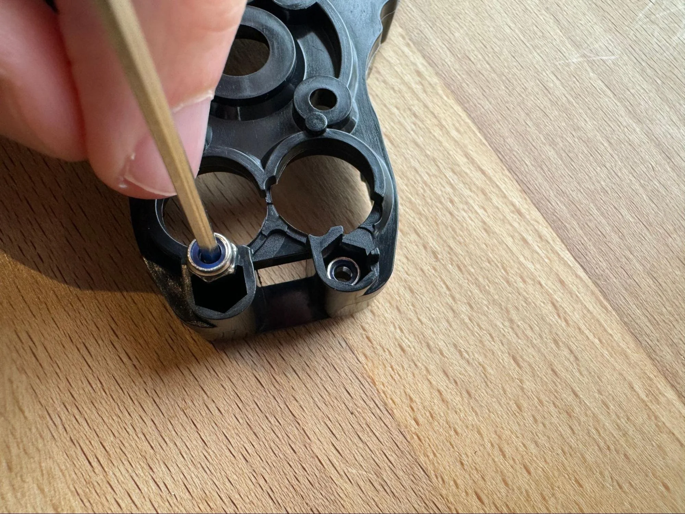
[picture p271: assets/MaslowCNC_Wisdom_Manual-assets/image25_008.webp]


The first thing that we are going to need to do there is to insert these two nuts into the end of the arm because they will be covered later when we need them. Don’t forget this step or you will have to backtrack a lot later (a mistake I’ve made many times). Using the allen wrench as a guide can help get them in place.

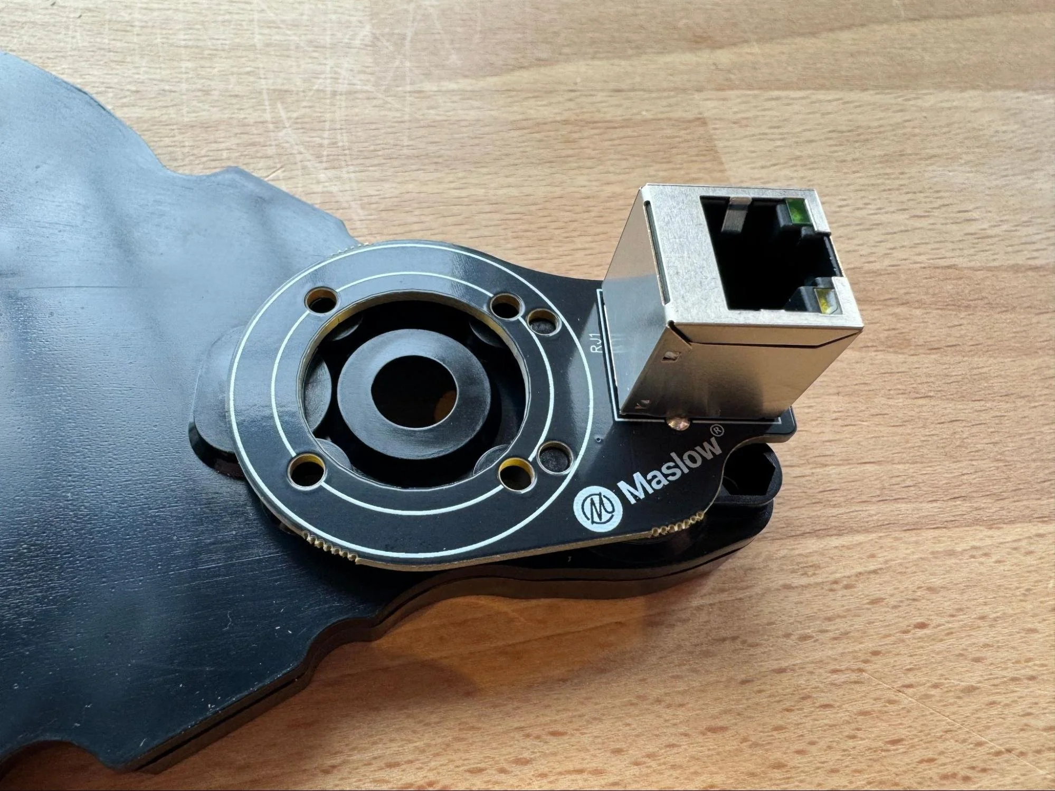
[picture p272: assets/MaslowCNC_Wisdom_Manual-assets/image32_008.webp]


Next place the encoder board over them. There are two guide pegs which will hold it in just the right place.

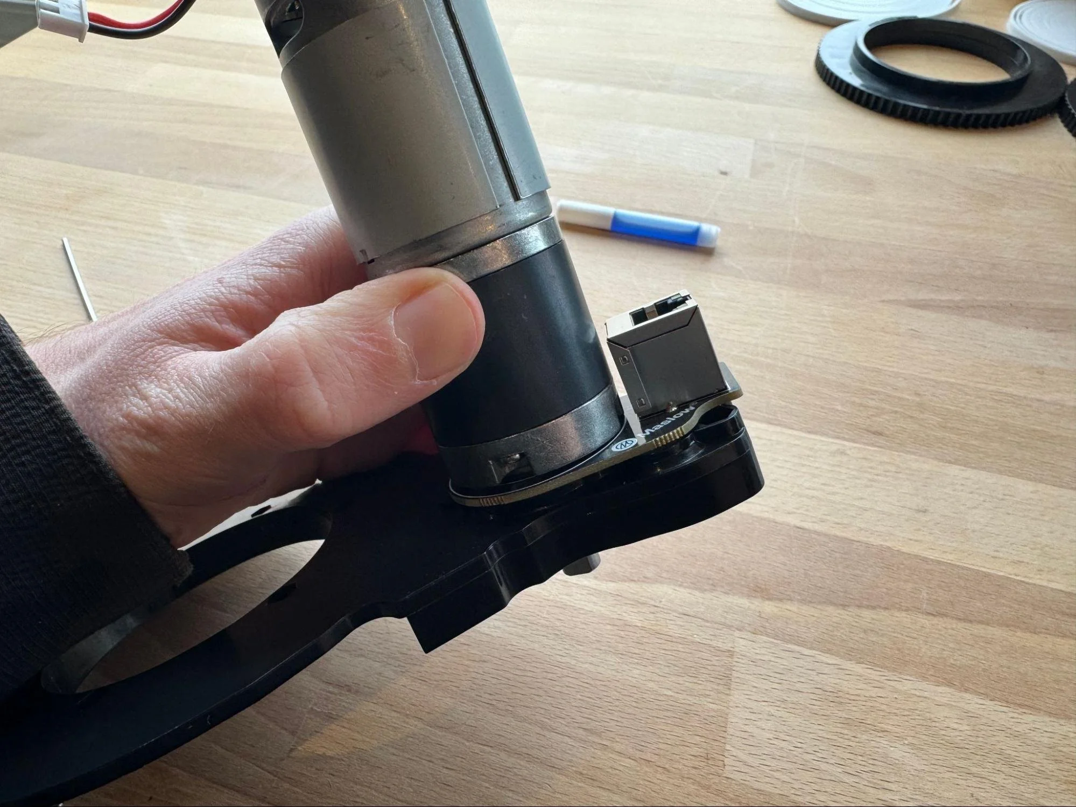
[picture p273: assets/MaslowCNC_Wisdom_Manual-assets/image29_008.webp]


Then place the motor over that. The orientation of the motor does not matter. 

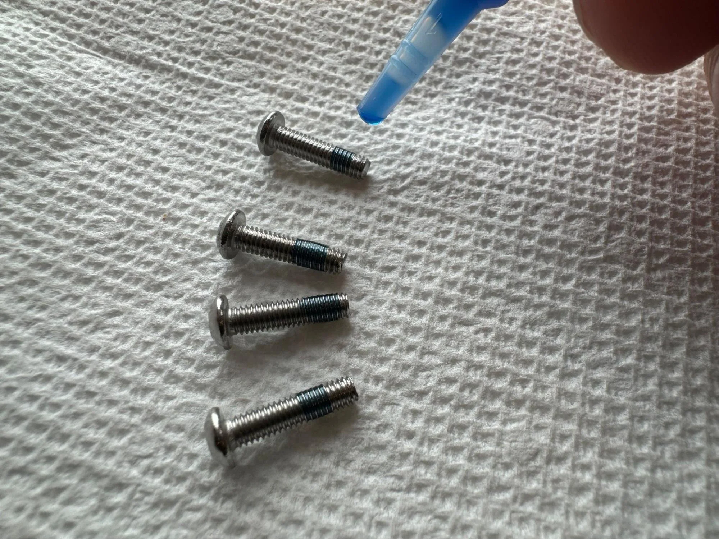
[picture p274: assets/MaslowCNC_Wisdom_Manual-assets/image1_006.webp]


The bolts which connect the motor to the arm can wiggle themselves loose over time so we’ve included removable thread locker in your kit. Place a small amount of thread locker on four bolts.

You will need to cut the end of the thread locker with scissors or a knife. Note - Do not use the super glue here. The thread locker is a blue liquid, while the super glue is a clear gel.

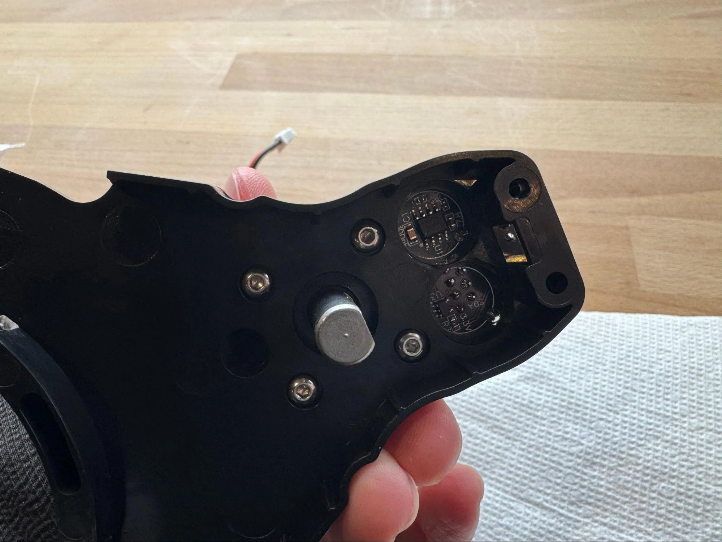
[picture p275: assets/MaslowCNC_Wisdom_Manual-assets/image20_003.webp]


And then bolt the drive motor into place.

Community Note: There is some play in how these bolts attach the motor and having the motor further forward (to the right in the picture) is better than further back. If you find that the gears are too tight in later steps you can loosen them up by moving the motor forwards.

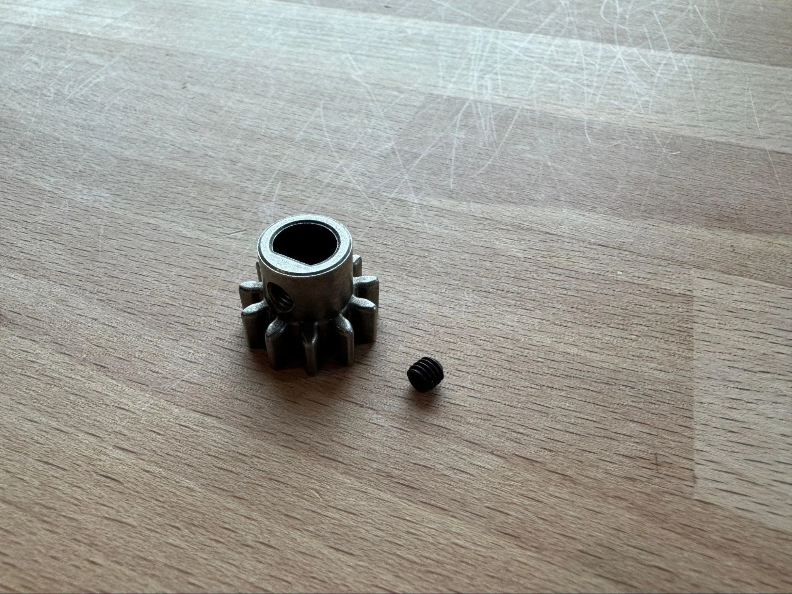
[picture p276: assets/MaslowCNC_Wisdom_Manual-assets/image36_006.webp]


Next we need to collect our drive gear (which has a D shaped opening in the center) and set screw:

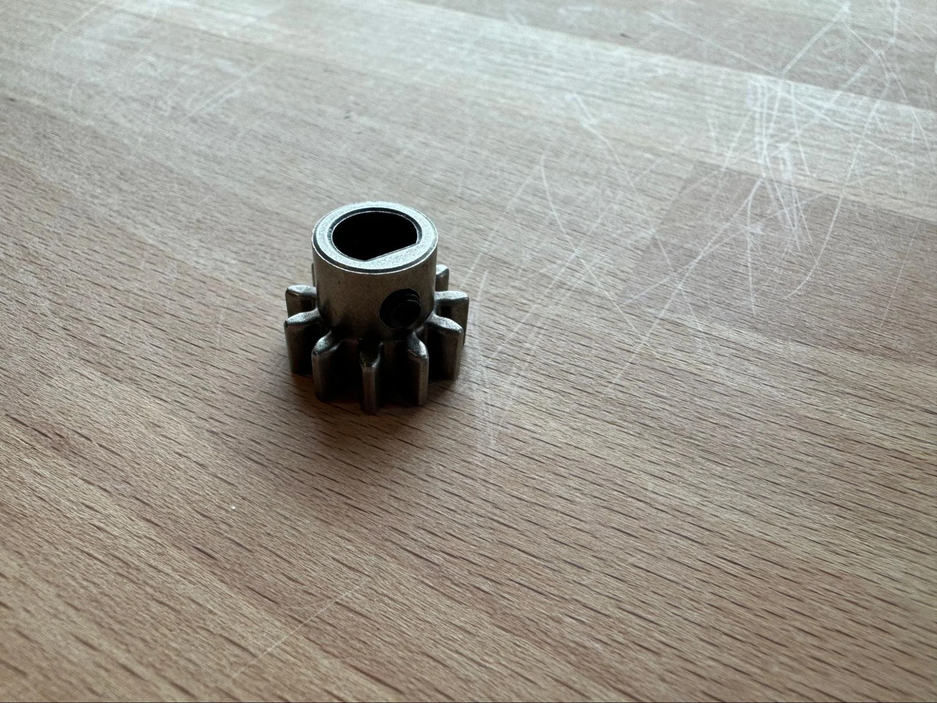
[picture p277: assets/MaslowCNC_Wisdom_Manual-assets/image3_008.webp]


Thread the set screw part way into the drive gear:

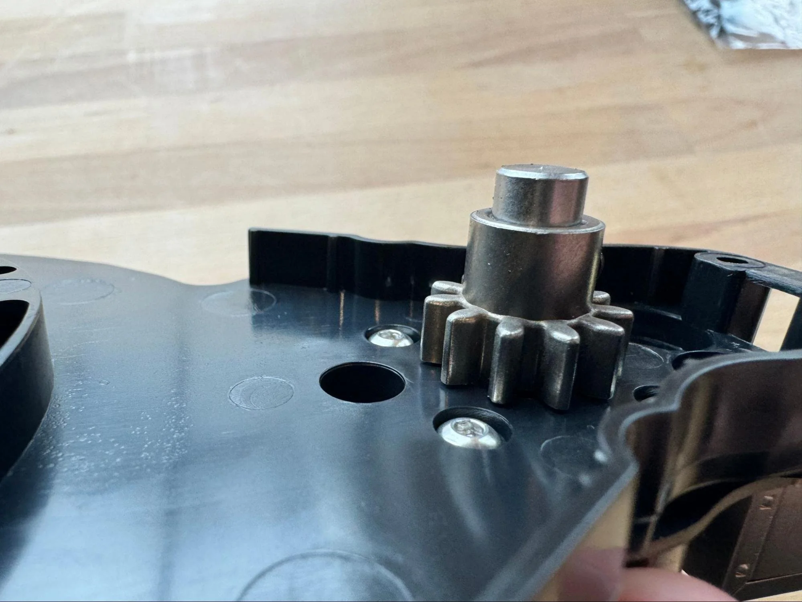
[picture p278: assets/MaslowCNC_Wisdom_Manual-assets/image21_007.webp]


Then attach it to the motor shaft. The gear should be almost but not quite touching the plastic or lifted up about the width of an index card or three pieces of paper. Tighten the set screw to lock it in place.

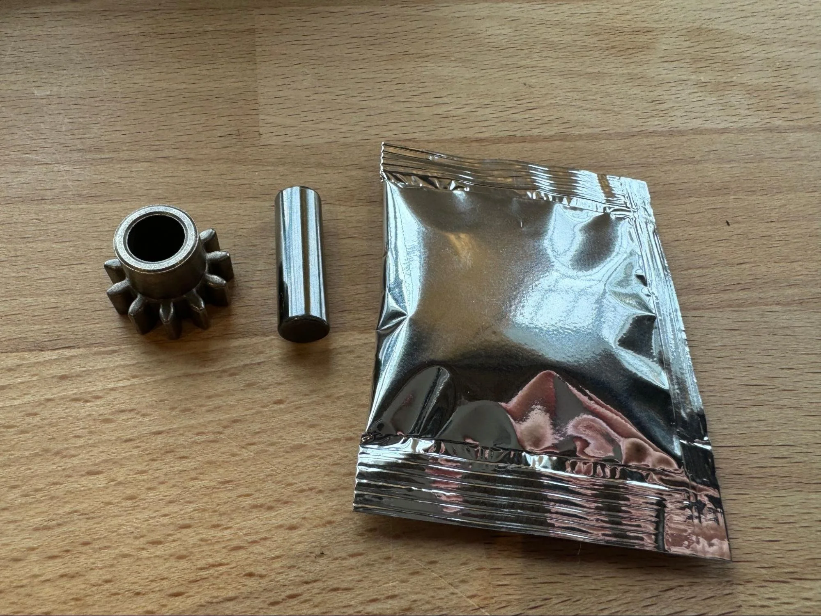
[picture p279: assets/MaslowCNC_Wisdom_Manual-assets/image4_008.webp]


Next collect the idler gear (which has a round opening in the center) and the idler shaft along with our packet of silicone grease.

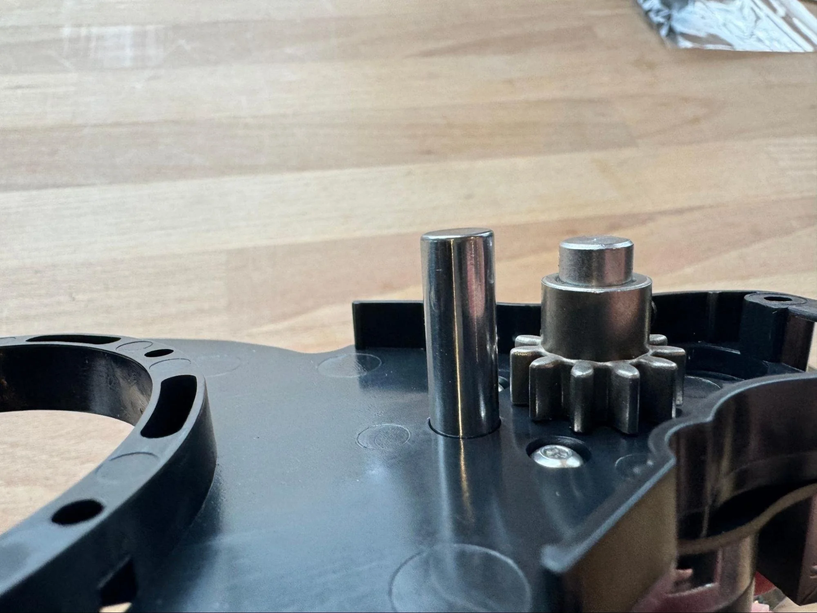
[picture p280: assets/MaslowCNC_Wisdom_Manual-assets/image13_008.webp]


Insert the idler shaft into the arm next to the drive gear. Feel free to bang it on the table a bit to make sure it’s all the way in.

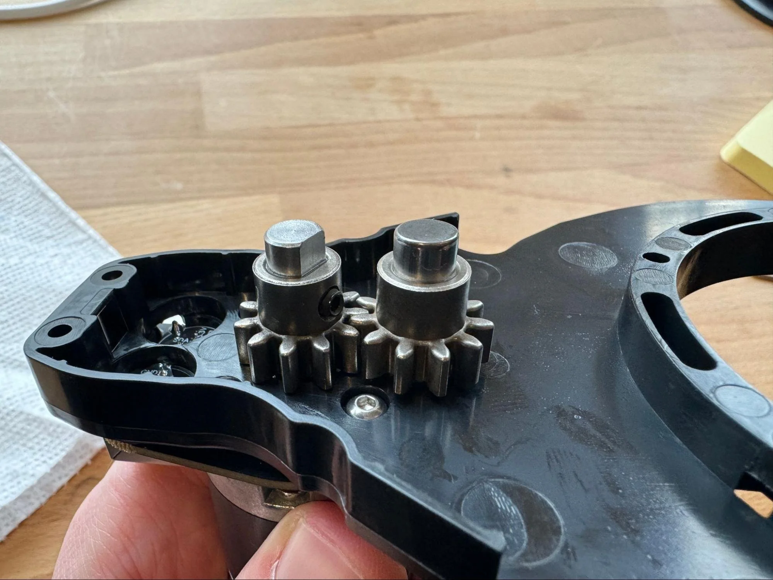
[picture p281: assets/MaslowCNC_Wisdom_Manual-assets/image16_008.webp]


Then place a small amount of silicone grease on the shaft and inside the gear and then slide the gear into place.

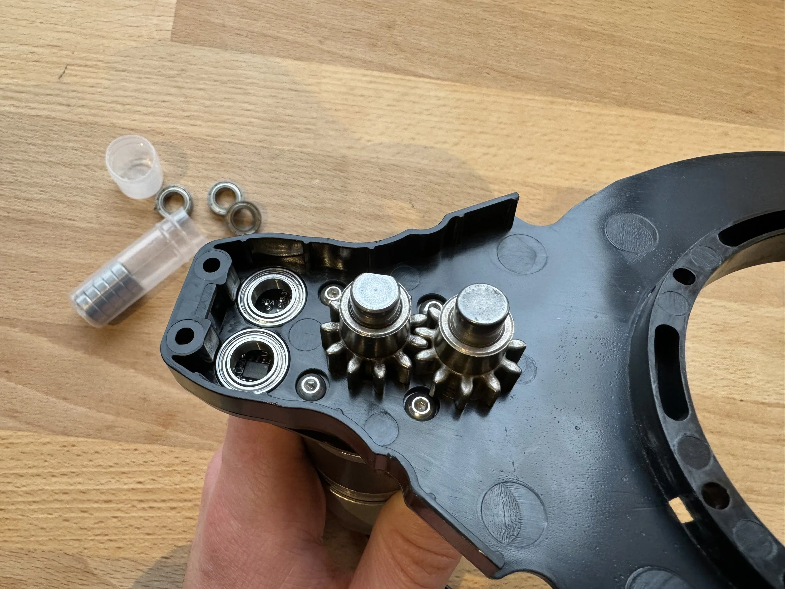
[picture p282: assets/MaslowCNC_Wisdom_Manual-assets/IMG_3371_008.webp]


Next we need to press bearings into the arm. Press two bearings into the opening in the front of the arm. You can use one of the rollers that doesn’t have a magnet to help press them into place if needed.

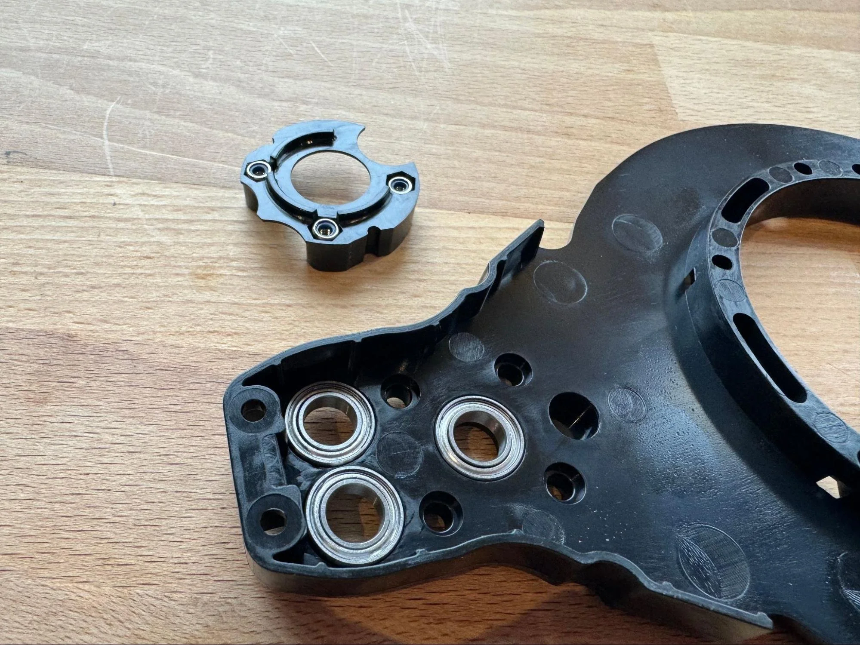
[picture p283: assets/MaslowCNC_Wisdom_Manual-assets/image8_002.webp]


Next set this half of the arm aside and we will work on the other half. First we will need to press three bearings into a new arm half. The middle bearing on this side is a bit snug so some GENTLE taps from a hammer can help press it into place.

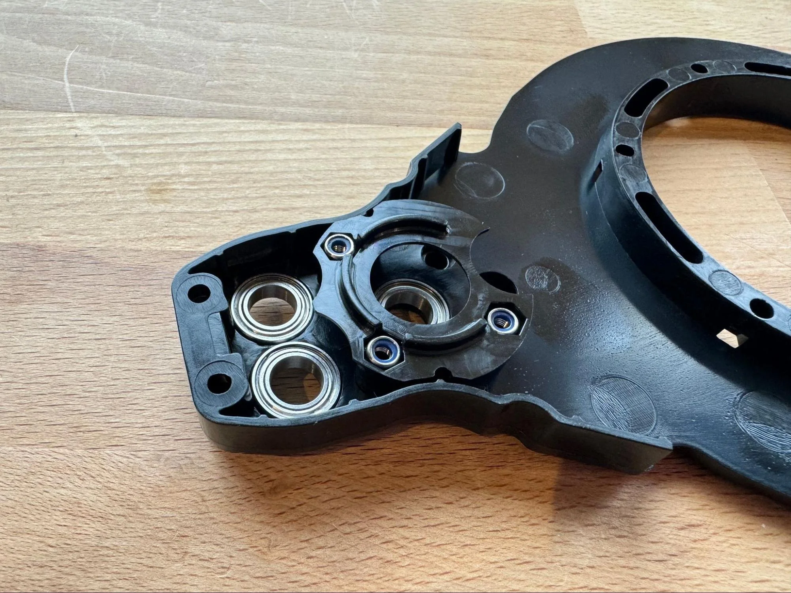
[picture p284: assets/MaslowCNC_Wisdom_Manual-assets/image19_008.webp]


Next we will attach the belt guard. Insert three nuts into the holes in the top of the belt guard with the open end of the nuts down.

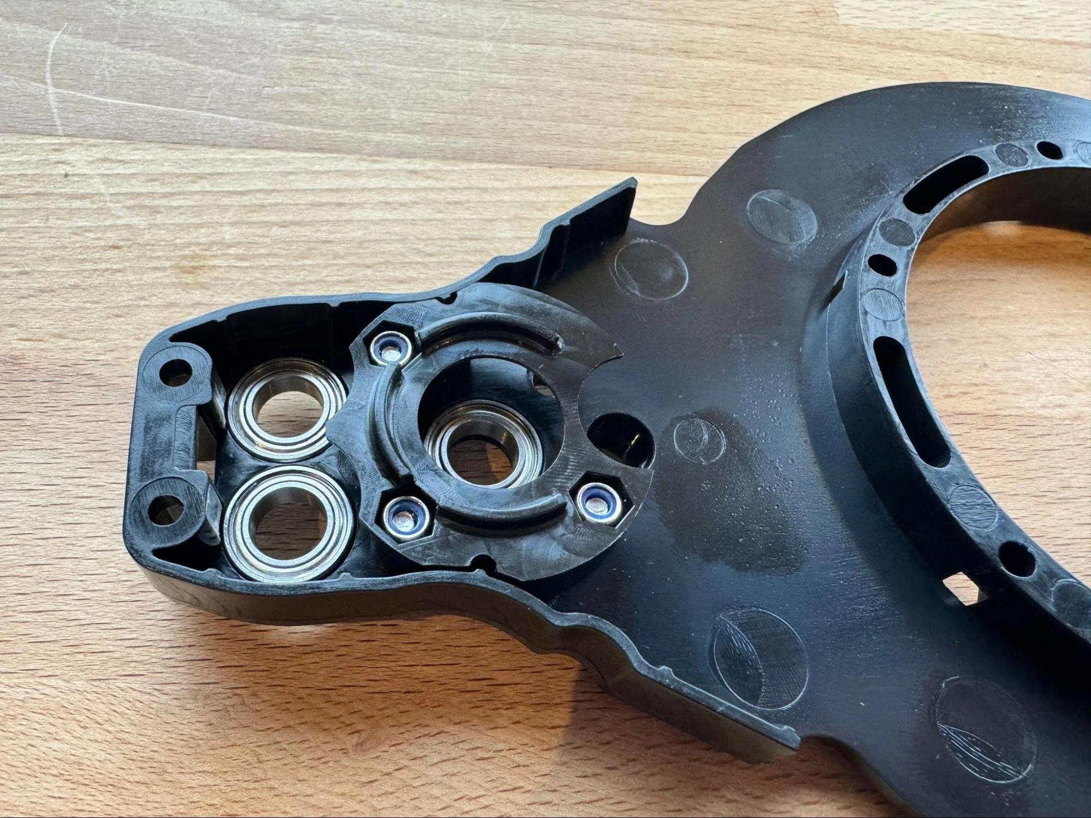
[picture p285: assets/MaslowCNC_Wisdom_Manual-assets/image35_008.webp]


Then add three bolts to hold it in place.

Next we need to wait for the glue to finish drying on our other parts before we can proceed. Feel free to repeat the steps up to this point for all four arms. If you feel like continuing to work on other parts of the machine while the glue is drying you can start on the Assembling the Sled section.

This next part where everything comes together sort of happens all at once and can be a little tricky. Don’t feel frustrated if it takes a couple of tries to get it right. With practice it can be pretty smooth, but the only way to get the hang of it is to try.

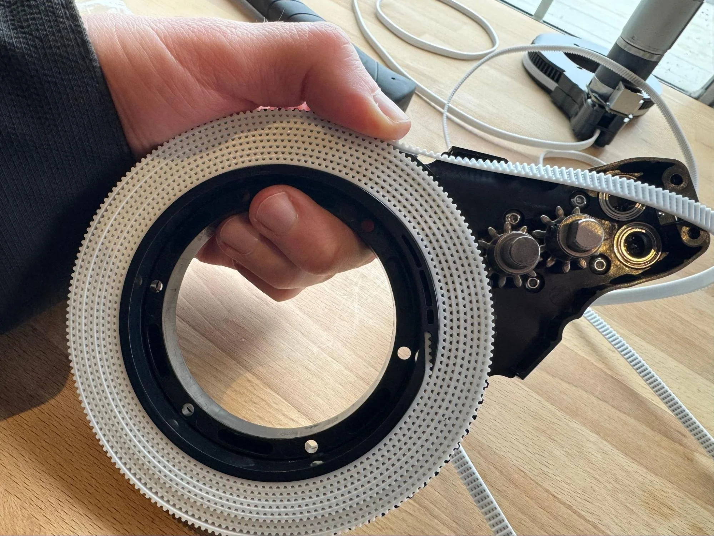
[picture p286: assets/MaslowCNC_Wisdom_Manual-assets/image33.webp]


First place the spool with the belt wrapped around it onto the top of the arm so that it engages with the drive gears. The fit will be quite snug.

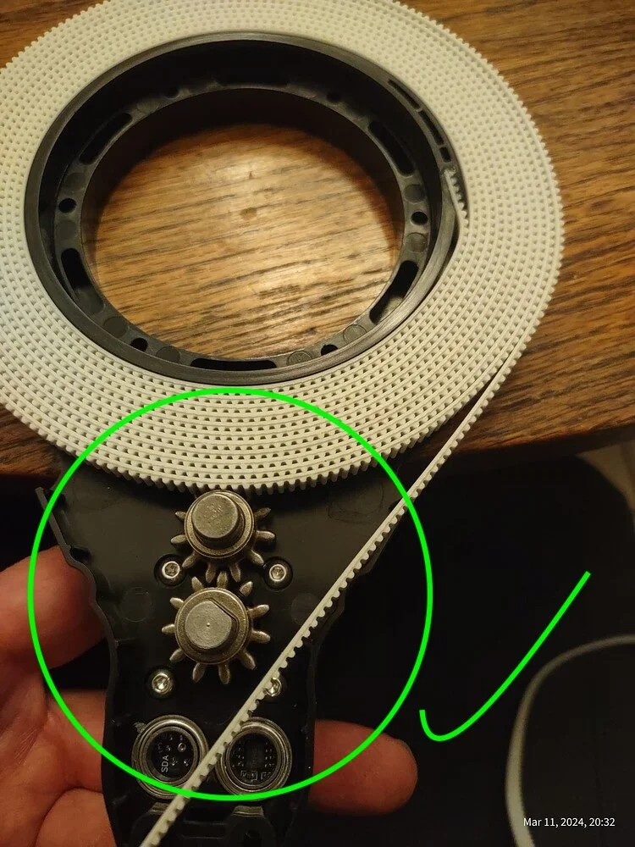
[picture p287: assets/MaslowCNC_Wisdom_Manual-assets/205ae4980e697c0f9270b9e9c1200cdb06d8bfa9_2_750x100.webp]
205ae4980e697c0f9270b9e9c1200cdb06d8bfa9_2_750x1000_008


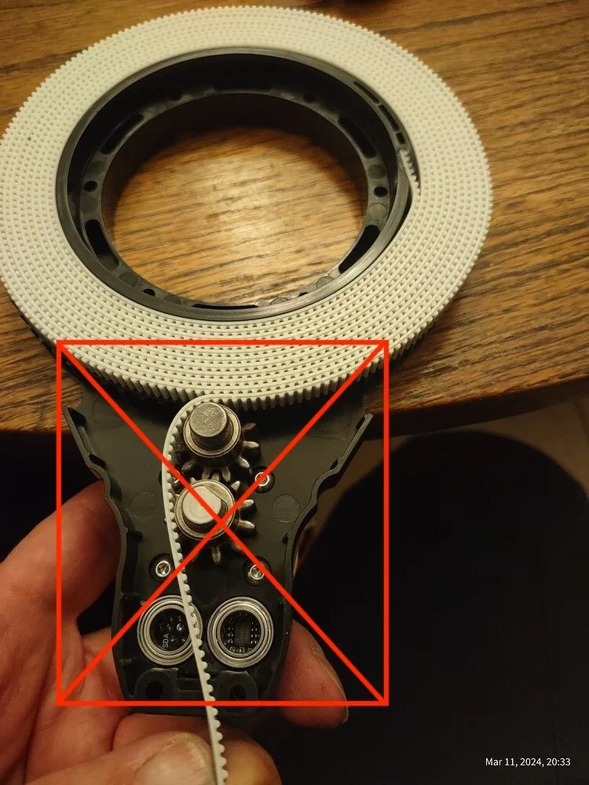
[picture p288: assets/MaslowCNC_Wisdom_Manual-assets/5430d717135c8b2eaee948a50da232e88ccb4d9e_2_750x100.webp]
5430d717135c8b2eaee948a50da232e88ccb4d9e_2_750x1000_007


Note that when we route the belt we want it to pass in front of the drive gears, not behind them.

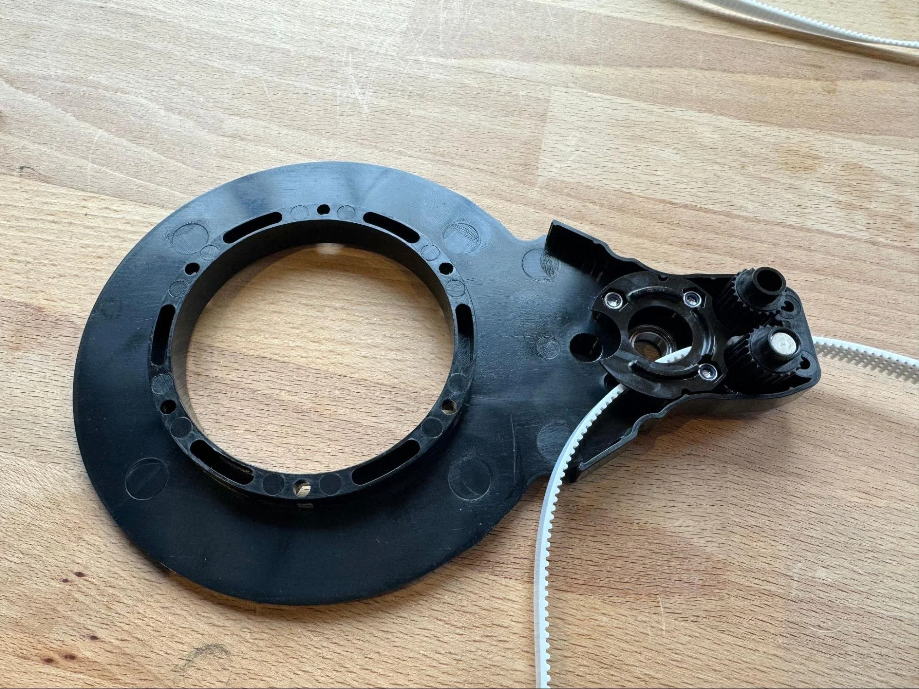
[picture p289: assets/MaslowCNC_Wisdom_Manual-assets/image9.webp]


Screenshot+2024-03-10+at+2 03 19 PM

Next on the other side of the arm thread the end of the belt through the belt guard and insert the two rollers. **Note that one roller has a magnet and the other does not. The placement of the magnet is very important. It must line up with the sensor (in green on the right) on the other half of the arm when the two halves come together.**

Then press the two halves together. This is much easier said than done and this is the trickiest step of the build process. 

Generally I start from the back of the arm (the side that doesn’t have the belt coming out of it) and work my way forward. 

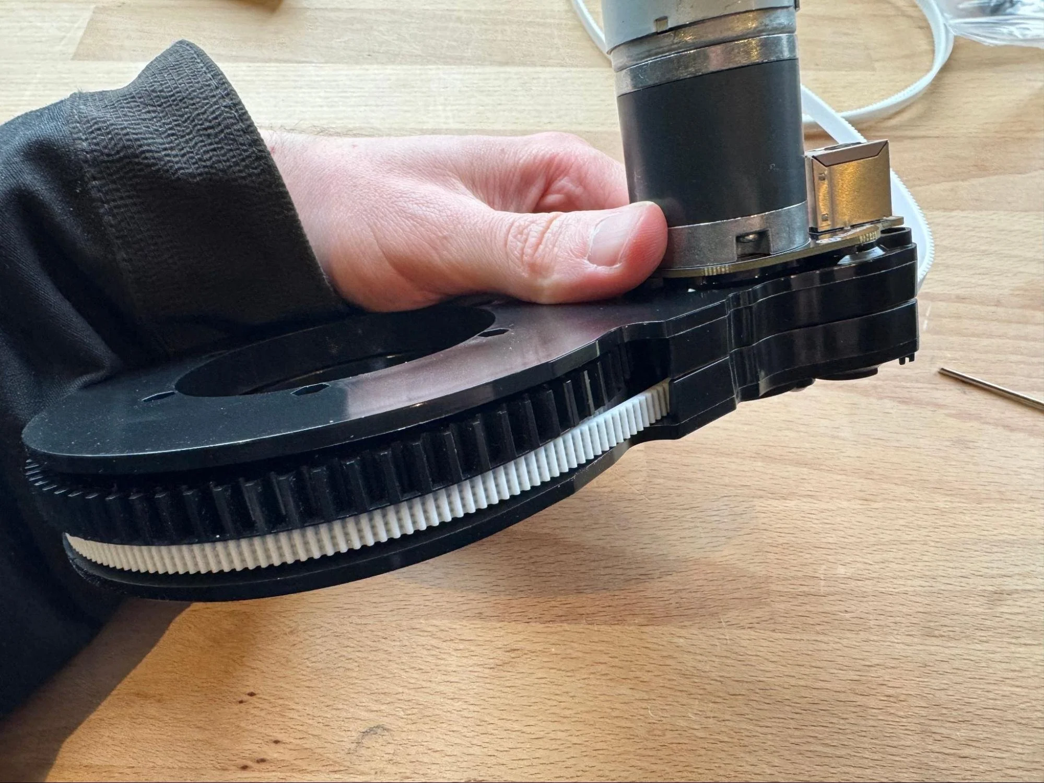
[picture p290: assets/MaslowCNC_Wisdom_Manual-assets/image7_007.webp]


There are three things which will need to go into place. First the idler shaft needs to align with the hole on the opposite side. Then the drive shaft needs to align with the opening in the bearing on the bottom, then the rollers will need to line up with bearings on the other half. 

I find that by checking each one of these locations in turn and getting them lined up the two halves will come together. It can be helpful to use the allen wrench to jostle the rollers around to make them line up.

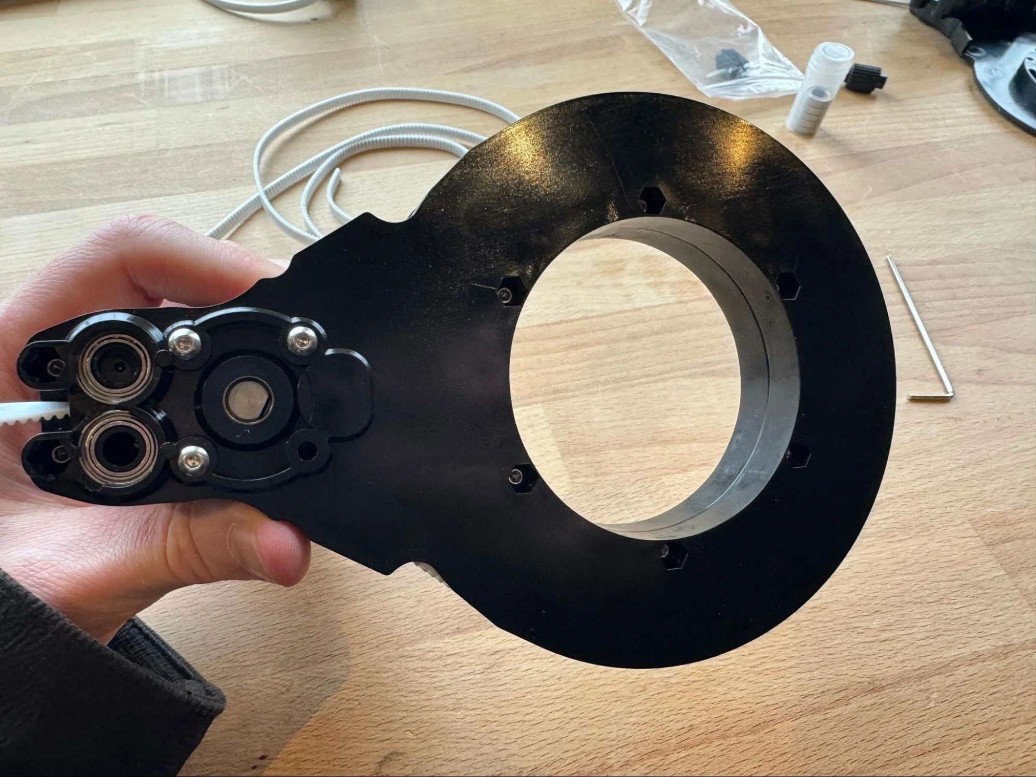
[picture p291: assets/MaslowCNC_Wisdom_Manual-assets/image28_004.webp]


Then we join the two halves together with eight bolts. 

Two of the bolts at the front already connect to the captive nuts there. If those nuts are out of place, I find the Allen wrench works well to jostle them back into the right position.

The other six go around the center of the spool. The direction of these bolts can go in either direction. Don’t over tighten these, they just need to be tight enough to keep the two halves together.

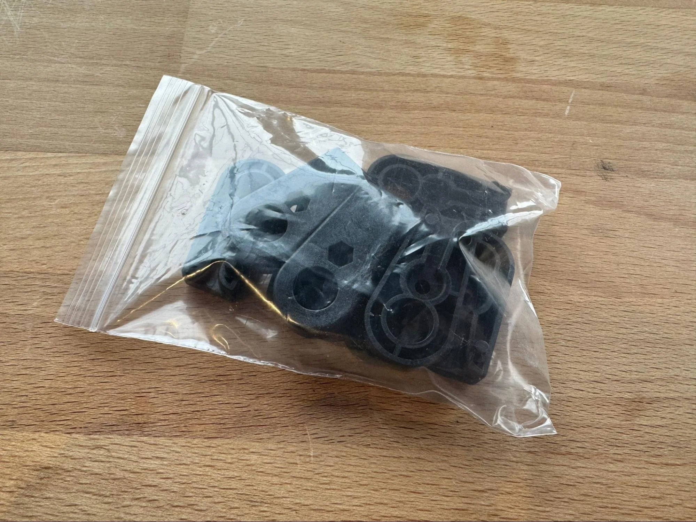
[picture p292: assets/MaslowCNC_Wisdom_Manual-assets/image5_006.webp]


Finally we need to attach the belt end to the end of our arms. Gather the eight belt end parts:

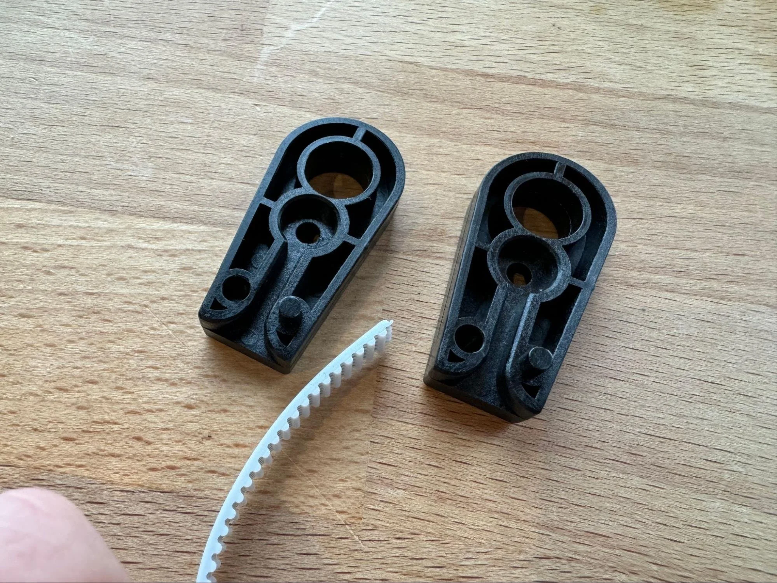
[picture p293: assets/MaslowCNC_Wisdom_Manual-assets/image24_007.webp]


Then take two of the belt ends and the end of one of the belts extending from our arms:

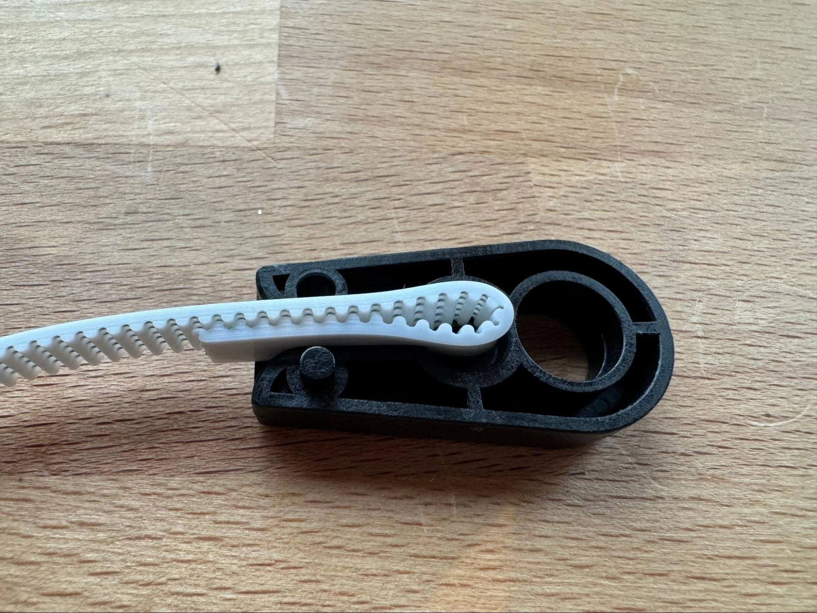
[picture p294: assets/MaslowCNC_Wisdom_Manual-assets/image15_008.webp]


Fold the belt over and press it into the slot in the belt end so that the end protrudes only slightly. This can be tricky to do because the fit is tight (it needs to be tight to handle the force). I find that starting with the loop in the belt at the open end of the slot and pushing it forward works well. You can use the allen wrench to lever it into place.

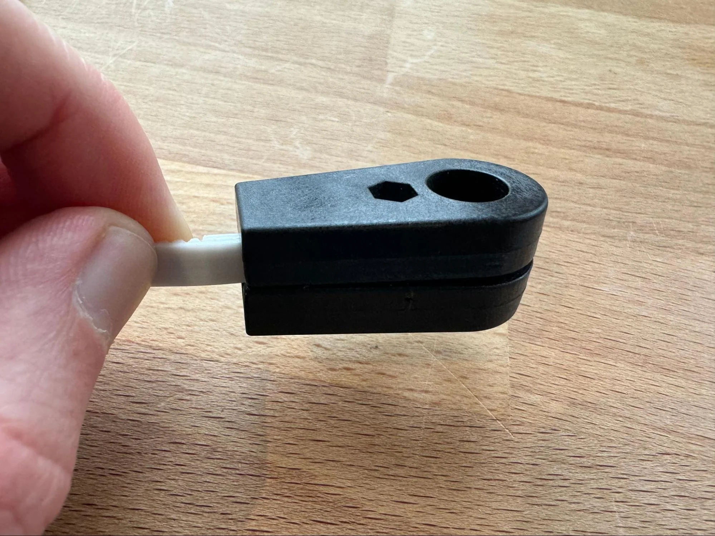
[picture p295: assets/MaslowCNC_Wisdom_Manual-assets/image27_004.webp]


Then press on the other half of the belt end. 

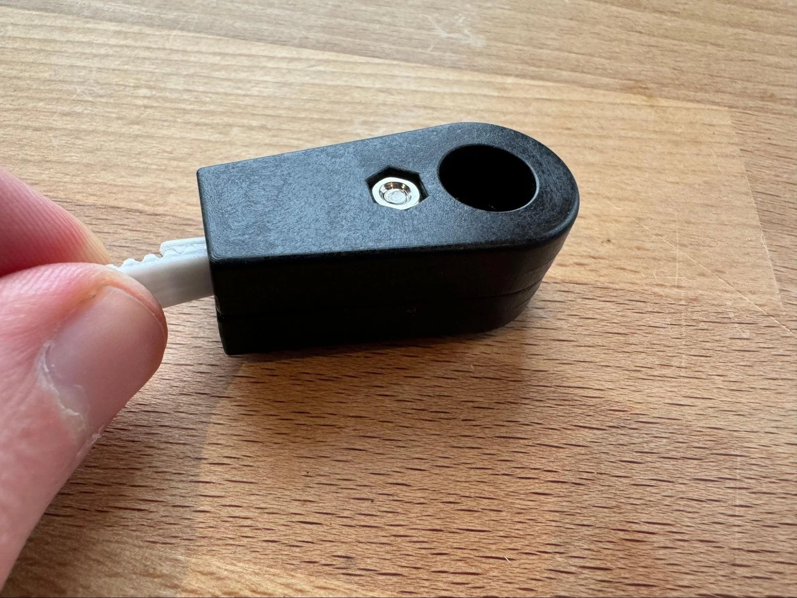
[picture p296: assets/MaslowCNC_Wisdom_Manual-assets/image18_005.webp]


And secure it with a bolt and non-lock nut.
Congratulations! You are done with the most difficult and longest part of the assembly process!

## Assembling The Sled

Find any of these steps confusing or get stuck? Don’t forget, you aren’t alone! Maslow is a community driven open source project. Ask in the forums and we’ll figure it out together!

Next we are going to assemble the Maslow4 sled. To do that we will need our sled, our stepper motors, our linear rods, our linear rod clamps, and our dust cover.

Amongst your hardware are a few bolts which are shorter than the rest. Find eight of these.

Using those eight smaller bolts attach the stepper motors to the sled by bolting through the sled and into the four threaded holes in each stepper motor. Orient the cords as shown in the next step.

Orient the stepper motors so that the cord is facing towards the edge of the sled.

Using six of the regular bolts and nuts attach the dust cover. I find it easier to flip the sled upside down for this step and drop the nuts down from the top and insert the bolt from the bottom.

Find your two linear rod clamps. 

Because of our new and improved packing system these will likely be installed on the sled and you will need to take them off.

Insert linear rods into the two openings for them on either side of the sled. A GENTLE tap with a hammer can help make sure that they are fully seated.

Press the linear rod clamps into place around each rod.

Bolt them in place using eight bolts. Be careful to tighten these evenly going around in a circle and tightening each one gently before moving on to the next. Do not overtighten these. They do not need to be excessively tight and you can break the sled by tightening these too hard. 

That’s it! You’ve built your Maslow4’s sled!
Congratulations! Your sled is complete.

# Building 4 or 4.1 tips
- Use a straw to push the nut up in the hexagonal hole while getting started with a bolt.
- add some more!!

# Flowchart of user actions
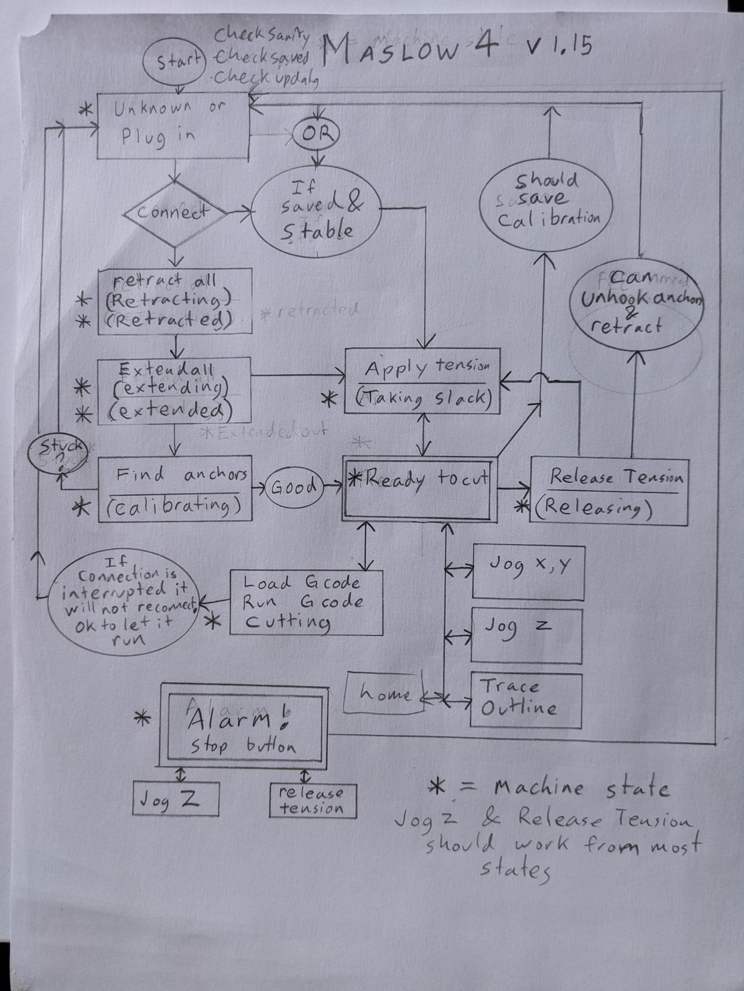
[picture p297: assets/MaslowCNC_Wisdom_Manual-assets/BasicUserFlowchartMaslow.jpg]
BasicUserFlowchartMaslow


# Details on Optional addtions (add details and instructions) 
  1. 3D printed **button pushing insert** to make it much easier to insert and remove router bits
2. **Dust control** vacuum system. Starting with a 3D printed nozzle adapter for the machine and then a hose (antistatic is good) and dust collection vacuum system.
3. **More CNC router bits** 1/8 in straight flute, Pointed engraving tip, rounded hollowing bit
4. **Collet adapter** for 1/8 in shaft router bits
5. **Cord control system** wire, and vacuum hose support so that the connections don't pull on the machine too much.
6. **A way to hold the material in place while cutting**. Rug no slip fabric or double sided tape or brass screws or wood chocks or a vacuum system or....   Depends a lot on your material and setup. Don't use steel screws anywhere near your cutting area or the blades will colide with them.
7. **Metric meausring tape**
8. **Emergency Stop Button**  Extension cord with a clearly marked button for turning off power to the router and robot. 
9. **Handle** for moving the machine (?Best practice?
10. **Router Speed Controller** Extension cord that varies the voltage to the router. Check power rating and suitablility for your router the Dewalt already has a spee control dial at the top of the router. 

    # Routers lists and library
   
    # Router bits lists and library
   
    # CNC, CAD and CAM software lists and library
   
    # Material to cut lists and library
   
    # Frames and frame library
   
    # Connecting to the machine

# Updating the firmware
  The ESP computer that the Maslow is built around is a flexbile computer used in many smart devices and robotics projects.  Maslow's interface is built off of a generic ESP software called 3DFluidNC which was designed for controlling CNC machines. Maslow's software and user interface sits on top of and builds off of this base. 

# The Control panel and software

# Other things you can control in the software.

# Moving the robot around by jogging

# G-code

# Feed rates library

# Test Cut designs and grids

# Making a 2D design as a vector drawing .svg

# Changing a 2D design into G-code .nc for cutting

# Uploading G-code .nc to the machine

# Fixing the work to the wasteboard

# Inserting a cutting bit

# Inserting a drawing pencil or pen (no idea how to do this)

# Drawing with the machine

# Preflight check

# Cutting a 2D design

# Designing a layered 2D design with mulitple depths

# Preparing a layered 2D design as G-code

# Cutting a layered 2D design with multiple depths

# Switching cutting heads between operations

# Designing a 3D sculpted surface design

# Preparing a 3D sculpted surface design as g-code

# Cutting a 3D sculpted surface design

# Designing a 3D piece of furniture from multiple 2D panels

# Abundance software

# Paramaterized design for 3D

# G-code for furniture

# Cutting furniture.

# 3D design as stacked layers

# Cutting 3D as stacked layers

# G-code for stacked layers of 3D designs

# Other design methods

# Including bushings and hardware in designs

# Design library (perhaps one for parts of desgins and one for full projects?)

# Accuracy and precision

# TROUBLESHOOTINg

# Fun stuff
