IArchi/Maslow_4/CAD/MaslowMainBuild3DPrint/MaslowMainBuild3DPrintReadme.md

Write about the main maslow 3D print files here.
