IArchi/Maslow_4/docs/manual-anchor-locator/index.html

Maslow Manual Anchor Locator

Documentation

No automatic calibration required

# Six measurements. Four anchor locations.

Measure center-to-center between each pair of anchors. The redundant diagonal measurement lets the solver fit all values and estimate measurement consistency.

## Measurements

millimeters

ATop sideTL to TR

mm

BRight sideTR to BR

mm

CBottom sideBL to BR

mm

DLeft sideBL to TL

mm

EDiagonal ↘TL to BR

mm

FDiagonal ↙TR to BL

mm

Compute anchor locations Load example

●Calculations stay in this browser. Measure from the center of each anchor attachment point.

solid: fitted frame dashed: diagonals

## Computed result

using all 6 measurements

Measurement quality—

Estimated 1σ error—

Fit RMS—

### FluidNC coordinates

Copy coordinates

### Measurement residuals

Line | Measured | Fit Δ

About the error estimate: Four points need five independent planar coordinates after position and rotation are fixed. Six measured distances provide one extra constraint. The reported 1σ value is the least-squares residual estimate from that single degree of freedom, so treat it as a useful consistency check rather than a precision guarantee.
