IArchi/Maslow_4/docs/user-guide/images/guide-33.png

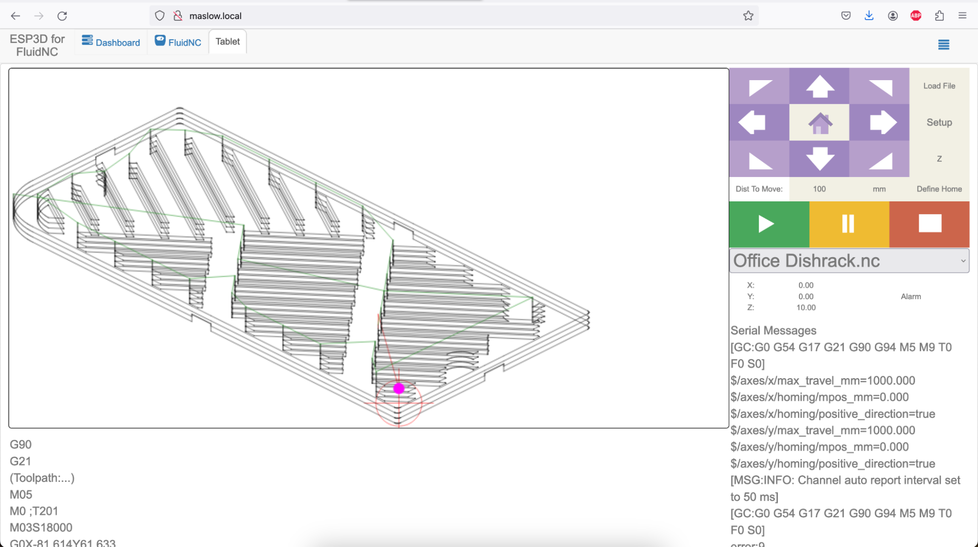
docs/user-guide/images/guide-33.png
