IArchi/Maslow_4/docs/calibration-simulation/index.html

# Maslow CNC Calibration Simulator

About this simulation: This tool simulates the exact calibration process used by the Maslow CNC machine. It mimics how the machine collects measurements at calibration waypoints and sends them in chunks to the browser for computation. Unlike the previous simulation, this one accurately models the multi-stage computation process where anchor positions are recomputed multiple times as more measurements are collected.

Status: Idle

Current Waypoint

0

Total Points

0

Recompute Stage

0

Best Fitness

### Machine Configuration

Top-Left X (mm): Top-Left Y (mm): Top-Right X (mm): Top-Right Y (mm): Bottom-Right X (mm):

Note: BL position is fixed at (0, 0) and BR Y is fixed at 0

Grid Size:

### Simulation Settings

Random Measurement Error ± (mm):

Randomly adds/subtracts between -X and +X mm to each measurement

Constant Measurement Error (mm):

Adds a fixed value to all measurements

Proportional Measurement Error (scale):

Multiplies each measurement by this scale factor (1.0 = no error)

Simulation Speed: Machine Orientation:

Start Calibration Simulation Stop Simulation

### Machine Visualization

### Computation Progress

### Simulation Log
