IArchi/Maslow_4/docs/calibration-simulation/data-parser.html

# Maslow Calibration Data Parser

Process real calibration measurements to find optimal anchor positions

### 📥 Calibration Data Input

Paste measurement data from your Maslow machine. Supports multiple formats:
• Plain: {tl:2051.76, tr:2053.05, bl:1942.31, br:1952.85},...
• CLBM: CLBM:[{bl:2960.58, br:3150.08, tr:3067.72, tl:3049.85},...]

Measurement Data:

Parse and Validate

### ⚓ Initial Anchor Positions

Starting estimates for the anchor point positions. Defaults match the anchors in firmware/FluidNC/data/maslow.yaml. The firmware-exact solver refines these, running its own deterministic retry loop just like the machine.

Top Left X (mm)

Top Left Y (mm)

Top Right X (mm)

Top Right Y (mm)

Bottom Right X (mm)

### ⚙️ Computation

Compute Anchor Positions

#### ✅ Optimized Anchor Positions

Top Left X

Top Left Y

Top Right X

Top Right Y

Bottom Right X

Fitness (RMS)

### 🗺️ Measurement Map & Error Breakdown

Each dot is a measurement's solved sled position, coloured by its RMS belt error. Lines run from each sled toward the four anchors; a line's thickness and colour show how much that individual belt residual contributes, so you can spot whether one belt (e.g. bottom-left) is consistently the worst.
Scroll to zoom, drag to pan, and click a dot (or use the checkboxes below) to exclude a bad measurement — the anchors are re-solved instantly.

Anchor Measurement RMS: low high Belt residual (thicker = larger error)

Reset view Include all points Exclude failing points

On | # | Sled X | Sled Y | TL resid | TR resid | BL resid | BR resid | RMS | Worst belt

### 📋 Output Log
