IArchi/Maslow_4/(commit log)

2025-02-27 GRBL tweaks - mostly little utils
2025-02-27 Further probe work
2025-02-28 Getting probe panel working again
2025-02-28 Probe error more meaningful
2025-03-28 Adds a config option for the force used during the calibration process
2025-03-31 Add missing `join` param to avoid unwanted comma insertion
2025-04-04 Swap the download button for a link
2025-04-25 Get state and add dynamic button placeholders
2025-04-25 Dynamic buttons working
2025-04-29 Hide the dynamic buttons
2025-05-21 Able to move after calibration
2025-05-21 Clean up prints
2025-06-03 Display correct state while calculating calibration
2025-07-02 Filter kinematics commands from user log display
2025-07-08 Auto check radio button in settings menu
2025-08-04 Fix file list initialization and delete button issues in Maslow tab
2025-08-07 Add calibration orientation logging and basic test
2025-08-07 Remove calibration orientation test as requested
2025-08-07 Add spoilboard and work thickness parameters to MaslowKinematics
    [maslow.yaml]
2025-08-07 Fix long move segmentation when calibration state is not READY_TO_CUT
2025-08-07 Revert calibration state fix to investigate quadrant movement issue
2025-08-10 Implement pause button functionality for Maslow tab
2025-08-10 Fix pause button functionality by implementing proper canvas drawing
2025-08-10 Improve pause button appearance and change color to orange
2025-08-11 Remove borders from pause button to make entire button orange when paused
2025-08-11 Fix Set Z Stop button using wrong axis index after kinematics changes
2025-08-11 Fix pause button appearing during homing/jogging - only show during run state
2025-08-12 Remove white border from play button by eliminating stroke on triangle
2025-08-12 Fix persistent white border issue on play button by removing stroke from static initialization
2025-08-12 Eliminate translucent white square on play button by removing static initialization
2025-08-12 Add prints
2025-08-12 Fix translucent white square on play button by setting explicit canvas dimensions
2025-08-12 Complete debugging tab implementation with motor current gauges
2025-08-12 Minimize changes while keeping pause button functionality
2025-08-12 Implement minimal pause button functionality for Maslow tab
2025-08-12 Implement unified play/pause button with state-based appearance
2025-08-13 Complete Debug tab improvements: Remove redundant section, add ADC to mA conversion, and arrange gauges in 2x2 grid
2025-08-13 Fix unified play/pause button visibility by moving to main control area
2025-08-13 Fix button visibility: always show play and stop buttons as requested
2025-08-13 Hide motor current messages from console display
    Add regex filter to hide motor current messages like "[MSG:INFO: TLC: 0.100 TRC: 0.000 BLC: 0.000 BRC: 0.000]" from the user console. Messages are still processed by the debugging system but won't clutter the console display. Filter respects verbose mode setting.
2025-08-13 Fix motor current messages appearing in Maslow tab console
2025-08-13 Fix motor names
2025-08-14 Fix horizontal mode belt tensioning: pull all 4 belts tight
2025-08-14 Fix belt tensioning to only pull all 4 belts on first measurement in horizontal mode
    Address feedback to use directional logic for subsequent measurements while maintaining all-4-belt logic only for the first measurement (run == 0) in horizontal orientation.
2025-08-14 Fix horizontal mode belt tensioning: use waypoint instead of run for first measurement
2025-08-14 Fix horizontal mode belt tensioning: pull all 4 belts simultaneously instead of sequentially
2025-08-15 Add side length validation for anchor coordinates (500-5000mm range)
2025-08-15 Initial analysis of z-axis offset zero issue
    [ZeroZOffsetTest.cpp]
2025-08-15 Fix z-axis offset zero issue in belt length calculations
    [ZeroZOffsetTest.cpp]
2025-08-15 Fix inverse kinematics z-component calculation consistency
2025-08-16 Fix belt retraction console spam by suppressing error during retraction states
2025-08-16 Apply minimal fix for belt retraction console spam
2025-08-16 Fix position calculation after belt tensioning in horizontal mode
2025-08-17 Fix play/pause button not resetting after running a file
2025-08-18 Implement Z-axis position preservation during tension release/apply cycle
2025-08-18 Add comprehensive test coverage for Z-axis preservation fix
2025-08-18 Remove Z-axis motor position setting entirely from tension operations
2025-08-18 Remove whitespace changes and tests, keep only essential Z-axis fix
2025-08-18 Remove extraneous formatting changes, keep only essential Z-axis fix
2025-08-20 Implement debug tab hiding functionality until motor current messages received
2025-08-20 Implement optional motor current printing with Maslow_print_motor_currents setting
    [maslow.yaml]
2025-08-20 Fix excessive whitespace changes - make minimal changes for motor current printing
2025-08-20 Rename printMotorCurrents to debugEnabled for generic debug functionality
    [maslow.yaml]
2025-08-20 Fix canvas element restoration in play/pause button reset
2025-08-21 Fix play button visual appearance after state reset
    Fixed the issue where the play button appeared with incorrect styling (gray background with "Start" text) after transitioning from Run state back to Idle state. The problem was that tablet.js was setting text and background color on the canvas element, which conflicted with the expected canvas drawing.
    Solution:
    - Call setRunControls() first to let tablet.js configure the button state
    - Clear any background color that tablet.js sets on the canvas element
    - Redraw the proper canvas appearance with green background and white play triangle
    - Ensures the button displays correctly with proper icon instead of text
    The button now correctly shows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
2025-08-21 Fix play button displaying text instead of triangle icon after state reset
2025-08-21 Fix play button background color to use div instead of canvas
2025-08-21 Fix play button color consistency by using tablet.js green color
2025-08-21 Fix play button color consistency by using correct dark green color
2025-09-02 Fix belt spooling issue: set target position before recomputePID calls
2025-09-02 Fix frame flex measurement to only occur during calibration, not Apply Tension
2025-09-02 Fix Apply Tension failure by skipping calibration-specific checks during TAKING_SLACK state
2025-09-02 Apply clang-format to resolve whitespace conflicts in Calibration files
2025-09-02 Fix Apply Tension memory position bug: use position 0 instead of 2 for measurement data
2025-09-02 Disable frame flex measurement by commenting out related code
2025-09-03 Fix belt slackening at waypoints: maintain tension on hold belts
2025-09-03 Fix twitching at waypoints: replace recomputePID with setTarget to avoid conflicting motor commands
2025-09-03 Fix belt unwinding at waypoints: set all targets before stopping belts
2025-09-03 Fix belt unwinding at waypoints with stabilization period
2025-09-09 Fix Apply Tension process impacting Z-axis position
2025-09-09 Set Z-axis to zero during calibration process
2025-09-09 Implement calibration state reset fix
2025-09-09 Complete calibration state reset fix with formatting
2025-09-11 Suppress console spam during belt extension/retraction operations
2025-09-11 Integrate AS5600 error handling in MotorUnit for enhanced I2C diagnostics
2025-09-11 Modify error suppression to check for zero belt lengths instead of TAKING_SLACK state
2025-09-11 Simplify error suppression to check only for zero belt lengths in any state
2025-09-12 Add relay comments to copilot GitHub Action workflow
2025-09-12 Add documentation for relay comments workflow
2025-09-12 Prevent build trigger comments from being relayed to Copilot
2025-09-12 Split Stack Exchange algorithm into separate file and minimize changes to calibration.cpp
2025-09-16 Fix: Make Release Tension button green in all states
2025-09-17 Add actions for relaying comments and assigning issues
2025-09-18 Implement fixedZ boolean parameter for MaslowKinematics - allows arms that don't move when Z changes
    [maslow.yaml]
2025-09-19 Fix probe direction logic for better clarity and Maslow CNC compatibility
2025-09-19 Apply clang-format to Probe.cpp
2025-09-19 Fix Z-axis motor direction for correct probe movement direction
    [maslow.yaml]
2025-09-19 Investigate Z-axis motor mapping issue for probe movement in Maslow CNC
    [maslow.yaml]
2025-09-19 Fix probe step capture to handle custom Maslow axis mapping
2025-09-20 Implement bounding box feature with visual display and trace functionality
2025-09-24 Fix calibration grid consistency by resetting recomputeCount
2025-09-25 Fix AutoUpdate firmware download: add HTTP redirect support and remove duplicate function call
    [maslow.yaml]
2025-10-02 Enable soft limits
    [maslow.yaml]
2025-10-06 Implement belt length and machine state save/restore functionality
2025-10-06 Refactor belt length and state restoration to use saved values
2025-10-06 Only save belt lengths in READY_TO_CUT or RETRACTED states to prevent slack issues
2025-10-06 Fix extended state variables - set Calibration class members instead of Maslow class
2025-10-06 Initialize encoder cumulative positions when loading belt positions from NVS
2025-10-06 Revert encoder position initialization - encoders cannot restore absolute position
2025-10-06 Save and validate encoder angles to detect belt movement during power-off
2025-10-07 Replace auto-correction with error state for invalid frame dimensions
    [CalibrationTest.cpp]
2025-10-07 Replace Assert with Maslow.eStop() for frame dimension errors
2025-10-09 Fix grbl_version extraction to handle major.minor correctly
2025-10-09 Fix grbl_version to default to 3.0 when using fallback version
2025-10-09 Add state info display on Maslow tab above arrow buttons
2025-10-10 Fix belt lengths resetting to zero on telnet connection
    Remove the positionsLoaded flag that prevented reloading belt positions
    after soft resets. When a telnet connection sends control characters that
    trigger a system reset, the belt positions need to be restored from NVS
    to maintain continuity. The previous logic incorrectly prevented this
    restoration on subsequent calls to begin().
2025-10-10 Prevent telnet negotiation from triggering system reset
    Implement proper telnet protocol handling to filter IAC sequences and
    add a 2-second grace period during which realtime commands are blocked.
    This prevents control characters sent during telnet connection handshaking
    from triggering unwanted system resets that would clear belt positions.
    Reverted previous NVS reload approach per user feedback - restoring from
    NVS may not be safe if the data is stale, especially during cutting
    operations.
2025-10-10 Fix arrow button sizing consistency in Maslow tab
2025-10-10 Remove extra whitespace from state indicator and Upload/Delete GCode buttons
2025-10-10 Remove padding/margin from state indicator and move trace boundary background color to outer div
2025-10-10 Match Trace Boundary button styling with other buttons in the same row
2025-10-10 Remove blue background from Trace Boundary button to match tablettab_set_xy_home styling
2025-10-11 Add explicit belt position saves after retract-all and calibration
2025-10-12 Fix ISO C++ compile warnings in Calibration.h
2025-10-13 Move config filename to new "Frame definition" section at top
    Moved the config filename dropdown from the "Show files panel" section to a new dedicated "Frame definition" section at the top of the preferences dialog, as requested by @davidelang.
2025-10-13 Remove redundant state variables from Maslow class
    - Remove retractingTL/TR/BL/BR flags from Maslow class
    - Remove extendingALL and complyALL flags from Maslow class
    - Replace flag checks with calibration.getCurrentState() calls
    - Update telemetry to compute flag values from state machine
    - Verified build succeeds with no errors
2025-10-13 Fix BR belt position not saving correctly after retract
    Update mostRecentCumulativeEncoderReading in zero() to ensure getPosition() returns 0 immediately after zeroing, matching the behavior of setPosition()
2025-10-13 Fix belt length restore to use threshold for retracted state detection
2025-10-14 Fix config file switching - update FluidNC setting when changed
    When user selects a different YAML config file in preferences:
    - Track the original config filename when preferences dialog opens
    - Detect when config filename changes on save
    - Send ESP401 command to update FluidNC's Config/Filename setting
    - Trigger refreshSettings() to reload configuration from new file
    - Handle both success and failure cases gracefully
    This ensures the settings displayed in the UI match the selected config file.
2025-10-14 Wait for settings reload before closing preferences dialog
    When config filename changes:
    - Keep preferences dialog open while updating FluidNC setting
    - Show "Switching configuration file..." message
    - Implement refreshSettingsWithCallback() to properly wait for ESP400 response
    - Process settings and rebuild UI before closing dialog
    - Add 500ms delay after processing to ensure UI updates complete
    - Close modal only after settings are fully loaded and displayed
    This ensures users see the updated settings from the new config file immediately after saving preferences.
2025-10-14 Add Restart FluidNC button next to config filename in preferences
    Added a "Restart FluidNC" button in the Frame definition section:
    - Button appears next to config filename dropdown
    - Uses warning styling (orange) to indicate system-level action
    - Calls restart_esp() function when clicked
    - Provides direct way to restart FluidNC after changing config file
    - Helpful when automatic config switching doesn't work as expected
    Users can now easily restart FluidNC to ensure config changes take effect.
2025-10-14 Change button to "Save and Restart" with save functionality
    Changed the restart button to save preferences first before restarting:
    - Button text changed from "Restart FluidNC" to "Save and Restart"
    - handleRestartFluidNC() now calls SavePreferences(true) first
    - Waits 500ms for preferences to save before triggering restart
    - Provides one-click solution: saves preferences + restarts FluidNC
    - More intuitive workflow for users changing config files
    Users can now save and restart in a single action.
2025-10-14 Fix Save and Restart to wait for save completion
    Fixed issue where Save and Restart wasn't saving preferences properly:
    - handleRestartFluidNC() now calls getPreferencesForSave() directly
    - Uses SendFileHttp with proper success/error callbacks
    - Only restarts FluidNC after save completes successfully
    - Adds 200ms delay after save before restart for file write
    - Shows error alert if save fails before restart
    - Ensures config filename selection is saved to preferences.json
    The button now properly saves all preferences before restarting FluidNC.
2025-10-14 Remove Save and Restart button, fix config file loading issue
    Reverted button-related changes (commits af6628b, c5e27e2, e772108) as requested.
    Fixed root cause: FluidNC needs restart to load new config file.
    Changes:
    - Removed "Save and Restart" button from HTML and JS
    - After updating Config/Filename setting and saving to flash with $SS:
    - Show confirmation dialog asking user to restart FluidNC
    - Explain that restart is needed to load settings from new file
    - Provide option to restart immediately or later
    - Removed unused refreshSettingsWithCallback() function
    - Added proper error handling for all failure cases
    Root cause explanation:
    FluidNC reads its config file only on startup.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
2025-10-15 Turn off soft limits
    [maslow.yaml]
2025-10-17 Fix Object.keys error with calibrationResults during calibration
2025-10-17 Add safety mechanism to clear motor overrides when leaving Homing state
2025-10-21 Improve conditional for rectangular optimization during calibration
    - Add detection for square/near-square frame dimensions (aspect ratio 0.9-1.11)
    - Run rectangular optimization if frame is nearly square OR initial fitness is poor
    - Add frame dimensions and aspect ratio logging for better diagnostics
    - This ensures optimization runs when machine doesn't know dimensions or has square guess
2025-10-24 Add automatic grid spacing selection based on 260mm max spacing constraint
2025-10-26 Add FileNotFoundError handling for git not installed case
2025-11-01 Implement improved bounding box visualization with convex hull
2025-11-05 Move orientation detection to run AFTER calibration starts, not after belt extension
2025-11-05 Remove DETECTING_ORIENTATION state, integrate detection directly into calibration_loop at waypoint 0
2025-11-05 Fix orientation detection: initialize timer and measure only the extension during test, not total belt position
2025-11-05 Add decompressBelt phase before comply to allow gravity-driven belt extension in orientation detection
2025-11-05 Fix kinematics section parsing by loading config before settings
    The firmware was failing to parse kinematics settings because settings_init()
    was called before config->load(). This caused runtime settings like
    /kinematics/MaslowKinematics/beltEndExtension to fail since the configuration
    tree didn't exist yet.
    The fix changes the initialization order in Main.cpp to load the configuration
    file first, then load the NVS settings. This ensures the kinematics system is
    properly initialized before any runtime settings try to access it.
2025-11-05 Fix buffer overflow in VERSION_NUMBER causing kinematics failures
    The issue was a buffer overflow when copying VERSION_NUMBER to telemetry header.
    When a git tag exists (e.g., "v1.13"), VERSION_NUMBER is short and fits in the
    10-byte buffer. Without an exact tag match, VERSION_NUMBER becomes much longer
    (e.g., "v1.13-47-ge6de732c" = 18 chars), causing strcpy to overflow the buffer
    by 9 bytes.
    This memory corruption caused unpredictable behavior including kinematics
    settings becoming inaccessible.
    Fixed by replacing strcpy with strncpy and ensuring null termination.
2025-11-05 Change orientation detection to actively drive motors at full speed for 1 second instead of passive comply
2025-11-05 Fix intermittent kinematics loading issue with forced registration
2025-11-05 Use rounded default values for kinematics coordinates
2025-11-06 Add filesystem stabilization delay after mount to fix Error 152 on power cycle
2025-11-06 Remove invalid x and y axis definitions from default config - Maslow uses A/B/C/D axes
2025-11-06 Change orientation detection to use 70% motor speed for 1.5 seconds instead of full speed for 1 second
2025-11-06 Change threshold to 35mm
2025-11-07 Fix race condition in streaming parser and handle escaped quotes
    - Add startPos parameter to extractJsonString() to search after asset name position
    - Track asset name positions and only extract URLs that follow the correct asset
    - Handle escaped quotes in JSON values to prevent premature termination
    - Adjust position markers when sliding window is trimmed
2025-11-07 Only run auto-update check when machine is idle or in alarm state
    - Add state check before executing deferred update check
    - Include System.h and Types.h for state access
    - Prevents update check during active operations to avoid memory pressure
    - Check is deferred until machine enters idle or alarm state
2025-11-07 Fix trace boundary to run as single continuous G-code operation
    - Replace sequential command execution with 1-second delays
    - Send all boundary trace commands as a single multi-line G-code string
    - Eliminates toggling between run and idle states with each point
    - Provides smooth, continuous boundary tracing
    The machine will now treat the entire boundary trace as one continuous
    operation instead of separate moves.
2025-11-13 Fix calibration grid shift by correcting spiral start position
2025-11-14 Fix center coordinate calculation after calibration results are loaded
2025-11-15 Move version compatibility check to Test button
    - Remove automatic version check on page load
    - Add version check to Test button handler
    - Change warning from popup dialog to console-only output
    - Version numbers now logged to console when Test is pressed
2025-11-15 Add version check results to Serial Messages area
    When Test button is pressed, version compatibility check now displays results in both console and Serial Messages area, not just console.
2025-11-15 Remove version compatibility checking logic entirely
    As requested, removed all version compatibility check functions and calls. The Test button now only prints the index.html version number without any compatibility checking.
2025-11-20 Add motor settling pause after orientation detection
    Introduces a 500ms pause after orientation detection completes, during which all four motors (TL, TR, BL, BR) are powered down. This allows the motors, especially the top left motor, to fully settle before attempting to pull the belts tight in horizontal orientation. This prevents current spikes that were preventing the TL belt from properly tensioning.
2025-11-20 Fix infinite loop by resetting orientation detection state variables
    The settling pause was causing an infinite loop because orientationDetectionDone and orientationDetectTimer were not being reset when the function completed successfully. This caused the function to re-enter Phase 4 and Phase 5 on every subsequent call, creating the infinite loop seen in the logs.
    Fixed by resetting orientationDetectionDone to false and orientationDetectTimer to 0 when the settling pause completes, ensuring the function works correctly on the next calibration run.
2025-11-20 Fix repeated orientation detection by using static flag
    The orientation detection was repeating because after returning true once, subsequent calls to detectOrientation() at waypoint 0 would re-run the entire detection process. Added a static settlingCompleted flag that is set to true when settling completes and checked at the start of the function to return true immediately on subsequent calls. The flag is reset to false when orientationDetectTimer is initialized (start of new calibration).
2025-11-25 Add Assembly Background 4.1 documentation with images
2025-11-25 Add Markdown documentation for assembly instructions and user guide
2025-11-25 Address code review feedback: fix threadlocker spelling and update firmware URL
2025-11-26 Move all tracked top-level files into firmware/ folder
    Files and directories moved to firmware/:
    - AUTHORS, CodeCoverage.cov, CodingStyle.md
    - FluidNC/, FluidNC.sln, ISSUE_TEMPLATE/
    - LICENSE, README.md
    - UnitTests.vcxproj, UnitTests.vcxproj.filters
    - VisualStudio.md, X86TestSupport/
    - build-release.py, clear-flags.ps1
    - compile_commands.json, debug.ini
    - embedded/, example_configs/
    - firmware.nm, fluidterm/
    - generate_vcxproj.py, git-version.py
    - install_scripts/, libraries/
    - max_littlefs.csv, min_littlefs.csv
    - packages.config, platformio.ini
    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
    [app3M_spiffs1M_8MB.csv, app3M_spiffs9M_16MB.csv, config-bak.yaml, fluidnc_pen_laser.yaml, maslow.yaml, max_littlefs.csv, min_littlefs.csv]
2025-11-27 Track initial moves to exclude machine starting position from job bounds
2025-11-29 Revise Frame Library documentation for clarity
    Updated the Frame Library documentation with additional details on frame requirements, anchor points, and frame formats. Improved clarity and organization of the content.
2025-11-29 Enhance Frame Library documentation with new sections
    Added introductory section and example frame entry format to Frame Library documentation.
2025-11-29 Revise frame requirements and add safety guidelines
    Updated frame requirements for clarity and accuracy, including adjustments to angles and forces. Added safety considerations and guidelines for adding new frame entries.
2025-11-29 Update FrameLibrary.md with simulator links
    Added links to frame simulators for Maslow CNC.
2025-11-29 Revise FrameLibrary.md with new content and links
    Updated frame library documentation with new calculators and examples.
2025-11-30 Revise cutting surface and frame support guidelines
    Clarified the requirements for the cutting surface and frame support to ensure accuracy and safety during operation.
2025-12-01 Fix URLs in README.md
    Updated links in README to correct URLs for assembly instructions and wiki editing guide.
2025-12-01 Revise manual content and update flowchart link
    Updated the Table of Contents and added details about the Router Speed Controller. Changed the flowchart image link and made various text corrections.
2025-12-01 Update FrameLibrary.md with frame pin and belt extension info
    Added instructions for measuring frame pin distances and using belt extensions in Maslow software.
2025-12-01 Update FrameLibrary.md with safety guidelines
    Added safety considerations when using Maslow4.
2025-12-01 Create Router And Spindle Library documentation
    Added a comprehensive guide on routers and spindles for the Maslow CNC, including community contributions and formatting instructions.
2025-12-03 Fix calibration to include spoilboard and work thickness in calculations
2025-12-03 Apply clang-format to Calibration.cpp
2025-12-03 Add validation to prevent invalid geometry in calibration measurements
2025-12-03 Complete fix for spoilboard and material thickness in calibration
2025-12-06 Changes before error encountered
    [debugging.js]
2025-12-08 Add calibration simulation that mimics machine behavior
2025-12-08 Add quick start guide and test files for calibration simulator
2025-12-08 Make frame non-rectangular with realistic imperfections
2025-12-09 Add manual anchor coordinate input mode and fix frame centering
2025-12-11 Fix Z-axis position accounting in belt length calculations
2025-12-12 Combine Retraction Force and Calibration Force into single setting
    [maslow.yaml]
2025-12-12 Remove Calibration Grid settings from UI and set defaults to 0mm x 0mm
    [maslow.yaml]
2025-12-12 Clarify comments for calibration grid dimensions
2025-12-12 Add Spoil Board Thickness and Work Thickness settings to config menu
2025-12-14 Add retry limit for low fitness calibration attempts
2025-12-15 Simplify work area implementation per review feedback
    - Revert changes to SettingsDefinitions and Limits.cpp
    - Add work area variables to Maslow class (Maslow.h)
    - Register settings in MachineConfig.cpp using existing pattern
    - Apply min/max constraints in Maslow.cpp when computing belt lengths
    - Convert belt lengths to X,Y, constrain to work area, recompute belt lengths
    - Avoids FluidNC soft limits architecture as requested
    - Firmware builds successfully
2025-12-16 Move work area constraints to MaslowKinematics.cpp
    - Remove constraint logic from Maslow.cpp (belt→XY→belt conversion)
    - Add constraint logic to MaslowKinematics::cartesian_to_motors()
    - Constraints applied directly to target position before kinematics transformation
    - Cleaner approach: constrain cartesian coords, not motor positions
    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
2025-12-16 Apply work area constraints to calibration grid generation
    - Constrain auto-generated calibration grid to be at most 200mm less than work area
    - Add work area boundary checks when grid size is set to 0x0mm (auto mode)
    - Log when grid dimensions are constrained by work area settings
    - Apply code formatting to maintain consistency
2025-12-17 Create LED Blinking.gif
2025-12-17 Add LED blinking image to QuickStart.md
    Added an image to the QuickStart documentation for better clarity.
2025-12-17 Enhance QuickStart with belt extension and retraction info
    Added detailed instructions for extending and retracting the belts, including steps for adjusting retraction force and finding anchor points.
2025-12-17 Fix layout recursion and improve JavaScript text handling
    - Remove layout: default recursion in custom layout
    - Remove unused currentSection variable
    - Improve text extraction from paragraphs containing images
    - Add better variable naming and comments
2025-12-18 Resize oversized images in FrameLibrary, Wisdom Manual, and SoftwareLibrary
2025-12-19 Reset calibration state when re-entering from CALIBRATION_COMPUTING
    When calibration fails (e.g., after max retries), the firmware enters
    CALIBRATION_COMPUTING state. If the user then presses "Find Anchor
    Locations" again, the firmware should reset the calibration state to
    ensure a fresh start instead of resuming from where it left off.
    This fix adds a check to reset the calibration state when transitioning
    from CALIBRATION_COMPUTING to CALIBRATION_IN_PROGRESS, which ensures
    that waypoint is reset to 0 and all calibration variables are properly
    initialized for a new calibration run.
2025-12-19 Fix: Only reset calibration when truly retrying, not on normal continuation
    The previous fix incorrectly reset calibration state even when successfully
    continuing to the next stage (e.g., after first 6 points). This would break
    the waypoint==6 check needed to regenerate the grid for expanded calibration.
    Now uses two criteria to detect normal continuation vs manual retry:
    1. Waypoint must be exactly one past the last recompute point
    2. Time in CALIBRATION_COMPUTING must be < 10 seconds
    This allows automatic continuation (JavaScript sends $CAL after 2s) while
    still resetting when user manually retries after failure (typically >10s).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
2025-12-20 Implement cleaner calibration reset via explicit command
    Instead of using timing/position heuristics to detect failure vs success,
    JavaScript now explicitly signals failure by sending $CALRESET command when
    max retries are reached. This command:
    - Calls resetCalibrationState() to clear all calibration state
    - Transitions to EXTENDEDOUT state
    - Provides explicit failure signaling
    This approach is much cleaner and eliminates the complex heuristics that
    were needed to distinguish between normal continuation (after successful
    stage) and manual retry (after failure).
    - Added maslow_reset_calibration() command handler in ProcessSettings.cpp
    - Registered new $CALRESET command
    - JavaScrip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
2025-12-29 Implement measurement filtering in calibration algorithm
    - Filter out worst performing measurements before computing anchor locations
    - Remove at most 4 measurements or 10% of total, whichever is smaller
    - Sort measurements by fitness value and exclude worst performers
    - Apply filtering to both fitness calculation and geometric optimization
    - Add console logging to inform users when filtering occurs
2025-12-29 Convert per-arm variables to enum-indexed arrays
2025-12-29 Convert remaining local variables to arrays (beltLength, diff, tight)
2025-12-30 Consolidate per-arm compute and getter functions into generic functions
2025-12-30 Convert sequential per-arm operations to loops
2026-01-04 Improve tooltip for Maslow_Retract_Current_Threshold to clarify it's used for both retraction and calibration
2026-01-05 Fix remaining setTimeout pauses in calibration flow
    Move background task scheduler to util.js for global availability.
    Replace setTimeout calls in tablet.js and calculatesCalibrationStuff.js
    that were causing pauses during calibration state transitions.
    Key fixes:
    - onCalibrationButtonsClick now uses scheduleCallback for $MINFO
    - tabletCalCalibrate and tabletCalTense use scheduleCallback for modal hiding
    - Calibration restart between stages uses scheduleCallback
    - GCode parsing yields to event loop without throttling
    This fixes the pause that occurred between "Center coordinates recalculated"
    and "Requesting state change" messages when tab is inactive.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
2026-01-05 Replace setTimeout with requestAnimationFrame polling for delays
    Changed scheduleCallback to use requestAnimationFrame polling instead of
    setTimeout for non-zero delays. This prevents browser throttling of delays
    when tab is inactive. requestAnimationFrame is throttled to ~1fps in background
    but this is still much better than setTimeout being throttled to 1Hz, and the
    polling approach ensures delays complete as soon as possible.
    Fixes the pause between "Center coordinates recalculated" messages caused
    by throttled 1000ms and 2000ms setTimeout calls during calibration state
    transitions.
2026-01-05 Improve requestAnimationFrame polling with cleanup and optimization
    - Cache performance.now() to avoid multiple calls per iteration
    - Track RAF ID and provide cancel function for cleanup
    - Prevents excessive callback accumulation for large delays
    - More efficient and cleaner implementation
2026-01-05 Fix HTTP command queue processing in background tabs
    Replace setInterval with scheduleCallback in HTTP command processing.
    The setInterval was being throttled to 1Hz in inactive tabs, causing
    command queue processing to stall.
    This was the root cause of pauses after "Calibrate" message - commands
    like $CAL were queued but not processed until window became active.
    Uses recursive scheduleCallback with 10ms delay to maintain throttling
    while avoiding browser background throttling.
2026-01-05 Fix HTTP command queue with MessageChannel instead of RAF polling
    Reverted previous recursive scheduleCallback approach that caused
    "Calibration data not acknowledged" errors.
    New approach uses MessageChannel (scheduleTask) for immediate command
    processing without any artificial delay. Key changes:
    - processNextCmd() recursively schedules itself via scheduleTask when
    more commands exist in queue
    - Removed setInterval completely - no more 10ms throttling
    - Natural throttling from HTTP request/response timing
    - Cleaner logic: processes commands as fast as possible in both active
    and background tabs
    This eliminates the timing issues that caused repeated commands and
    acknowledgment errors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
2026-01-07 Fix position lost when status is Extended and power lost
    - Save belt positions when entering EXTENDEDOUT state
    - Allow saving belt positions in EXTENDEDOUT state (not just READY_TO_CUT/RETRACTED)
    - Mark positions as stale when leaving EXTENDEDOUT to invalid states
    - This ensures valid belt data is available for restore after power loss
2026-01-08 Add forced reflow to ensure DOM updates are processed
    Added void cmdContElem.offsetHeight after innerHTML update to force
    a synchronous reflow. This ensures DOM updates are processed immediately
    even in background tabs, though browsers may still defer painting/rendering
    until tab becomes active.
    Note: Browser behavior of deferring visual updates in inactive tabs is
    intentional and cannot be fully overridden with JavaScript. The calibration
    logic executes correctly in background, but log display updates may be
    batched until tab regains focus.
2026-01-12 Add Standard Turtle Clamp Files
    This adds the standard turtle clamp files.
    Turtle Clamp forum thread:
    https://forums.maslowcnc.com/t/turtle-clamp-non-split-clamp-design/25420
    [TurtleClamp-ClampInserts.stl, TurtleClamp-StandardClamp.stl]
2026-01-15 Add real-time character filtering for WiFi SSID inputs
    - Added input event listeners to filter invalid characters as user types
    - Prevents typing of characters outside the allowed set
    - Maintains cursor position correctly after filtering
    - Applied to both tablet view and setup wizard SSID inputs
    - Addresses user feedback: now blocks @, space, and other invalid chars
    This fixes the issue where users could still type invalid characters
    even though form validation would reject them on submit.
2026-01-15 Update built web UI with WiFi SSID input filtering changes
    - Rebuilt ESP3D-WEBUI with latest code changes
    - Copied updated index.html.gz to firmware/FluidNC/data/
    - This file needs to be uploaded to ESP32 for changes to take effect
    Users must upload the updated firmware/FluidNC/data/index.html.gz
    file to their ESP32 device for the WiFi SSID input filtering to work.
2026-01-23 1.1 Update of TurtleClamp - quality of life and variants
    Tweaked a few things and added some variants:
    1.1 Update
    * The depth of the bolt area has been standardised so they all use 10mm of bolt-thread.
    * This means 15+mm bolts will work if re-using the standard posts, 25mm with some other of my designs.
    * Which in turn means a conversion of only the clamps just needs 28 x 16mm cap head screws.
    * Added variants:
    * NoBaseCutoutClamp - doesn't have the cutouts for getting the router as flat to the base as possible. Can still be used as a Top or Base clamp.
    * Top-NoBaseCutoutNoZCutoutClamp - has no cutouts that aren't needed for a Top Clamp - can only be used for the top.
    * Base-Hex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
    [TurtleClamp-StandardClamp.stl, TurtleClamp1_1-Base-HexReinforcedClamp.stl, TurtleClamp1_1-Base-SolidReinforcedClamp.stl, TurtleClamp1_1-ClampInserts.stl, TurtleClamp1_1-NoBaseCutoutClamp.stl, TurtleClamp1_1-StandardClamp.stl, TurtleClamp1_1-Top-NoBaseCutoutNoZCutout.stl]
2026-01-27 Replace Idle button with state-dependent text based on Maslow state
2026-01-27 Add click functionality to systemStatus button for state-dependent actions
2026-01-27 Change Ready to Cut display text to Idle for state 7
2026-01-27 Fix: Always show state-dependent text for states 0, 2, 4 regardless of GRBL state
2026-01-28 Refactor calibration simulator to use shared computation library
2026-01-29 Implement true code sharing between simulator and ESP3D-WEBUI
    - Move shared library to ESP3D-WEBUI/www/js/calibration-computation.js
    - Refactor ESP3D-WEBUI calculatesCalibrationStuff.js to use shared library
    - Update simulator to load shared library from ESP3D-WEBUI
    - Remove local copy from simulator (now uses ESP3D-WEBUI version)
    - Both simulator and ESP3D-WEBUI now use the exact same code
    - Zero duplication, guaranteed consistency
2026-01-29 Add data parser simulator for real calibration measurements
    - Created data-parser.html: New simulator that processes real measurement data
    - Uses shared calibration-computation.js library (same as ESP3D-WEBUI)
    - Accepts pasted measurement data in format: {tl:123, tr:234, bl:345, br:456},...
    - Computes optimal anchor positions from real machine data
    - Created DATA-PARSER.md: Documentation for the data parser
    - Updated README.md: Documents both simulators (machine sim + data parser)
    This addresses the request for a second simulator similar to BarbourSmith/Calibration-Simulation
    that parses user-provided data rather than generating synthetic measurements.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
2026-01-30 Update data parser to compute initial anchor positions like ESP3D-WEBUI
    - Added Z-height constants for measurement projection
    - Added projectMeasurement() and projectMeasurements() functions
    - Added findBestRectangularStart() for automatic initial position computation
    - Updated computeAnchorPositions() to:
    - Project measurements to account for Z-height
    - Calculate initial fitness
    - Automatically run rectangular optimization if fitness < 0.1 or frame is nearly square
    - Update input fields with computed starting positions
    - Updated UI text to explain automatic computation
    - Updated initialization instructions
    Now matches ESP3D-WEBUI behavior: automatically computes better starting pos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
2026-01-30 Set focus to tablet view after Test button click
2026-01-30 Apply focus management to all calibration buttons that don't close modal
2026-01-30 Close calibration popup when Test button clicked
2026-02-03 Fix belt positions not saved during RELEASE_TENSION state transition
2026-02-03 Revert "Fix belt positions not saved during RELEASE_TENSION state transition"
    This reverts commit 93605347ff90656b59229eeff022a96809252c10.
2026-02-04 Add 500ms settling period after RELEASE_TENSION to allow belt momentum to dissipate
2026-02-05 Revert systemStatus to original, add new Maslow action button below Setup
2026-02-06 Move action button to row 3 col 5, hide for non-actionable states, restore trace boundary
2026-02-06 Fix: Use visibility instead of display to prevent button layout shift
2026-02-06 Add 2D visualization to calibration data parser for Phase 1 and Phase 2 searches
2026-02-06 Remove duplicated calibration-computation.js and restore shared file reference
2026-02-06 Add retry logic with randomized starting positions to data parser
    - Add MAX_LOW_FITNESS_RETRIES = 10 constant matching ESP3D-WEBUI
    - Add acceptableCalibrationThreshold = 0.5 constant
    - Wrap optimization in retry loop (up to 10 attempts)
    - Add random perturbation (±50mm) to anchor positions on retry
    - Track best fitness/guess across all retry attempts
    - Display best result when max retries reached
    - Update documentation to reflect new retry behavior
    This makes the data parser behave identically to the machine code for offline testing.
2026-02-06 Fix retry loop to only repeat final optimization, not Phase 1/2
    - Move rectangular optimization (Phase 1/2) BEFORE retry loop (runs once)
    - Only final optimization step repeats with random perturbations
    - Use currentStartingGuess variable for retry iterations
    - Matches ESP3D-WEBUI behavior exactly: findBestRectangularStart runs once,
    then iterate loop retries with perturbed positions
2026-02-09 Move trace boundary button and update visibility behavior
    - Moved button from dynamic_button_1 (row 2) to dynamic_button_3 (row 4, next to Define XY Home)
    - Changed visibility behavior to always show button with disabled styling when no gcode loaded
    - Button uses opacity 0.5 and pointer-events:none when disabled
    - Removed display:none from initial HTML button styling
2026-02-09 Implement aspect ratio-based retry points for calibration
2026-02-09 Replace Calibration terminology with Find Anchor/Find Anchors
2026-02-10 Fix message labels - replace Calibrate with Find Anchors
2026-02-10 Speed up calibration by pulling belts simultaneously after first 6 points
2026-02-10 Fix simultaneous belt pulling logic to match existing pattern
2026-02-10 Increase calibration movement speed by 30%
2026-02-10 Fix GCode file persistence when file is in different directory
    The issue was that when a second browser loaded, the restoration would work initially but then the file would be cleared. This happened because:
    1. populateTabletFileSelector() would check if the loaded file was in the current directory
    2. If not found (because the file was in a different directory), it would clear the file
    3. This caused the "initially loads then reverts to No Gcode loaded" behavior
    - files.js: Only clear loaded file if it's expected to be in the current directory
    - tablet.js: Don't automatically clear state in saveGCodeState() if conditions aren't met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
2026-02-11 Increase movement speed to 50% and reduce pauses for faster calibration
2026-02-12 Add captive portal URL trace documentation to docs directory
2026-02-12 Optimize logging to reduce memory footprint and prevent low memory warnings
2026-02-12 Update CaptivePortalURLTrace.md to match current code implementation
2026-02-14 Prevent stepper disable during pause to maintain belt tension
2026-02-14 Fix Maslow DC motors stopping during pause by including Hold state
2026-02-16 MonolithMaslow 1.0 commit
    First commit for the MonolithMaslow files. The Readme needs a little more detail, but that will be added in a 1.1 update to follow soon.
    [MonolithMaslow-2040CrossbraceBracket-1_0.stl, MonolithMaslow-RodHolder-ProfileClamp-1_0.stl, MonolithMaslow-RodHolder-RodClamp10.10mm-1_0.stl, MonolithMaslow-RodHolder-RodClamp10.25mm-1_0.stl, MonolithMaslow-RodHolder-RodClamp10.50mm-1_0.stl, MonolithMaslow-TowerBracket-Left-1_0.stl, MonolithMaslow-TowerBracket-Right-1_0.stl, TurtleClamp1_1-ClampInserts.stl]
2026-02-16 Fix tooltip case mismatch and improve substring logic
2026-02-16 Add render-time logging to track tooltip HTML generation
2026-02-16 Tested calibration here all good
2026-02-17 Improve calibration failure message
2026-02-22 Fix WiFi disconnect motor runaway: correct watchdog timing and prevent blocking sends
2026-02-22 Fix protocol_do_late_reset to stop arm motors before disabling steppers
2026-02-22 Add distinct double-blink LED pattern when watchdog fires
2026-02-23 Fix home button moving to machine (0,0) instead of stored home position
2026-02-23 Fix canvas aspect ratio distortion causing Y-axis scale to appear 70% larger than X
2026-02-23 Fix camera angle 4 viewport and restore 2:1 canvas aspect ratio
2026-02-24 add scripts to simplify building your own test firmware
    build builds both firmware and UI
    symlinks for firmware.bin and index.html.gz so that you can point
    a browser at the git directlory to upload to the maslow
    update
    fetches what branch you are on, fetches all updates from the
    repo that has Maslow-Main defined
    (This is named 'origin' by default, but can be changed)
    switches branches to get you on the latest version of the branch you were on.
    With these changes, instead of asking the AI to build
    (and waiting, sometimes getting an error),
    you can instead checkout a branch for the PR like
    ```
    git checkout -b origin/copilot/investigate-wifi-disconnect-issue
    ```
    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
2026-02-24 Change unit button color to yellow when in inch mode
2026-02-25 Clamp out-of-bounds home position to work area and fix canvas refresh
2026-02-25 Pre-fill Set Home popup with current machine position (MPOS)
2026-02-25 Change inches button color from harsh yellow to softer #e6c800
2026-02-25 Replace round brackets with pipe symbols around machine position readouts
2026-02-26 Show current home position on Set Home popup
2026-03-01 Fix: Suppress kinematics error spam during belt extend/retract/unknown states
2026-03-02 Fix: Also suppress kinematics error during TAKING_SLACK and RELEASE_TENSION states
2026-03-02 Fix: Reset update watchdog during Find Anchors to prevent emergency stop
    During the Find Anchors calibration sequence, an emergency stop was
    triggered with "Update function not being called enough. 116ms since
    last call". This happened because two operations took longer than the
    100ms UPDATE_WATCHDOG_MS threshold without calling resetUpdateWatchdog():
    1. maslow_start_calibration(): requestStateChange(CALIBRATION_IN_PROGRESS)
    performs significant initialization work (memory allocation, calibration
    grid generation, position computation) that can exceed 100ms.
    2. do_command_or_setting(): The config->validate() + config->group(validator)
    traversal when saving the 8 anchor coordinate s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
2026-03-02 Implement accurate GCode line highlighting via planner block file_line_number
    - Add file_line_number to plan_block_t and plan_line_data_t in Planner.h
    - Copy field in plan_buffer_line() in Planner.cpp
    - Expose _current_line_num static in InputFile for GCode to read
    - Thread file_line_number into pl_data in GCode.cpp
    - Report executing line number from plan_get_current_block() in Report.cpp
2026-03-04 Raise Z axis to Z home + 2mm when stop is pressed
2026-03-04 Fix raiseZ: check work Z coords and reset stepper cleanly
2026-03-06 Always clear planner/stepper in raiseZ() before Z-height check
2026-03-06 Sync belt motor step positions to encoder positions on stop to prevent residual PID motion
2026-03-06 Reset belt PID integral accumulators on stop to prevent I-term residual XY motion
2026-03-08 Add orange indication when Stop button is clicked, revert on action complete
2026-03-08 Fix pause button race condition: process realtime events before auto cycle start
    The pause button was sometimes ignored when a new command was being loaded
    into the buffer. This was a race condition in the main protocol loop where
    protocol_auto_cycle_start() ran before protocol_execute_realtime(), causing
    a queued feedHold event to be overridden by a cycleStart event.
    When state is Idle (between commands) and the user presses Pause:
    1. feedHoldEvent is queued
    2. protocol_auto_cycle_start() sees state=Idle + blocks in planner -> queues cycleStartEvent
    3. protocol_execute_realtime() processes feedHoldEvent (state->Hold, holdComplete=true)
    then cycleStartEvent (state=Hold, holdComplete=true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
2026-03-08 Close TOCTOU race in auto-cycle-start and remove debug Serial.println
    - Add forward declaration for protocol_do_feedhold() so it can be called
    from protocol_do_auto_cycle_start()
    - After protocol_do_initiate_cycle() starts a cycle, immediately re-check
    feedHoldPending and call protocol_do_feedhold() if set. This closes the
    narrow dual-core TOCTOU window where feedHold can arrive between the
    first feedHoldPending.load() and Stepper::wake_up(). Without this fix,
    Maslow.update() could execute one full PID cycle (potentially 0.1+ mm
    at cutting speeds) with state=Cycle before the next event-queue drain
    processes the feedHold event.
    - Remove leftover Serial.println("protocol do feedh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
2026-03-11 Increase maximum frame dimension from 5000mm to 5500mm
2026-03-12 Fix Z raise unit conversion: use inches equivalent of 2mm in imperial mode
2026-03-12 Switch to G21 (mm) mode during Trace Outline, restore original units after
2026-03-14 Fix error 66 by increasing SD max_files from 1 to 4
    The dual-core ESP32-S3 can have Core 0 (polling_loop) serving an HTTP
    file preview while Core 1 (protocol_main_loop) opens the same SD file
    for GCode execution. With max_files=1 the second fopen() fails with
    Error::FsFailedOpenFile (error 66). Increasing max_files to 4 allows
    concurrent file handles and resolves the race condition.
2026-03-14 Fix stop button not working after browser reconnect during GCode execution
    - Add sendStopCommand() helper that sends $STOP directly via WebSocket,
    bypassing HTTP/PAGEID routing. This ensures stop works immediately after
    a browser reconnect, before the CURRENT_ID message arrives to update page_id.
    - Use sendStopCommand() in tabletGCodeStop and tabletCalStop
    - Rebuild firmware/FluidNC/data/index.html.gz and languages/en/index.html.gz
2026-03-15 Explicitly save belt/Z positions to NVS in maslow_stop() before cleanup
2026-03-17 Change gpio.38 to NO_PIN for z-axis motor1 direction_pin
    [maslow.yaml]
2026-03-20 Add troubleshooting sections for belt and calibration
2026-03-23 Disable Run button until Maslow status is Ready to Cut
    Agent-Logs-Url: https://github.com/MaslowCNC/Maslow_4/sessions/4ecc2a18-f7b2-4405-ae82-0a83a2d70326
2026-03-23 Fix: Run button was always visually enabled regardless of Maslow state
    Agent-Logs-Url: https://github.com/MaslowCNC/Maslow_4/sessions/209ecdce-6045-49b7-9c27-2eb2b39f4327
2026-03-23 Document Red LED behavior and causes
    Agent-Logs-Url: https://github.com/MaslowCNC/Maslow_4/sessions/4398b71f-da9e-4f8b-82f2-947d541152d2
2026-03-30 Add Park button for Ready to Cut state (state 7)
    Agent-Logs-Url: https://github.com/MaslowCNC/Maslow_4/sessions/e0b25a6e-b3ad-4656-b99b-9331511a70ca
2026-03-31 Only show Park button when Maslow state 7 and GRBL is Idle
    Agent-Logs-Url: https://github.com/MaslowCNC/Maslow_4/sessions/103d6d10-a008-45d1-85f3-b0e487865654
2026-03-31 Add configurable park position (Z/X/Y) with Z-first movement sequence
    Agent-Logs-Url: https://github.com/MaslowCNC/Maslow_4/sessions/7b8c72fb-b3c5-4344-8d0c-fc06e0bd280f
    [maslow.yaml]
2026-03-31 Merge Maslow-Main: disable Run until ready, setPlayButton canvas fix, grbl.js cleanup, revert max_files=1
    Agent-Logs-Url: https://github.com/MaslowCNC/Maslow_4/sessions/1b9a21ad-398e-497c-b6b3-7d31e36f4486
2026-04-01 Fix Red LED lighting during firmware/file uploads by resetting watchdog timer
    Agent-Logs-Url: https://github.com/MaslowCNC/Maslow_4/sessions/d2c072b4-873a-4868-b4e2-81f990989a85
2026-04-03 Add Work Area button and popup to setup menu
    Agent-Logs-Url: https://github.com/MaslowCNC/Maslow_4/sessions/7f9e0555-8b8b-4ec5-9983-c1c2d64b30c7
2026-04-03 Make Work Area button same size as existing buttons
    Agent-Logs-Url: https://github.com/MaslowCNC/Maslow_4/sessions/f96084ce-f929-428e-b75d-74fd15ef6113
2026-04-04 Update Troubleshooting.md with frame calculator links
    Added external resources for frame calculations and simulations.
2026-04-04 Add tooltip to Work Area button in Setup popup
    Agent-Logs-Url: https://github.com/MaslowCNC/Maslow_4/sessions/dd01f1c7-2e95-43c4-ba0d-d2dddcdb047f
2026-04-06 feat: implement Levenberg-Marquardt calibration algorithm with bundle adjustment
    Agent-Logs-Url: https://github.com/MaslowCNC/Maslow_4/sessions/51c55e6e-3ec2-4495-b024-519888751e73
2026-04-07 feat: use LevenbergMarquardt as default calibration algorithm in findMaxFitness
    Agent-Logs-Url: https://github.com/MaslowCNC/Maslow_4/sessions/8508245c-d476-42db-b6da-679ebf8b700b
2026-04-08 Fix red LED alarm triggered spuriously during firmware/file uploads
    During OTA firmware updates and LittleFS file uploads (e.g. index.html.gz),
    flash write operations stall both ESP32-S3 CPU cores. Core 1, which runs the
    Maslow update loop (PID/motion control), can be stalled for more than the
    100 ms UPDATE_WATCHDOG_MS threshold. This causes the software watchdog to fire,
    which sets watchdogFired=true and State::Alarm. Since watchdogFired is only
    cleared by a power cycle (RAM reset), the red LED stays on until power is
    cycled.
    Fix: add a volatile bool uploadInProgress flag to Maslow_. Web-server upload
    handlers set it true at upload start and false at upload end/failure/abort.
    The watchdog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
2026-04-08 Replace 'calibration' with 'Find Anchors' in all operator-facing log messages
    Agent-Logs-Url: https://github.com/MaslowCNC/Maslow_4/sessions/457c7f17-caee-4f26-a663-9d67888e31a5
2026-04-08 Add Park button and popup to Setup menu
    Agent-Logs-Url: https://github.com/MaslowCNC/Maslow_4/sessions/d167c910-e27d-4d88-b1af-a87e4a122c95
2026-04-09 Close Work Area and Park popups with 1s delay like Apply Tension
    Agent-Logs-Url: https://github.com/MaslowCNC/Maslow_4/sessions/b369b280-6404-4e34-83a0-a1bef9f17e71
2026-04-10 Fix 100% CPU in disconnect dialog: stop processNextCmd busy-loop, fix cmd_lock reentrancy, add auto-reconnect timer"
    Agent-Logs-Url: https://github.com/MaslowCNC/Maslow_4/sessions/e12dae2a-8c24-469e-9363-8305d7887325
2026-04-12 Rename Work Area/Park buttons and apply green background color
    Agent-Logs-Url: https://github.com/MaslowCNC/Maslow_4/sessions/0ec67912-d36b-4c15-880b-221924eaf330
2026-04-12 Add Set Scale and Thickness button and popup to Setup menu
    Agent-Logs-Url: https://github.com/MaslowCNC/Maslow_4/sessions/7785e23a-c02a-4eb5-af74-bc17e53b3577
2026-04-20 Add Z home value safety check: warn when WCO Z > 72mm before movement
    When the Z home value (WCO[2]) exceeds 72mm - which can happen after an
    alarm or power reset - a confirmation popup is shown before any movement
    (X, Y, or Z jog/move) is allowed.
    The user may still proceed with movement for maintenance purposes (e.g.
    to release Z-axis screws). Once confirmed, subsequent movements in the
    same session do not re-prompt unless:
    - The Z home value increases beyond the previously acknowledged value, or
    - The Z home value returns to the safe range and then rises above it again
    Agent-Logs-Url: https://github.com/MaslowCNC/Maslow_4/sessions/b8018be2-f255-4ab3-b15b-57d3dda6259e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
2026-04-21 Refine Z safety check: use MPOS-based delta, fix null handling, unify Z- into map
    - checkZHomeAndProceed(callback, zDeltaMm) now checks if MPOS[2]+zDeltaMm>72,
    so the popup only fires when a move would actually raise machine Z above the limit
    - Negative zDeltaMm (lowering Z) bypasses the check immediately - always safe
    - Null MPOS (position data unavailable) bypasses check and proceeds
    - Renamed wouldExceed -> zIsRising for clarity
    - Z- added to jogMoveFnList with -toMmDist(distance) delta, removing special case
    - machineZ/workZeroZ in sendMove are null-checked; deltas default to 0 (safe)
    when position data is unavailable
    Agent-Logs-Url: https://github.com/MaslowCNC/Maslow_4/sessions/86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
2026-04-22 Fire Z safety popup on startup if MPOS[2] > 72 when position data arrives
    On the first status update that includes both WCO and MPOS (indicating full
    position data from firmware), proactively call checkZHomeAndProceed(() => {}, 0)
    in tabletGrblState. This fires the warning popup immediately on startup if
    machine Z is already above 72mm, before the user presses any movement button.
    - startupZCheckDone flag prevents re-firing on every status update
    - Flag is reset in onWSOpenCallback so the check re-runs after any reconnect
    or firmware restart
    Agent-Logs-Url: https://github.com/MaslowCNC/Maslow_4/sessions/13fb4ebb-7912-49e4-ac7d-1256282577de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
2026-04-22 Add Zhome < Zm additional trigger to Z safety popup
    Adds a second independent trigger condition to checkZHomeAndProceed:
    - Existing: resultingMachineZ > 72mm (absolute machine-coordinate check)
    - New: resultingWorkZ (machineZ - WCO[2]) > 72mm (Zhome < Zm check)
    The work-Z check fires when the resulting Z position is more than 72mm above
    the defined Z home position (WCO[2]), catching scenarios where an unusual
    work-coordinate offset makes Z high relative to home even if machine Z appears
    acceptable. The popup message now includes "Xmm above Z home" when WCO data
    is available.
    Agent-Logs-Url: https://github.com/MaslowCNC/Maslow_4/sessions/cfb0a45d-48c5-4e1a-aab1-2c2f39232aa6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
2026-04-22 Tighten Zhome < Zm check: fire popup whenever Zm > Zhome (not just > 72mm above)
    The work-Z safety check now fires whenever resultingMachineZ > WCO[2]
    (i.e., machine Z would exceed the defined Z home position), rather than
    only when it exceeds Z_HOME_MAX_SAFE_MM above Z home.
    This implements the invariant: Z home must always be >= Zm. Any movement
    that would take machine Z above the Z home position triggers the warning.
    Agent-Logs-Url: https://github.com/MaslowCNC/Maslow_4/sessions/2d222637-1203-4878-815e-37c335c9f8d4
2026-04-22 Add low-Z safety check: popup fires if lowering Z would go below machine minimum (0mm)
    Previously Z- jogs always bypassed all checks. Now:
    - Z_HOME_MIN_SAFE_MM = 0 constant added
    - zLowWarningAcknowledged / zLowLastAcknowledgedResultZ tracking vars added
    - checkZHomeAndProceed checks resultingZMm < 0 for negative deltas too
    - Low-Z popup shows "Low Z Position" warning with re-prompt if Z drops even lower
    - onWSOpenCallback also resets low-Z acknowledgment state on reconnect
    Agent-Logs-Url: https://github.com/MaslowCNC/Maslow_4/sessions/54d56799-db4e-4fc2-a450-284c0eb5e567
2026-04-22 Fix Z-warning popup dismissed by unchecked closeModal calls in initUI_4 and socket.js
    Agent-Logs-Url: https://github.com/MaslowCNC/Maslow_4/sessions/b2815465-7642-40d7-9a04-5e2b551d1adf
2026-04-28 Add Optional Settings popup and move Set buttons there from Setup popup
    Agent-Logs-Url: https://github.com/MaslowCNC/Maslow_4/sessions/89a25e80-a088-4a2d-bc0d-95af172c07a9
2026-04-28 Add Options button to main UI (right of Right Arrow) opening Optional Settings popup
    Agent-Logs-Url: https://github.com/MaslowCNC/Maslow_4/sessions/ff3bc101-1e2c-4594-8a72-d30fd23dc0d4
2026-04-28 Match Options button font style to existing Setup button (1vw, flex-column)
    Agent-Logs-Url: https://github.com/MaslowCNC/Maslow_4/sessions/bfb11d2d-51bc-4c0f-a6e1-63cd3bef3adf
2026-05-02 Remove Optional Settings button from Setup Menu, retain on Main UI
    Agent-Logs-Url: https://github.com/MaslowCNC/Maslow_4/sessions/2dfbac93-97fc-479f-9263-e3dcc1793381
2026-05-11 Move find-anchors LM computation onto ESP32 firmware
    Agent-Logs-Url: https://github.com/MaslowCNC/Maslow_4/sessions/9dc5a047-e56a-4929-8169-e5e2c0626336
2026-05-11 Feed update watchdog during firmware calibration recompute loop
    Agent-Logs-Url: https://github.com/MaslowCNC/Maslow_4/sessions/7311f5e1-f6e2-4c0d-b528-b7a95f6e2e49
2026-05-11 Service ESP task watchdog during LM calibration recompute
    Agent-Logs-Url: https://github.com/MaslowCNC/Maslow_4/sessions/7de4ac49-08e3-4a00-a170-fc157434abef
2026-05-11 Service calibration watchdogs during movement and measurement loops
    Agent-Logs-Url: https://github.com/MaslowCNC/Maslow_4/sessions/bb175696-618f-4848-a2aa-ecb81109d623
2026-05-11 Explicitly mark non-yield watchdog service in calibration loop calls
    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
2026-05-11 Handle LM allocation exceptions to avoid ESP32 reboot
    Agent-Logs-Url: https://github.com/MaslowCNC/Maslow_4/sessions/36f1fb46-005c-4689-bcbe-786bc51c8d7a
2026-05-12 Add CalibrationFitness struct and fitness gates to LM anchor solver
    Agent-Logs-Url: https://github.com/MaslowCNC/Maslow_4/sessions/0ff1cb19-15b3-4159-b54f-1e45de17d432
2026-05-13 fix: remove anchor jump limit gate from Find Anchors LM solver
    Anchor position changes between recomputes are a normal part of
    accumulating new measurement data; the 50mm threshold was triggering
    spurious failures. Remove Gate 6 (the between-recompute anchor jump
    check) and its associated FITNESS_ANCHOR_JUMP_MM constant entirely.
    Agent-Logs-Url: https://github.com/MaslowCNC/Maslow_4/sessions/339f13e8-7aa9-4470-8be7-88b63afe72c3
2026-05-13 fix: arm WebSocket ping watchdog unconditionally on every connect
    Previously handlePing() was only called inside ws_source.onopen when
    the "UI disabled" reconnect dialog was already visible, meaning the
    20-second watchdog was never started on the initial page load.
    Move handlePing() outside the modal guard so it fires on every
    (re)connect. This ensures that if no PING arrives within 20 seconds
    (e.g. because iOS silently dropped the TCP connection), check_ping()
    fires → Disable_interface() → reconnect dialog and auto-retry timer
    are triggered automatically.
    Agent-Logs-Url: https://github.com/MaslowCNC/Maslow_4/sessions/85e7d6ce-7775-4697-8031-77507898fb64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
2026-05-13 Relax apply tension restrictions
    Agent-Logs-Url: https://github.com/MaslowCNC/Maslow_4/sessions/7b5f0057-7a07-45c2-9867-4be773cb3972
2026-05-13 Address apply tension validation feedback
    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
2026-05-13 fix: relax calibration guard rails and fix stale state on re-run
    - Increase LM_MAX_REJECTIONS from 10 to 20 so the solver gets more
    attempts before declaring non-convergence (user saw rejections=11
    against a limit of 10)
    - Increase FITNESS_ANCHOR_IMBALANCE_RATIO from 2.0 to 3.0 so minor
    per-anchor RMS variation doesn't abort an otherwise good calibration
    (user saw ratio≈2.1 fail against limit of 2.0 with sub-mm absolute
    values)
    - Reset waypoint, recomputeCountIndex, previousFitnessRms, and
    lastRecomputePassed when CALIBRATION_IN_PROGRESS is entered from
    EXTENDEDOUT, ensuring a re-run after failure always starts fresh from
    waypoint 0 rather than resuming mid-run
    - Improve er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
2026-05-13 Tighten apply tension warning filter
    Agent-Logs-Url: https://github.com/MaslowCNC/Maslow_4/sessions/5ae78575-d90b-4324-9d76-5c0d8c010007
2026-05-13 Remove Gate 5 fitness degradation ratio check from calibration
    Agent-Logs-Url: https://github.com/MaslowCNC/Maslow_4/sessions/f659d7a8-71be-4492-9135-b7a2ee3c1cb6
2026-05-14 fix: lower invalid zPos threshold to -73mm
    Agent-Logs-Url: https://github.com/MaslowCNC/Maslow_4/sessions/2141586e-d664-4010-9fab-df9e3302ba46
2026-05-14 feat: add Check for Updates dialog with update stream support
    - Add update_stream preference (release/experimental/nightly) to prefDefs.js
    - Add update stream dropdown to preferencesdlg.html and wire it in preferencesdlg.js
    - New checkupdatesdlg.html modal: shows current/latest version, release notes, Install button
    - New checkupdatesdlg.js: fetches GitHub Releases API, filters by stream, downloads and
    uploads firmware.bin + index.html.gz to ESP32 via existing OTA endpoint
    - Add Check for Updates (green) button to settingstab.html; keep Upload Firmware (yellow) button
    - Register new dialog in index.html
    Agent-Logs-Url: https://github.com/MaslowCNC/Maslow_4/sessions/b42440c7-85e8-4580-8284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
2026-05-14 fix: stage both files to filesystem before flashing firmware
    Agent-Logs-Url: https://github.com/MaslowCNC/Maslow_4/sessions/f65b7152-02db-45b1-abf0-cbcc28b46c68
2026-05-14 fix: align stream filtering with PR #975 tag convention (nightly tag vs v*-exp* tags)
    Agent-Logs-Url: https://github.com/MaslowCNC/Maslow_4/sessions/58632287-bb9a-4100-8411-b0ebac73ae39
2026-05-18 feat: draw find anchors trace from waypoint position steps
    Agent-Logs-Url: https://github.com/MaslowCNC/Maslow_4/sessions/c01f79e5-1f20-4bc5-8803-d25ed649289e
2026-05-18 fix: reset gcode view on find anchors start and persist trace until file load
    Agent-Logs-Url: https://github.com/MaslowCNC/Maslow_4/sessions/5f44a7de-7d69-4c6d-b68e-4dd1b3a28412
2026-05-18 fix: keep find anchors trace through load status text
    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
2026-05-20 feat: show 2D overhead rectangle view when Find Anchors starts
    - Change setGcodeViewerPage(0) to setGcodeViewerPage(4) to use
    cameraAngle=3 (top-down view with machine bounds rectangle)
    - Move setGcodeViewerPage call before showGCode("") so angle is
    set before the canvas clear
    - Add refreshGcode() call after showGCode("") to immediately render
    the 2D overhead view showing the work area rectangle
    Agent-Logs-Url: https://github.com/MaslowCNC/Maslow_4/sessions/e88c0d98-f71c-48f1-a988-fa544a54c477
2026-05-21 fix: add power cycle note to startup z warnings
    Agent-Logs-Url: https://github.com/MaslowCNC/Maslow_4/sessions/bdf147bd-7e19-4a41-bd8c-8205dd005ee1
2026-05-22 feat(calibration): emit CLBM measurement array during find anchors
2026-05-22 fix(calibration): format CLBM output without trailing comma
2026-05-23 Add Define Z Home popup consistent with Define XY Home
    - Add set-z-home-popup modal to tablettab.html with current Z label,
    Z input (range 0-72 mm), Cancel and Set Z Home buttons
    - Add openSetZHomePopup() and confirmSetZHome() to tablet.js
    - Replace mousedown/mouseup handlers on tablettab_set_z_home with a
    single click listener that opens the new popup
2026-05-23 Pre-fill Z Home popup with current WCO[2] instead of MPOS[2]
    The input now shows the previously defined Z home value (WCO[2])
    so Cancel leaves Z home unchanged. The context label shows the
    current machine Z position (MPOS[2]) for reference.
2026-05-23 Update Z Home popup: swap input/label, add Z Home move button
    - Input pre-fills with MPOS[2] (current machine Z position)
    - Context label shows WCO[2] (previously defined Z home value)
    - Add "Z Home" button that moves machine to work Z=0 via G90 G0 Z0,
    with proper Z delta passed to checkZHomeAndProceed for safety checks
2026-05-23 Reorder Set Z Home / Z Home buttons and add green styling to Z Home
2026-05-27 Expose belt tooth spacing and encoder teeth settings
    [maslow.yaml]
2026-05-27 Add diagnostics and polish for encoder geometry config
    [maslow.yaml]
2026-05-27 Update encoder geometry defaults to 1.9988 and 22
    [maslow.yaml]
2026-05-31 Add apply tension retraction safety pause and continue/cancel prompt
2026-06-01 Add configurable apply tension belt retraction limits
    [maslow.yaml]
2026-06-02 Add read-only Apply Tension Belt Limit guidance text
2026-06-02 Rollback read-only Apply Tension guidance text
2026-06-02 Update apply tension labels and tooltips
2026-06-02 Update Apply Tension belt limit tooltip wording
2026-06-02 Set Allow Limiting default to On
    [maslow.yaml]
2026-06-04 Update apply tension popup fields and warning guidance
2026-06-04 Clarify apply tension warning guidance wording
2026-06-04 Update apply tension warning and Extend Dist tooltip text
2026-06-04 Update apply tension warning with release tension guidance
2026-06-08 Print Maslow_Retract_Current_Threshold to serial on startup
2026-06-18 Update Z Home button label to "Go to Z Home"
2026-06-23 Allow printable SSID characters
2026-06-23 fix: tighten release workflow validation
2026-07-04 Fix: Reset Z home to Zm on startup when out of range
    When loadZPos() detects that Z home (the work coordinate offset) is
    outside the valid range [0, 72mm], actually perform the reset instead
    of only logging a warning.
    After setting the machine position and syncing, execute G92.1 to clear
    any transient G92 offset, then G10 L20 P0 Z0 to set the work
    coordinate system so work Z=0 at the current machine position (Zm).
    This makes Z home = Zm, satisfying the requirement that Z home is
    always 0-72 inclusive on startup.
    Closes #1026
2026-07-22 Add wheel jog support to Z home popup
2026-07-22 Refine Z home popup wheel handling
2026-07-22 Polish Z home wheel popup logic
2026-07-23 Adjust Z home wheel jog step
2026-07-23 Refine Z home wheel jog distance handling
2026-07-23 Polish Z home wheel jog conversions
2026-07-23 Tidy Z home wheel jog helpers
2026-07-23 Default popup Z wheel step
2026-07-23 Replace z home popup wheel jog with buttons
2026-07-23 Polish z home popup jog buttons
2026-07-23 Clean up popup z jog button wiring
2026-07-23 Adjust popup z jog button grid
2026-07-23 Clarify popup z jog button labels
2026-07-23 fix: rename popup set z home button
2026-07-23 fix: show current z on define z home
2026-08-06 Fix calibration buttons silently dropped when PAGEID stale after WS reconnect
2026-08-17 fix: switch to mm mode (G21) before park move commands when in inches mode
    When in G20 (inches) mode and Park is clicked, the park position values
    (stored in mm in the YAML config) were sent to the G-code interpreter
    without unit conversion, causing them to be treated as inches and
    resulting in amplified movements.
    Fix switches to G21 (mm) before sending park move commands and restores
    G20 afterwards if it was previously active, consistent with how the
    firmware's raiseZ() handles units in the Stop function.
2026-08-18 feat: incorporate PR #1063 - reduce index.html.gz size by removing unused calibration JS code
    - Remove calibration-computation.js (dead code, math now runs in firmware)
    - Slim down calculatesCalibrationStuff.js to just the anchor position store
    - Remove calibration-computation.js script tag from index.html
    - Fix gulpfile to exclude tests/** from app bundle
    - Move firmware-lm.selftest.js to docs/calibration-simulation/
2026-08-26 Move the Layout Simulator into the docs
    The anchor point Layout Simulator lived in its own repository at
    MaslowCNC/Layout-Simulator and was published at
    maslowcnc.github.io/Layout-Simulator. Three pages in these docs linked
    out to it. Moving it here puts it alongside the calibration simulator
    and the manual anchor locator so it is versioned and edited with the
    rest of the documentation.
    - Add docs/layout-simulator/ with index.html (from Layout-Simulator
    main), the GPL-3.0 LICENSE it carried, and a README covering the four
    criteria the tool color codes on: belt angle, arm contact, belt
    tension, and belt length.
    - Add a back-link to the documentation in the tool's controls panel,
    matc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
